HeejunMoon53/MultimodalSensor/Paper/figures/seminar_testplatform.png

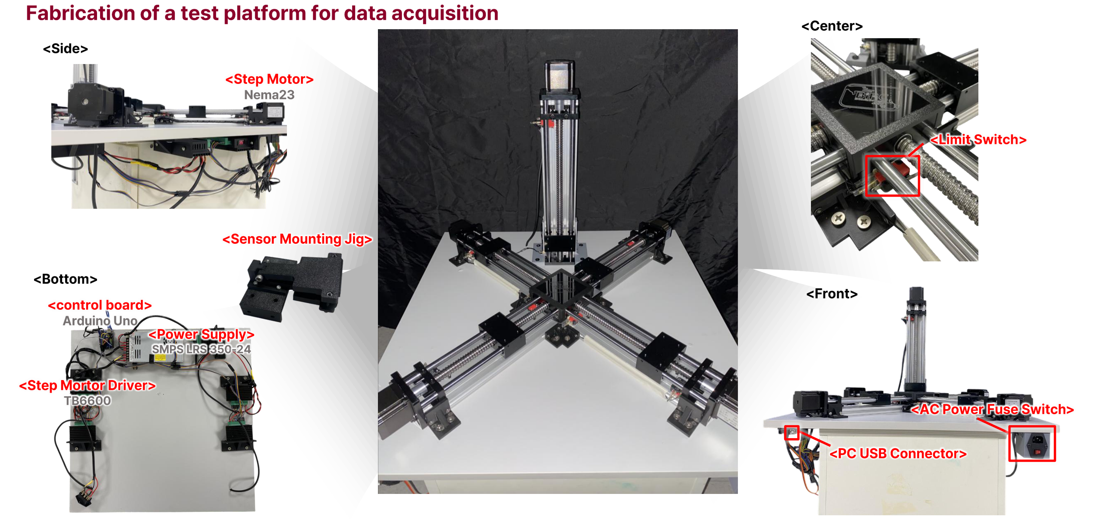
Paper/figures/seminar_testplatform.png
