HeejunMoon53/MultimodalSensor/Paper/figures/seminar_pcb.png

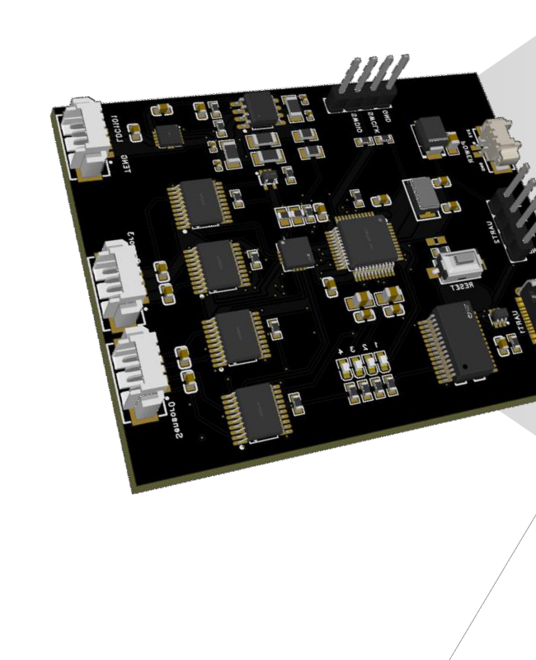
Paper/figures/seminar_pcb.png
