HeejunMoon53/MultimodalSensor/nn_decoupling/data_acquisition/dataset/training_report.html

# Training Report — Linear / Log-d / PINN / E2E

Generated: 2026-05-22 18:41 | Architecture: MLP (128-128-64) | 2-Stage Decoupled + End-to-End

## 종합 요약 (Test set MAE)

1.783 mm

Proximity MAE — Linear

1.751 mm

Proximity MAE — Log-d

1.787 mm

Proximity MAE — PINN

1.790 mm

Proximity MAE — E2E (2in→2out)

0.343 %

Strain MAE — Linear

0.343 %

Strain MAE — Log-d

0.347 %

Strain MAE — PINN

0.334 %

Strain MAE — E2E (2in→2out)

## Part 1 — Linear vs Log-scale d (sklearn MLP)

Linear: Stage 2 타겟 = d_act_mm. StandardScaler 정규화.

Log-d: Stage 2 타겟 = log1p(d_act_mm). 추론 시 expm1() 역변환. L-d 결합이 물리적으로 1/d^k 형태이므로 log 공간에서 더 선형에 가깝고, 가까운 거리(0-10mm)에 더 높은 표현력을 부여.

## 1-1. 구조 비교

항목 | Linear | Log-d
Stage 2 타겟 | d_act_mm | log1p(d_act_mm)
역변환 | inverse_transform | inverse_transform + expm1
Stage 1 | 동일 (dR -> eps)
Stage 1 iters | 85 | 85
Stage 2 iters | 151 | 101

## 1-2. Loss Curves

loss_lg

## 1-3. 성능 비교

빨간 = log-d가 더 나쁨 / 초록 = 더 좋음. 괄호 = linear 대비 차이.

### Test set

지표 | linear | log-d (차이) | 우세
Strain MAE [%] | 0.3435 | 0.3435 (0.0000) | -
Strain RMSE [%] | 0.4319 | 0.4319 (0.0000) | -
Strain R2 | 0.9974 | 0.9974 (0.0000) | -
Proximity MAE [mm] | 1.7830 | 1.7511 (-0.0319) | log-d
Proximity RMSE [mm] | 2.7715 | 2.7824 (+0.0109) | linear
Proximity R2 | 0.9298 | 0.9292 (-0.0006) | linear
Proximity MaxErr [mm] | 13.4586 | 13.8294 (+0.3708) | linear

### Val set

지표 | linear | log-d (차이) | 우세
Strain MAE [%] | 0.3363 | 0.3363 (0.0000) | -
Strain RMSE [%] | 0.4230 | 0.4230 (0.0000) | -
Strain R2 | 0.9976 | 0.9976 (0.0000) | -
Proximity MAE [mm] | 1.7800 | 1.7618 (-0.0182) | log-d
Proximity RMSE [mm] | 2.7770 | 2.8043 (+0.0273) | linear
Proximity R2 | 0.9297 | 0.9284 (-0.0014) | linear
Proximity MaxErr [mm] | 19.5442 | 20.3745 (+0.8302) | linear

### Train set

지표 | linear | log-d (차이) | 우세
Strain MAE [%] | 0.3373 | 0.3373 (0.0000) | -
Strain RMSE [%] | 0.4253 | 0.4253 (0.0000) | -
Strain R2 | 0.9976 | 0.9976 (0.0000) | -
Proximity MAE [mm] | 1.7805 | 1.7601 (-0.0205) | log-d
Proximity RMSE [mm] | 2.7975 | 2.8219 (+0.0244) | linear
Proximity R2 | 0.9287 | 0.9275 (-0.0013) | linear
Proximity MaxErr [mm] | 21.6852 | 21.6616 (-0.0236) | log-d

## 1-4. Proximity Pred vs True

pred_d_lg

## 1-5. 거리 구간별 MAE 비교

6mm 간격 bin 기준. 먼 거리(24-36mm)에서 log-d 효과 확인.

bar_lg

## 1-6. Proximity Residuals

점 색상 = 실제 거리. 먼 거리(빨간 점)의 잔차 패턴 비교.

resid_lg

## 1-7. eps x d 공간 MAE 히트맵

같은 행은 동일 컬러 스케일.

heatmap_lg

## Part 2 — MLP vs PINN (Physics-Informed)

MLP (Linear, Baseline): sklearn MLPRegressor. Data loss(MSE)만으로 학습.

PINN: NumPy + Adam 직접 구현. Data loss + Physics loss 동시 최적화.
Loss = MSE_data + 0.1 * MSE_physics

## 2-1. 물리 제약 (Physics Constraints)

Stage | 물리 모델 | 역할
Stage 1 dR → eps | dR = α₁⋅eps + α₂⋅eps² | 예측된 eps가 저항 변화 물리 모델과 일치하도록 강제
Stage 2 (dL, eps_hat) → d | dL = β₁⋅eps + β₂⋅exp(-k⋅d) | 예측된 d가 인덕턴스-근접도 물리 모델과 일치하도록 강제 (지수 감쇠: gradient bounded, 수치적으로 안정)

## 2-2. 물리 모델 피팅 결과

α₁ (R linear)

0.5676

α₂ (R quadratic)

0.002113

R model R²

0.9974

β₁ (L-eps)

0.6504

β₂ (L-d amplitude)

-27.2386

k (decay rate)

0.2287 mm⁻¹

L model R²

0.9930

PINN lambda

0.1

Stage 1/2 iters (PINN)

138 / 244

phys_fit

## 2-3. Loss Curves

loss_mp

## 2-4. 성능 비교

빨간 = PINN이 더 나쁨 / 초록 = PINN이 더 좋음. 괄호 = MLP 대비 차이.

### Test set

지표 | MLP | PINN (차이) | 우세
Strain MAE [%] | 0.3435 | 0.3470 (+0.0036) | MLP
Strain RMSE [%] | 0.4319 | 0.4341 (+0.0022) | MLP
Strain R2 | 0.9974 | 0.9974 (-0.0000) | -
Proximity MAE [mm] | 1.7830 | 1.7865 (+0.0035) | MLP
Proximity RMSE [mm] | 2.7715 | 2.7662 (-0.0054) | PINN
Proximity R2 | 0.9298 | 0.9301 (+0.0003) | PINN
Proximity MaxErr [mm] | 13.4586 | 14.0361 (+0.5775) | MLP

### Val set

지표 | MLP | PINN (차이) | 우세
Strain MAE [%] | 0.3363 | 0.3406 (+0.0043) | MLP
Strain RMSE [%] | 0.4230 | 0.4262 (+0.0033) | MLP
Strain R2 | 0.9976 | 0.9976 (-0.0000) | -
Proximity MAE [mm] | 1.7800 | 1.7819 (+0.0019) | MLP
Proximity RMSE [mm] | 2.7770 | 2.7670 (-0.0099) | PINN
Proximity R2 | 0.9297 | 0.9302 (+0.0005) | PINN
Proximity MaxErr [mm] | 19.5442 | 19.8687 (+0.3244) | MLP

### Train set

지표 | MLP | PINN (차이) | 우세
Strain MAE [%] | 0.3373 | 0.3406 (+0.0033) | MLP
Strain RMSE [%] | 0.4253 | 0.4274 (+0.0021) | MLP
Strain R2 | 0.9976 | 0.9975 (-0.0000) | -
Proximity MAE [mm] | 1.7805 | 1.7802 (-0.0003) | PINN
Proximity RMSE [mm] | 2.7975 | 2.7867 (-0.0107) | PINN
Proximity R2 | 0.9287 | 0.9293 (+0.0005) | PINN
Proximity MaxErr [mm] | 21.6852 | 21.7007 (+0.0155) | MLP

## 2-5. Pred vs True

pred_mp

## 2-6. 거리 구간별 MAE 비교

6mm bin 기준. 먼 거리(24-36mm)에서 PINN 물리 제약 효과 확인.

bar_mp

## 2-7. Proximity Residuals

resid_mp

## 2-8. eps x d 공간 MAE 히트맵

같은 행은 동일 컬러 스케일. 물리 제약이 어느 구간에서 효과적인지 확인.

heatmap_mp

## Part 3 — 2-Stage MLP vs End-to-End (2in→2out, Stage1 only)

2-Stage MLP (Baseline): Stage1: dR→eps (1in→1out), Stage2: (dL, eps_hat)→d (2in→1out).
물리적 인과관계(dR은 eps에만 지배적)를 반영한 직렬 디커플링 구조.

End-to-End (2in→2out): 단일 MLP로 (dL, dR) → (eps, d) 동시 예측.
Stage2 없이 Stage1만으로 두 출력 동시 학습. 구조 단순, 물리 계층 없음.

## 3-1. 구조 비교

항목 | 2-Stage MLP | End-to-End (2in→2out)
입력 | Stage1: [dR] / Stage2: [dL, eps_hat] | [dL, dR]
출력 | Stage1: eps / Stage2: d (순차) | (eps, d) 동시 출력
모델 수 | 2개 (직렬) | 1개
물리 계층 | 있음 (dR→eps 우선) | 없음 (end-to-end)
학습 iters | 85 / 151 | 73

## 3-2. 성능 비교

빨간 = E2E가 더 나쁨 / 초록 = E2E가 더 좋음. 괄호 = 2-Stage 대비 차이.

### Test set

지표 | 2-Stage | E2E (차이) | 우세
Strain MAE [%] | 0.3435 | 0.3340 (-0.0095) | E2E
Strain RMSE [%] | 0.4319 | 0.4240 (-0.0079) | E2E
Strain R2 | 0.9974 | 0.9975 (+0.0001) | -
Proximity MAE [mm] | 1.7830 | 1.7900 (+0.0070) | 2-Stage
Proximity RMSE [mm] | 2.7715 | 2.7938 (+0.0222) | 2-Stage
Proximity R2 | 0.9298 | 0.9287 (-0.0011) | 2-Stage
Proximity MaxErr [mm] | 13.4586 | 13.6385 (+0.1799) | 2-Stage

### Val set

지표 | 2-Stage | E2E (차이) | 우세
Strain MAE [%] | 0.3363 | 0.3261 (-0.0102) | E2E
Strain RMSE [%] | 0.4230 | 0.4137 (-0.0093) | E2E
Strain R2 | 0.9976 | 0.9977 (+0.0001) | E2E
Proximity MAE [mm] | 1.7800 | 1.7794 (-0.0006) | E2E
Proximity RMSE [mm] | 2.7770 | 2.7856 (+0.0086) | 2-Stage
Proximity R2 | 0.9297 | 0.9293 (-0.0004) | 2-Stage
Proximity MaxErr [mm] | 19.5442 | 19.0618 (-0.4824) | E2E

### Train set

지표 | 2-Stage | E2E (차이) | 우세
Strain MAE [%] | 0.3373 | 0.3253 (-0.0120) | E2E
Strain RMSE [%] | 0.4253 | 0.4144 (-0.0109) | E2E
Strain R2 | 0.9976 | 0.9977 (+0.0001) | E2E
Proximity MAE [mm] | 1.7805 | 1.7847 (+0.0041) | 2-Stage
Proximity RMSE [mm] | 2.7975 | 2.8127 (+0.0153) | 2-Stage
Proximity R2 | 0.9287 | 0.9279 (-0.0008) | 2-Stage
Proximity MaxErr [mm] | 21.6852 | 21.7474 (+0.0622) | 2-Stage

## 3-3. Pred vs True

pred_e2e

## 3-4. 거리 구간별 MAE

6mm bin 기준. 디커플링 구조 유무에 따른 근접도 구간별 오차 차이 확인.

bar_e2e

## 3-5. eps × d 공간 MAE 히트맵

같은 행은 동일 컬러 스케일. 2-Stage와 E2E의 오차 분포 패턴 비교.

heatmap_e2e
