HeejunMoon53/MultimodalSensor/Paper/26.09.18_세미나_아웃라인.pdf

HeeJun Moon

# Embedded AI-Driven Single-Electrode Soft Multimodal Sensor for Proprioception, Tactile, and Proximity Sensing

구조

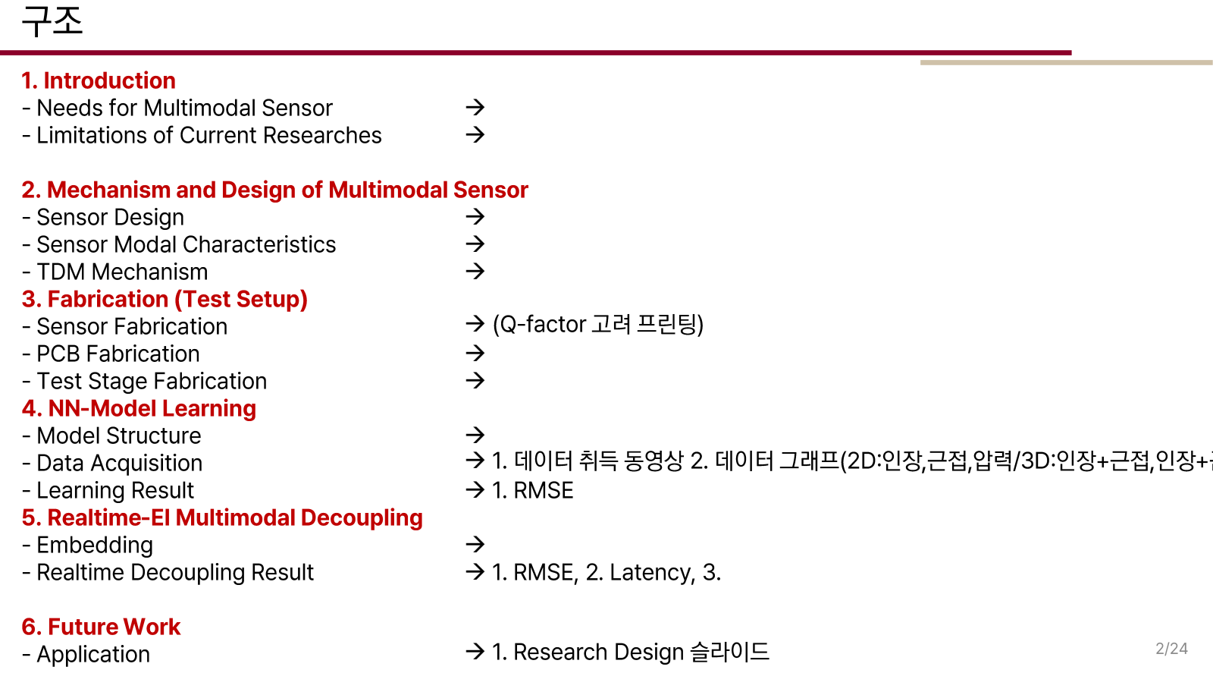
[picture p15: page 2]

2/24

1. Introduction
-Needs for Multimodal Sensor
-Limitations of Current Researches
2. Mechanism and Design of Multimodal Sensor -Sensor Design
-Sensor Modal Characteristics
-TDM Mechanism
3. Fabrication (Test Setup) -Sensor Fabrication
-PCB Fabrication
-Test Stage Fabrication
4. NN-Model Learning
-Model Structure
-Data Acquisition
-Learning Result
5. Realtime-EI Multimodal Decoupling -Embedding
-Realtime Decoupling Result
6. Future Work
-Application

→
→

→
→
→

→ (Q-factor 고려프린팅)

→
→

→
→ 1. 데이터취득동영상2. 데이터그래프(2D:인장,근접,압력/3D:인장+근접,인장+근접+압력) → 1. RMSE

→
→ 1. RMSE, 2. Latency, 3.

→ 1. Research Design 슬라이드

구조

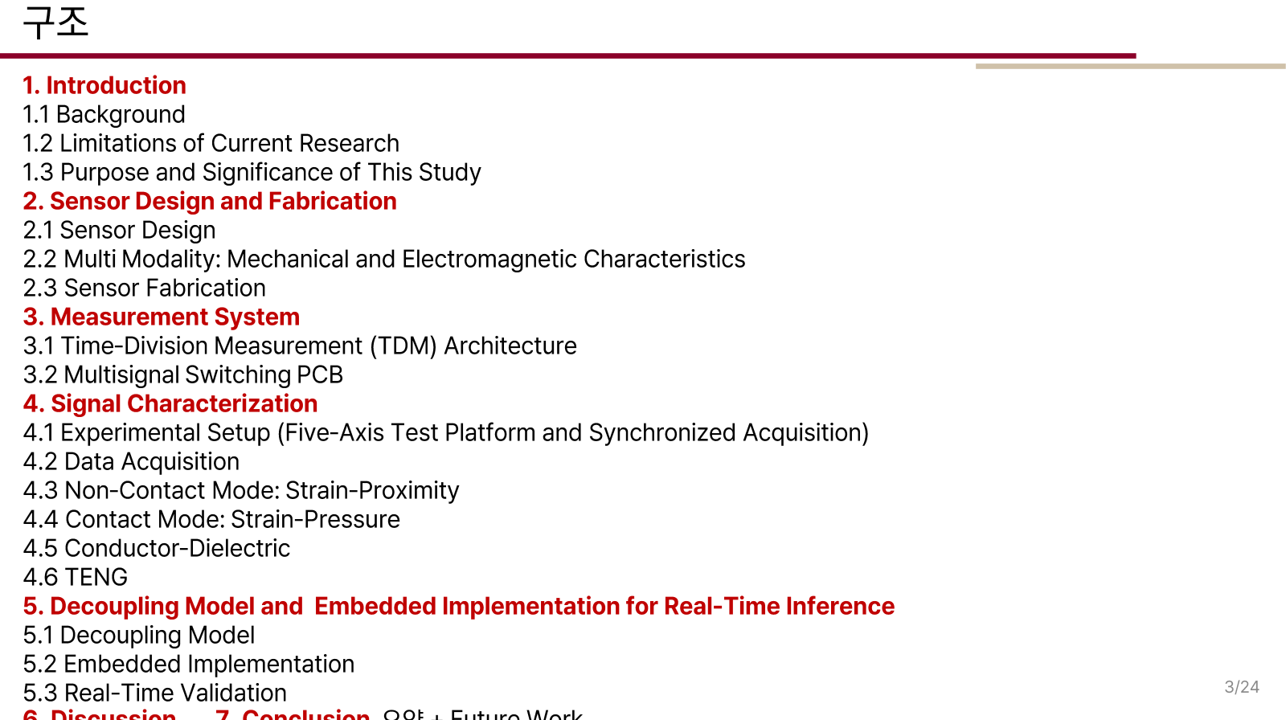
[picture p16: page 3]

3/24

1. Introduction
1.1 Background
1.2 Limitations of Current Research
1.3 Purpose and Significance of This Study
2. Sensor Design and Fabrication
2.1 Sensor Design
2.2 Multi Modality: Mechanical and Electromagnetic Characteristics 2.3 Sensor Fabrication
3. Measurement System
3.1 Time-Division Measurement (TDM) Architecture
3.2 MultisignalSwitching PCB
4. Signal Characterization
4.1Experimental Setup (Five-Axis Test Platform and Synchronized Acquisition) 4.2 Data Acquisition
4.3 Non-Contact Mode: Strain-Proximity
4.4 Contact Mode: Strain-Pressure
4.5 Conductor-Dielectric
4.6 TENG
5. Decoupling Model and Embedded Implementation for Real-Time Inference 5.1 Decoupling Model
5.2 Embedded Implementation
5.3 Real-Time Validation
6. Discussion 7. Conclusion 요약+ Future Work

## I. Introduction

1.1 Background

HMI, Soft Robot

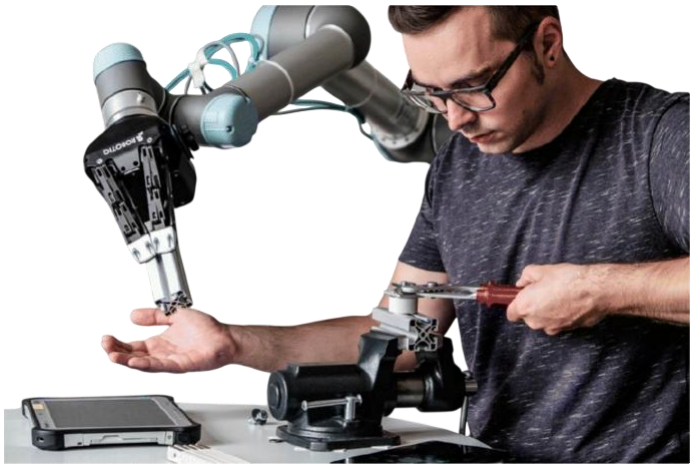
[picture p17: figure]

## I. Introduction

1.1 Background

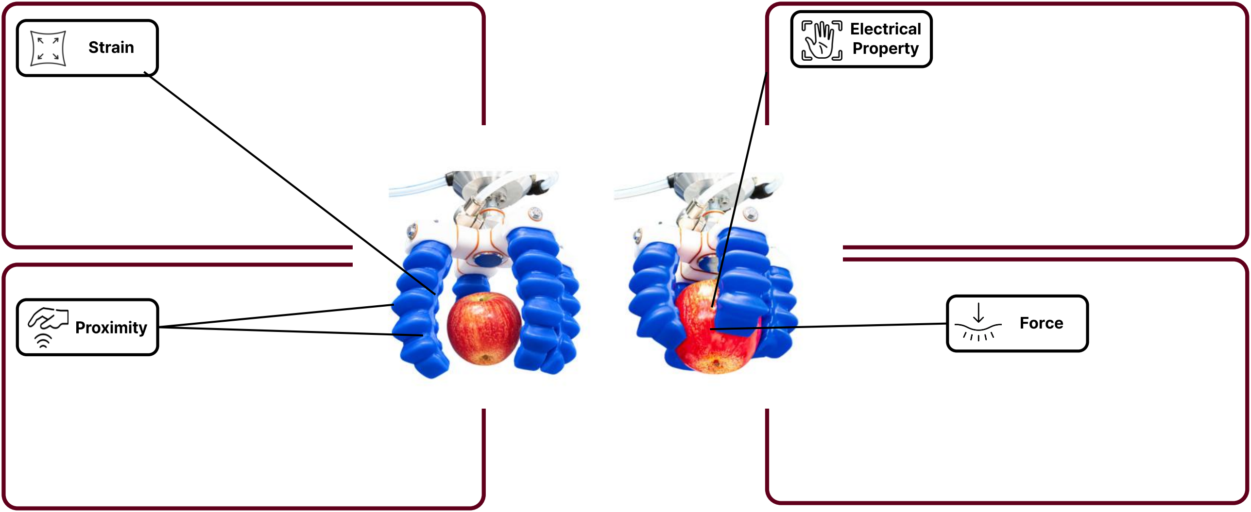
[picture p18: figure]
Proximity; Strain; Electrical Property; Force

## I. Introduction

[5] "Multimodal sensors with decoupled sensing mechanisms." Advanced Science 9.26(2022)

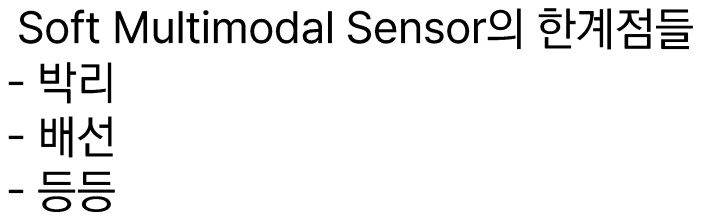
[picture p19: figure]
Soft Multimodal Sensor의한계점들 -박리 -배선 -등등

## I. Introduction

[5] "Multimodal sensors with decoupled sensing mechanisms." Advanced Science 9.26 (2022)

## I. Introduction

1.3This Work

Frame Work Onboard TDM
+ EI

## I. Introduction

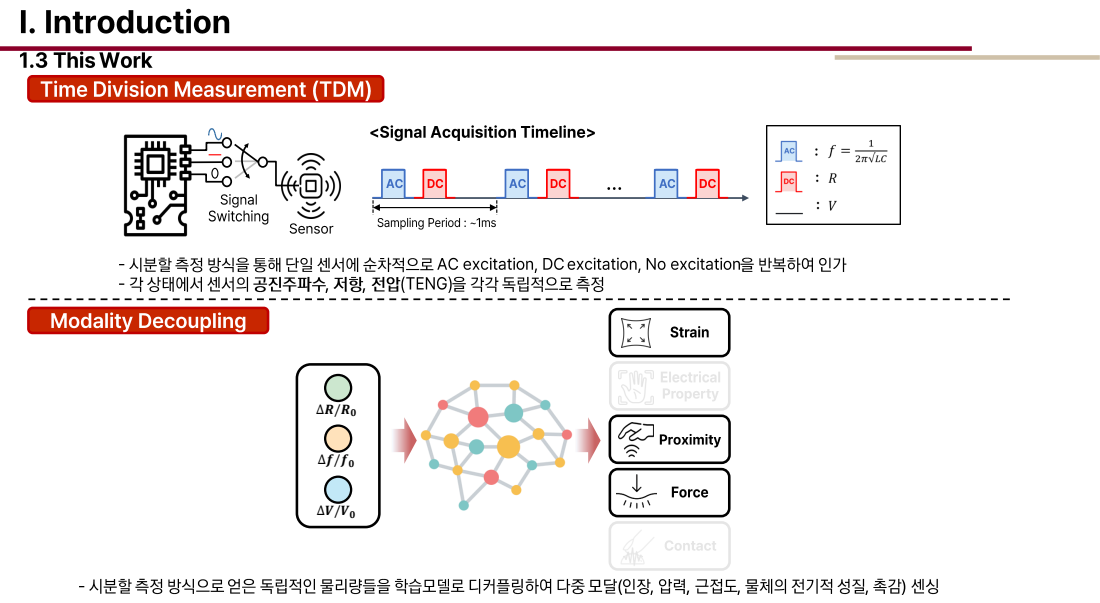
[picture p20: page 10]
Sampling Period : ~1ms; Sensor; Signal Switching; Modality Decoupling; Proximity; Strain; Electrical Property; Contact; Force

1.3 This Work
Time Division Measurement (TDM)

<Signal Acquisition Timeline>

-시분할측정방식을통해단일센서에순차적으로AC excitation, DCexcitation, No excitation을반복하여인가
-각상태에서센서의공진주파수, 저항, 전압(TENG)을각각독립적으로측정

-시분할측정방식으로얻은독립적인물리량들을학습모델로디커플링하여다중모달(인장, 압력, 근접도, 물체의전기적성질, 촉감) 센싱

## I. Introduction

1.3 This Work

Chapter2

Chapter3

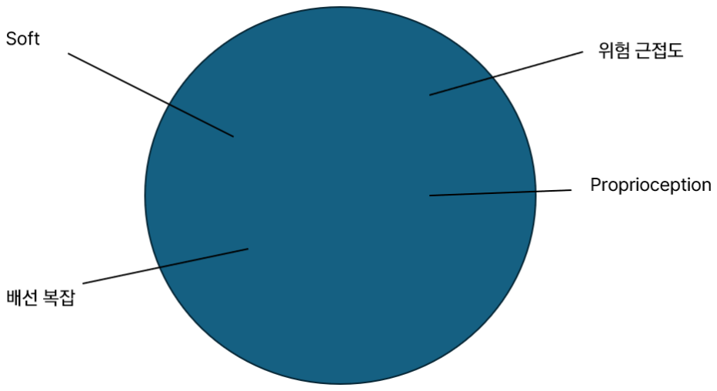
[picture p21: figure]

Chapter2

Chapter2

Chapter2

Chapter3

어떻게극복하는지?

2.1 Sensor Design

Flexible

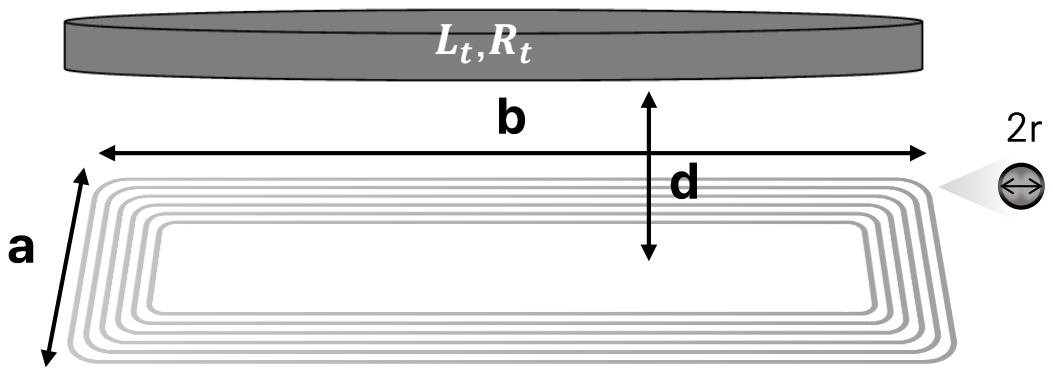
[picture p22: figure]
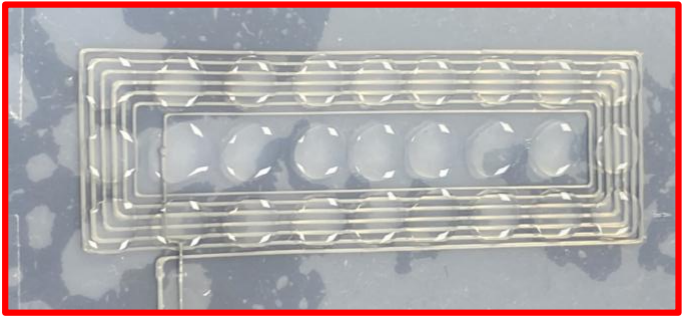
[picture p23: figure]

Stretchable

돌기구조효과 언급

ΔR/R0

100%

20N

F | F 210 N

ΔR/R0

100%

2.2 Mechanical and Electromagnetic Characteristics

2.2 Mechanical and Electromagnetic Characteristics

## II. Sensor Design and Fabrication

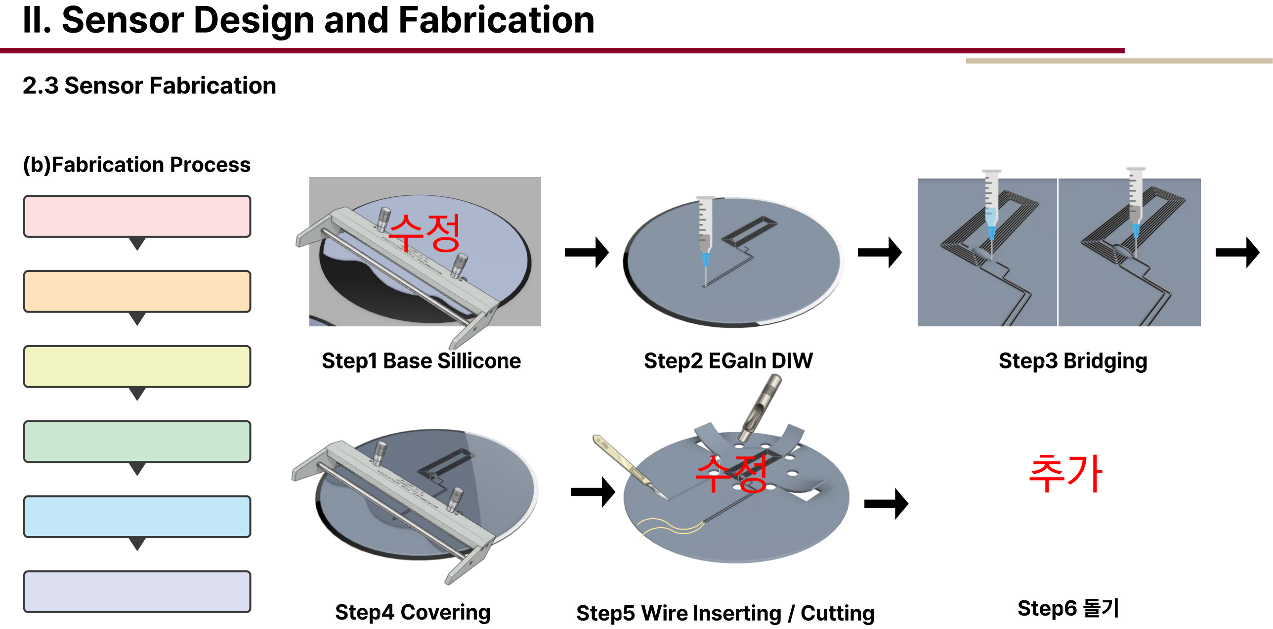
[picture p24: page 16]

2.3 Sensor Fabrication

Step2 EGaIn DIW | Step3 Bridging

Step4 Covering

Step1 Base Sillicone

Step5 Wire Inserting / Cutting | Step6 돌기
수정 | 추가

수정

(b)Fabrication Process

## III. Measurement System

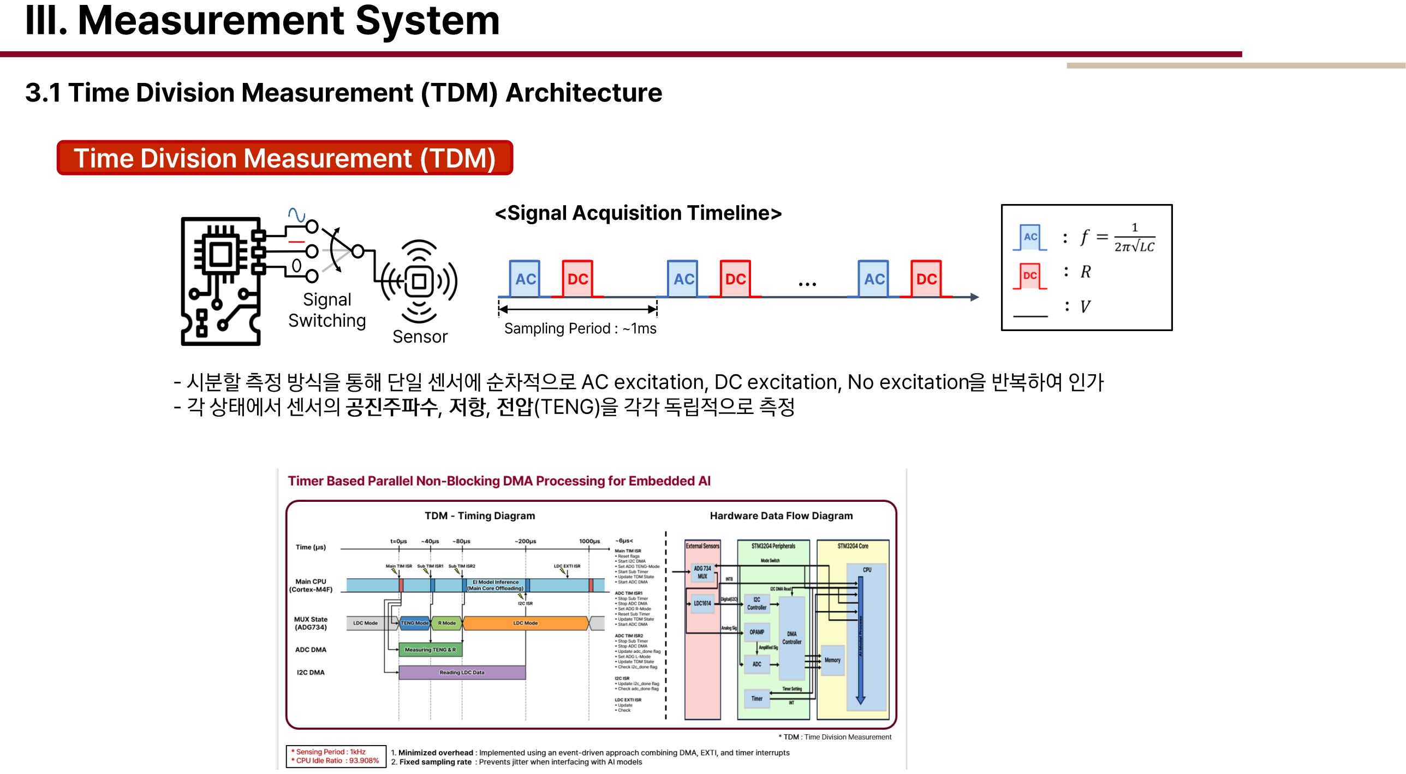
[picture p25: page 18]

3.1 Time Division Measurement (TDM) Architecture

AC DC

Sampling Period : ~1ms

AC | DC | …

Time Division Measurement (TDM)

Sensor

Signal
Switching

<Signal Acquisition Timeline>

AC DC

-시분할측정방식을통해단일센서에순차적으로AC excitation, DCexcitation, No excitation을반복하여인가 -각상태에서센서의공진주파수, 저항, 전압(TENG)을각각독립적으로측정

## III. Measurement System

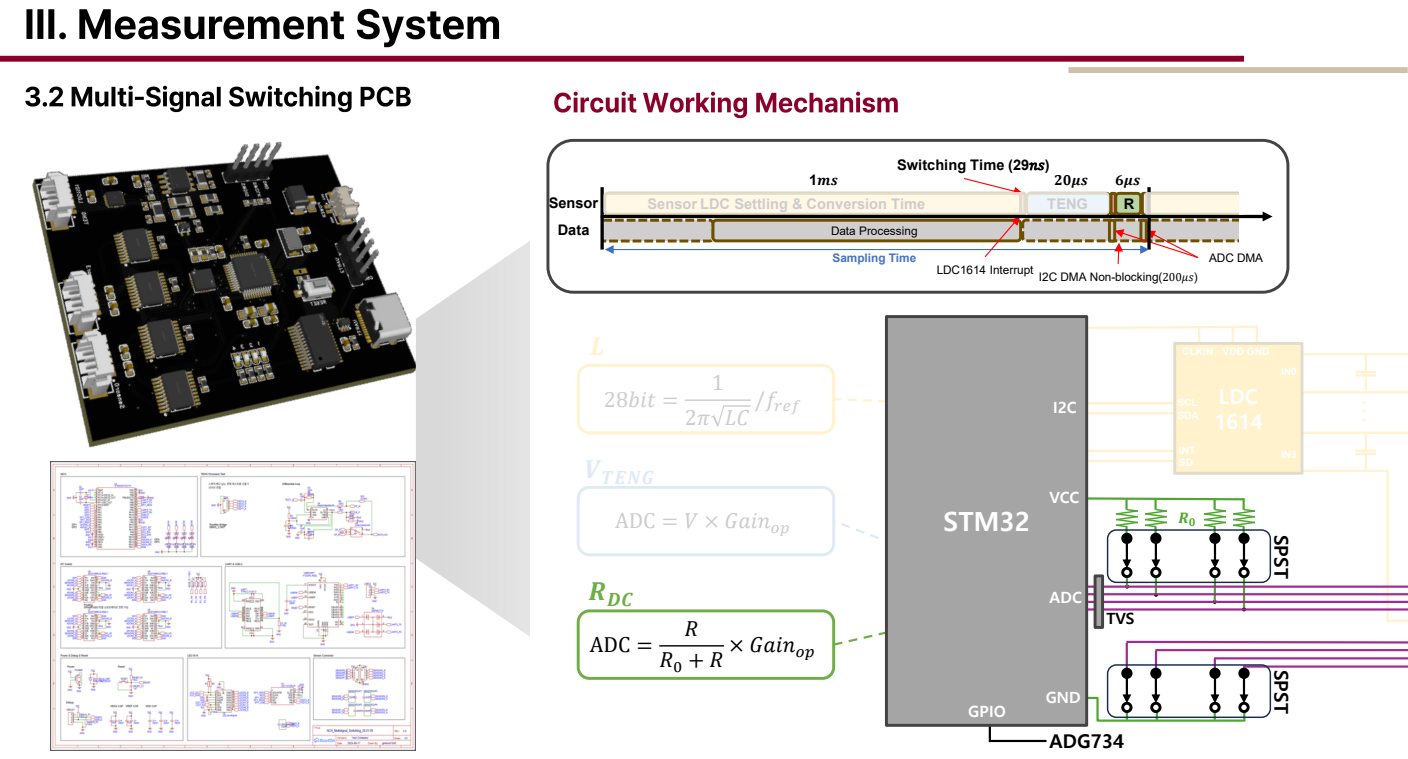
[picture p26: page 19]
RDC; ADC =; × Gainop; VTENG; ADC = V × Gainop; TVS; 28bit =; /fref; LDC; SCL SDA; INT SD; SPST; STM32; ADC; VCC; GND; GPIO; ADG734; LDC1614 Interrupt; ADC DMA; LDC Settling & Conversion Time; TENG; Switching Time (29ns); Data Processing; Sampling Time; Sensor; Data; INT SD VTENG

3.2 Multi -Signal Switching PCB

Circuit Working Mechanism

I2C DMA Non-blocking(200μs)

CLKIN VDD GND

## IV. Signal Characterization

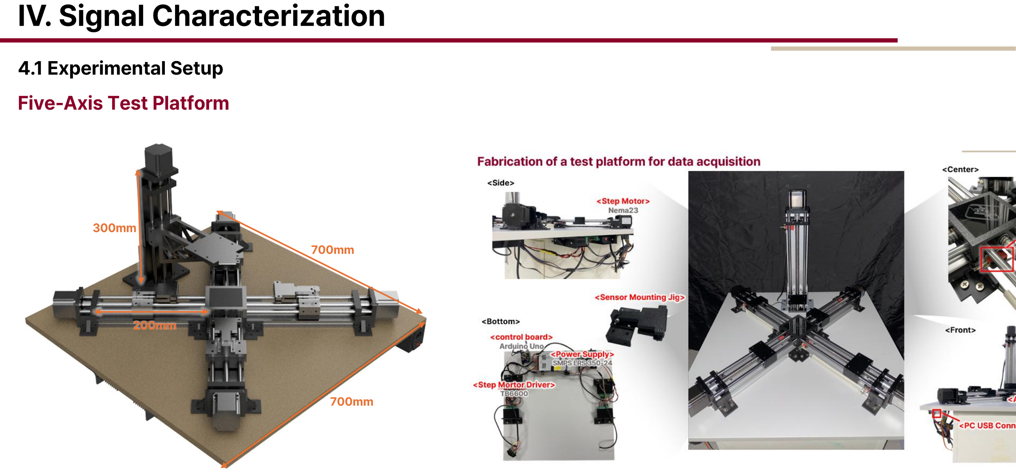
[picture p27: page 21]

4.1Experimental Setup

Five-Axis Test Platform

700mm

700mm

200mm

300mm

## IV. Signal Characterization

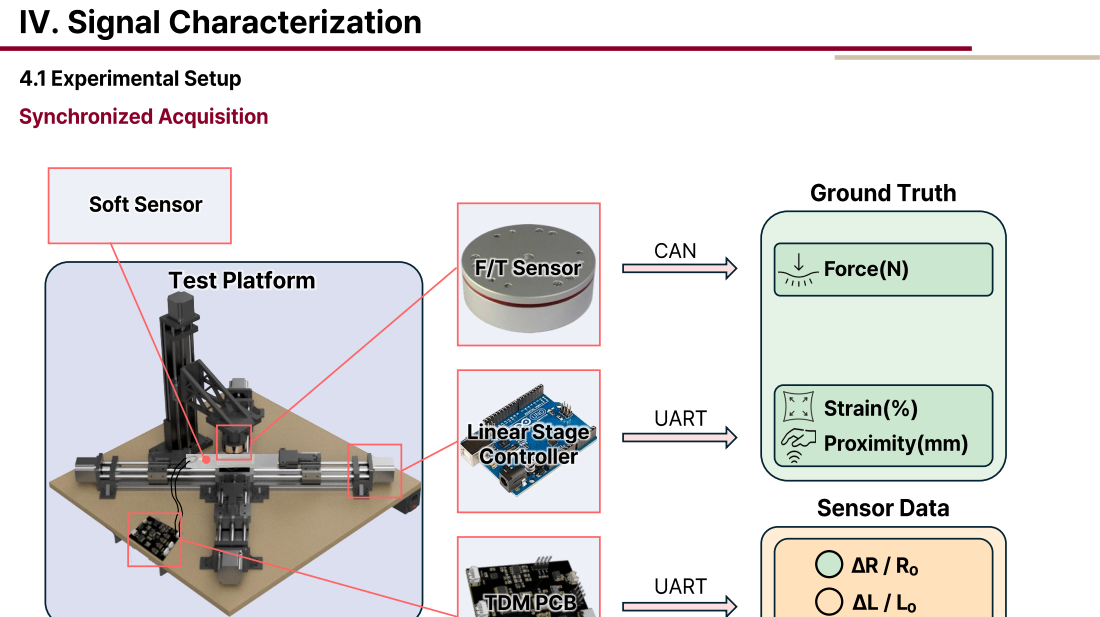
[picture p28: page 22]
4.1Experimental Setup; Synchronized Acquisition; Ground Truth; Sensor Data; TDM PCB; UART; Strain(%); Proximity(mm); Soft Sensor; Test Platform; Linear Stage Controller; F/T Sensor; CAN; Force(N)

## IV. Signal Characterization

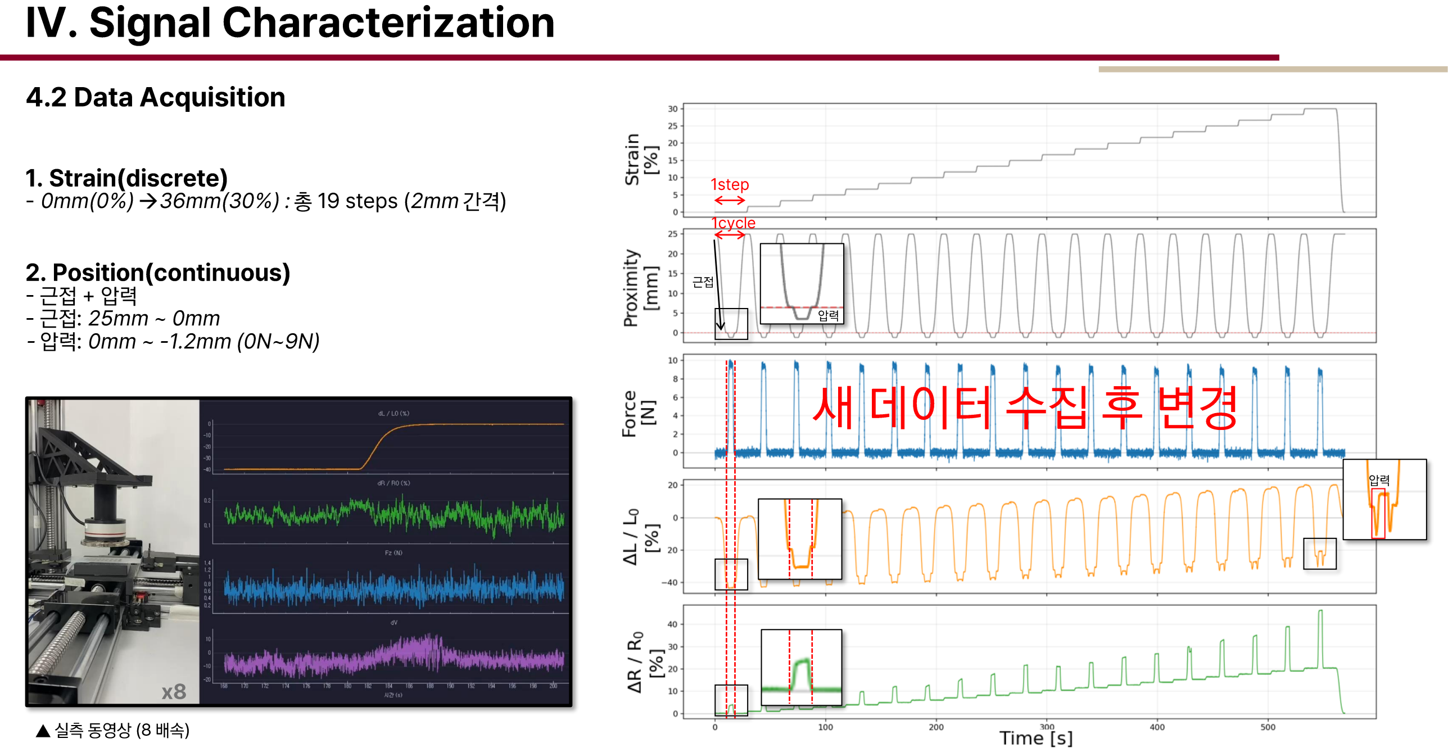
[picture p29: page 23]

4.2 Data Acquisition

1step

1cycle

근접

압력

압력

▲ 실측동영상(8 배속)

x8

1. Strain(discrete)
-0mm(0%) →36mm(30%) : 총19 steps (2mm 간격)
2. Position(continuous)
-근접+ 압력
-근접: 25mm ~ 0mm
-압력: 0mm ~ -1.2mm (0N~9N)

# 새데이터수집후변경

## IV. Signal Characterization

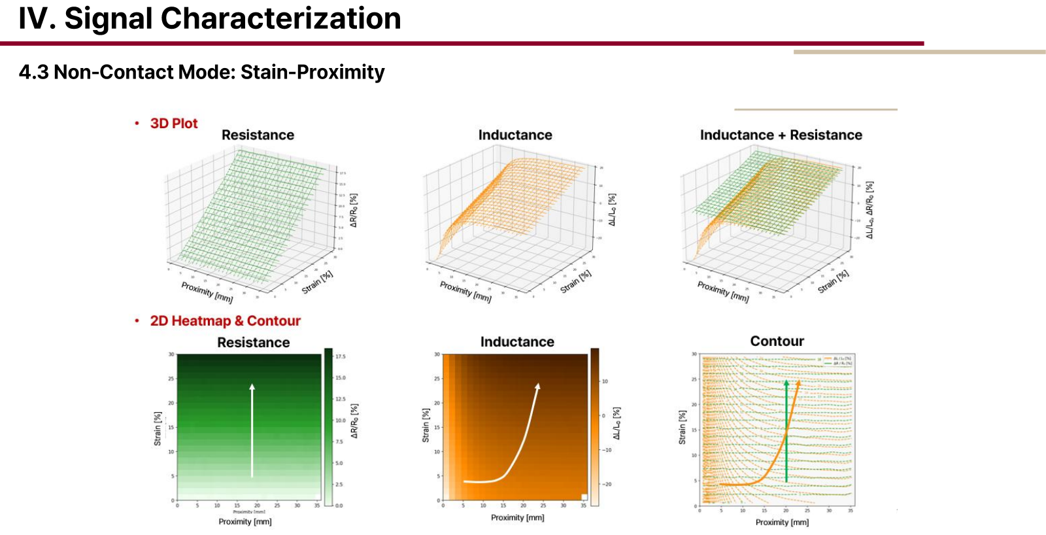
[picture p30: page 24]

4.3 Non-Contact Mode: Stain-Proximity

## IV. Signal Characterization

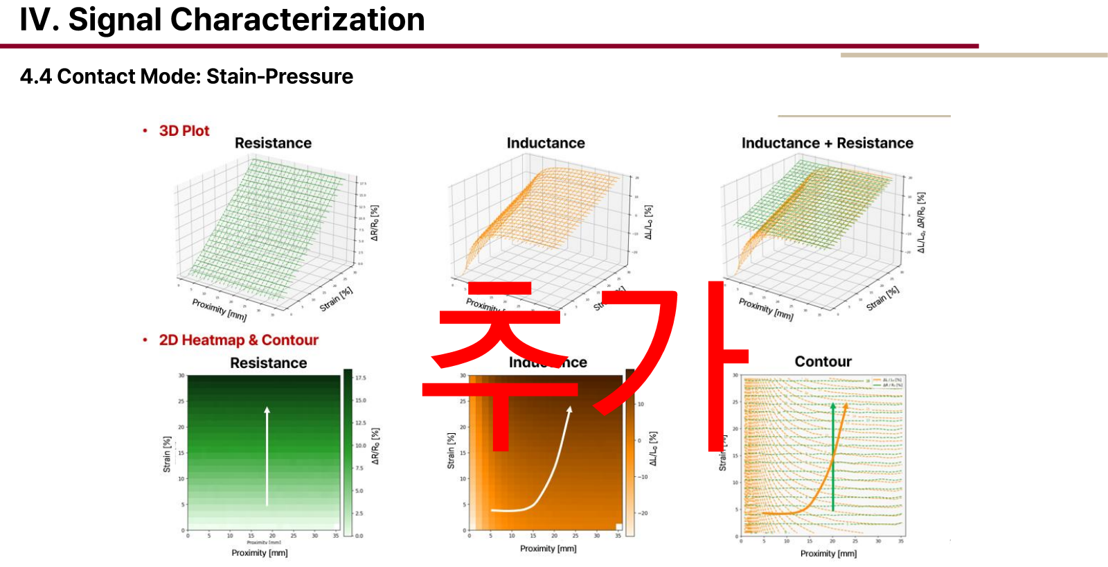
[picture p31: page 25]

4.4 Contact Mode: Stain-Pressure
추가

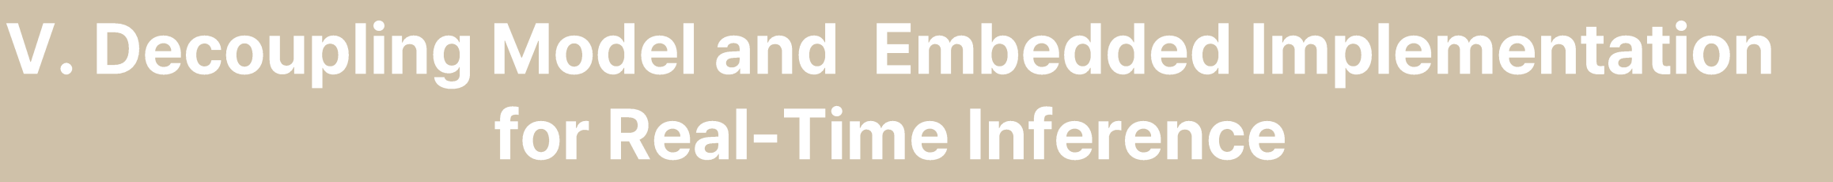
[picture p32: figure]
for Real-Time Inference

# V. Decoupling Model and Embedded Implementation

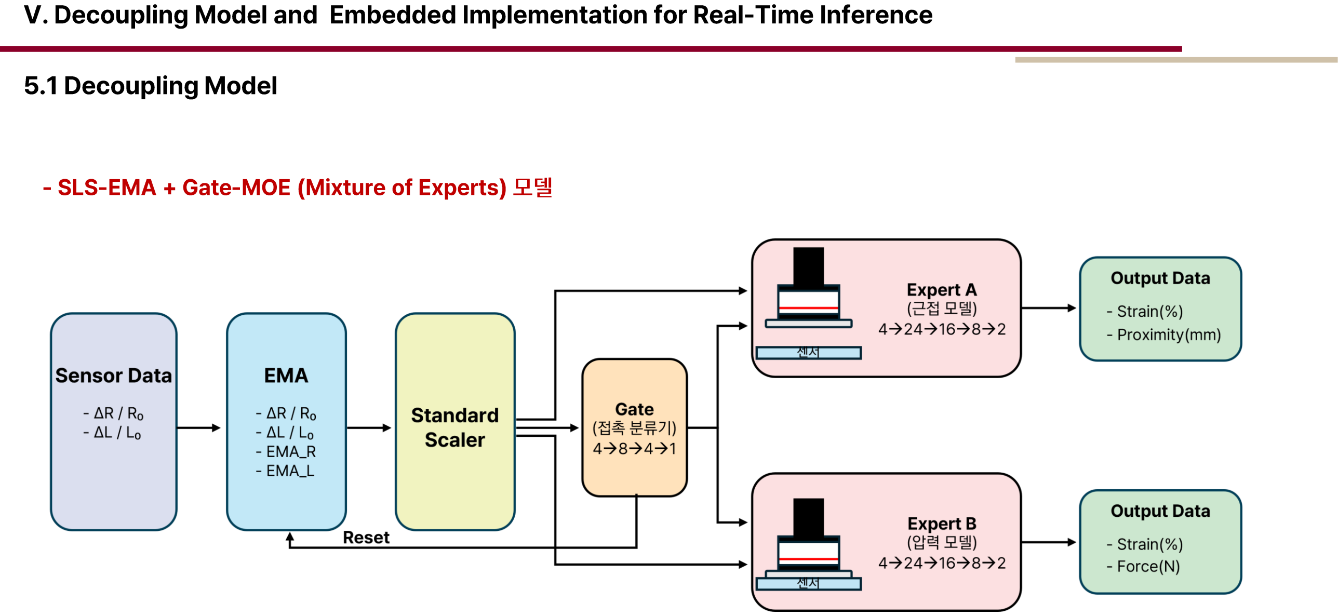
[picture p33: page 27]

V. Decoupling Model and Embedded Implementation for Real-Time Inference

5.1Decoupling Model

-SLS-EMA + Gate-MOE (Mixture of Experts) 모델

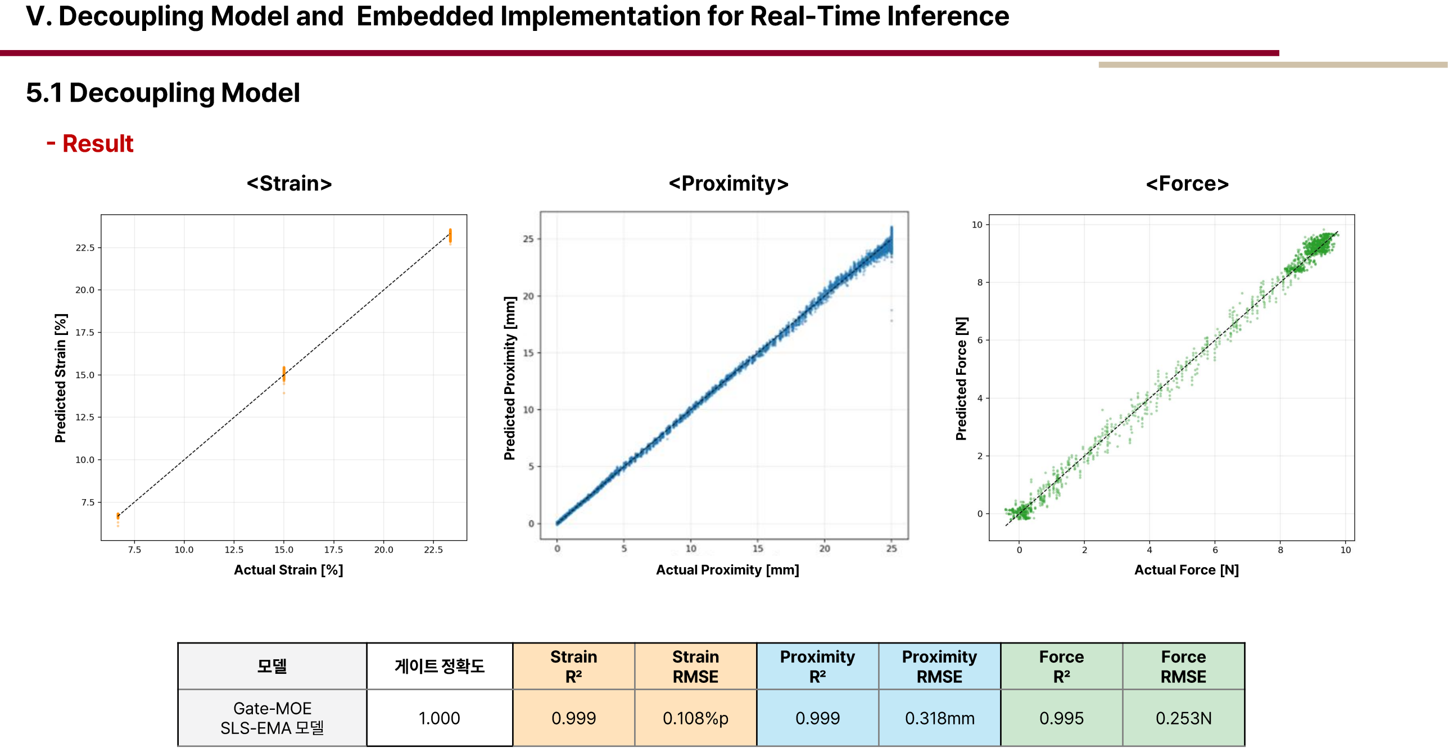
[picture p34: page 28]

V. Decoupling Model and Embedded Implementation for Real-Time Inference

5.1Decoupling Model

<Strain> | <Proximity> | <Force>

Actual Strain [%]

Predicted Strain [%]

Actual Proximity [mm]

Predicted Proximity [mm]

Actual Force [N]

Predicted Force [N]

모델 | 게이트 정확도 | Strain R | Strain RMSE | Proximity R | Proximity RMSE | Force R | Force RMSE
Gate-MOE SLS-EMA 모델 | 1.000 | 0.999 | 0.108%p | 0.999 | 0.318mm | 0.995 | 0.253N

-Result

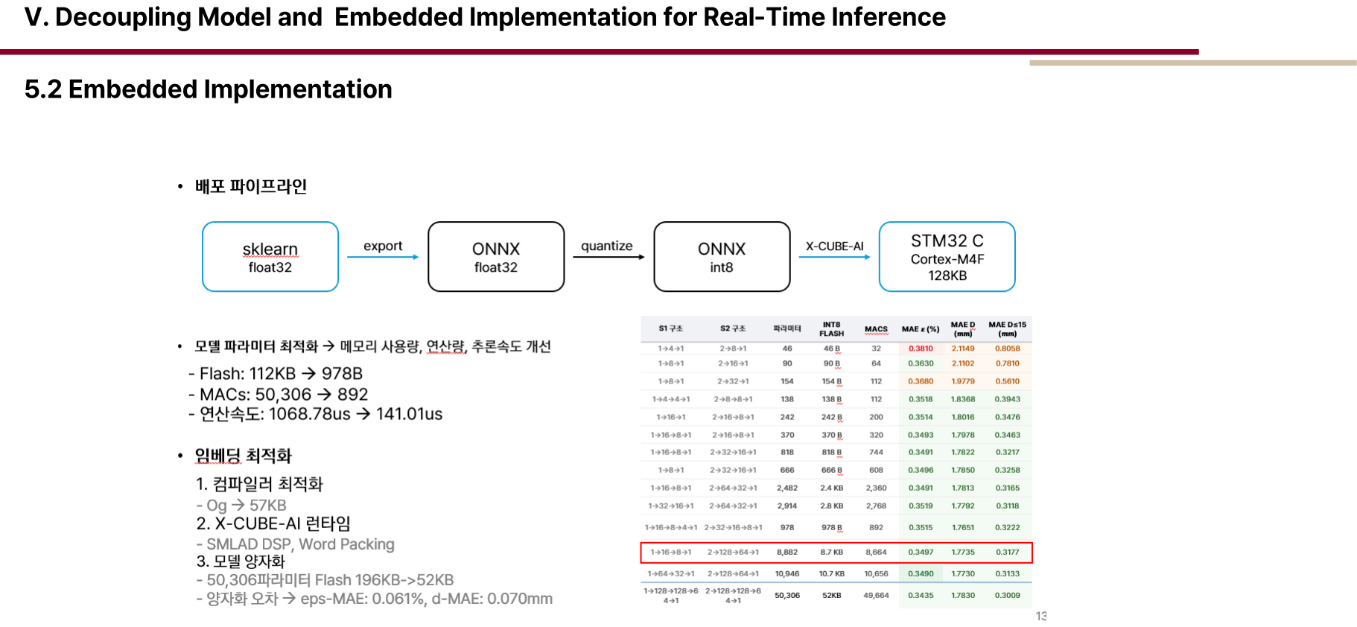
[picture p35: page 29]

V. Decoupling Model and Embedded Implementation for Real-Time Inference

5.2 Embedded Implementation

V. Decoupling Model and Embedded Implementation for Real-Time Inference

5.2 Embedded Implementation

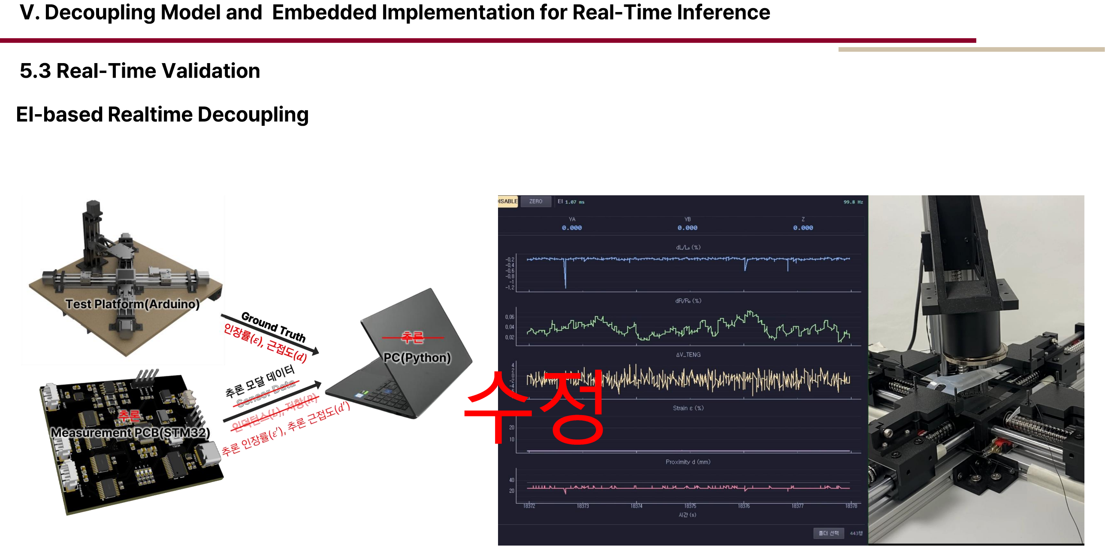
[picture p36: page 31]

V. Decoupling Model and Embedded Implementation for Real-Time Inference

5.3 Real-Time Validation

EI-based Realtime Decoupling

수정

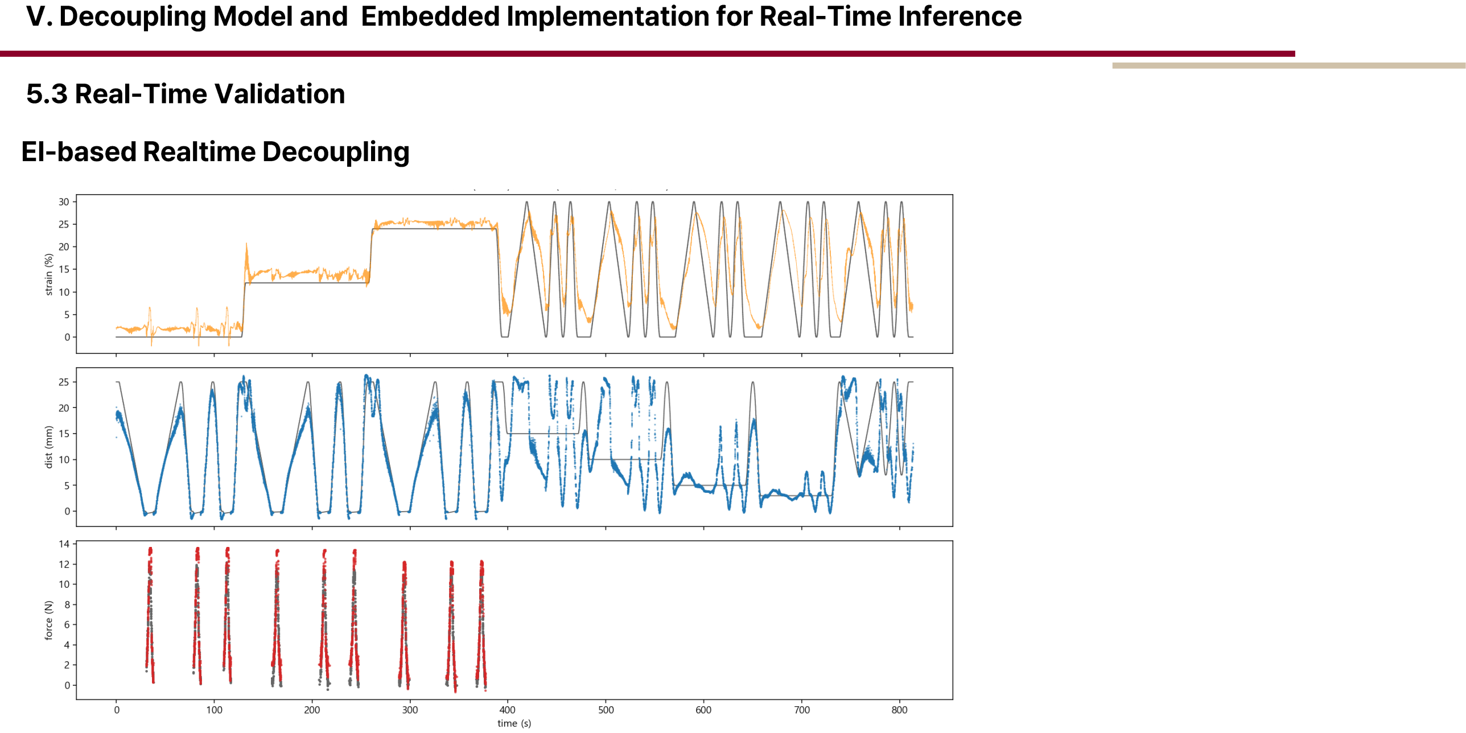
[picture p37: page 32]

V. Decoupling Model and Embedded Implementation for Real-Time Inference

5.3 Real-Time Validation

EI-based Realtime Decoupling

## VI. Conclusion

6.1Summary

## VI. Conclusion

6.2 Future Work

HeeJun Moon
