HeejunMoon53/MultimodalSensor/Paper/26.03.27_세미나_문희준.pdf

## HeeJun Moon

# Embedded AI-Driven Soft Multimodal Single-Electrode Sensor for Proximity, Tactile, and 2D-Strain Sensing

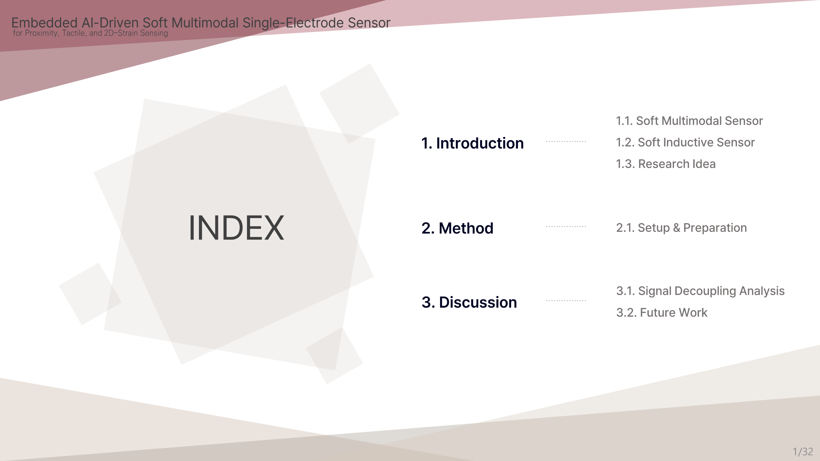
[picture p38: figure]
1. Introduction; 1.1. Soft Multimodal Sensor; 1.2. Soft Inductive Sensor; 1.3. Research Idea; INDEX; 2. Method; 2.1. Setup & Preparation; 3. Discussion; 3.1. Signal Decoupling Analysis; 3.2. Future Work

## Embedded AI-Driven Soft Multimodal Single-Electrode Sensor

for Proximity, Tactile, and 2D-Strain Sensing

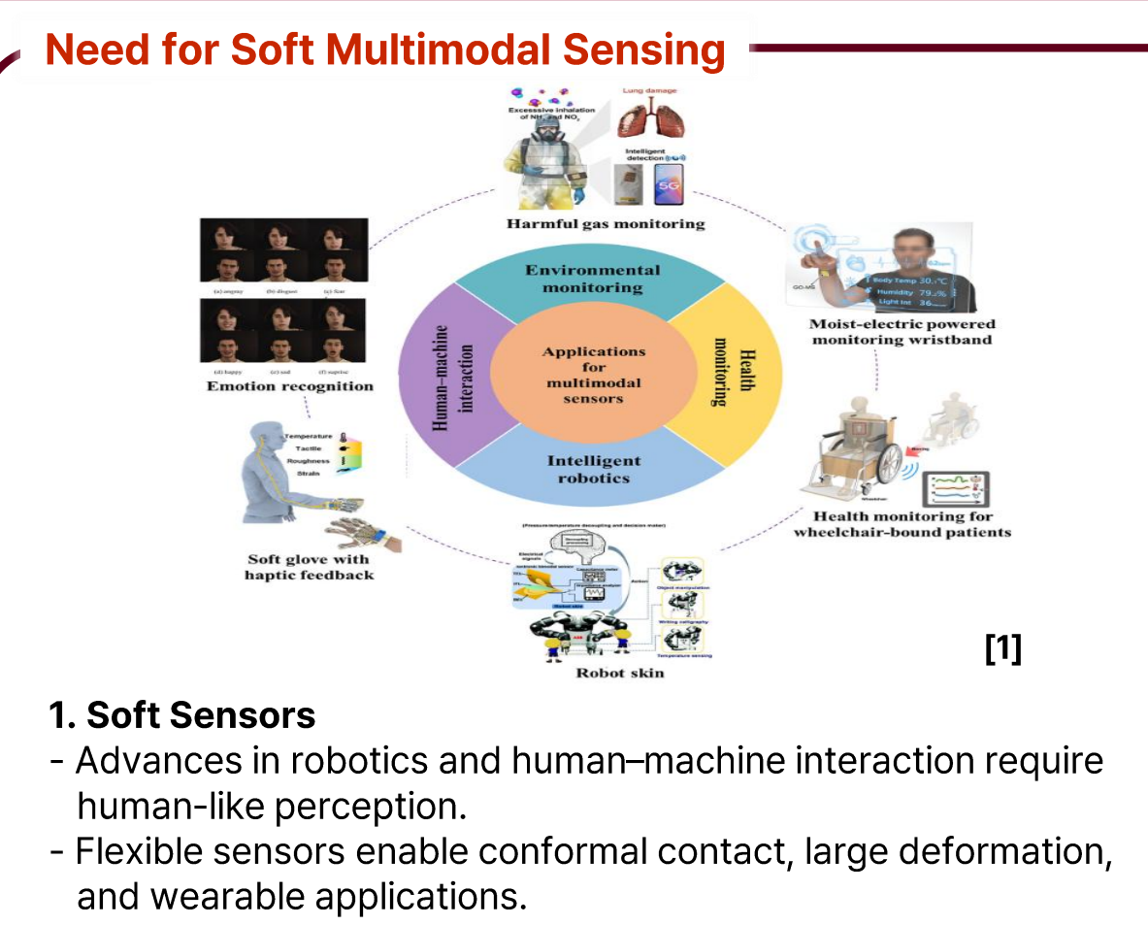
[picture p39: figure]
Need for Soft Multimodal Sensing; 1. Soft Sensors; human-like perception.; and wearable applications.
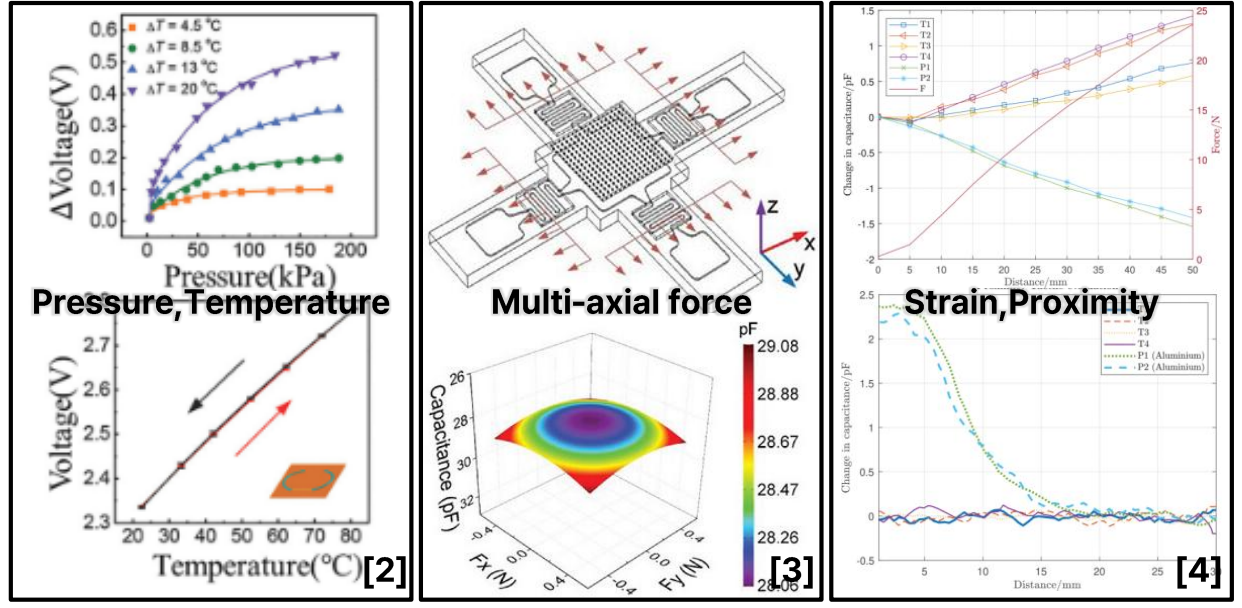
[picture p40: figure]
Pressure,Temperature; Multi -axial force; Strain,Proximity

-Advances in robotics and human–machine interaction require

-Flexible sensors enable conformal contact, large deformation,

-Unimodal sensors detect only one physical parameter, limiting

-Real interactions involve multiple stimuli simultaneously.

[1] "Recent Progress on Flexible Multimodal Sensors: Decoupling Strategies, Fabrication and Applications." Advanced Material s (2026)
[2] "Electronic Skin with Multifunction Sensors Based on Thermosensation." Advanced Materials (2017)
[3] "Highly sensitive linear triaxial force sensor based on multimodal sensing for 3D pose reconstruction." Small Methods (20 25)
[4] "Highly stretchable additively manufactured capacitive proximity and tactile sensors for soft robotic systems." IEEE Tran sactions on Instrumentation and Measurement (2023)

## Fundamental Challenge

## Signal Coupling

Different physical stimuli generate overlapping electrical responses.

[2] Pressure vs. Temperature → Resistance drift
[3] Multi-axis forces → Overlapping signal components
[4] Strain vs. Proximity → Capacitance change

## Fundamental Challenge

## Signal Coupling

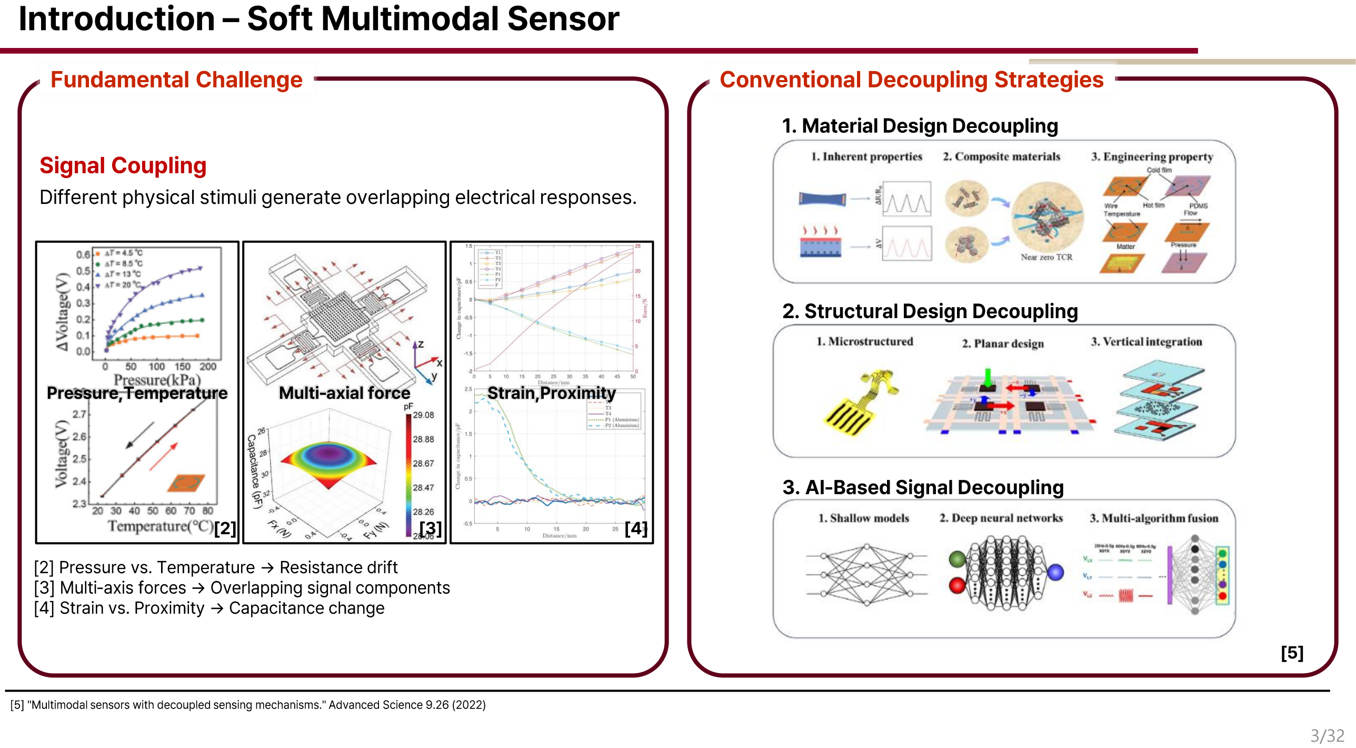
[picture p41: page 4]

Different physical stimuli generate overlapping electrical responses.

Pressure,Temperature

[2]

Multi -axial force

[3]

Strain,Proximity

[4]

[2] Pressure vs. Temperature → Resistance drift
[3] Multi-axis forces → Overlapping signal components
[4] Strain vs. Proximity → Capacitance change
[5] "Multimodal sensors with decoupled sensing mechanisms." Advanced Science 9.26 (2022)

# Introduction – Soft Multimodal Sensor

1. Material Design Decoupling
2. Structural Design Decoupling
3. AI-Based Signal Decoupling

[5]

## Conventional Decoupling Strategies

# Introduction – Soft Multimodal Sensor

## Limitations

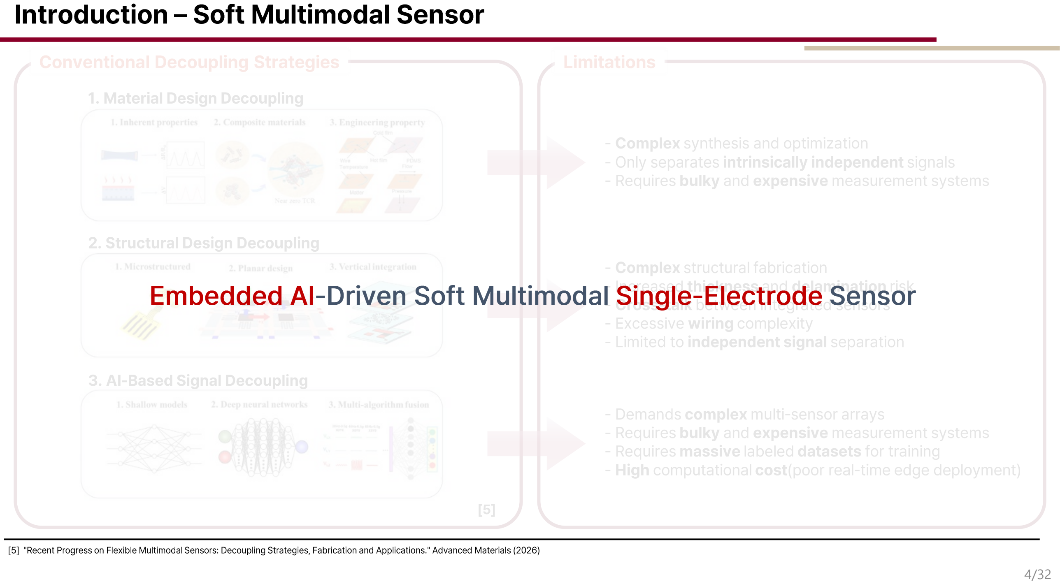
[picture p42: page 5]

1. Material Design Decoupling
2. Structural Design Decoupling
3. AI-Based Signal Decoupling

[5]

[5] "Recent Progress on Flexible Multimodal Sensors: Decoupling Strategies, Fabrication and Applications." Advanced Materials (20 26)

-Complex synthesis and optimization
-Only separates intrinsically independent signals -Requires bulky and expensive measurement systems

-Complex structural fabrication -Increased thickness and delamination risk -Cross-talk between integrated sensors -Excessive wiring complexity
-Limited to independent signal separation

-Demands complex multi-sensor arrays
-Requires bulky and expensive measurement systems -Requires massive labeled datasets for training
-High computational cost(poor real-time edge deployment)

## Conventional Decoupling Strategies

# Embedded AI-Driven Soft Multimodal Single-Electrode Sensor

# Introduction – Soft Inductive Sensor

## Electromagnetic Characteristics

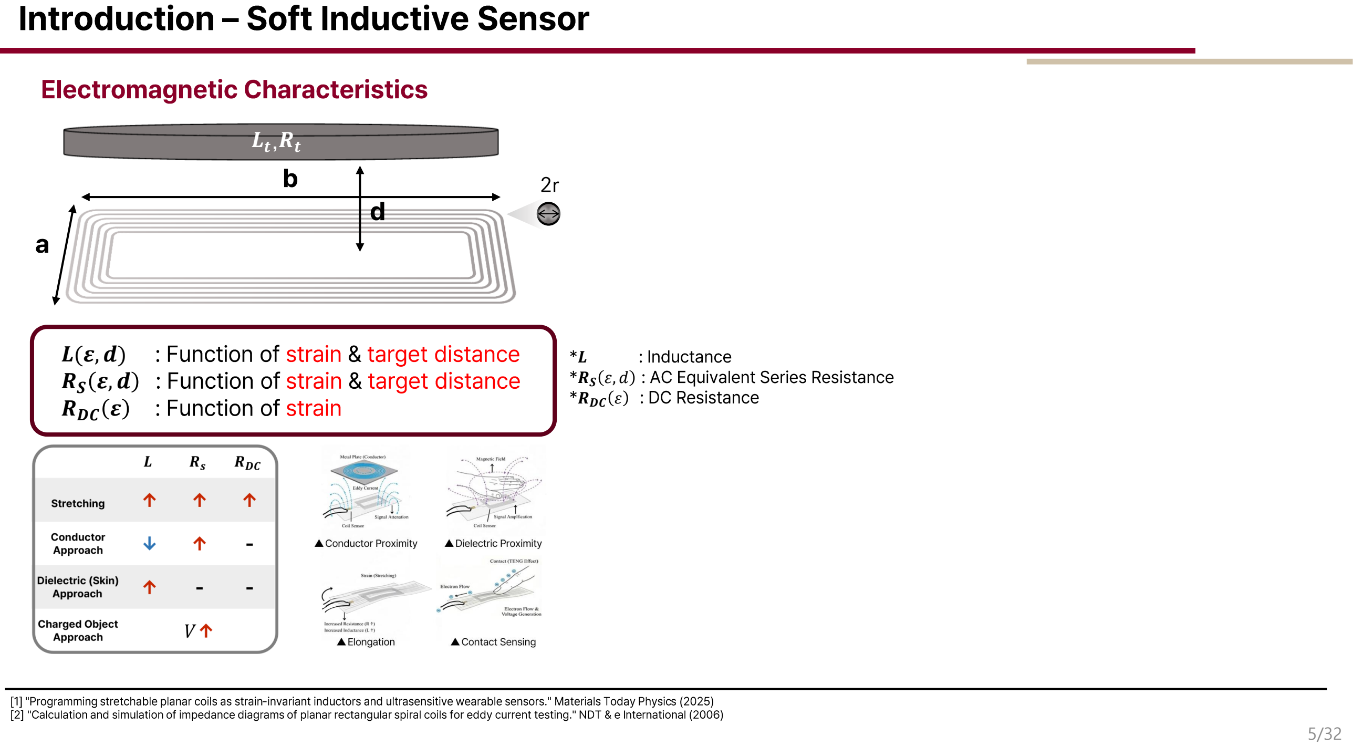
[picture p43: page 6]

[1]"Programming stretchable planar coils as strain-variant inductors and ultrasensitive wearable sensors." Materials Today Physic s (2025)
[2] "Calculation and simulation of impedance diagrams of planar rectangular spiral coils for eddy current testing." NDT & e I nternational (2006)

*Lself ε : Self Inductance
* t, A, r : Aspect Ratio(b/a), Coil Area(a*b), Liquid Metal Channel Radius *M ε, d : Mutual Inductance
*RDC ε : DC Resistance
*RS ε, d : AC Equivalent Series Resistance
*Lt

,Rt

: Target Inductance, Target Resistance

## -RDC(ε) = RDC,0 ∗ 1 + ε

2

## -Rs(ε, d) = RDC ε +

ωM(ε,d)

2

Rt

2+ ωLt

2 Rt

## -L(ε, d) = Lself(ε) −

ωM(ε,d)

2

Rt

2+ ωLt
2

Lt

-Lself ε = N

2

μ0 A ε

π

൤
1

t ε

ln

2 A ε

r ε t ε

+ t ε ln

2 A ε ∗t ε

r ε

+ 2 t ε +

1

t ε

−

1

t ε

sinh⁻¹

1

t ε

− t ε sinh | ቃ
−1

1

t ε

− t ε sinh⁻¹
t ε −

7

4

1

t ε

+ t ε
A ε = A0 1 + ε

0.5
,t ε = t0 1 + ε

1.5
, r ε = r0 1 + ε

−0.5

b | 2r

a

d

Lt

,Rt

*L | : Inductance
*RS ε, d : AC Equivalent Series Resistance *RDC ε : DC Resistance

## L(ε, d) : Function of strain & target distance RS ε, d : Function of strain & target distance RDC ε : Function of strain

## Electromagnetic Characteristics

Lt

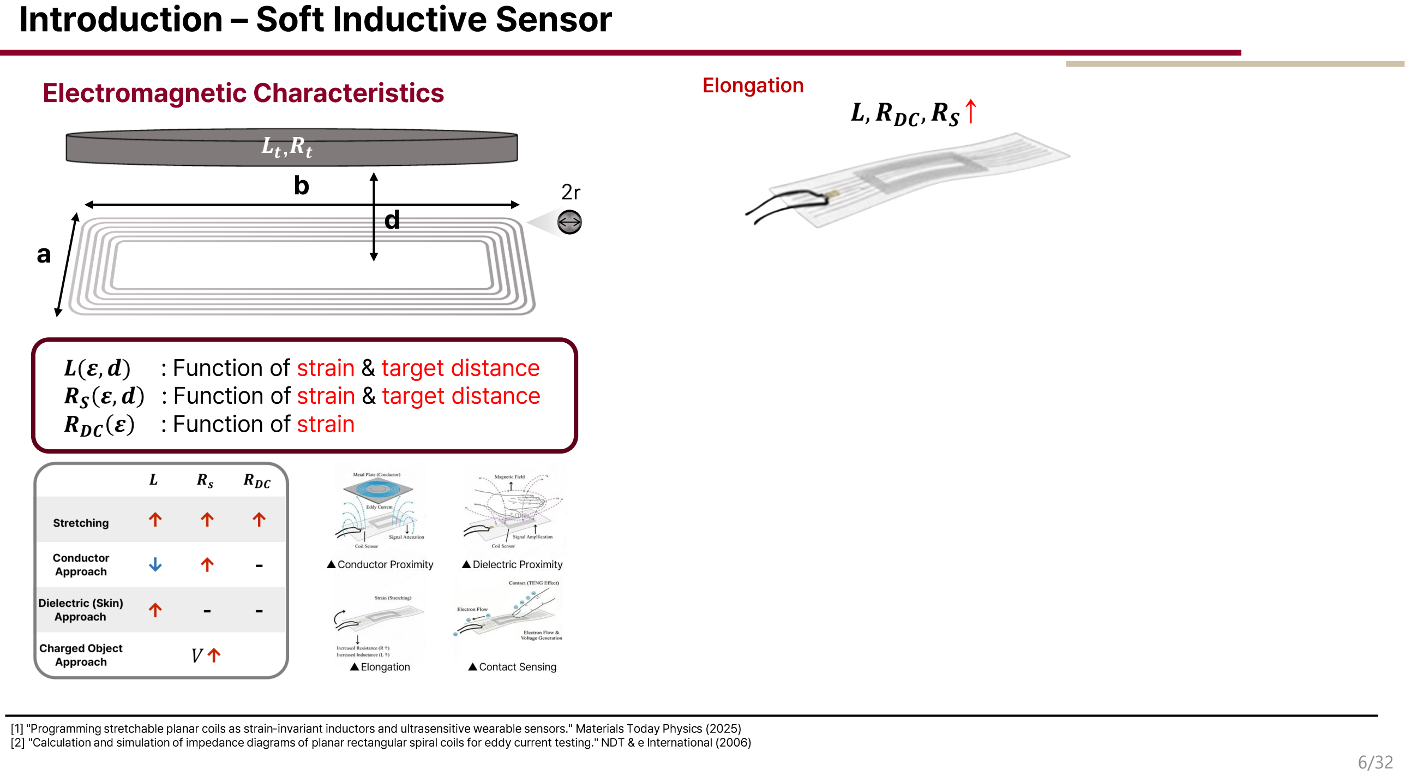
[picture p44: page 7]

b | 2r

a

d

,Rt

# Introduction – Soft Inductive Sensor

## L,RDC,RS↑

Elongation

[1]"Programming stretchable planar coils as strain-variant inductors and ultrasensitive wearable sensors." Materials Today Physic s (2025)
[2] "Calculation and simulation of impedance diagrams of planar rectangular spiral coils for eddy current testing." NDT & e I nternational (2006)

## L(ε, d) : Function of strain & target distance RS ε, d : Function of strain & target distance RDC ε : Function of strain

## Electromagnetic Characteristics

Lt

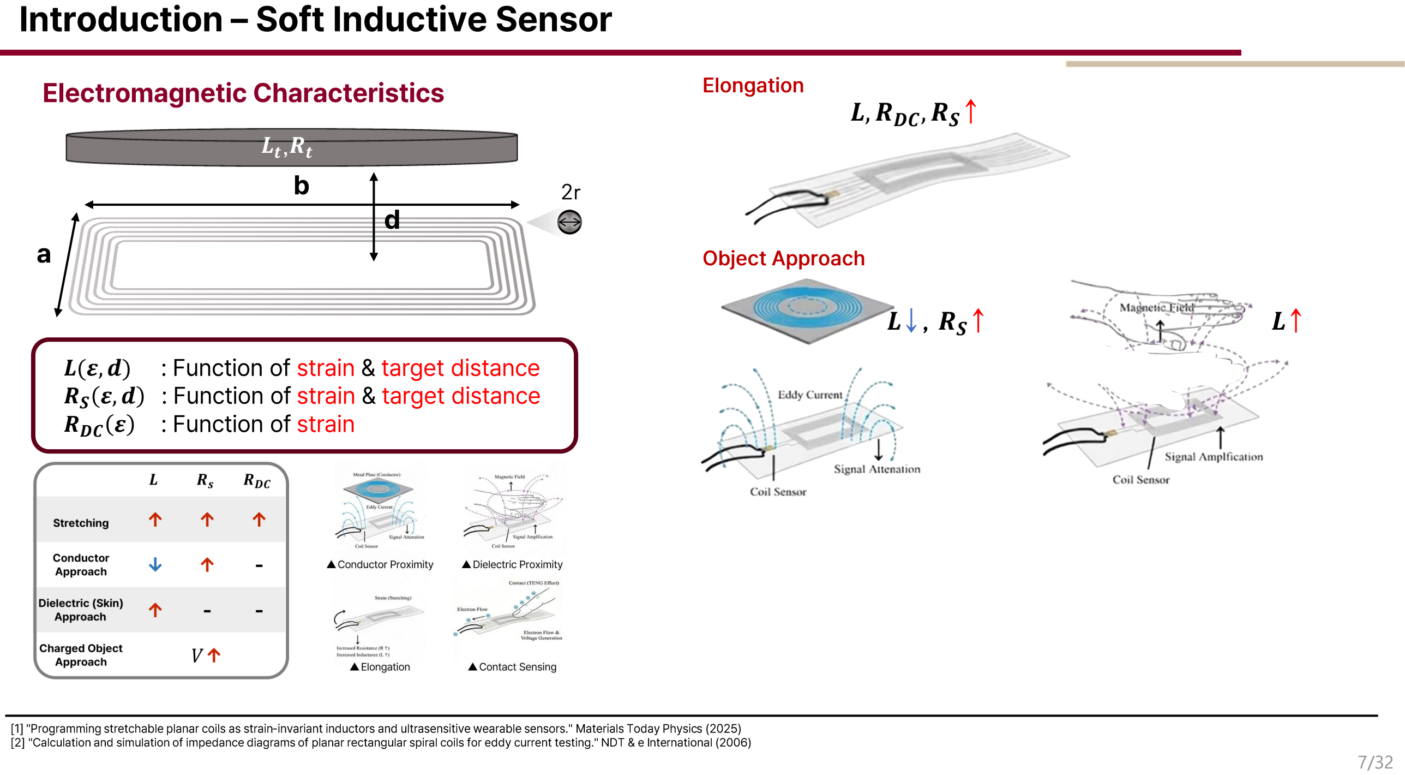
[picture p45: page 8]

＋＋
＋＋
b | 2r

a

d

,Rt

# Introduction – Soft Inductive Sensor

[1]"Programming stretchable planar coils as strain-variant inductors and ultrasensitive wearable sensors." Materials Today Physic s (2025)
[2] "Calculation and simulation of impedance diagrams of planar rectangular spiral coils for eddy current testing." NDT & e I nternational (2006)

Object Approach

## L,RDC,RS↑

Elongation

L↓, RS↑ | L↑
L(ε, d) | : Function of strain & target distance

## RS ε, d : Function of strain & target distance RDC ε : Function of strain

## Electromagnetic Characteristics

Lt

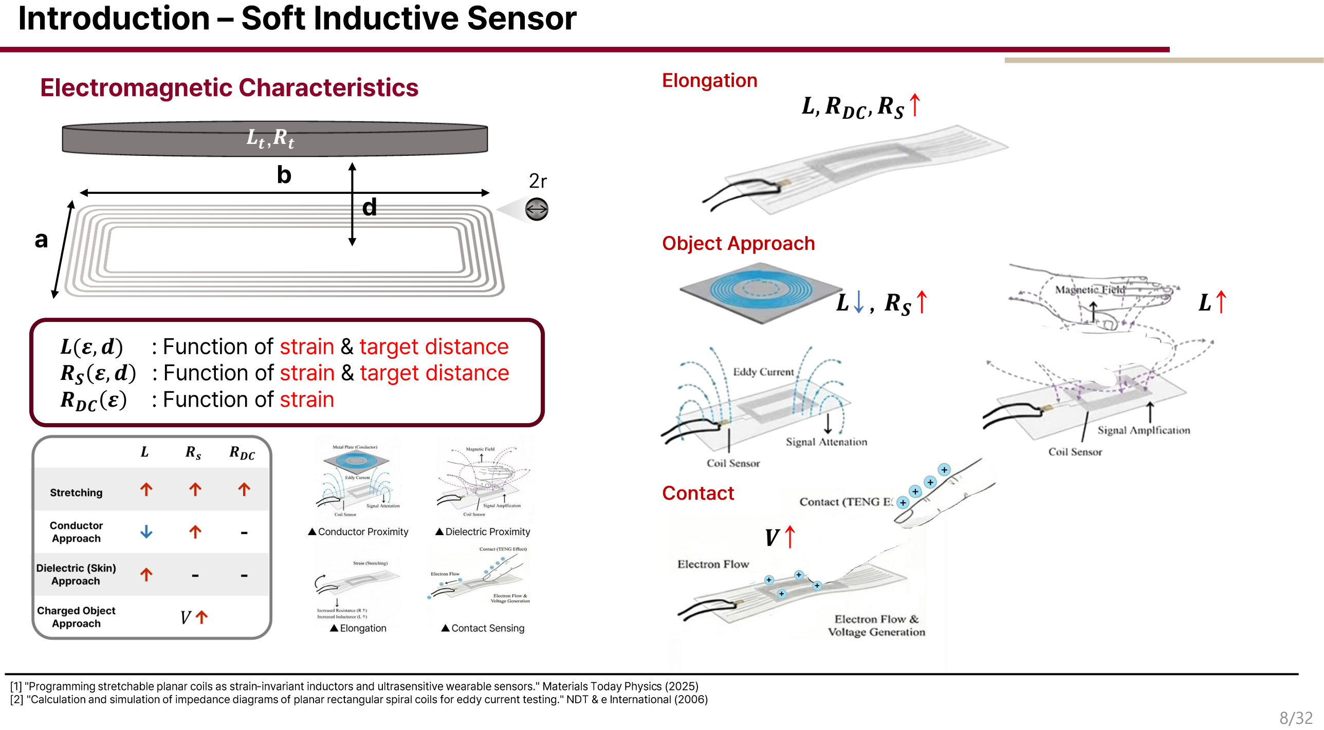
[picture p46: page 9]

b | 2r

a

d

,Rt

# Introduction – Soft Inductive Sensor

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

Object Approach

## L,RDC,RS↑

Elongation

L↑

Contact

＋
＋
＋

＋

## L↓, RS↑

V↑

＋
＋
＋
＋

## L(ε, d) : Function of strain & target distance RS ε, d : Function of strain & target distance RDC ε : Function of strain

# Introduction – Soft Inductive Sensor

## Electromagnetic Characteristics

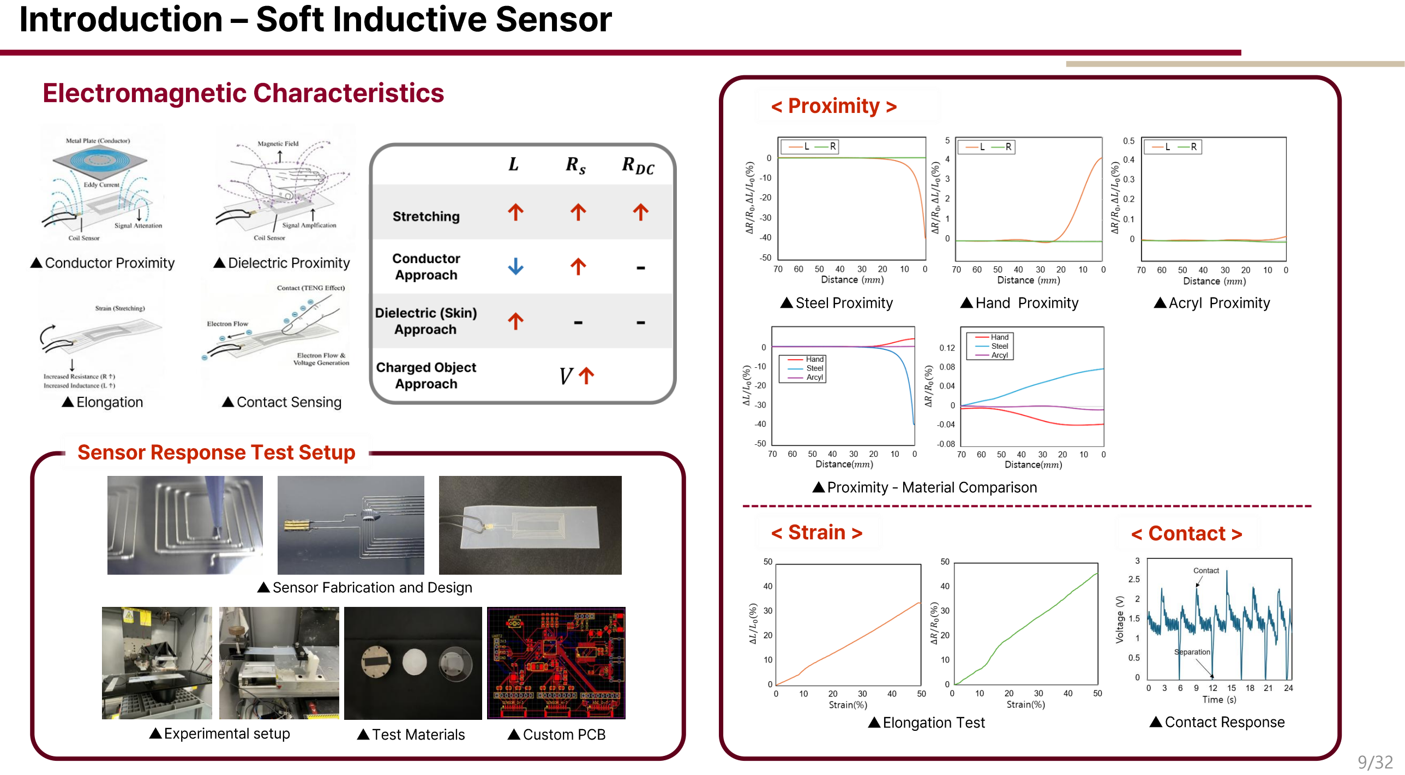
[picture p47: page 10]

▲ Experimental setup | ▲ Test Materials | ▲ Custom PCB

▲ Proximity -Material Comparison

▲ Steel Proximity | ▲ Hand Proximity | ▲ Acryl Proximity
▲ Elongation Test | ▲ Contact Response

▲ Sensor Fabrication and Design

Sensor Response Test Setup

< Proximity >

< Strain > | < Contact >

[1]"Ultra-high resolution, multi-scenario, super-elastic inductive strain sensors based on liquid metal for the wireless monitoring of human movement." Materials Advances (2024)
[2] "Robust and high-performance soft inductive tactile sensors based on the Eddy -current effect." Sensors and Actuators A: Phys ical (2018)
[3] "A planar coil -based inductive bend sensor for soft robotic applications." IEEE Sensors Journal (2024)
[4] "A triboelectric-inductive hybrid tactile sensor for highly accurate object recognition." Nano Energy (2022)
[5] "Multi-functional safety sensor coupling capacitive and inductive measurement for physical human –robot interaction." Sensorsand Actuators A: Physical (2023)
[6] "A soft inductive bimodal sensor for proprioception and tactile sensing of soft machines." Soft Robotics (2024)
[7] "Fingertip‐inspired spatially anisotropic inductive liquid metal sensors with ultra‐wide range, high linearity and except | ional stability." Advanced Materials (2025)

Hybrid

[4] Object Recognition (Inductance + TENG)
[5] Proximity (Inductance + Capacitance)
[2] Tactile
[3] Bending
[1] Strain

Multimodal

[7] 2-Axis Force (Inductance + Resistance)
[6] Bending + Force (Low + High frequency Inductance)

## Previous Researches

Unimodal

## Measure only one modality

## -Measures max two modalities using

restricted L/R combinations.

## -Requires bulky LCR meters, preventing

independent embedded implementation.

# Introduction – Research Idea

## Multiple Parameters Acquisition & Modalities Decoupling

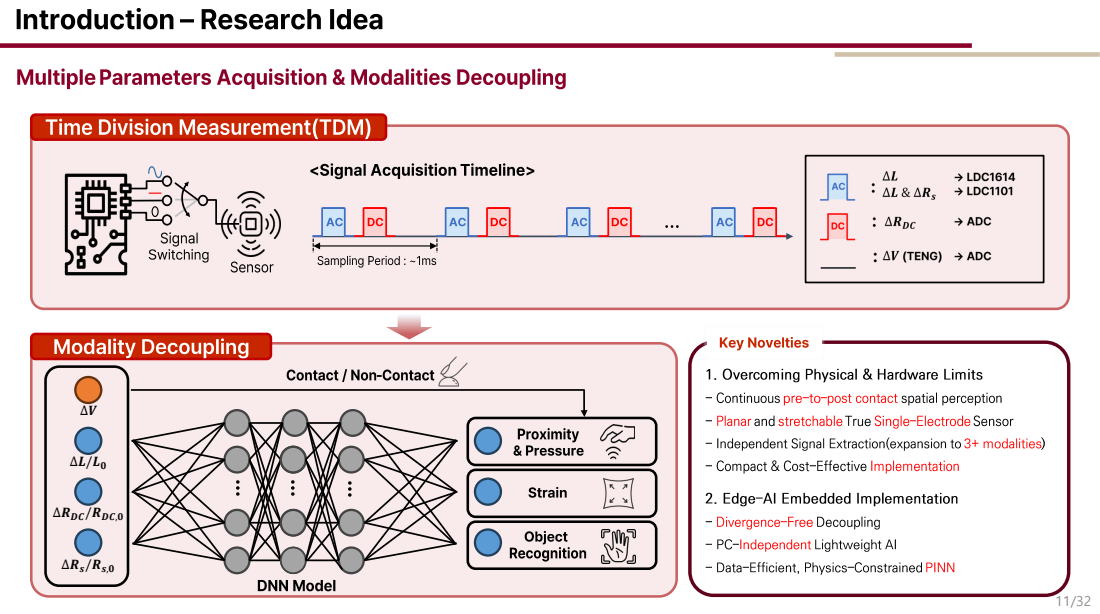
[picture p48: page 12]
Sampling Period : ~1ms; Modality Decoupling; Sensor; Signal Switching; Key Novelties; Proximity & Pressure; Strain; Object Recognition; ∆RDC/RDC,0; DNN Model

Time Division Measurement(TDM)

<Signal Acquisition Timeline>

Contact / Non-Contact

1. Overcoming Physical & Hardware Limits

- Continuous pre-to-post contact spatial perception
- Planarand stretchableTrue Single-ElectrodeSensor
- Independent Signal Extraction(expansion to 3+ modalities)
- Compact & Cost-Effective Implementation

2. Edge-AI Embedded Implementation

- Divergence-Free Decoupling
- PC-IndependentLightweight AI
- Data-Efficient, Physics-Constrained PINN

# Method

## Research Design

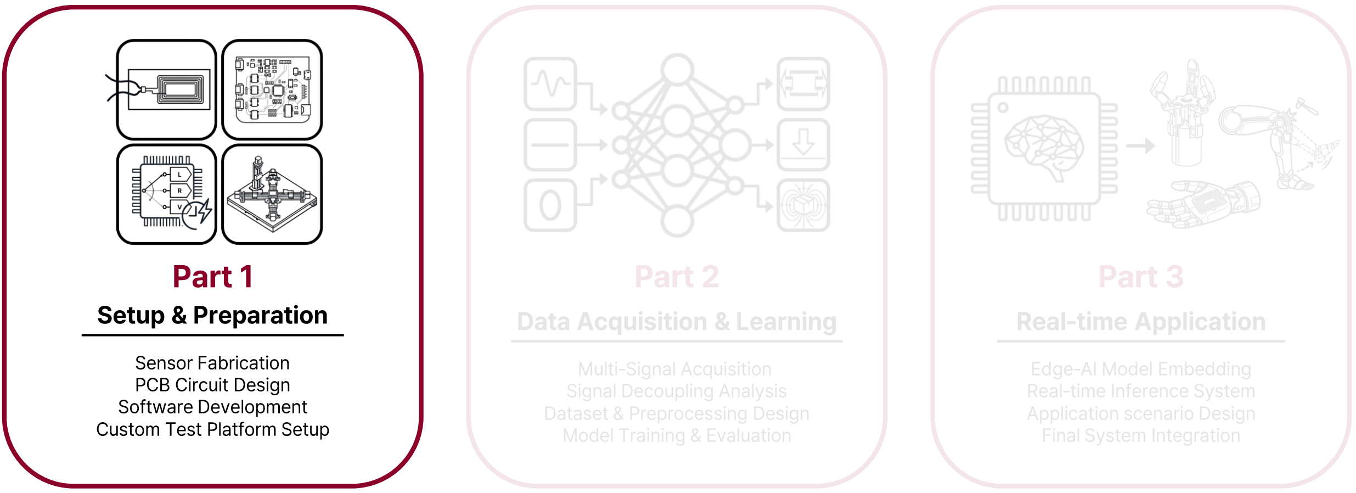
[picture p49: figure]
Part 1; Setup & Preparation; Part 2; Data Acquisition & Learning; Part 3; Real-time Application; Sensor Fabrication PCB Circuit Design Software Development Custom Test Platform Setup; Multi-Signal Acquisition Signal Decoupling Analysis Dataset & Preprocessing Design Model Training & Evaluation; Edge-AI Model Embedding Real-time Inference System Application scenario Design; Final System Integration

# Sensor Fabrication

## Sensor Fabrication Process

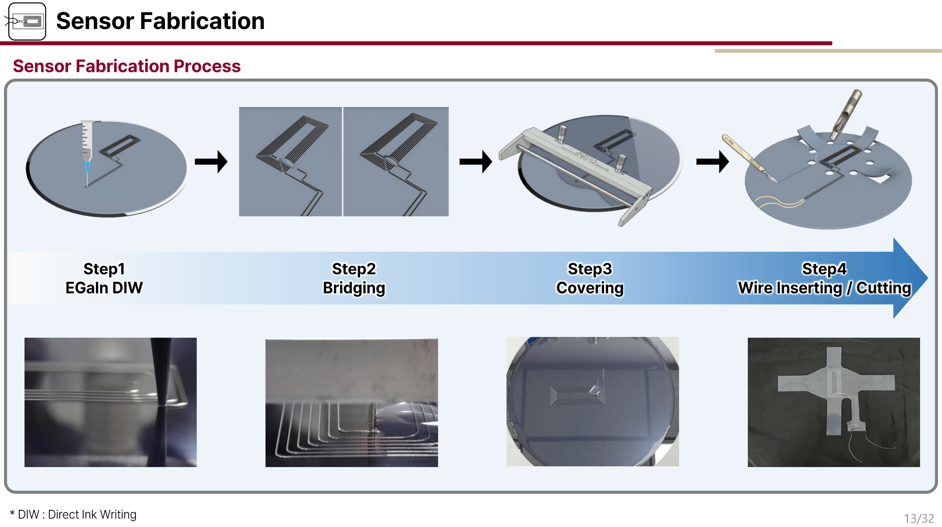
[picture p50: page 14]

## Step1 EGaIn DIW

## Step2 Bridging

* DIW : Direct Ink Writing

## Step3 Covering

## Step4 Wire Inserting / Cutting

# Method

## Research Design

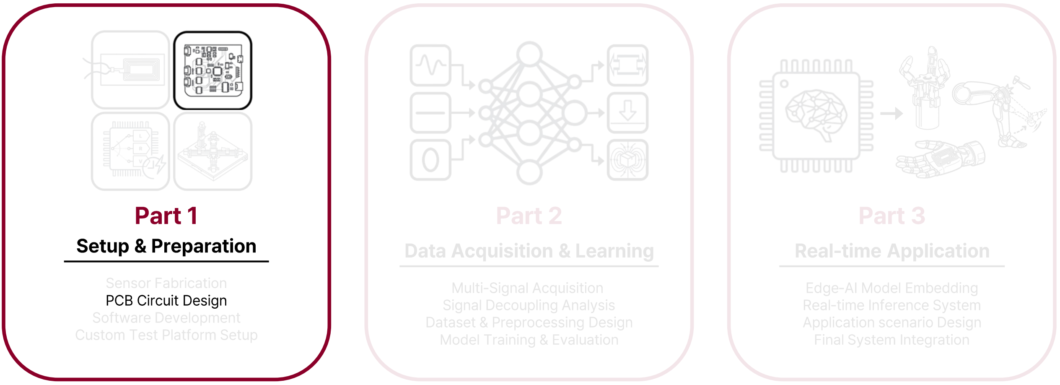
[picture p51: figure]
Part 1; Setup & Preparation; Part 2; Data Acquisition & Learning; Part 3; Real-time Application; Sensor Fabrication PCB Circuit Design Software Development Custom Test Platform Setup; Multi-Signal Acquisition Signal Decoupling Analysis Dataset & Preprocessing Design Model Training & Evaluation; Edge-AI Model Embedding Real-time Inference System Application scenario Design Final System Integration

# PCB Circuit Design

## 4Channel TDM Circuit

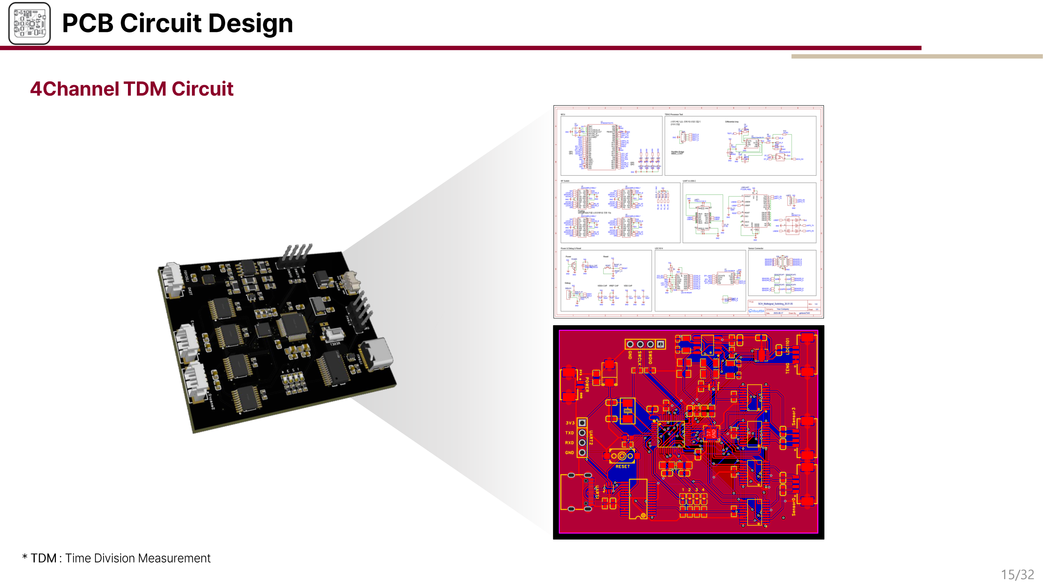
[picture p52: page 16]

PCB Circuit Design

* TDM : Time Division Measurement

# PCB Circuit Design

x4

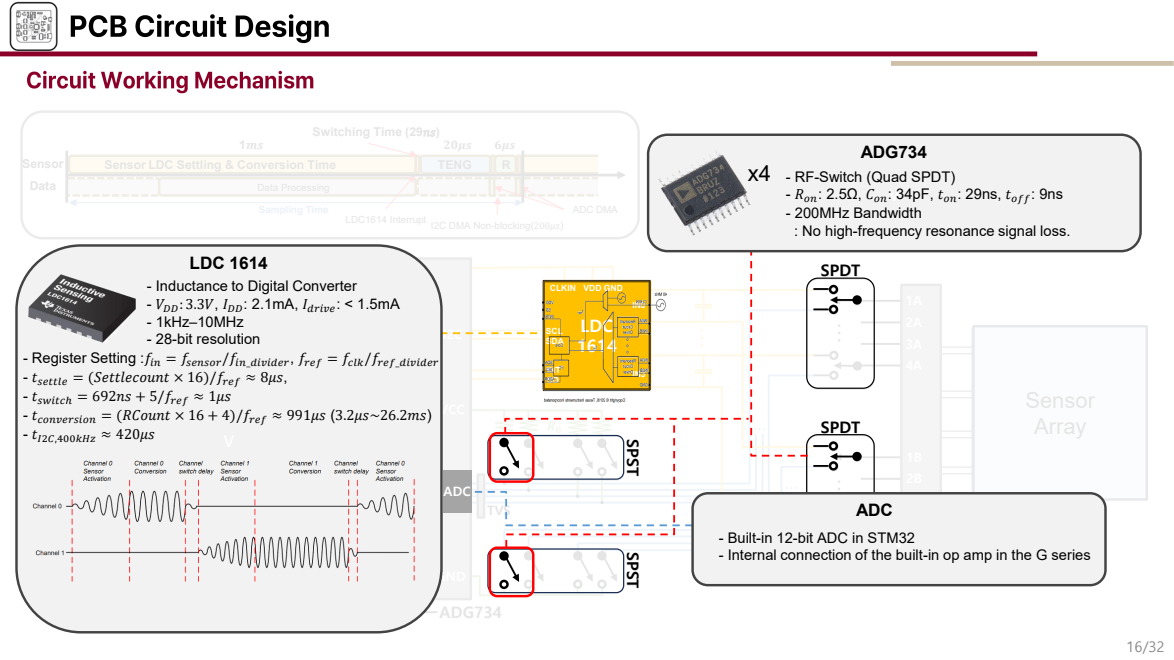
[picture p53: page 17]
RDC; ADC =; × Gainop; ADC = V × Gainop; TVS; 28bit =; /fref; LDC; SCL SDA; INT SD; Sensor Array; SPST; SPDT; STM32; ADC; VCC; GND; GPIO; ADG734; LDC1614 Interrupt; ADC DMA; LDC Settling & Conversion Time; TENG; Switching Time (29ns); Data Processing; Sampling Time; Sensor; Data; LDC 1614; SPST SPST

Circuit Working Mechanism

- RF-Switch (Quad SPDT)
- Ron: 2.5Ω, Con: 34pF, ton: 29ns, toff: 9ns
- 200MHz Bandwidth
: No high-frequency resonance signal loss.

I2C DMA Non-blocking(200μs)

- Inductance to Digital Converter
- VDD: 3.3V, IDD: 2.1mA, Idrive: < 1.5mA
- 1kHz–10MHz
- 28-bit resolution

CLKIN VDD GND

- Register Setting :fin = fsensor/fin_divider, fref = fclk/fref_divider
- tsettle = (Settlecount × 16)/fref ≈ 8μs,
VTENG
- tswitcℎ = 692ns + 5/fref ≈ 1μs
- tconversion = (RCount × 16 + 4)/fref ≈ 991μs (3.2μs~26.2ms)
- tI2C,400kHz ≈ 420μs

- Built-in 12-bit ADC in STM32
- Internal connection of the built-in op amp in the G series

# PCB Circuit Design

## Circuit Working Mechanism

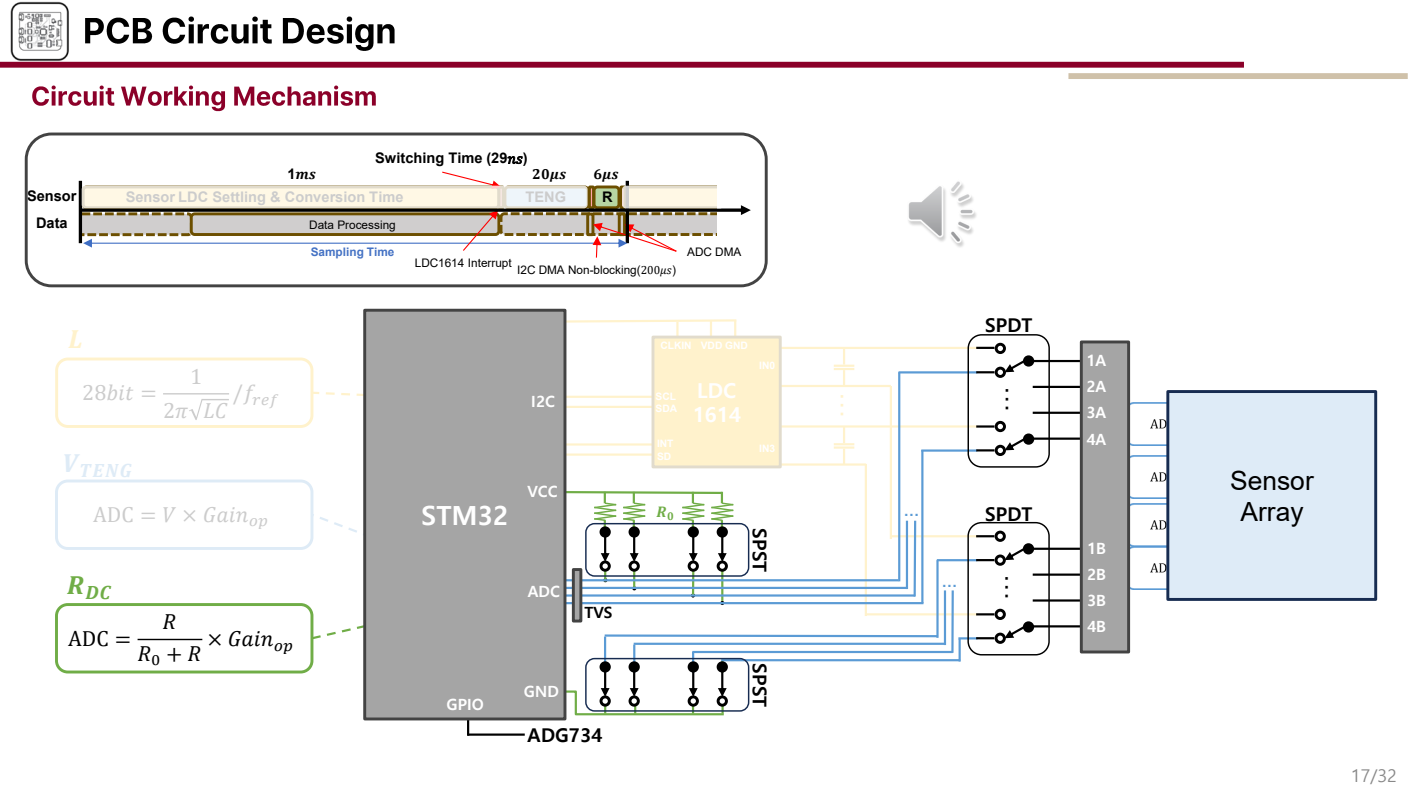
[picture p54: page 18]
RDC; ADC; × Gainop; VTENG; TVS; 28bit; fref; LDC; SCL SDA; INT SD; Sensor Array; SPST; SPDT …; STM32; VCC; GND; GPIO; ADG734; I2C DMA Non; -blocking(200; LDC1614 Interrupt; ADC DMA; LDC Settling & Conversion Time; TENG; Switching Time (29; Data Processing; Sampling Time; Sensor; Data

CLKIN VDD GND

# Method

## Research Design

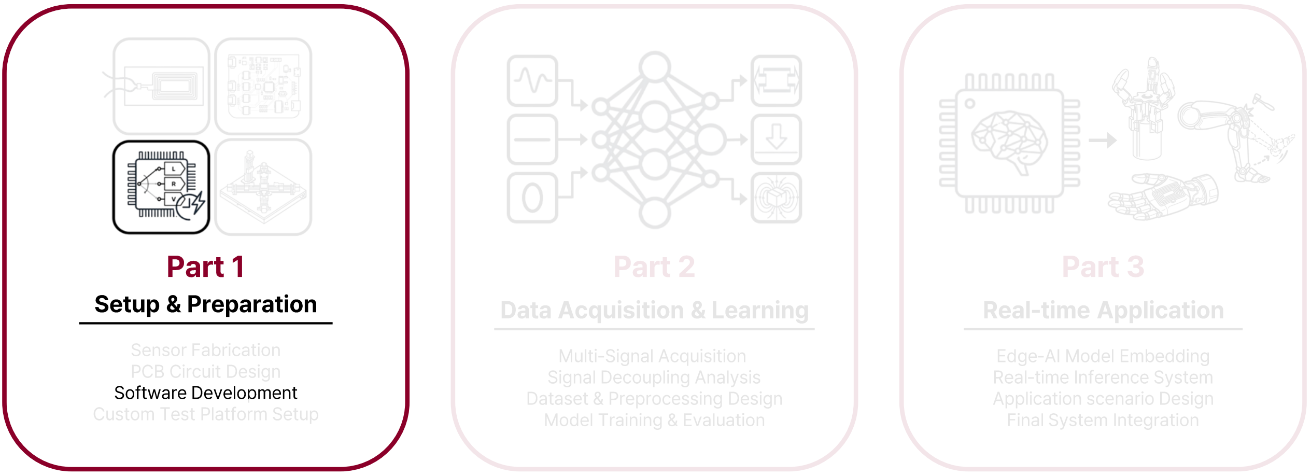
[picture p55: figure]
Part 1; Setup & Preparation; Part 2; Data Acquisition & Learning; Part 3; Real-time Application; Sensor Fabrication PCB Circuit Design Software Development Custom Test Platform Setup; Multi-Signal Acquisition Signal Decoupling Analysis Dataset & Preprocessing Design Model Training & Evaluation; Edge-AI Model Embedding Real-time Inference System Application scenario Design Final System Integration

# Software Development

## Timer Based Parallel Non-Blocking DMA Processing for Embedded AI

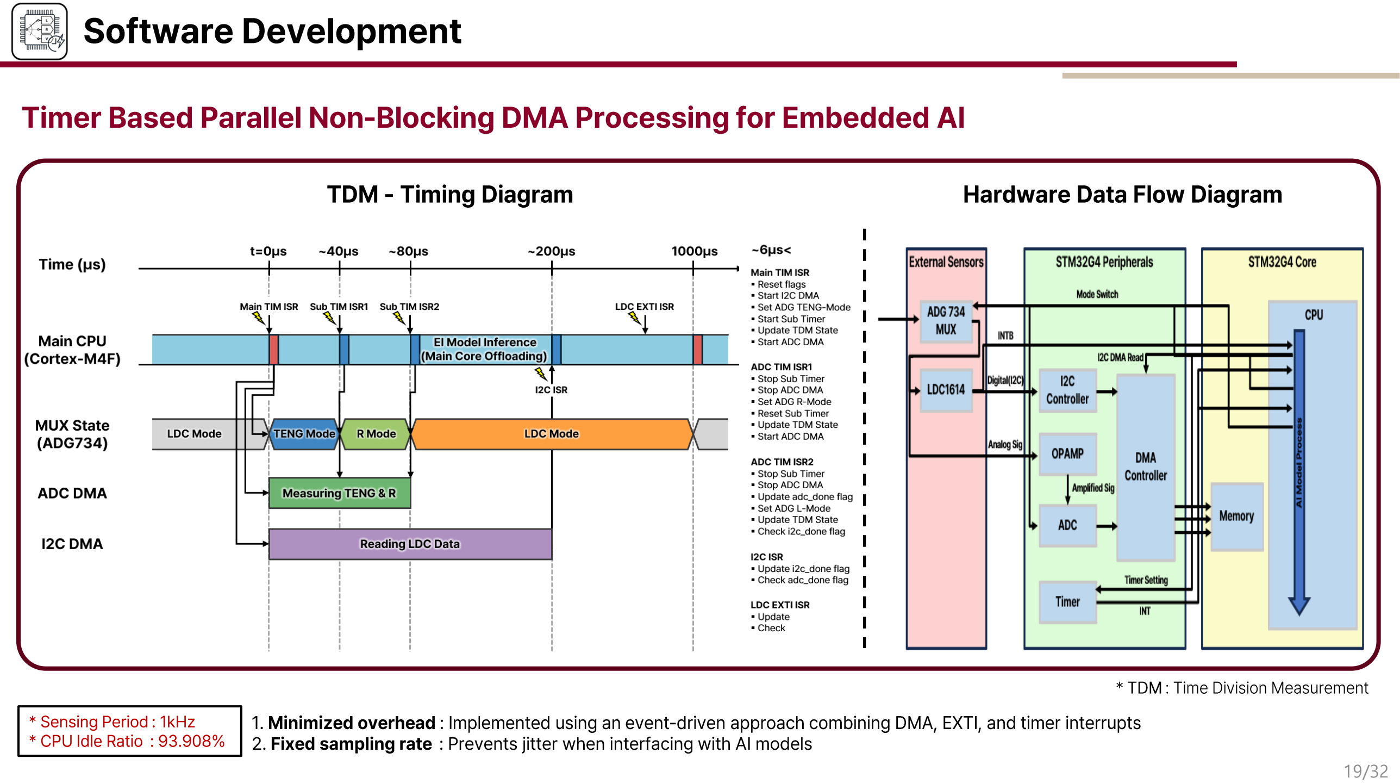
[picture p56: page 20]

* TDM : Time Division Measurement

* Sensing Period: 1kHz
* CPU Idle Ratio : 93.908%
1. Minimized overhead : Implemented using an event-driven approach combining DMA, EXTI, and timer interrupts
2. Fixed sampling rate : Prevents jitter when interfacing with AI models
TDM -Timing Diagram | Hardware Data Flow Diagram

# Software Development

## < Strain >

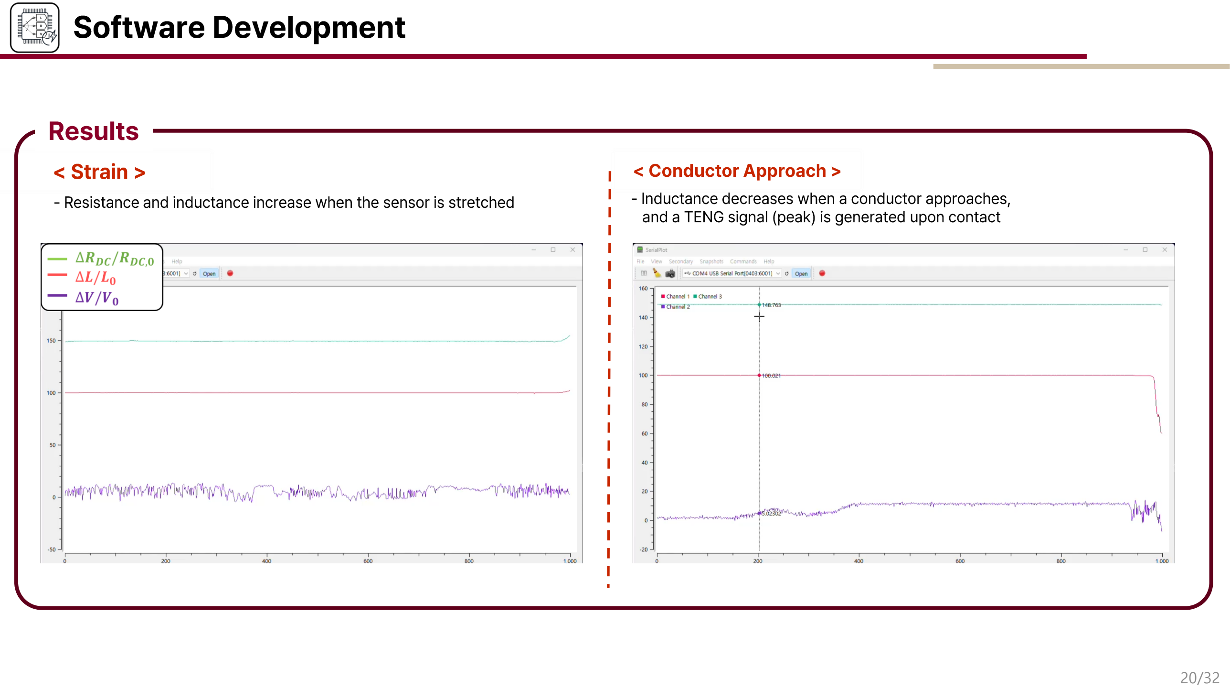
[picture p57: page 21]

-Resistance and inductance increase when the sensor is stretched

< Conductor Approach >

-Inductance decreases when a conductor approaches, and a TENG signal (peak) is generated upon contact

## Results

# Method

## Research Design

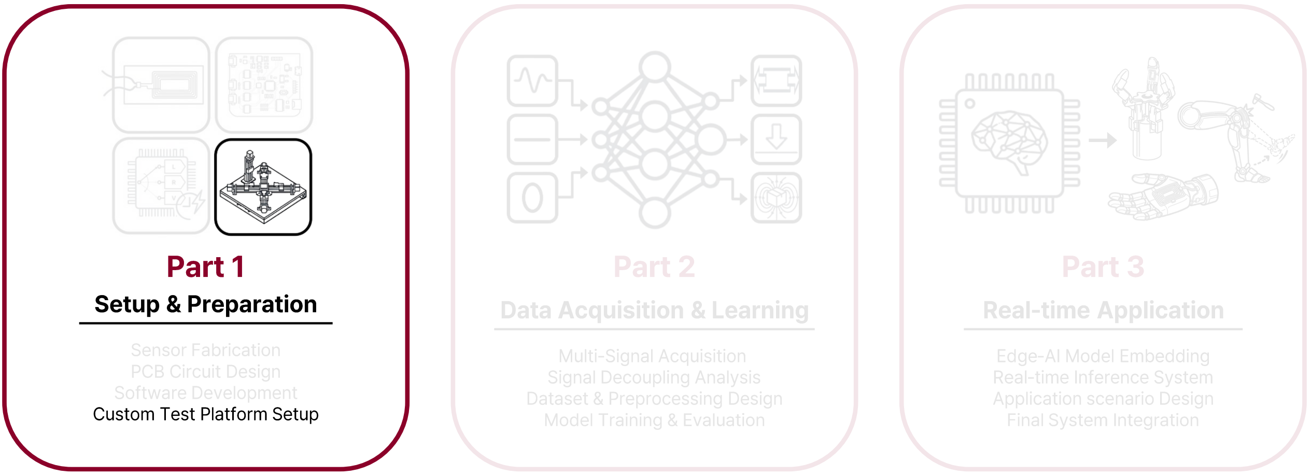
[picture p58: figure]
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

# Custom Test Platform Setup

## Fabrication of a test platform for data acquisition

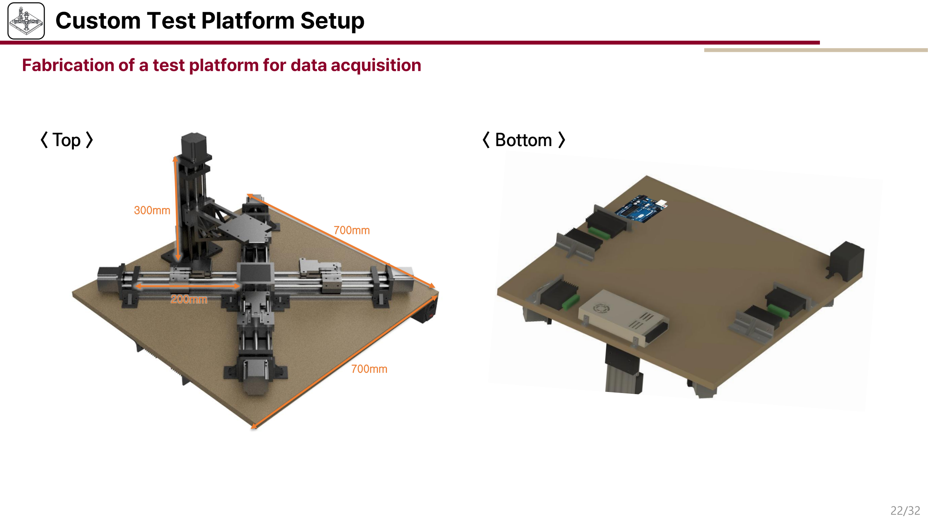
[picture p59: page 23]

700mm

700mm

200mm

300mm

< Top > | < Bottom >

# Custom Test Platform Setup

## Fabrication of a test platform for data acquisition

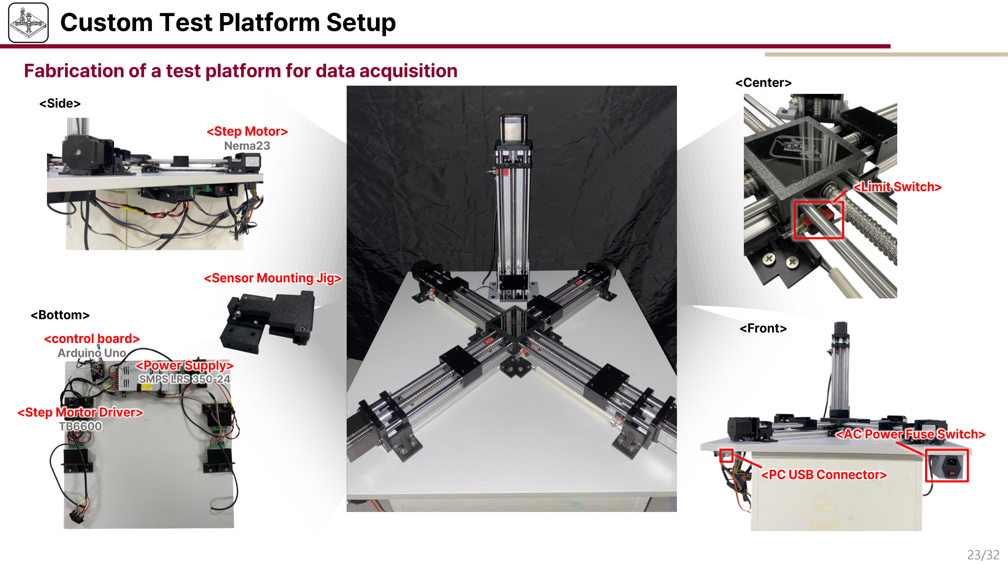
[picture p60: page 24]

<Front>

<Center>
<Side>

<Bottom>

<AC Power Fuse Switch>

<PC USB Connector>

<Limit Switch >

<Step Mortor Driver>
TB6600

<Power Supply >
SMPS LRS 350-24

<Step Motor>
Nema23

<Sensor Mounting Jig >

<control board>
Arduino Uno

# Custom Test Platform Setup

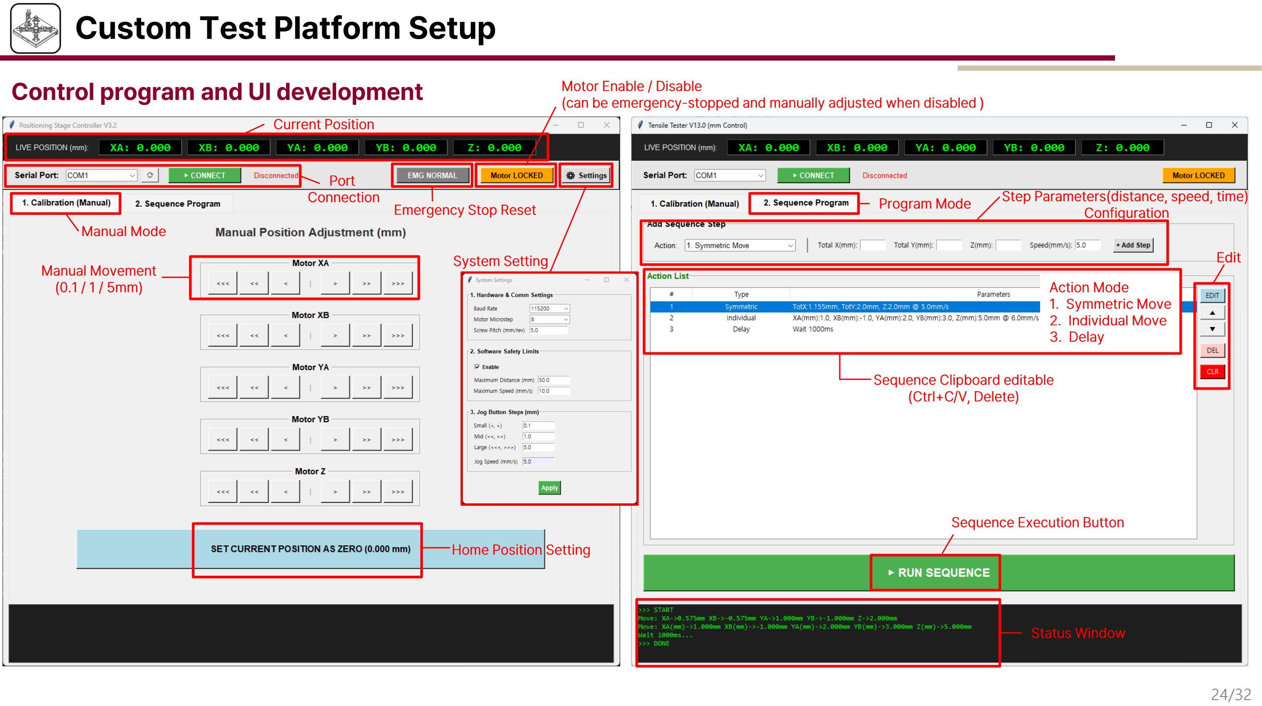
[picture p61: page 25]

Port
Connection

Current Position

Manual Mode

Manual Movement
(0.1 / 1 / 5mm)

Home Position Setting

Program Mode | Step Parameters(distance, speed, time) Configuration
| Edit
| Action Mode
1. Symmetric Move
2. Individual Move
3. Delay

Status Window

Sequence Execution Button

Motor Enable / Disable Control program and UI development | (can be emergency-stopped and manually adjusted when disabled )

Emergency Stop Reset

Sequence Clipboard editable (Ctrl+C/V, Delete)

System Setting

# Discussion

## Research Design

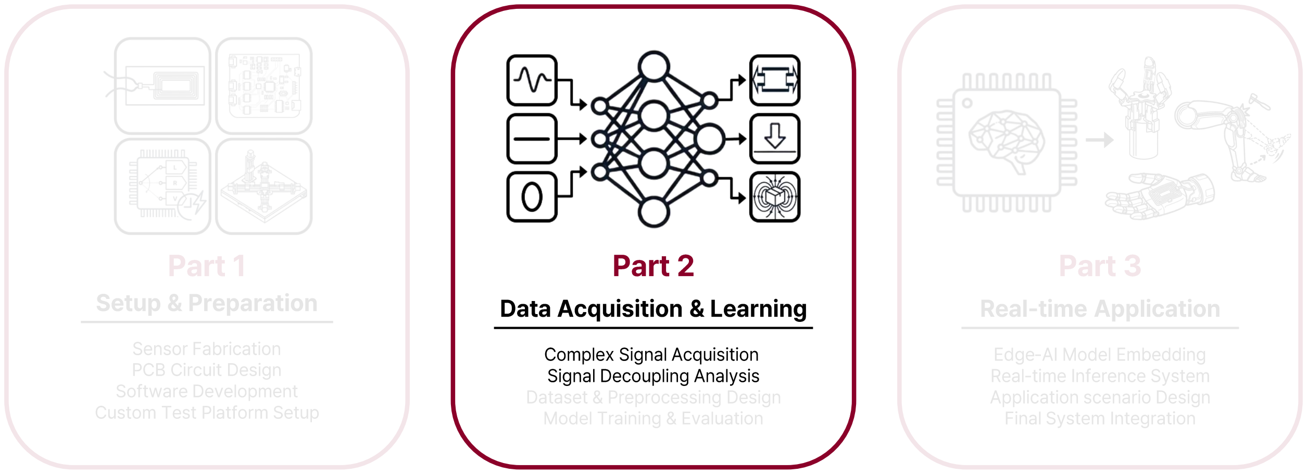
[picture p62: figure]
Part 1; Setup & Preparation; Part 2; Data Acquisition & Learning; Part 3; Real-time Application; Sensor Fabrication PCB Circuit Design Software Development Custom Test Platform Setup; Complex Signal Acquisition Signal Decoupling Analysis Dataset & Preprocessing Design Model Training & Evaluation; Edge-AI Model Embedding Real-time Inference System Application scenario Design Final System Integration

# Complex Signal Acquisition

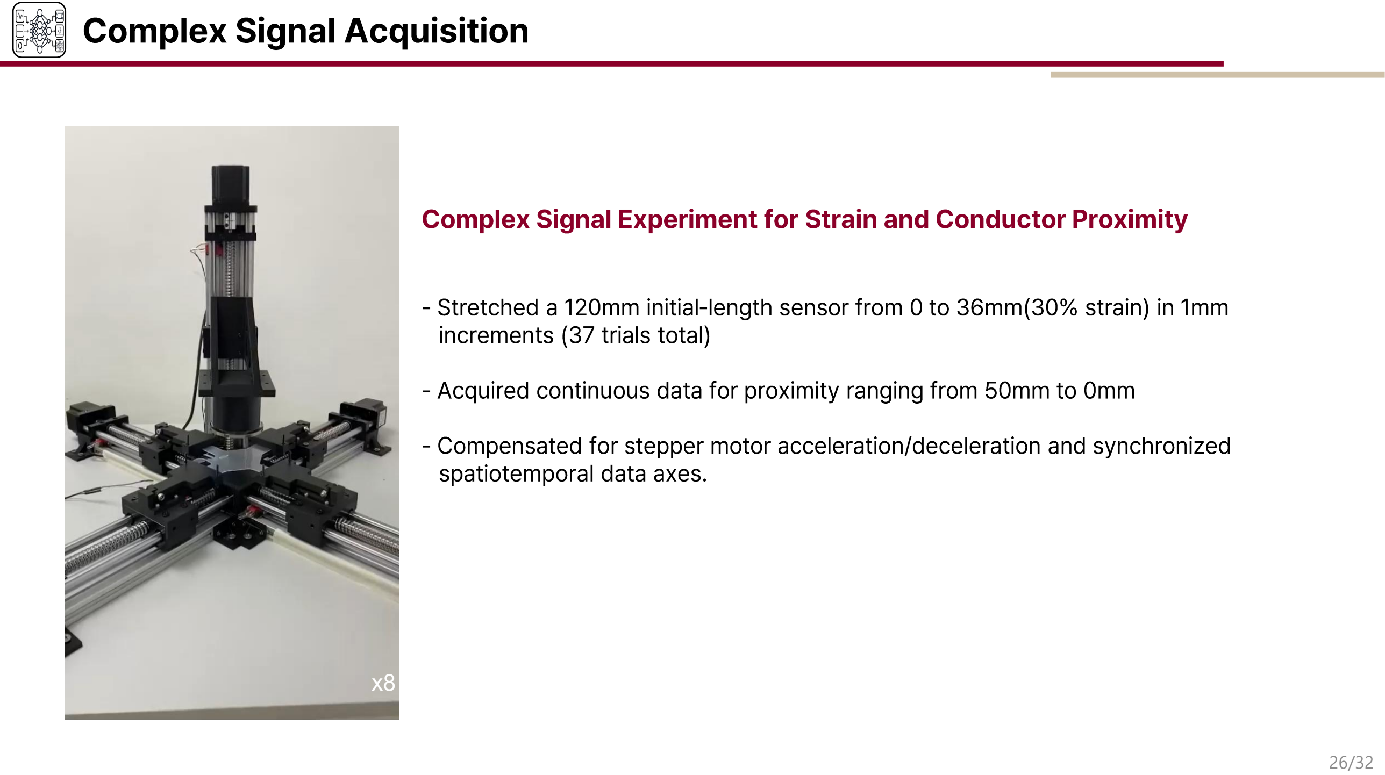
[picture p63: page 27]

## -Stretched a 120mm initial-length sensor from 0 to 36mm(30% strain) in 1mm increments (37 trials total)

## -Acquired continuous data for proximity ranging from 50mm to 0mm

## -Compensated for stepper motor acceleration/deceleration and synchronized

spatiotemporal data axes.

x8

## Complex Signal Experiment for Strain and Conductor Proximity

## Sensor Response under Complex(Strain/Proximity) Stimuli -3D Plot

## -Resistance: Dominantly governed by tensile strain

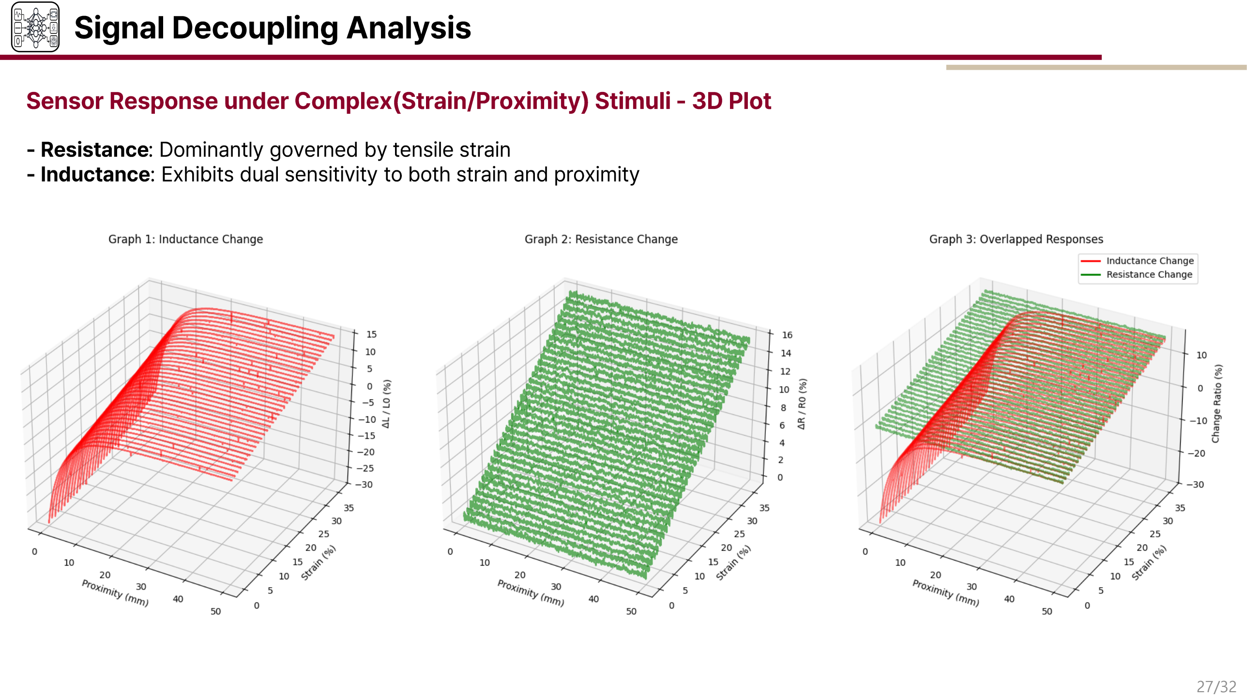
[picture p64: page 28]

## -Inductance: Exhibits dual sensitivity to both strain and proximity

# Signal Decoupling Analysis

## Sensor Response under Complex(Strain/Proximity) Stimuli – 2D Heatmap & Contour

# Signal Decoupling Analysis

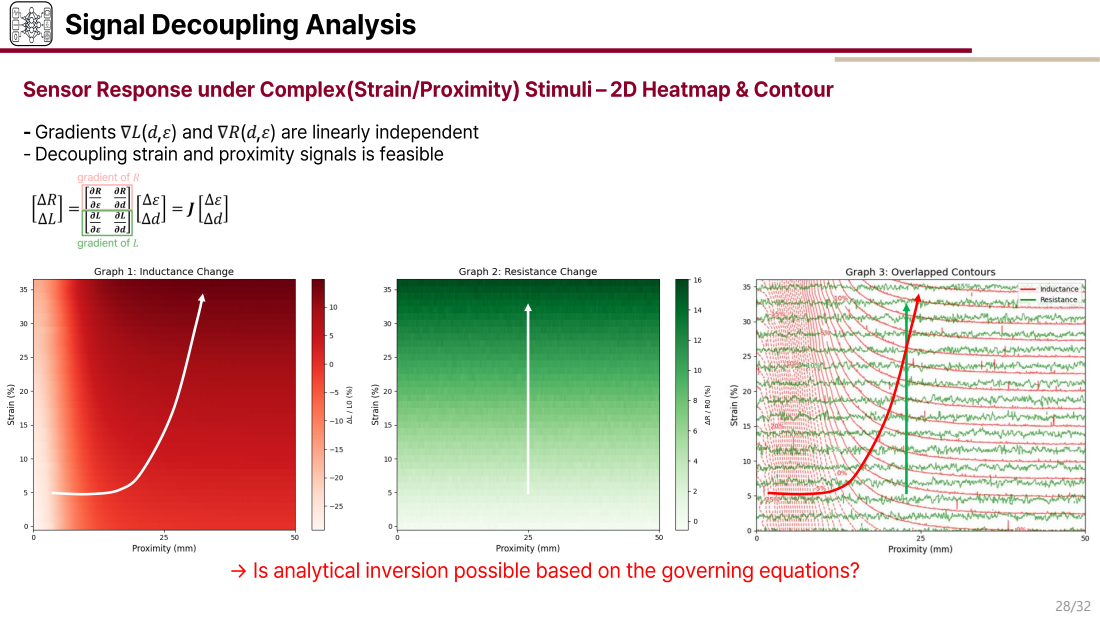
[picture p65: page 29]

-Gradients ∇L(d,ε) and ∇R(d,ε) are linearly independent
-Decoupling strain and proximity signals is feasible

→ Is analytical inversion possible based on the governing equations?

## Sensor Response under Complex(Strain/Proximity) Stimuli – Mathematical Model

# Signal Decoupling Analysis

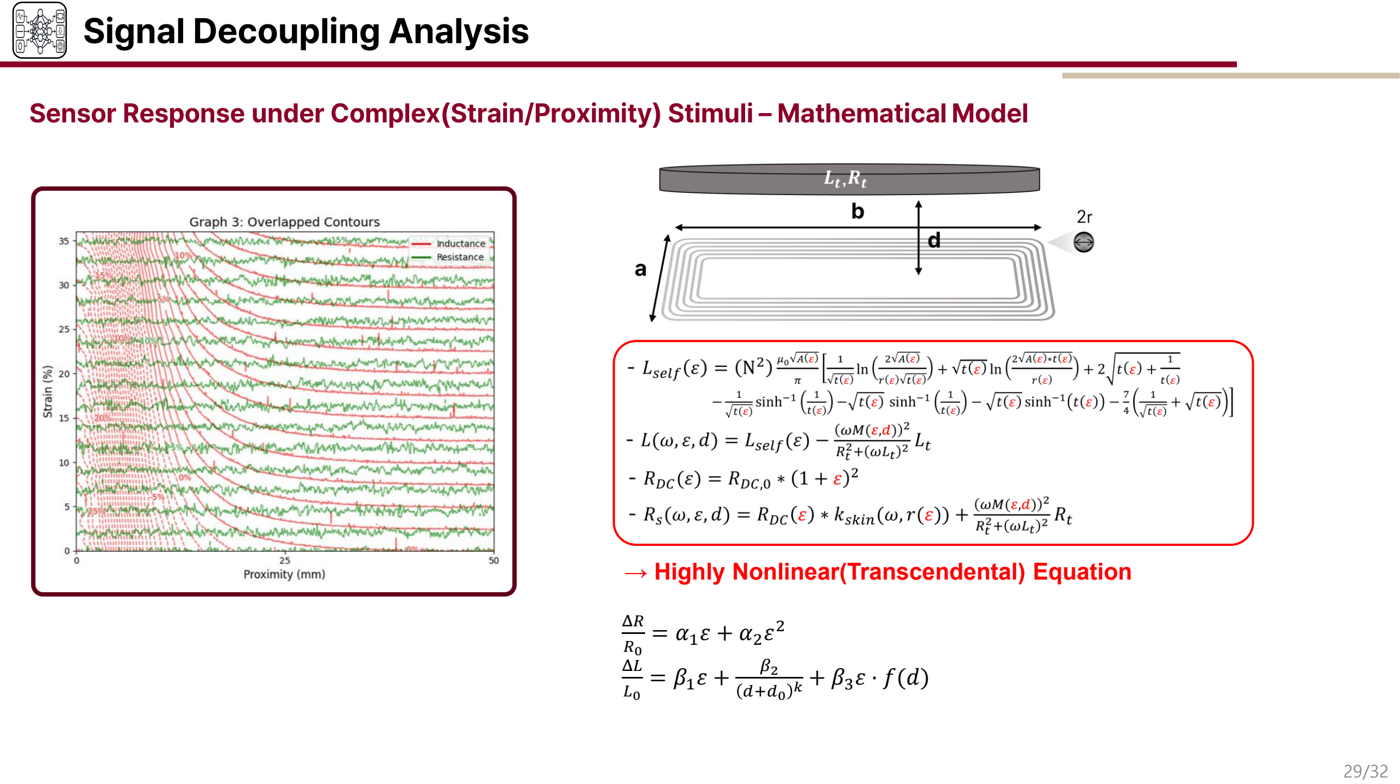
[picture p66: page 30]

ΔR
R0

## = α1ε + α2ε

2

ΔL
L0

= β1ε +

β2
d+d0

## k + β3ε ⋅ f(d)

### → Highly Nonlinear(Transcendental) Equation

## Formulation of Linear Interpolation

# Signal Decoupling Analysis

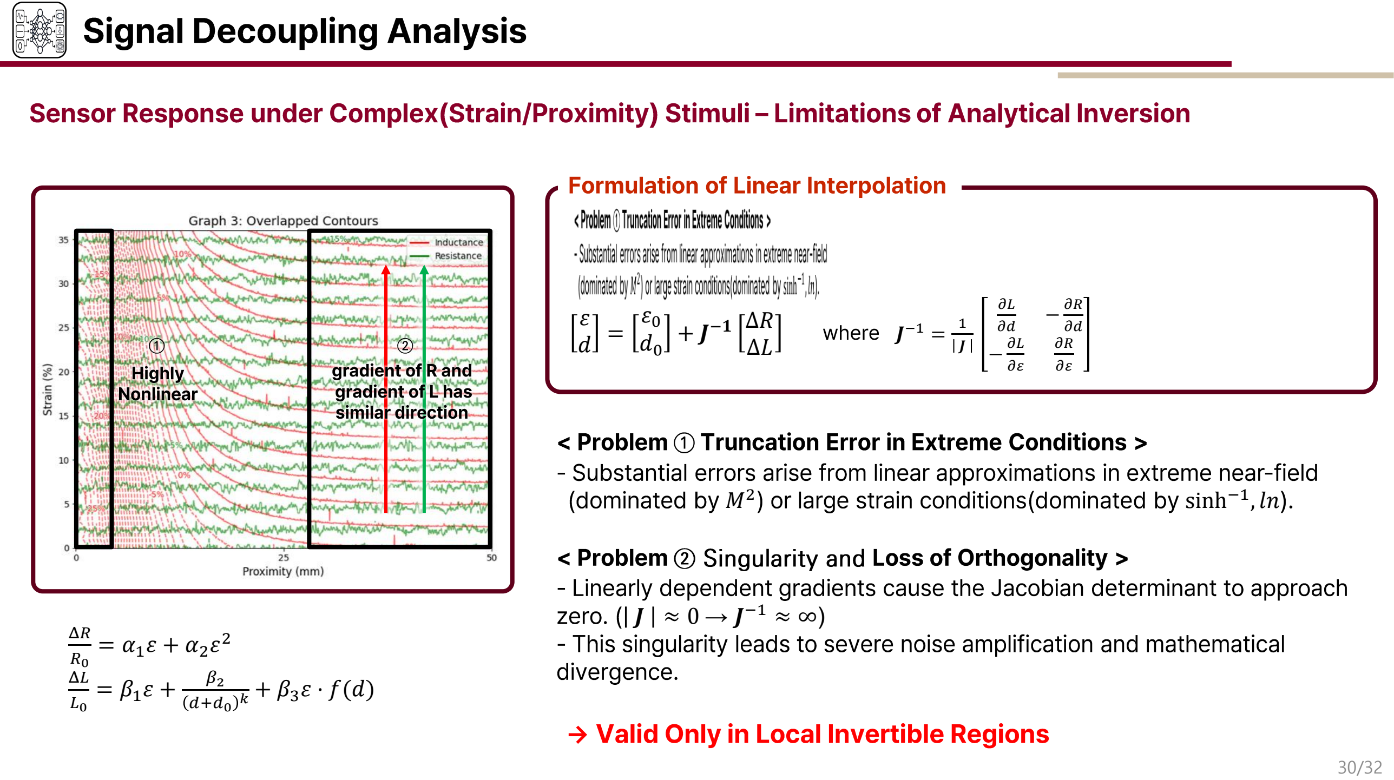
[picture p67: page 31]

## < Problem ② Singularity and Loss of Orthogonality > -Linearly dependent gradients cause the Jacobian determinant to approach zero. ( J ≈ 0 → J

−1 ≈ ∞)

## -This singularity leads to severe noise amplification and mathematical

divergence.

ε
d

=

ε0
d0

+ J

−1 ∆R
∆L

where J

−1 =

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
## < Problem ① Truncation Error in Extreme Conditions > -Substantial errors arise from linear approximations in extreme near -field (dominated by M²

## ) or large strain conditions(dominated by sinh⁻¹

, ln).

① | ②
Highly Nonlinear | gradient of R and gradient of L has similar direction

## → Valid Only in Local Invertible Regions

ΔR
R0

## = α1ε + α2ε

2

ΔL
L0

= β1ε +

β2
d+d0

## k + β3ε ⋅ f(d)

Sensor Response under Complex(Strain/Proximity) Stimuli – Limitations of Analytical Inversion

## Analytical Models

Sensor Response under Complex(Strain/Proximity) Stimuli – Necessity of Deep Neural Network (DNN)

1. Mathematical Breakdown
-Jacobian singularities cause mathematical divergence and noise amplification
2. Severe Truncation Errors
-Fail in highly nonlinear regions
1. Divergence-Free Inference
-Pure forward-pass operations completely eliminate singularity risks
2. Global Nonlinear Mapping
-Universally approximates complex surfaces without piecewise errors
3. Zero Overhead & O(1) Latency
-Replaces heavy equations with lightweight MAC operations, guaranteeing microsecond latency on MCU
1. Physics-Guided Regularization
Embeds governing equations to constrain the weight space, strictly preventing non -physical predictions.
2. Robustness against OOD & Noise
Follows physical manifolds instead of wild extrapolation, perfectly preventing overfitting in unseen (Out -of-Distribution) regions.
3. Data Efficiency & Rapid Calibration
Maximizes generalization with a minimal dataset and dramatically reduces individual sensor calibration costs

## Deep Learning Model

## Physics Informed Neural Network(PINN) Model

LossTotal = LossData + λ ⋅ LossPhysics , LossPhysics =

1
N

## σ( ∆R − Rtheory(εො)

2

## + ∆L − Ltheory(εො, dመ)

2
)
3. Heavy Computational Overhead
-Iterative solvers and inverse matrix calculations severely overload the MCU's limited computing power and memory

# Discussion -Future Work

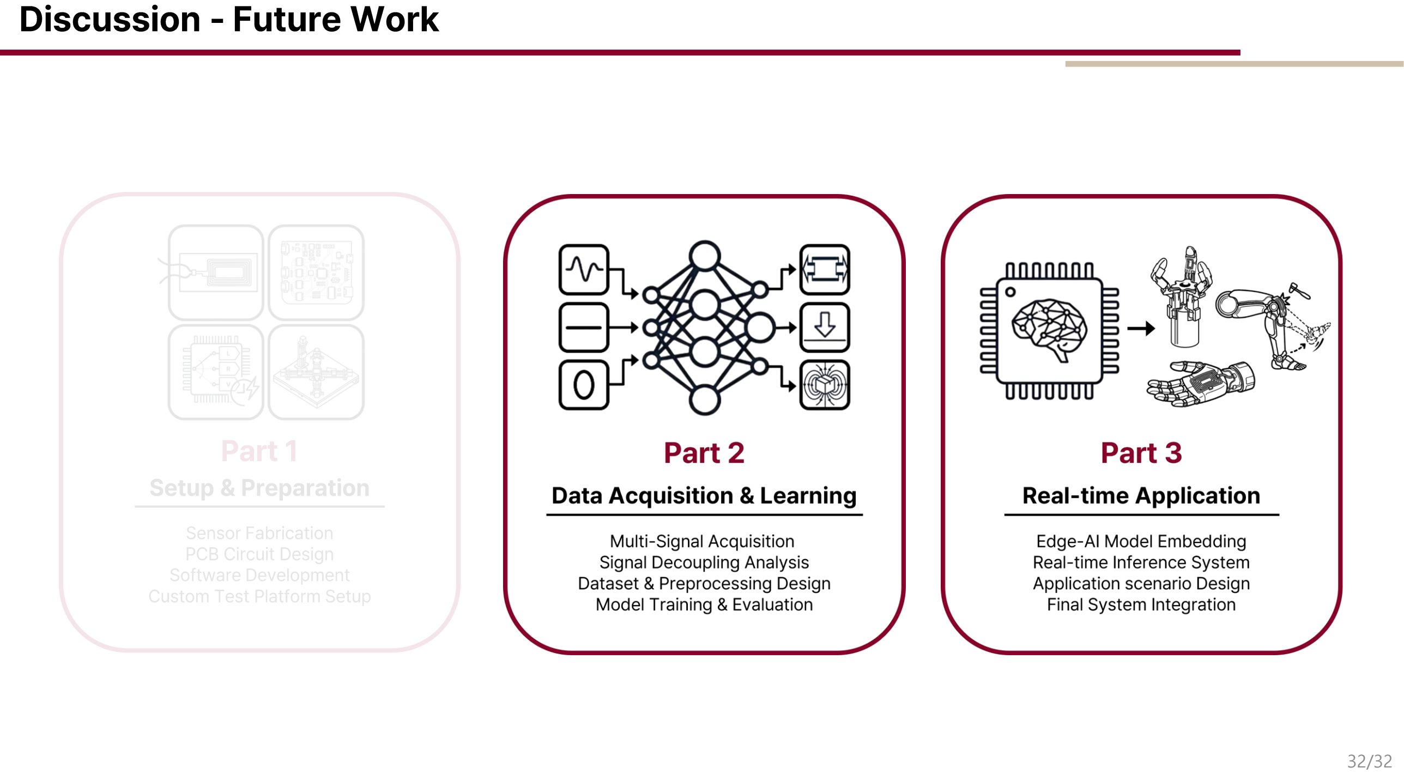
[picture p68: page 33]

## Part 1

## Setup & Preparation

Sensor Fabrication
PCB Circuit Design
Software Development
Custom Test Platform Setup

33

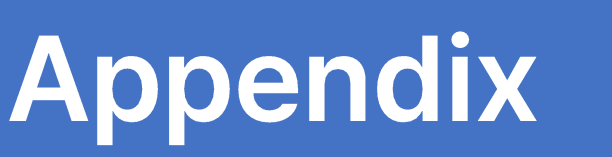
[picture p69: figure]
Appendix
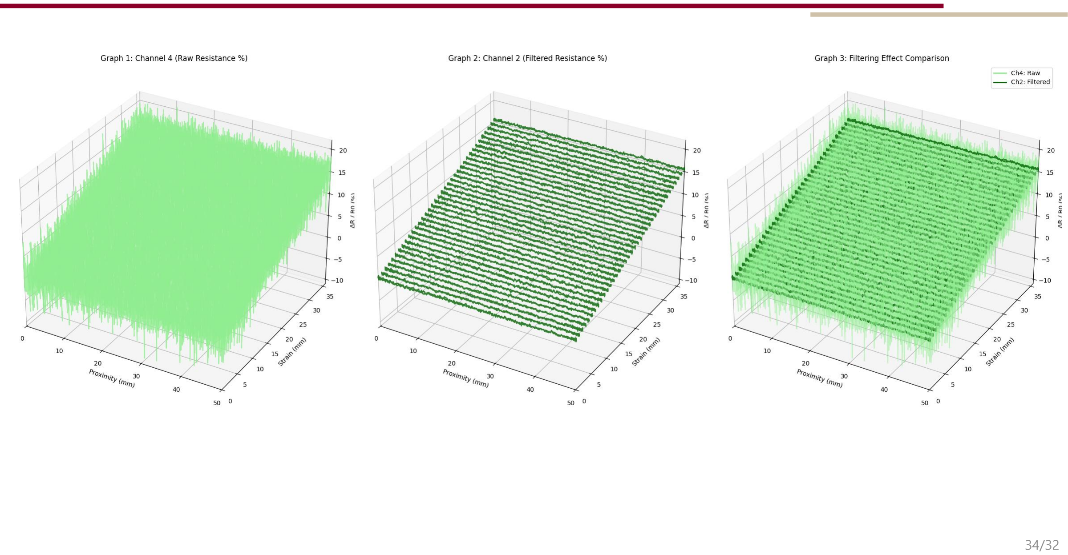
[picture p70: page 35]

# Software Development

## What is DMA(Direct Memory Access)?

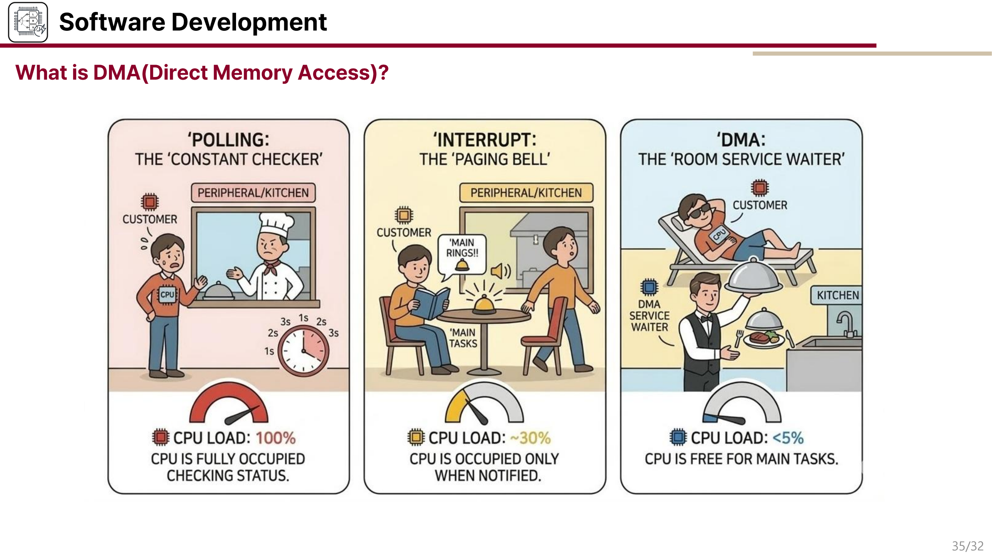
[picture p71: page 36]

## 중심점 이동

← CNC → | ← CNC →

## 인장 시

# Custom Test Platform Setup

## 테스트 장비 제작 이유 2. 2D-Strain Sensing in Rectangular Spiral Coil

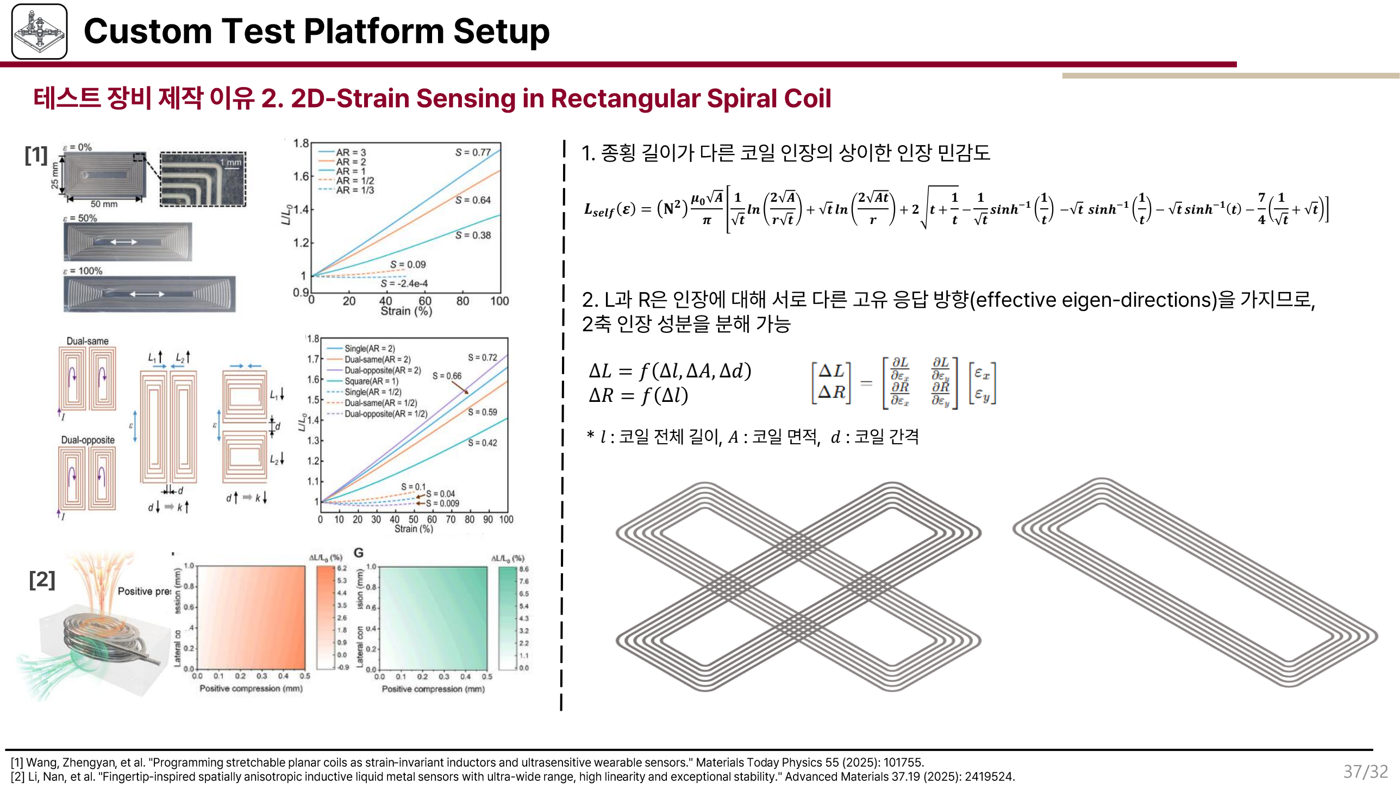
[picture p72: page 38]

[1]Wang, Zhengyan, et al. "Programming stretchable planar coils as strain -invariant inductors and ultrasensitive wearable sensors." Materials Tod ay Physics 55 (2025): 101755.
[2] Li, Nan, et al. "Fingertip‐inspired spatially anisotropic inductive liquid metal sensors with ultra‐wide range, high line | arity and exceptional stability." Advanced Materials 37.19 (2025): 2419524.

[1]

[2]

1. 종횡길이가다른코일인장의상이한인장민감도
2. L과R은인장에대해서로다른고유응답방향(effective eigen-directions)을가지므로, 2축인장성분을분해가능

∆L = f ∆l, ∆A, ∆d
∆R = f ∆l

* l : 코일전체길이, A : 코일면적, d : 코일간격

Lself ε = N

2

μ0 A
π

቎
1
t

ln

2 A
r t

+ t ln

2 At
r

+ 2 t +

1
t

−

1
t

sinh⁻1

1
t
− t sinh | ൨
−1

1
t

− t sinh⁻1
t −

7
4

1
t

+ t

# Custom Test Platform Setup

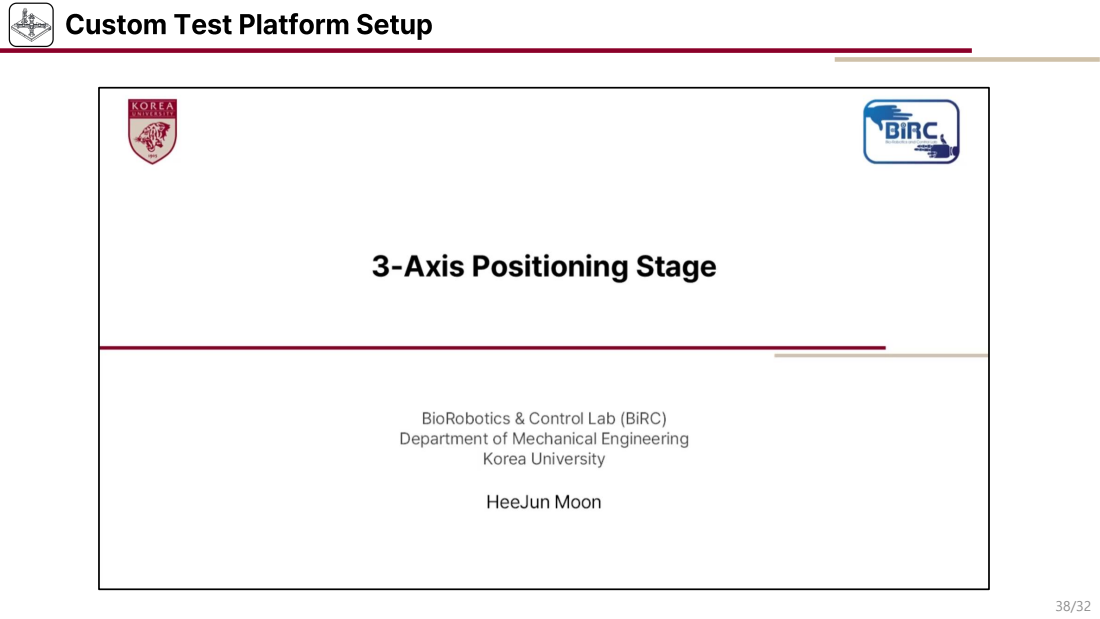
[picture p73: page 39]

## EMI 유입으로인한노이즈현상

# Future Works

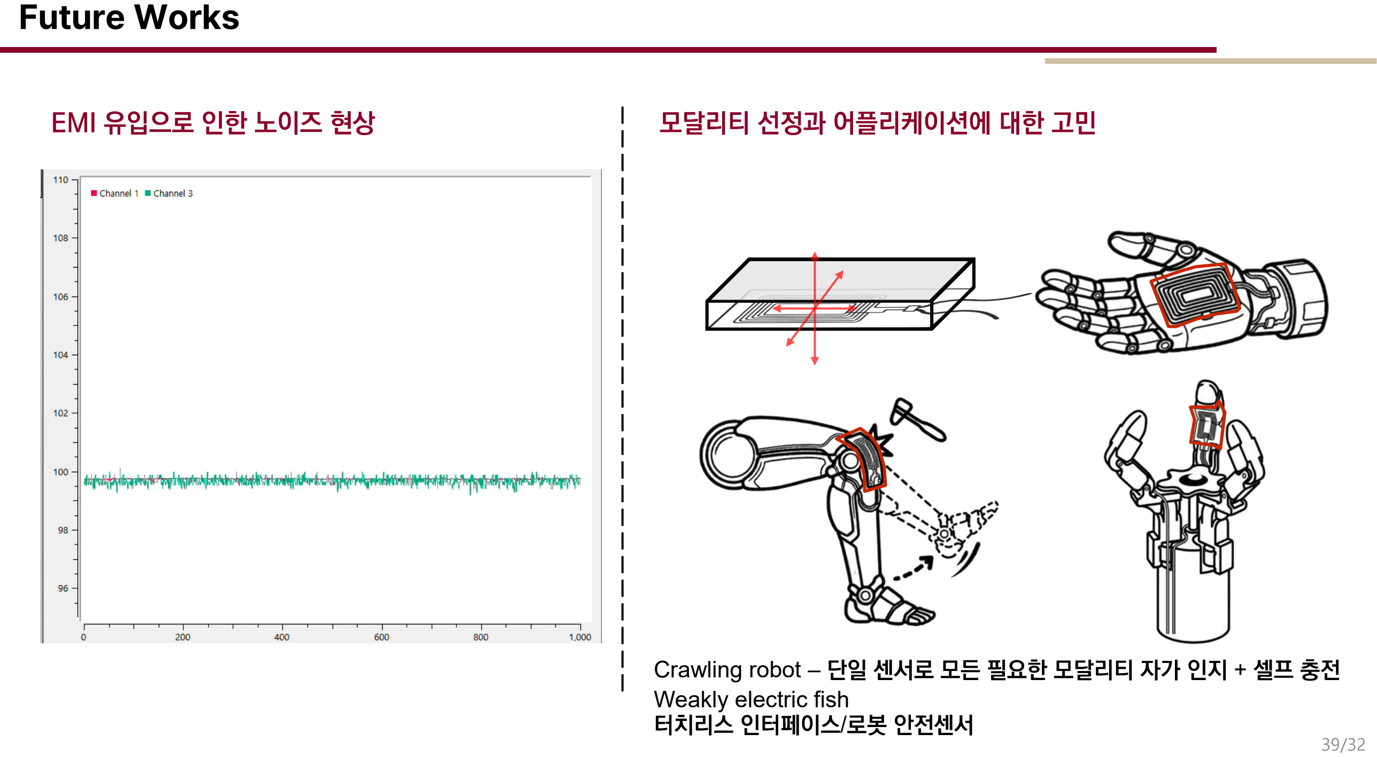
[picture p74: page 40]

## 모달리티선정과어플리케이션에대한고민

## Crawling robot – 단일센서로모든필요한모달리티자가인지+ 셀프충전

### Weakly electric fish

## 터치리스인터페이스/로봇안전센서

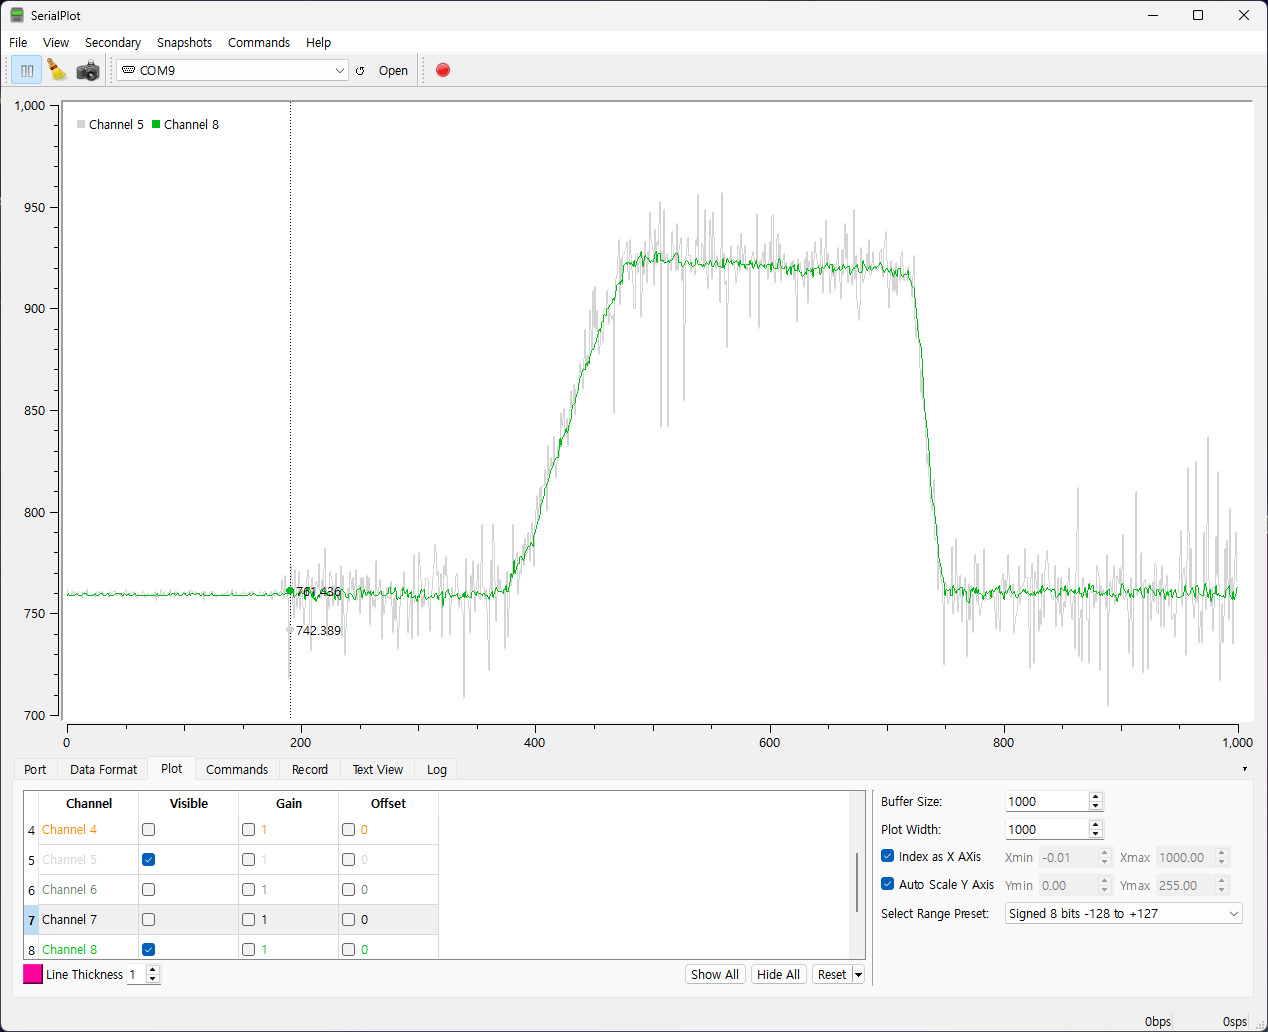
[picture p75: figure]

## PINN(Physics Informed Neurals)

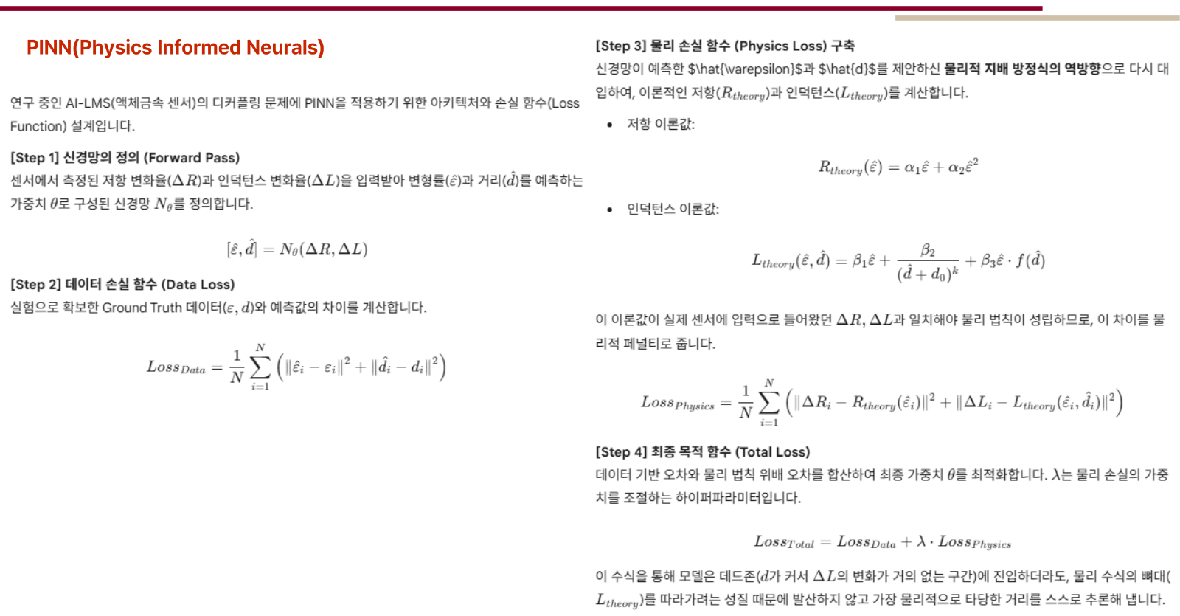
[picture p76: page 42]

41

# 푸바오가 돌아왔다

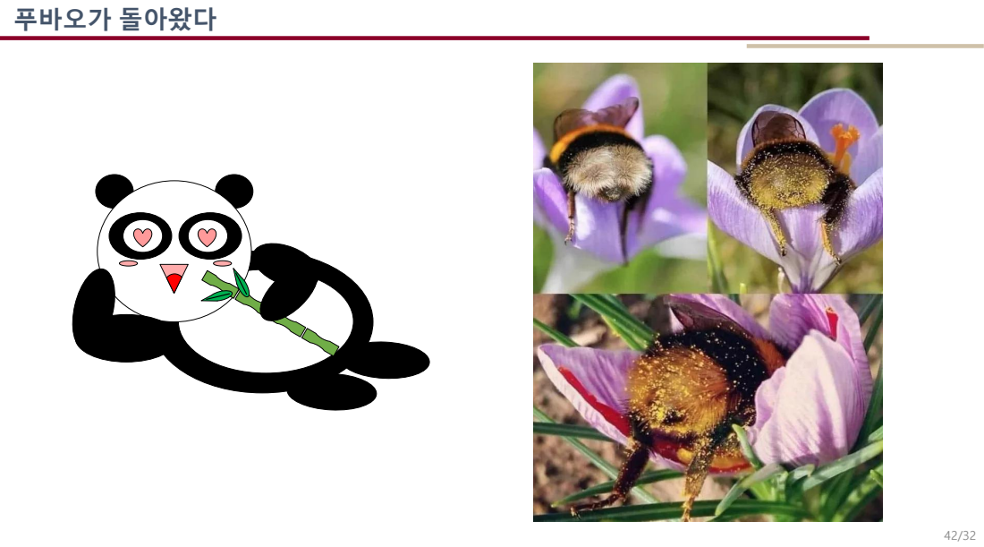
[picture p77: page 43]
