HeejunMoon53/MultimodalSensor/Paper/26.08.20_그룹미팅_문희준.pdf

HeeJun Moon

## 0. 연구 주제

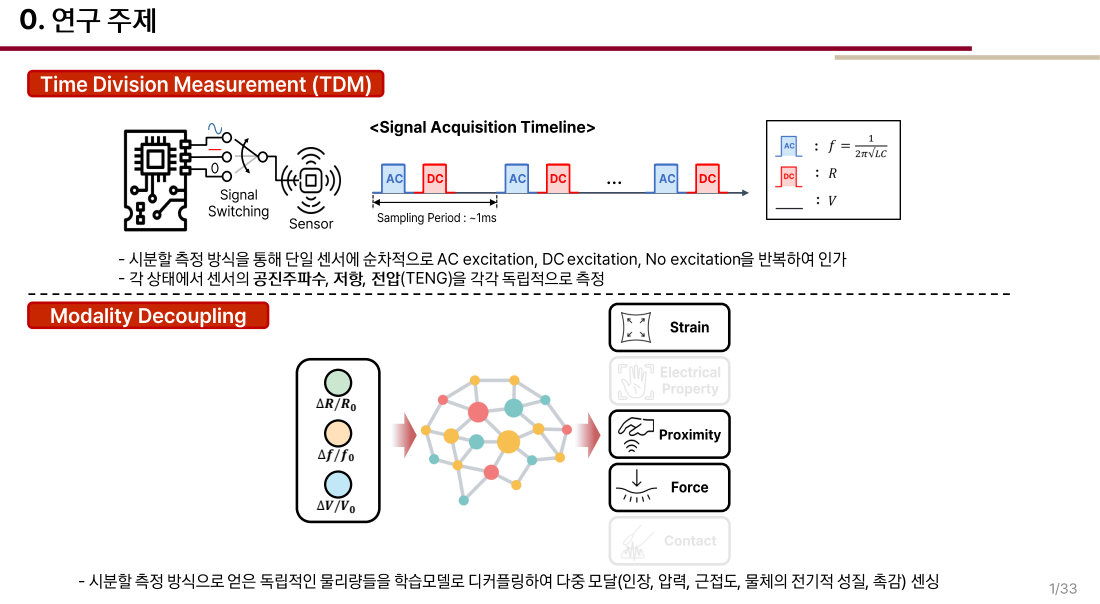
[picture p78: page 2]
Sampling Period : ~1ms; Sensor; Signal Switching; Modality Decoupling; Proximity; Strain; Electrical Property; Contact; Force

Time Division Measurement (TDM)

<Signal Acquisition Timeline>

-시분할측정방식을통해단일센서에순차적으로AC excitation, DCexcitation, No excitation을반복하여인가
-각상태에서센서의공진주파수, 저항, 전압(TENG)을각각독립적으로측정

-시분할측정방식으로얻은독립적인물리량들을학습모델로디커플링하여다중모달(인장, 압력, 근접도, 물체의전기적성질, 촉감) 센싱

## 0. Previous Work

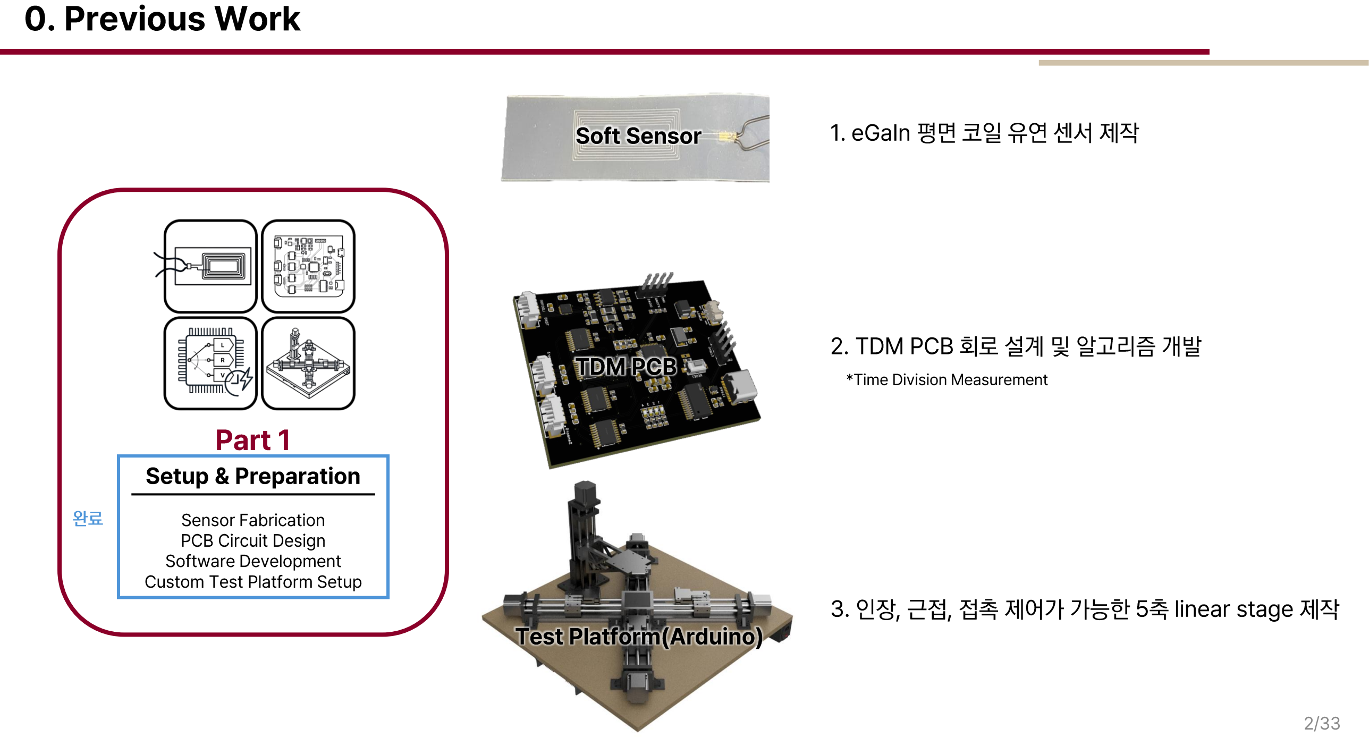
[picture p79: page 3]

Part 1
Setup & Preparation

Part 2

Data Acquisition & Learning

Part 3

Real-time Application

Sensor Fabrication
PCB Circuit Design
Software Development
Custom Test Platform Setup

Multi-Signal Acquisition
Signal Decoupling Analysis Dataset & Preprocessing Design Model Training & Evaluation

Edge-AI Model Embedding
Real-time Inference System Application scenario Design Final System Integration
완료 | 진행중

Test Platform(Arduino)

TDM PCB

Soft Sensor | 1. eGaIn평면코일유연센서제작
2. TDM PCB 회로설계및알고리즘개발
3. 인장, 근접, 접촉제어가가능한5축linear stage 제작

*Time Division Measurement

## 0. 실험 세팅

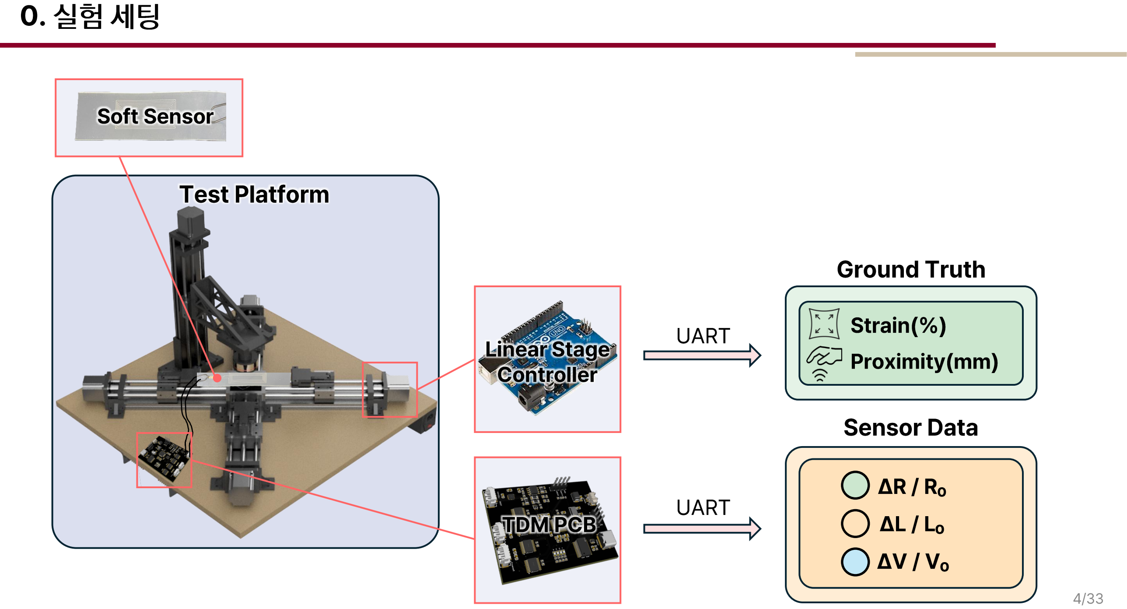
[picture p80: page 5]

Test Platform

TDM PCB

Soft Sensor

Linear Stage
Controller

Sensor Data

UART

UART

Strain(%)
Proximity(mm)

ΔR / R₀

ΔL / L₀

ΔV / V₀

Ground Truth

## 1. 데이터 수집

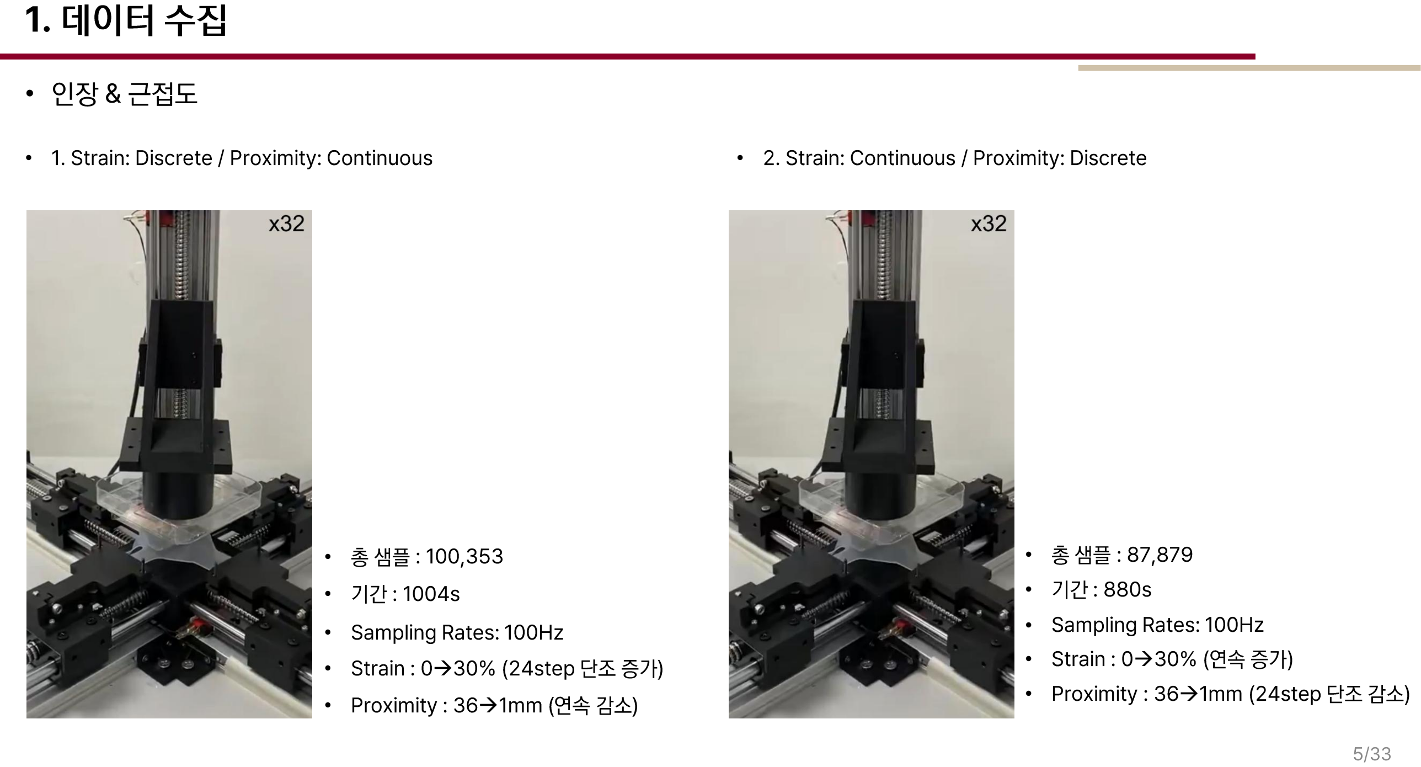
[picture p81: page 6]

- 인장& 근접도
- 1. Strain: Discrete / Proximity: Continuous | • 2. Strain: Continuous / Proximity: Discrete
- 총샘플: 100,353
- 기간: 1004s
- Sampling Rates:100Hz
- Strain : 0→30% (24step 단조증가)
- Proximity : 36→1mm (연속감소)
- 총샘플: 87,879
- 기간: 880s
- Sampling Rates:100Hz
- Strain : 0→30% (연속증가)
- Proximity : 36→1mm (24step단조감소)

## 1. 데이터 수집

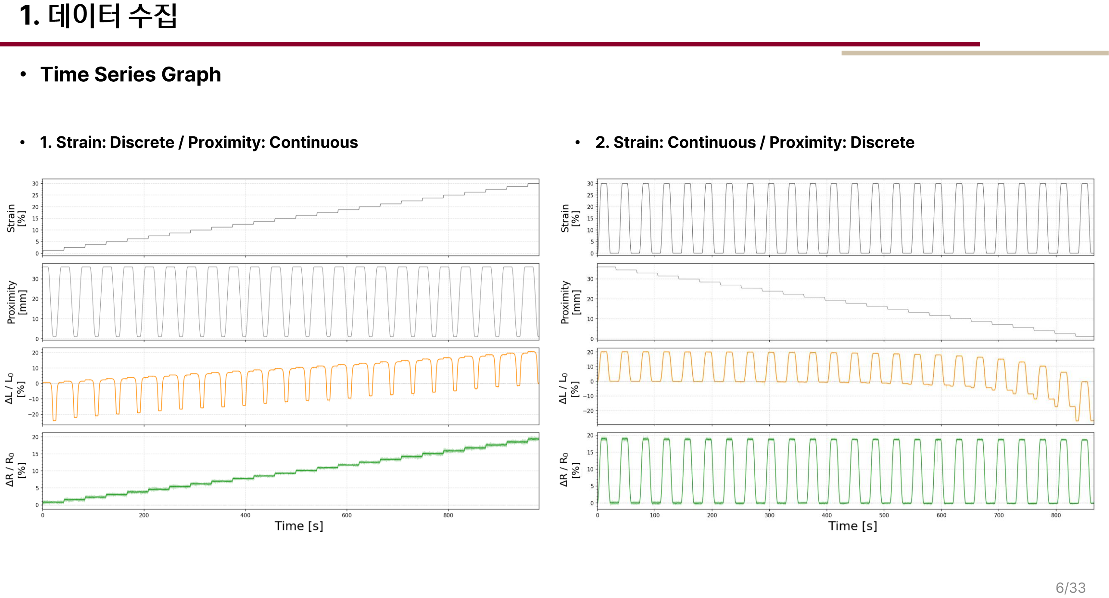
[picture p82: page 7]

- Time Series Graph
- 1. Strain: Discrete / Proximity: Continuous | • 2. Strain: Continuous / Proximity: Discrete

## 1. 데이터 수집

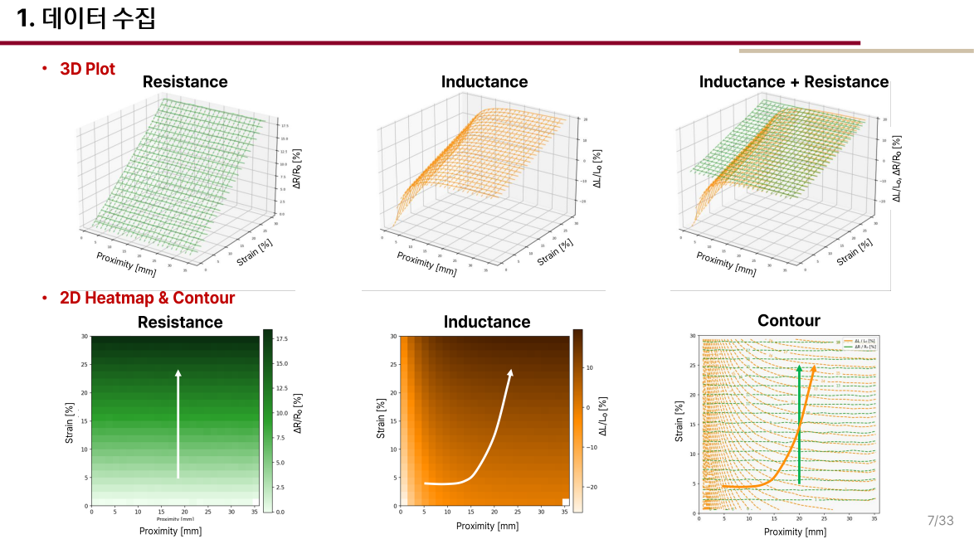
[picture p83: page 8]
Proximity [mm]; Strain [%]; Resistance; Contour; • 2D Heatmap & Contour; • 3D Plot; Inductance; Inductance + Resistance

## 2. 학습 및 검증

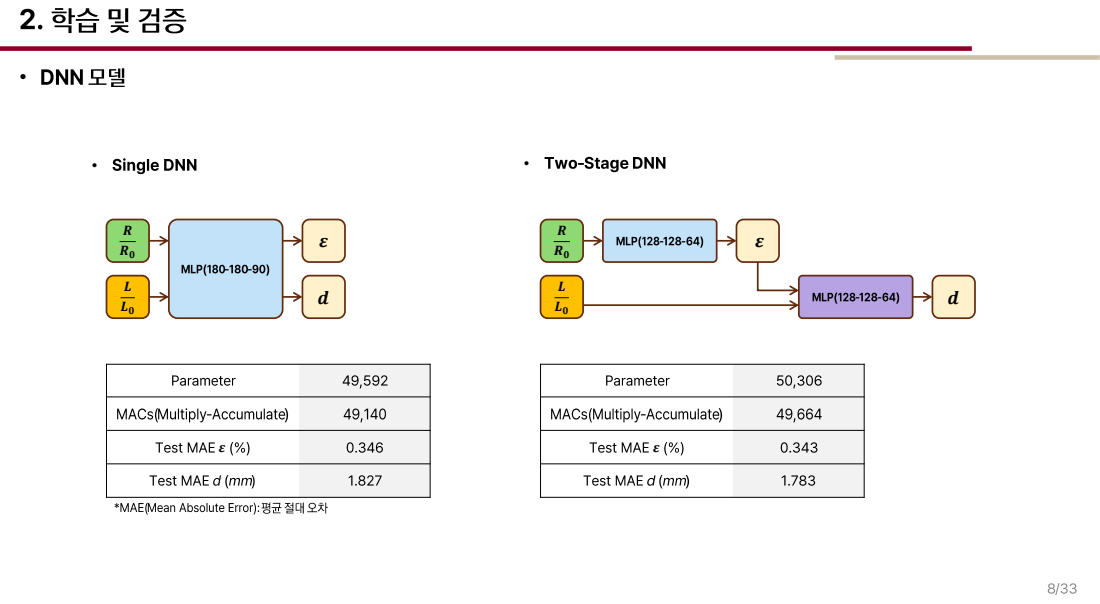
[picture p84: page 9]
• DNN 모델; • Single DNN; • Two-Stage DNN; MLP(180-180-90); MLP(128-128-64); Parameter; MACs(Multiply-Accumulate); Test MAE ε (%); Test MAE d (mm)

*MAE(Mean Absolute Error): 평균절대오차

## 2. 학습 및 검증

- 학습 결과

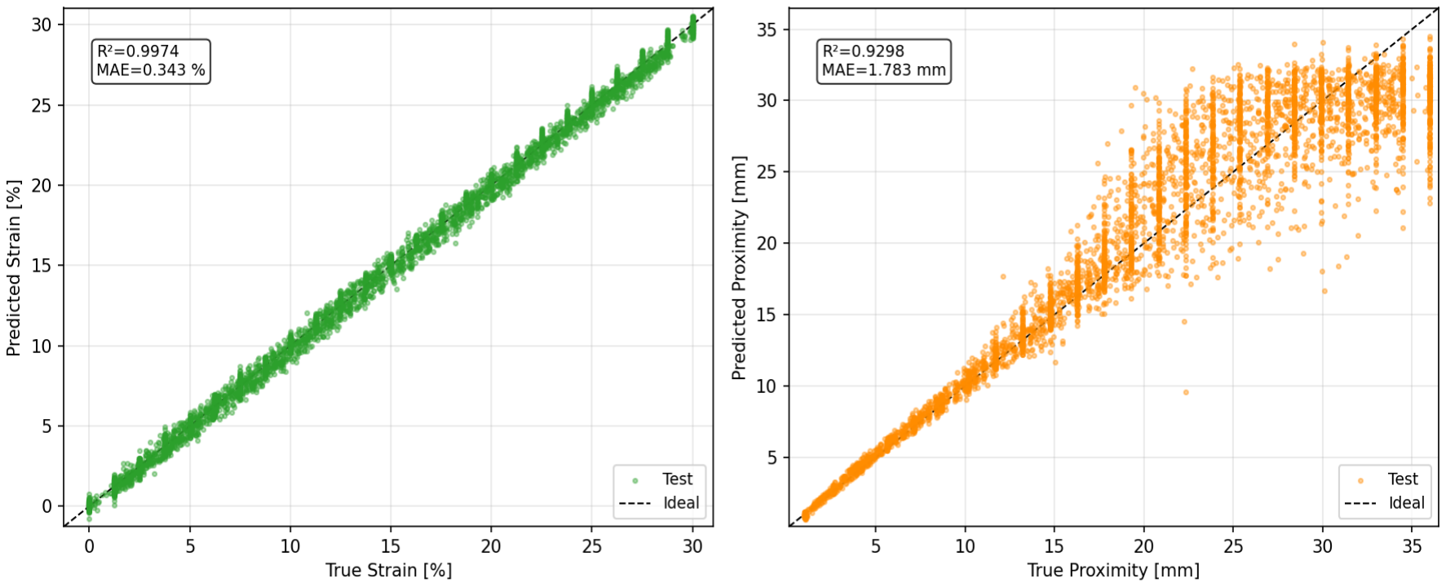
[picture p85: figure]

| Strain | Proximity
MAE | 0.3435% | 1.783mm
RMSE | 0.4319% | 2.772mm

R

2 | 0.9974 | 0.9298

Max
Error | 1.823% | 13.459mm
- 오차율
Strain | Proximity

## 3. 실시간 추론

- PC-based Realtime Decoupling

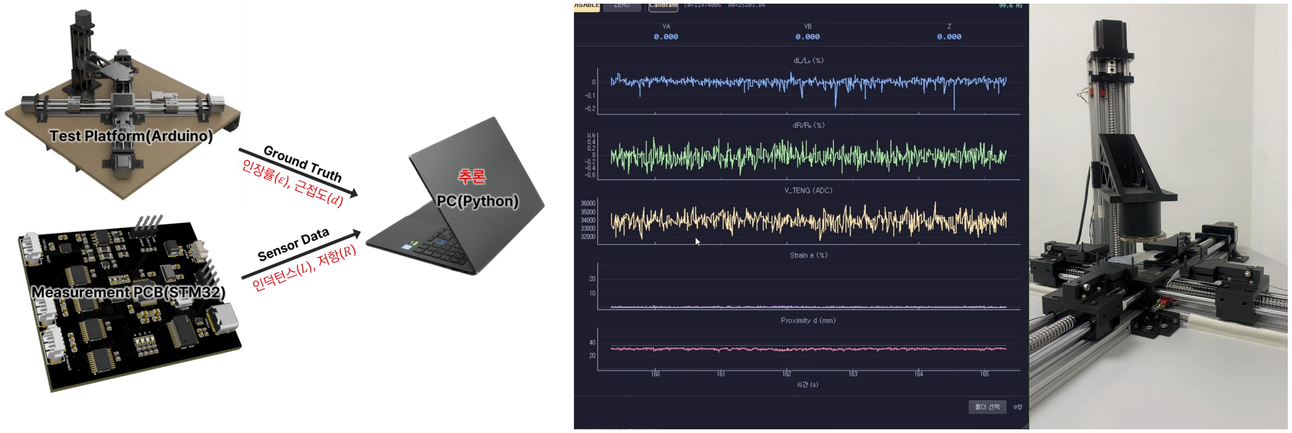
[picture p86: figure]

## 3. 실시간 추론

모달리티 | 구간 | 학습 추론 오차 | PC 실시간 추론 오차
Strain( ε) Proximity( d) | 전체 전체 d ≤ 15mm d ≤ 10mm | 0.3435% 1.783mm | 0.208% 1.438mm 0.145mm 0.096mm
모달리티 | 구간 | 학습 추론 오차 | PC 실시간 추론 오차
Strain( ε) Proximity( d) | 전체 전체 d ≤ 15mm d ≤ 10mm | 0.4319% 2.772mm | 0.272% 2.273mm 0.203mm 0.133mm

MAE

RMSE

## 4. EI Embedding

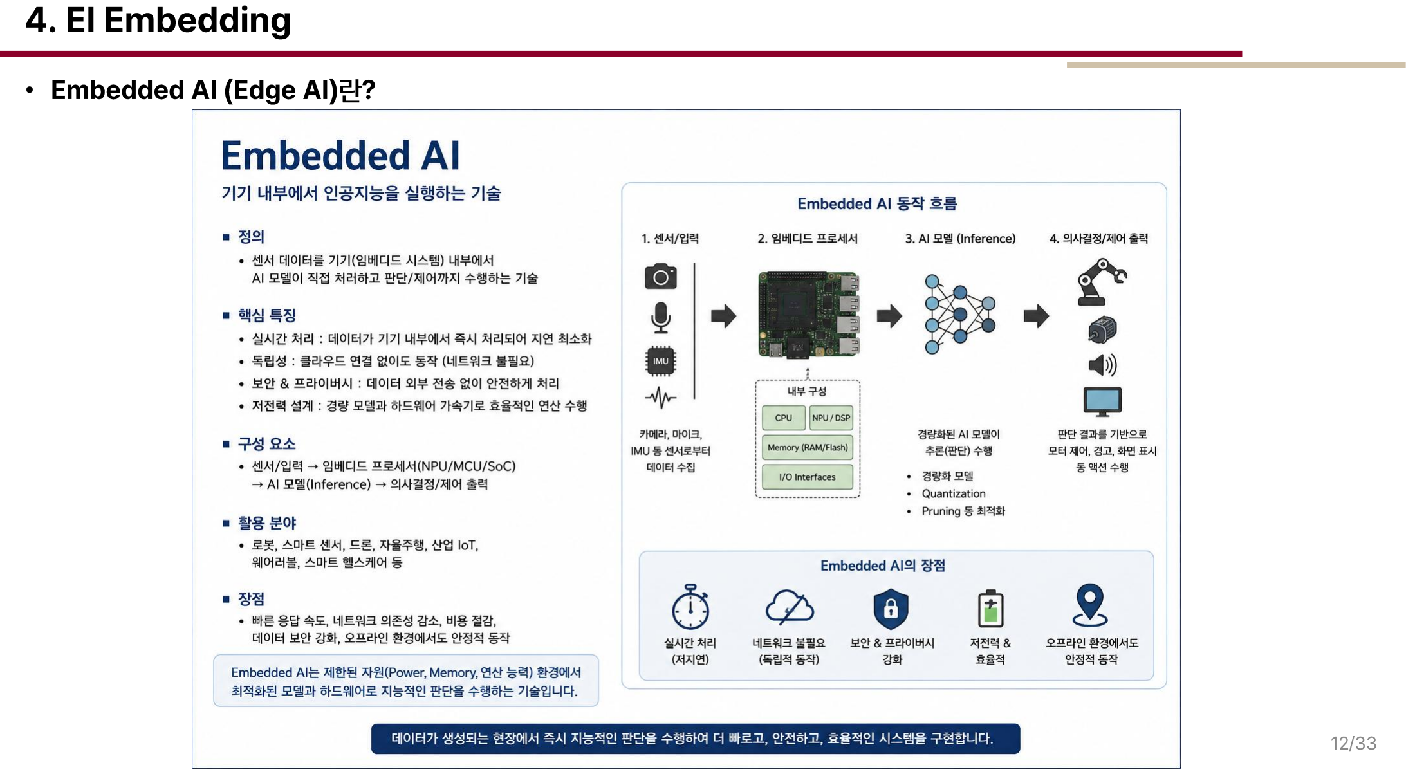
[picture p87: page 13]

- Embedded AI (Edge AI)란?

quantize

## 4. EI Embedding

- 배포 파이프라인

sklearn
float32

ONNX
float32

ONNX
int8

STM32 C
Cortex-M4F
128KB
export | X-CUBE-AI
- 모델 파라미터 최적화→ 메모리사용량, 연산량, 추론속도개선
S1 구조 | S2 구조 | 파라미터 | INT8
| | | FLASH | MACS | MAE ε (%) | MAE D
| | | | | | (mm) | MAE D≤15
| | | | | | | (mm)
1→4→1 | 2→8→1 | 46 | 46 B | 32 | 0.3810 | 2.1149 | 0.8058
1→8→1 | 2→16→1 | 90 | 90 B | 64 | 0.3630 | 2.1102 | 0.7810
1→8→1 | 2→32→1 | 154 | 154 B | 112 | 0.3680 | 1.9779 | 0.5610
1→4→4→1 | 2→8→8→1 | 138 | 138 B | 112 | 0.3518 | 1.8368 | 0.3943
1→16→1 | 2→16→8→1 | 242 | 242 B | 200 | 0.3514 | 1.8016 | 0.3476
1→16→8→1 | 2→16→8→1 | 370 | 370 B | 320 | 0.3493 | 1.7978 | 0.3463
1→16→8→1 | 2→32→16→1 | 818 | 818 B | 744 | 0.3491 | 1.7822 | 0.3217
1→8→1 | 2→32→16→1 | 666 | 666 B | 608 | 0.3496 | 1.7850 | 0.3258
1→16→8→1 | 2→64→32→1 | 2,482 | 2.4 KB | 2,360 | 0.3491 | 1.7813 | 0.3165
1→32→16→1 | 2→64→32→1 | 2,914 | 2.8 KB | 2,768 | 0.3519 | 1.7792 | 0.3118
1→16→8→4→1 2→32→16→8→1 | 978 | 978 B | 892 | 0.3515 | 1.7651 | 0.3222
1→16→8→1 | 2→128→64→1 | 8,882 | 8.7 KB | 8,664 | 0.3497 | 1.7735 | 0.3177
1→64→32→1 | 2→128→64→1 | 10,946 | 10.7 KB | 10,656 | 0.3490 | 1.7730 | 0.3133
1→128→128→6 4→1 | 2→128→128→6
| 4→1 | 50,306 | 52KB | 49,664 | 0.3435 | 1.7830 | 0.3009

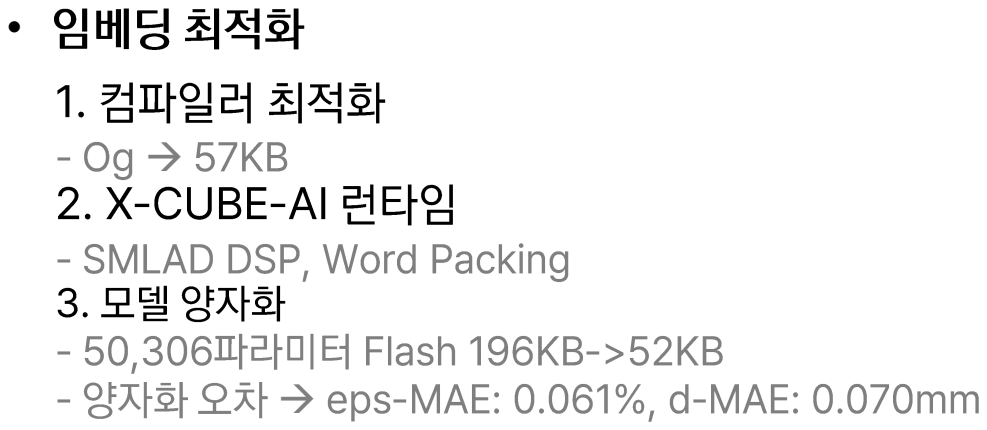
[picture p88: figure]
• 임베딩 최적화; 1. 컴파일러최적화 -Og → 57KB 2. X-CUBE-AI 런타임 -SMLAD DSP, Word Packing 3. 모델양자화 -50,306파라미터Flash 196KB->52KB -양자화오차→ eps-MAE: 0.061%, d-MAE: 0.070mm

## 4. EI Embedding

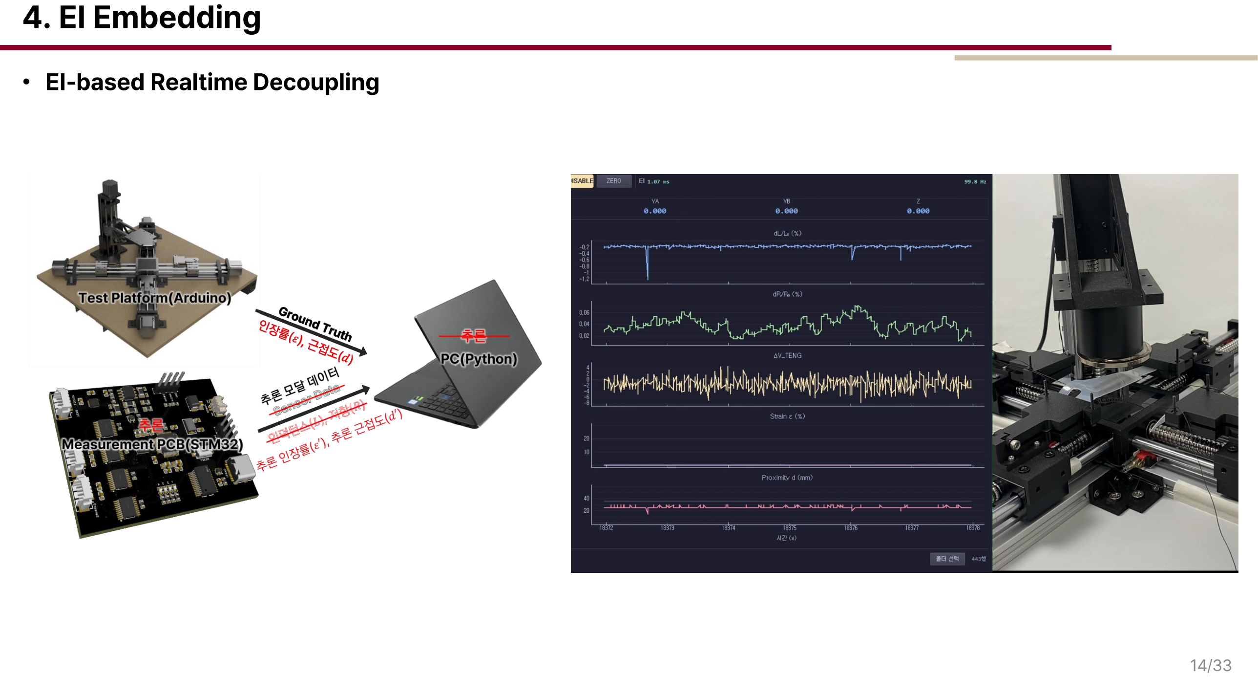
[picture p89: page 15]

- EI-based Realtime Decoupling

## 4. EI Embedding

모달리티 | 구간 | 학습 추론 오차 | PC 실시간 추론 오차 | EI 실시간 추론 오차
Strain( ε) Proximity( d) | 전체 전체 d ≤ 15mm d ≤ 10mm | 0.3435% 1.783mm | 0.208% 1.438mm 0.145mm 0.096mm | 0.422% 2.281mm 0.867mm 0.669mm
모달리티 | 구간 | 학습 추론 오차 | PC 실시간 추론 오차 | EI 실시간 추론 오차
Strain( ε) Proximity( d) | 전체 전체 d ≤ 15mm d ≤ 10mm | 0.4319% 2.772mm | 0.272% 2.273mm 0.203mm 0.133mm | 0.519% 3.971mm 1.040mm 0.724mm

MAE

RMSE

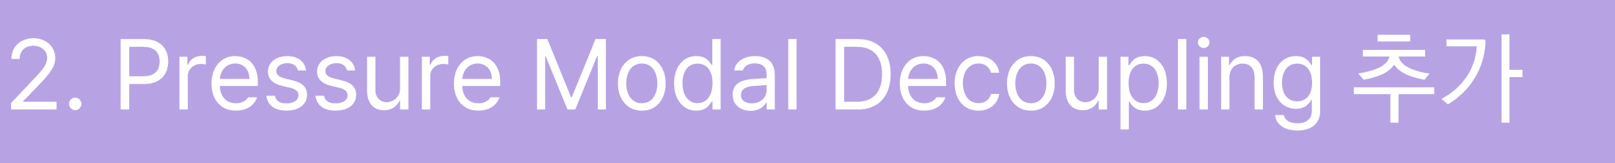
[picture p90: figure]
2. Pressure Modal Decoupling 추가

## 0. 실험 세팅 – F/T 센서 추가

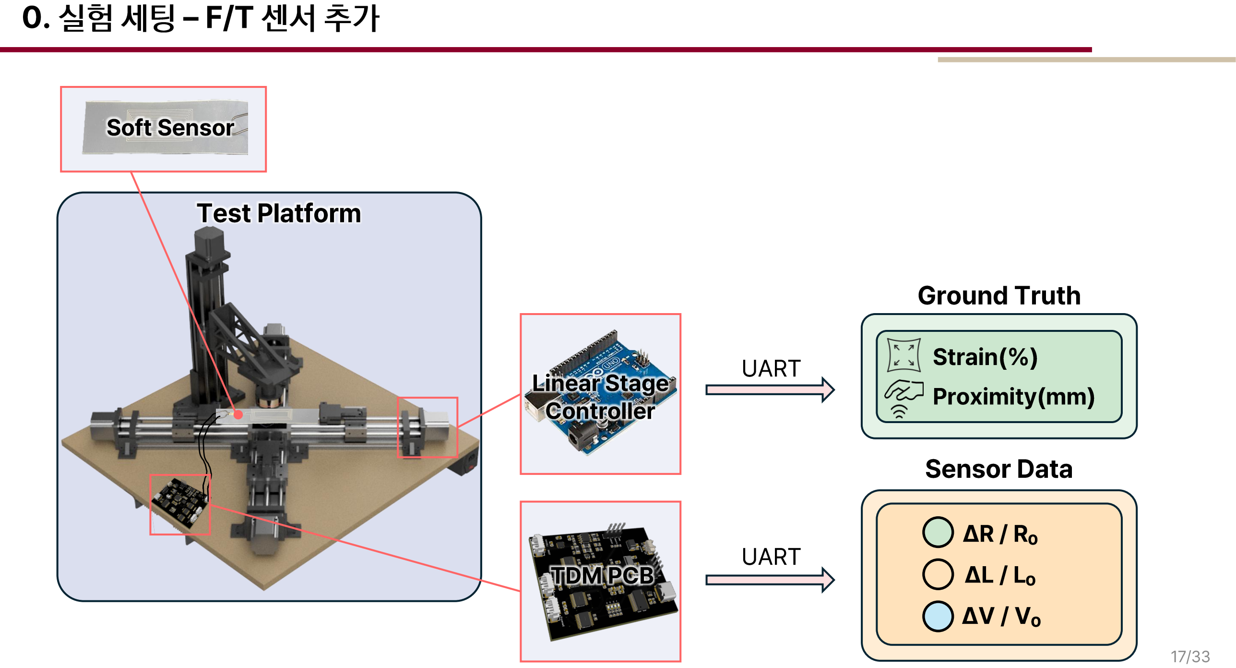
[picture p91: page 18]

Sensor Data

TDM PCB

UART

UART

Strain(%)
Proximity(mm)

ΔR / R₀

ΔL / L₀

ΔV / V₀

Soft Sensor

Test Platform

Linear Stage
Controller

Ground Truth

## 0. 실험 세팅 – F/T 센서 추가

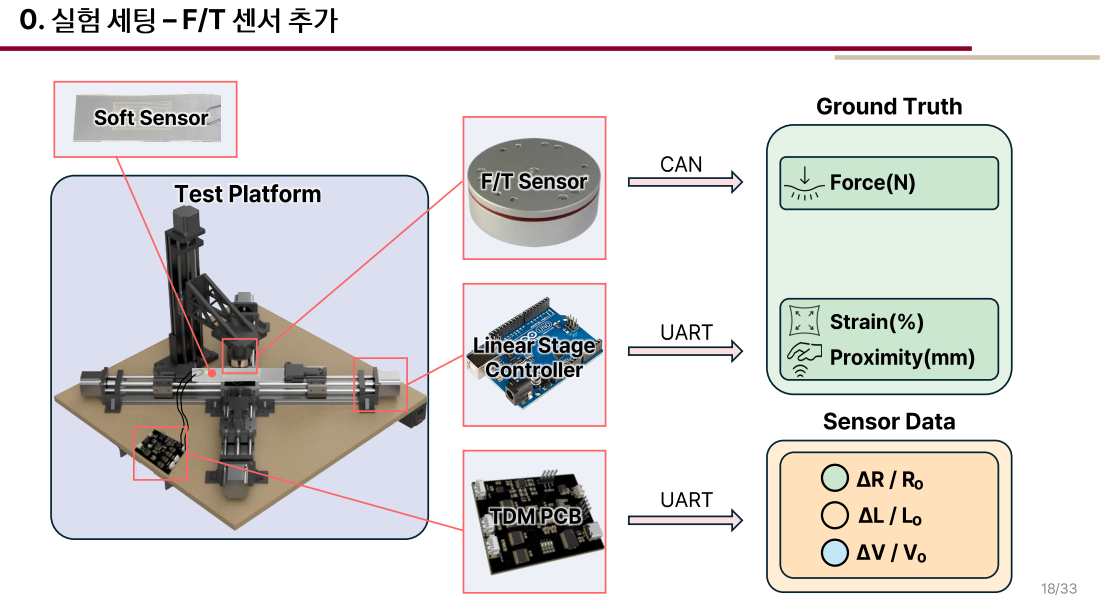
[picture p92: page 19]
Ground Truth; Sensor Data; TDM PCB; UART; Strain(%); Proximity(mm); Soft Sensor; Test Platform; Linear Stage Controller; F/T Sensor; CAN; Force(N)

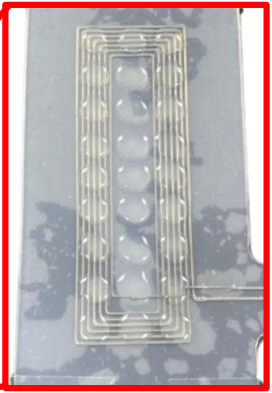
[picture p93: figure]

- 돌기구조 추가

## 0. 센서 구조 변경

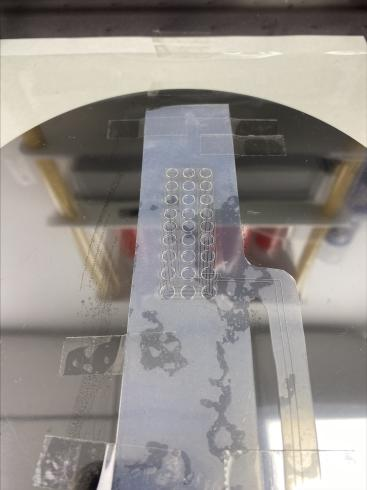
[picture p94: figure]
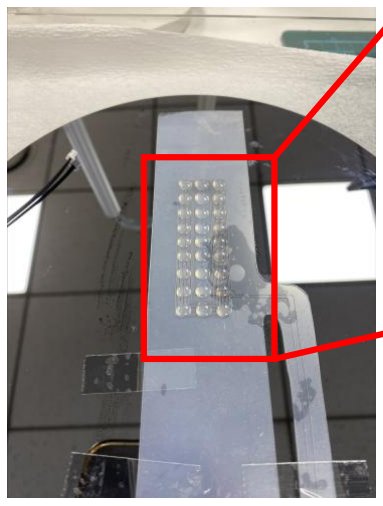
[picture p95: figure]

ΔR/R0

100%

20N

F | F 210 N

ΔR/R0

100%

- 필름마스킹, 어플리케이터를이용하여균일한직경(5mm)및높이(0.5mm)의돌기구조제작

## 1. 데이터셋 취득

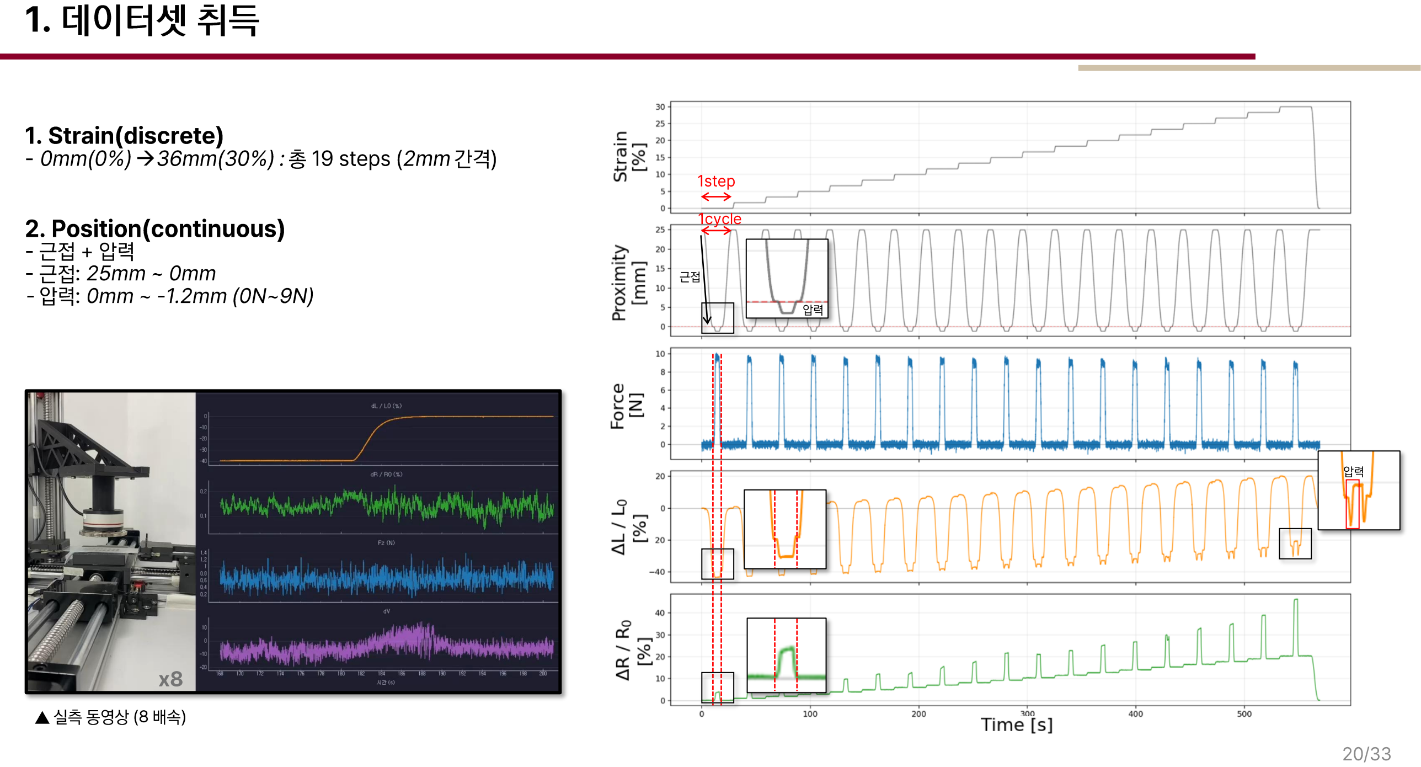
[picture p96: page 21]

1step

1cycle

근접

압력

압력

▲ 실측동영상(8 배속)

x8

1. Strain(discrete)
-0mm(0%) →36mm(30%) : 총19 steps (2mm 간격)
2. Position(continuous)
-근접+ 압력
-근접: 25mm ~ 0mm
-압력: 0mm ~ -1.2mm (0N~9N)

## 1. 데이터셋 취득

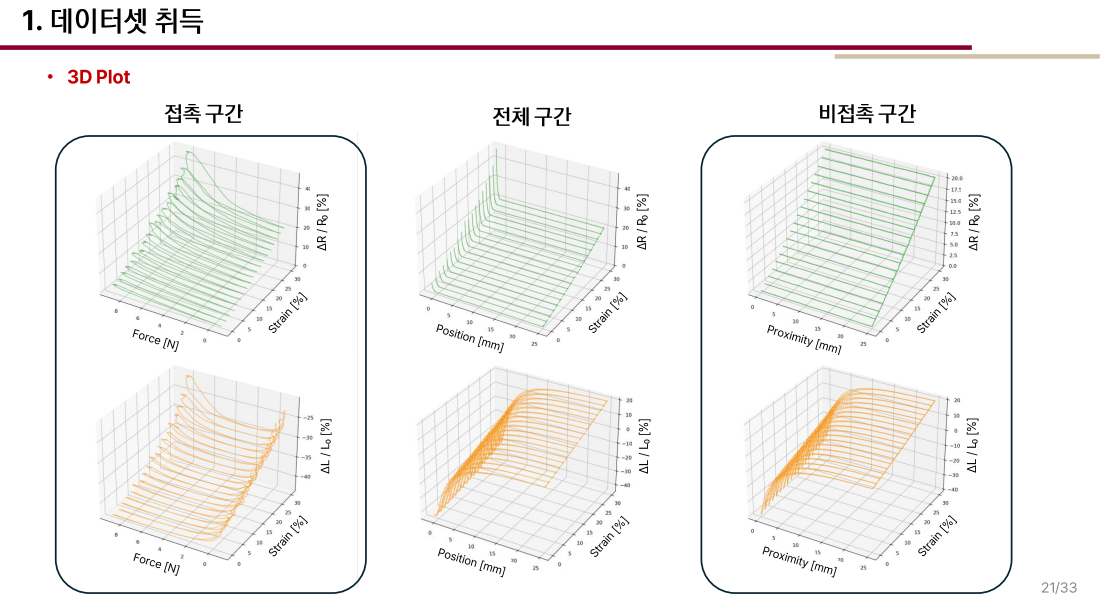
[picture p97: page 22]
비접촉 구간; • 3D Plot

## 1. 데이터셋 취득

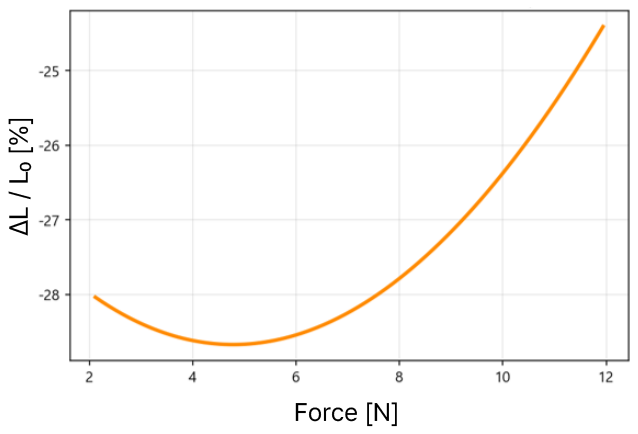
[picture p98: figure]
Force [N]

실제공진주파수: f =

1
2π LC

× 1 −

1
Q²

근사공진주파수: f ≈

1
2π LC

→ 인덕턴스계산: ΔL
L0

=

f0

2
f

2 − 1

-압축시에는Q가작아지면서실제공진주파수감소→ L을 근사 공진주파수로 역산하는 과정에서 L이 증가하는 것처럼 보임

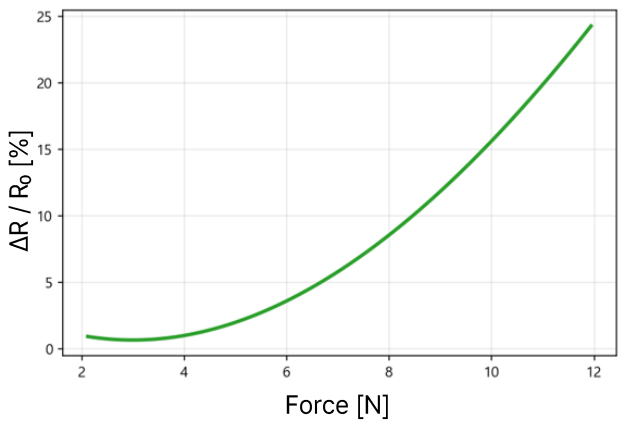
[picture p99: figure]
Force [N]

Q = ω ∗

Maximum Stored Energy
Energy Dissipated per Cycle =

X
Rs

=

ωL
Rs

-센서압축시에, L 감소, RDC, Reddy 증가 → Q-factor 급감

* Quality-factor

- 인덕턴스가 왜 증가하는가?

* 인덕턴스 측정방법

DNN으로디커플링→ Q 역산보정필요X

## 2. 학습 및 검증

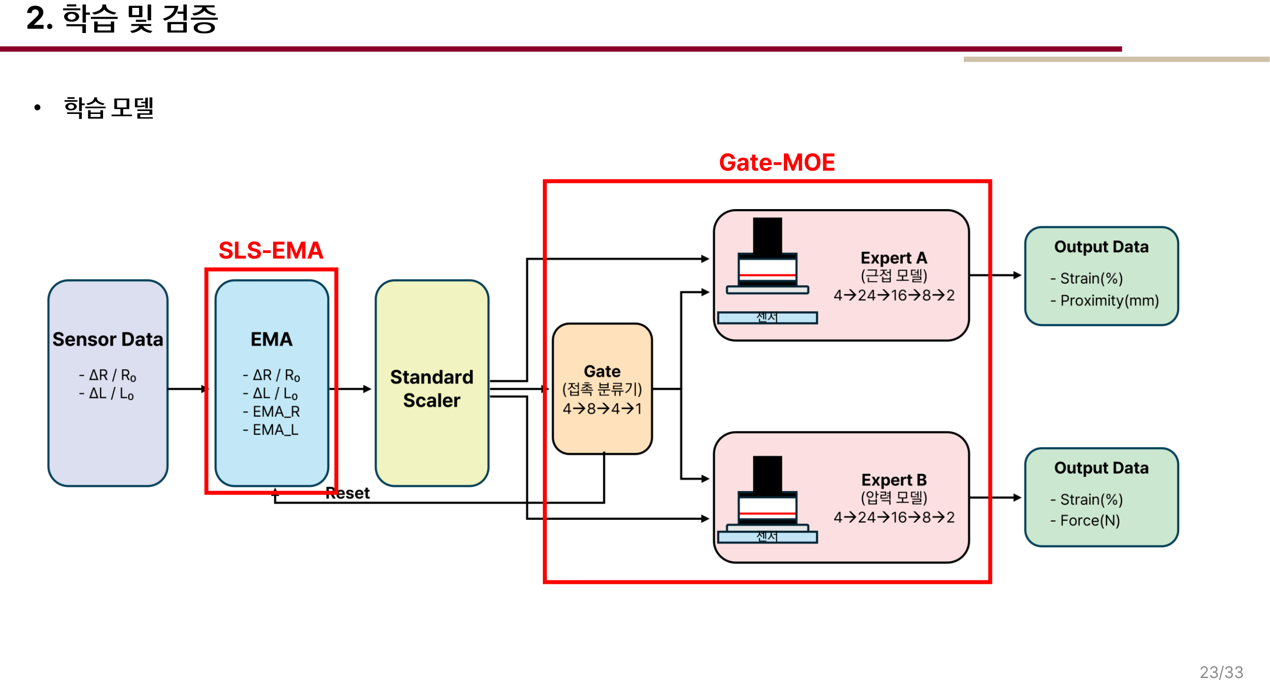
[picture p100: page 24]

- 학습 모델

SLS-EMA

Gate-MOE

## 2. 학습 및 검증

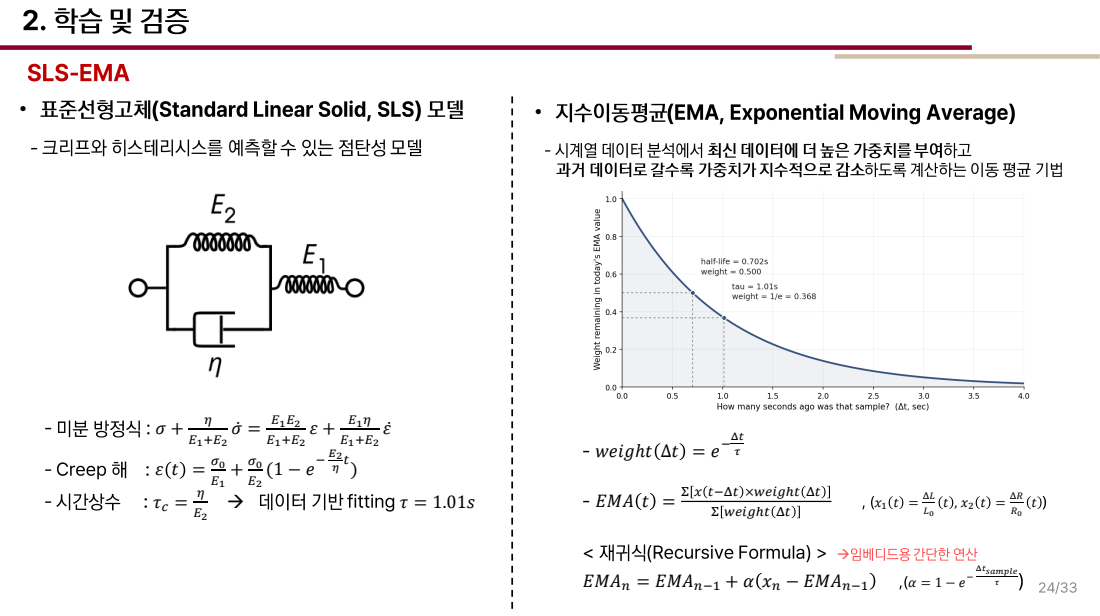
[picture p101: page 25]
-크리프와히스테리시스를예측할수있는점탄성모델; -미분방정식: σ +; -Creep 해 : ε t =; -시간상수 : τc =; → 데이터기반fitting τ = 1.01s; -EMA t =; x t−Δt ×weigℎt Δt; weigℎt Δt; -weigℎt Δt = e; EMAn = EMAn−1 + α xn − EMAn−1; Δtsample

SLS-EMA
• 표준선형고체(Standard Linear Solid, SLS) 모델

• 지수이동평균(EMA, Exponential Moving Average)

-시계열데이터분석에서최신 데이터에 더 높은 가중치를 부여하고
과거 데이터로 갈수록 가중치가 지수적으로 감소하도록계산하는이동평균기법

< 재귀식(RecursiveFormula)> →임베디드용간단한연산

Gate-MOE (Mixture of Experts)

## 2. 학습 및 검증

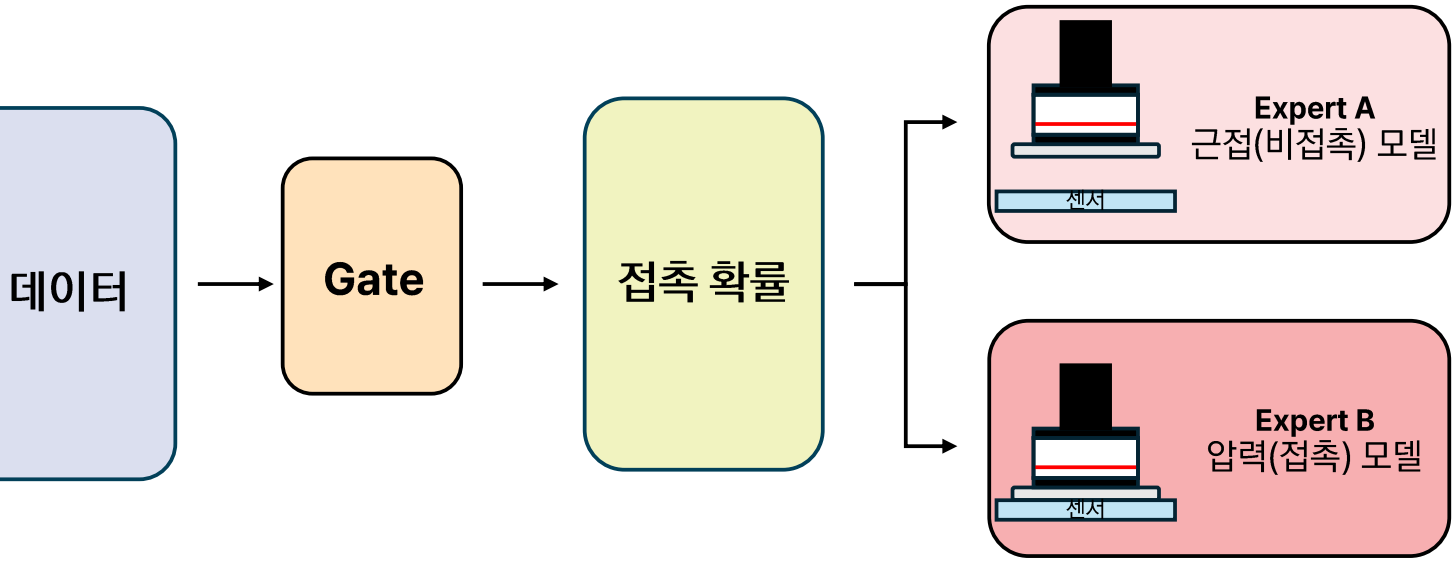
[picture p102: figure]
데이터; Gate; Expert A 근접(비접촉) 모델; Expert B 압력(접촉) 모델
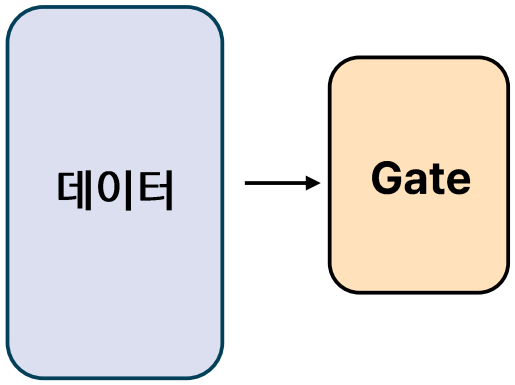
[picture p103: figure]

## 2. 학습 및 검증

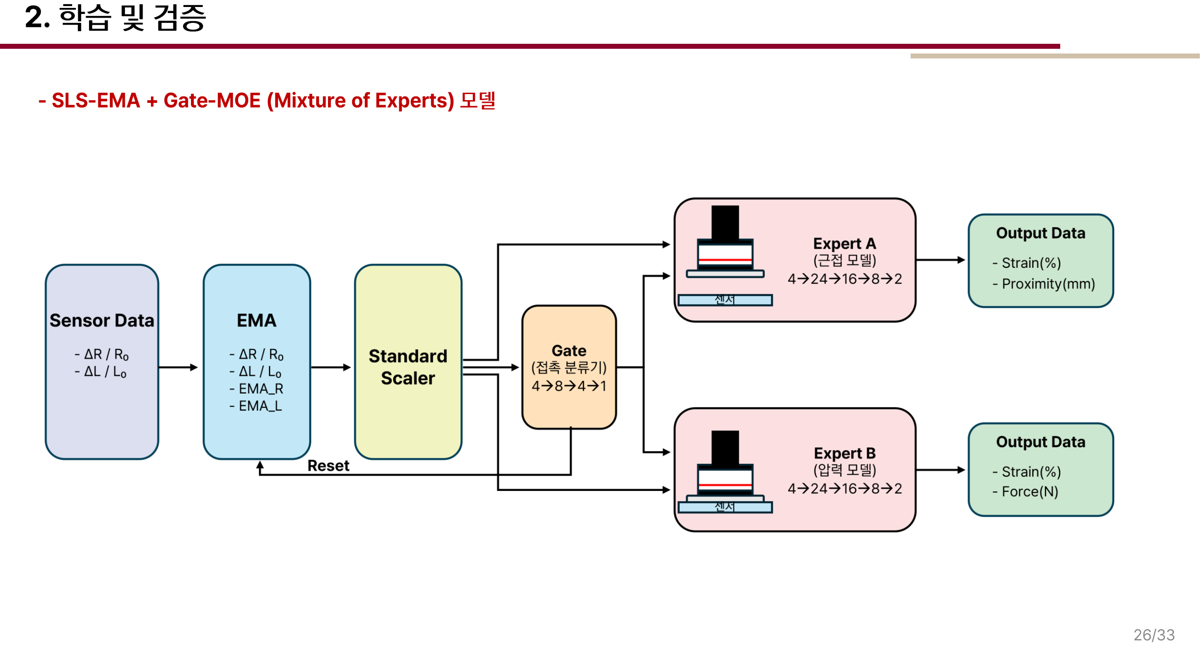
[picture p104: page 27]

-SLS-EMA + Gate-MOE (Mixture of Experts) 모델

## 2. 학습 및 검증

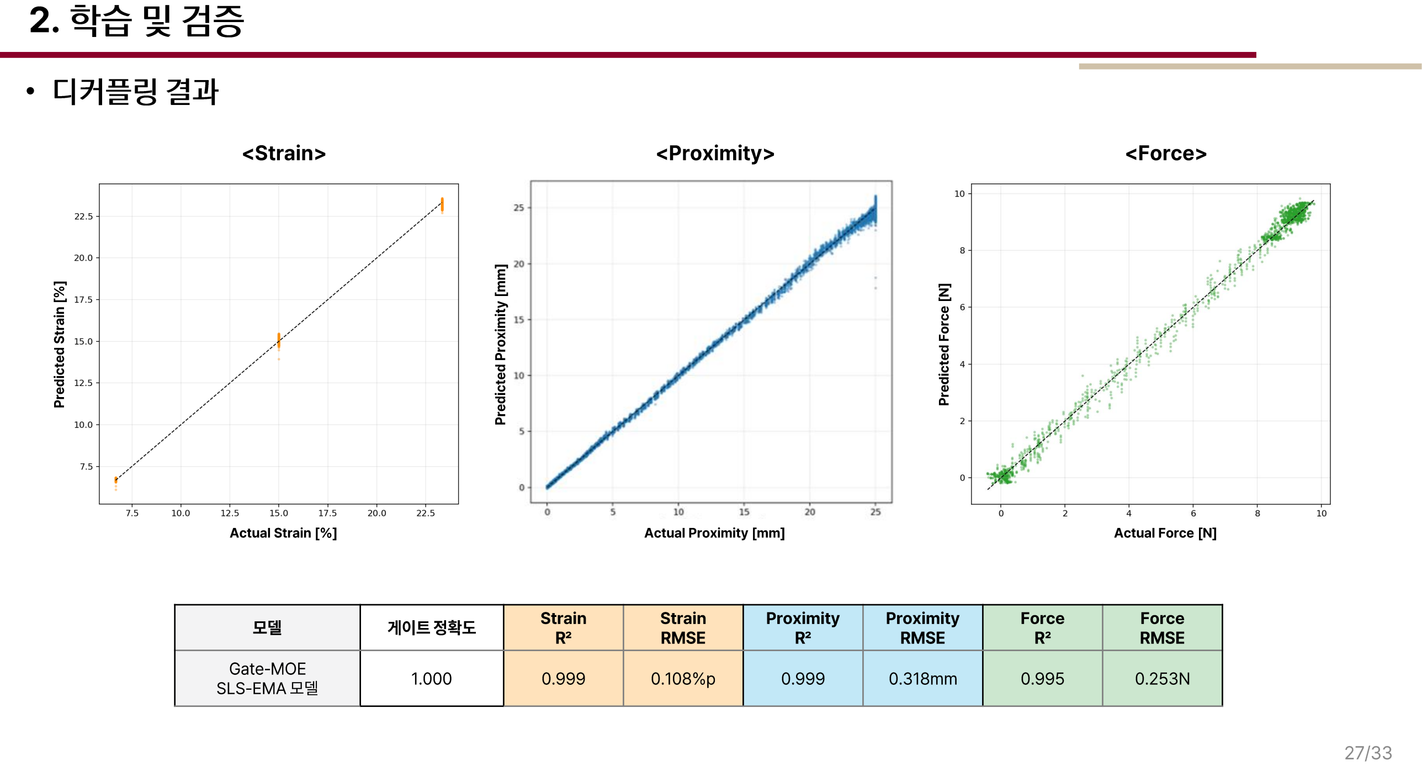
[picture p105: page 28]

- 디커플링 결과
<Strain> | <Proximity> | <Force>

Actual Strain [%]

Predicted Strain [%]

Actual Proximity [mm]

Predicted Proximity [mm]

Actual Force [N]

Predicted Force [N]

모델 | 게이트 정확도 | Strain R | Strain RMSE | Proximity R | Proximity RMSE | Force R | Force RMSE
Gate-MOE SLS-EMA 모델 | 1.000 | 0.999 | 0.108%p | 0.999 | 0.318mm | 0.995 | 0.253N

## 2. 학습 및 검증

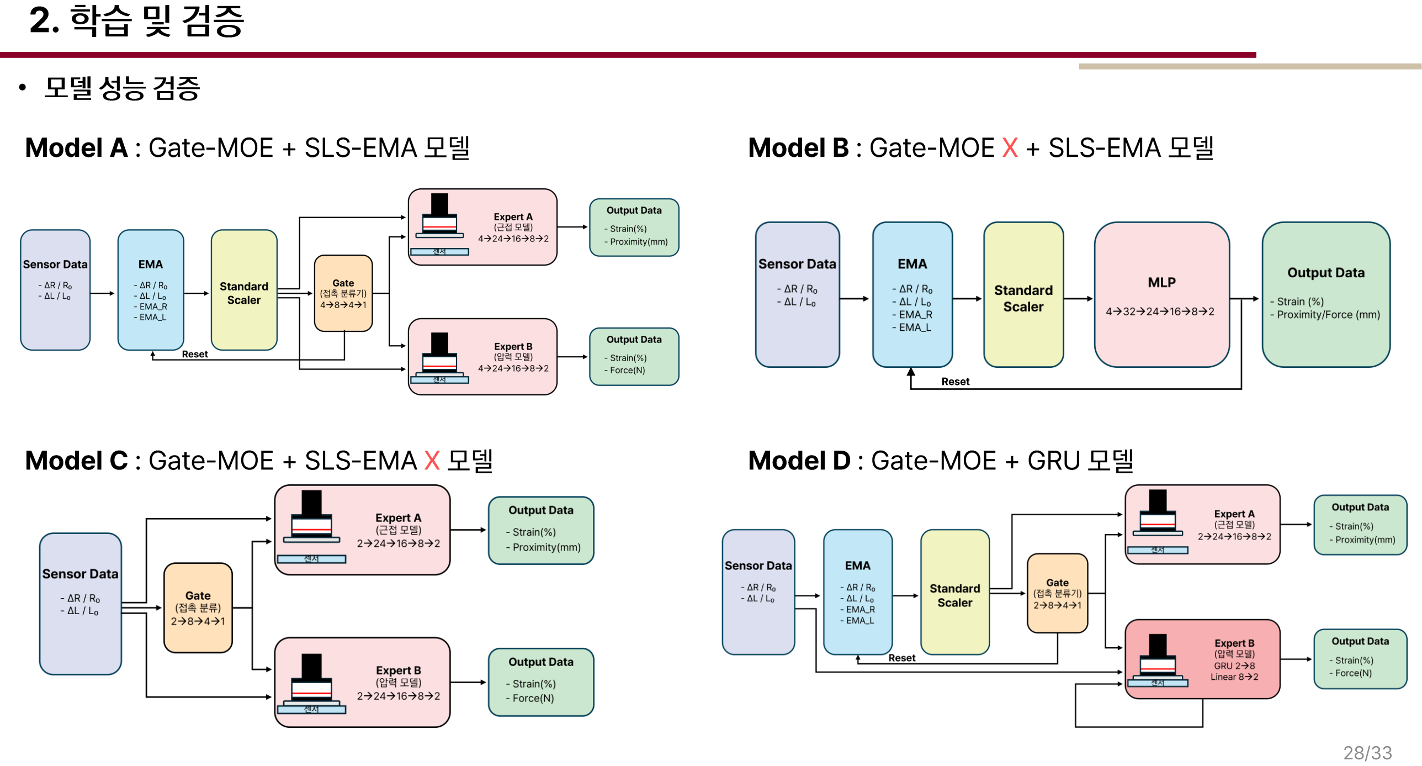
[picture p106: page 29]

Model A : Gate-MOE + SLS-EMA 모델

Model C : Gate-MOE + SLS-EMA X 모델

- 모델성능 검증

Model B : Gate-MOE X + SLS-EMA 모델

Model D : Gate-MOE + GRU 모델

Reset

- 모델성능 검증
모델 | 구조 | 입력 피처 수 | 레이어 구조 | 활성함수 | 출력 | 파라미터 | 총 파라미터
<Model A> Gate-MOE SLS-EMA 모델 | 게이트 | 4 | 4→8→4→1 | tanh, tanh, sigmoid | 접촉확률(0~1) | 81 | 1,429
| 전문가A (근접) | 4 | 4→24→16→8→2 | tanh×3, linear | strain(%), 거리(mm) | 674
| 전문가B(압력) | 4 | 4→24→16→8→2 | tanh×3, linear | strain(%), 힘(N) | 674
<Model B> Gate-MOE X SLS-EMA | 통합모델 | 4 | 4→32→24→16→8→2 | tanh×4, linear | strain(%), 거리/힘(mm) | 1,506 | 1,506
<Model C> Gate-MOE SLS-EMA X | 게이트 | 2 | 2→8→4→1 | tanh, tanh, sigmoid | 접촉확률(0~1) | 65 | 1,317
| 전문가A(근접) | 2 | 2→24→16→8→2 | tanh×3, linear | strain(%), 거리(mm) | 626
| 전문가B(압력) | 2 | 2→24→16→8→2 | tanh×3, linear | strain(%), 힘(N) | 626
<Model D> Gate-MOE GRU 모델 | 게이트 | 4 | 4→8→4→1 | tanh, tanh, sigmoid | 접촉확률(0~1) | 81 | 1,061
| 전문가A(근접) | 4 | 4→24→16→8→2 | tanh×3, linear | strain(%), 거리(mm) | 674
| 전문가B(압력) GRU | 2 | GRU(2→8, 1층) + Linear(8→2) | GRU 내부게이트(σ,tanh), 출력linear | strain(%), 힘(N) | 306

## 2. 학습 및 검증

- 모델성능 검증
모델 | 게이트 정확도 | Strain R | Strain RMSE | Proximity R | Proximity RMSE | Force R | Force RMSE | 총 파라미터
<Model A> Gate-MOE SLS-EMA 모델 | 1.000 | 0.999 | 0.108%p | 0.999 | 0.318mm | 0.995 | 0.253N | 1,429
<Model B> Gate-MOE X SLS-EMA | - | 0.998 | 0.288%p | 0.999 | 0.322mm | 0.963 | 0.079mm | 1,506
<Model C> Gate-MOE SLS-EMA X | 0.982 | 0.999 | 0.194%p | 0.998 | 0.410mm | 0.981 | 0.521N | 1,317
<Model D> Gate-MOE GRU 모델 | 1.000 | 0.999 | 0.123%p | 0.999 | 0.318mm | 0.995 | 0.263N | 1,061

* FT Sensor 노이즈: ±0.19N

## 2. 학습 및 검증

## 3. EI Embedding

- EI-based Realtime Decoupling

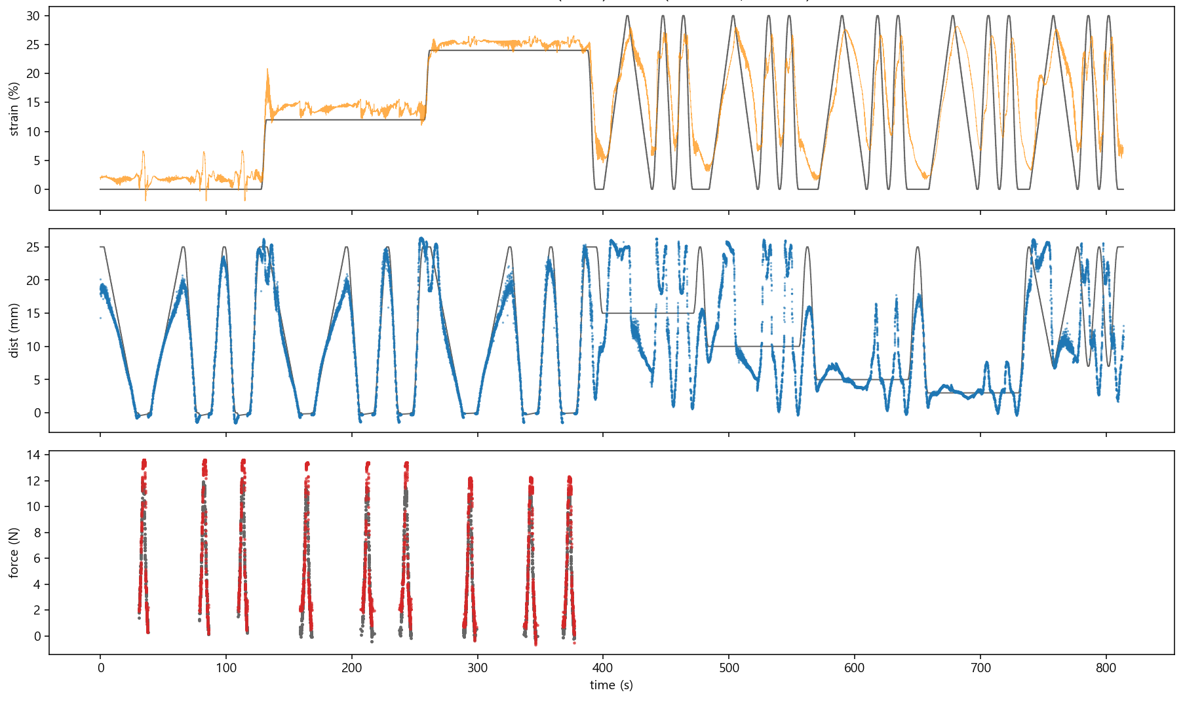
[picture p107: figure]

## 3. EI Embedding

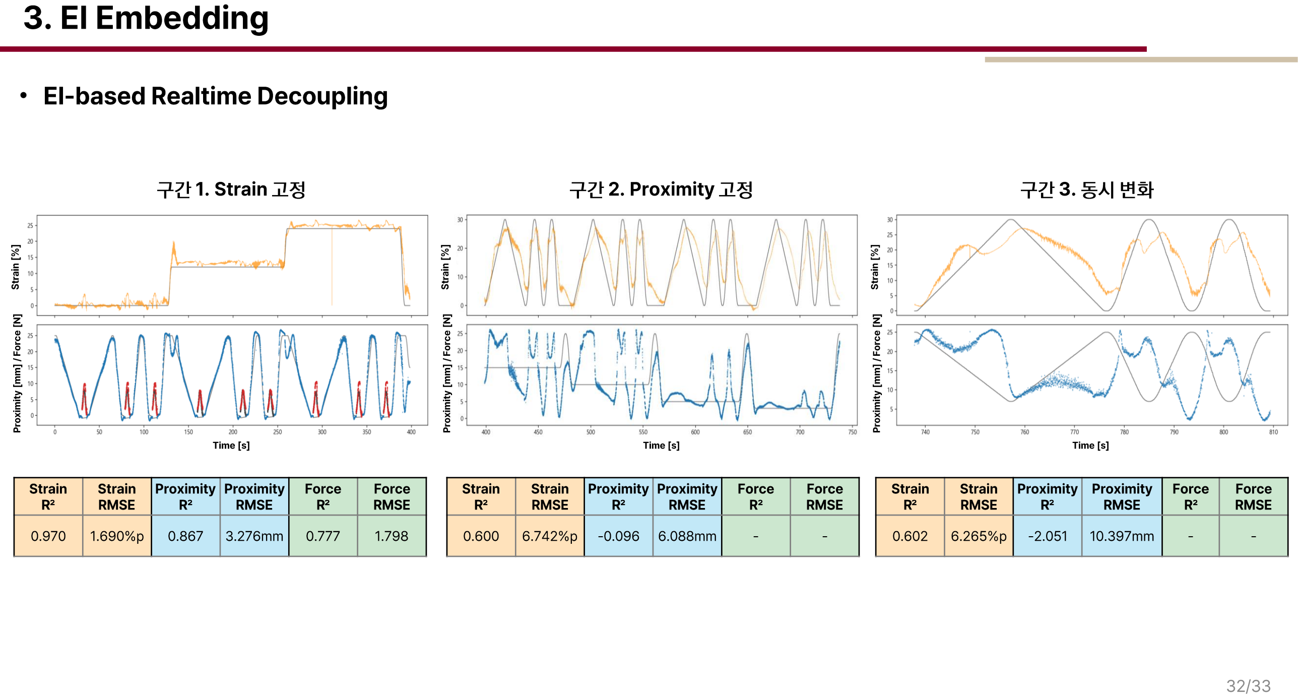
[picture p108: page 33]

Strain
R

Strain
RMSE

Proximity
R

Proximity
RMSE

Force
R

Force
RMSE
0.970 | 1.690%p | 0.867 | 3.276mm | 0.777 | 1.798
- EI-based Realtime Decoupling

구간 1. Strain 고정

Proximity [mm] / Force [N] Strain [%]

Time [s]

Proximity [mm] / Force [N] Strain [%]

Time [s]

Proximity [mm] / Force [N] Strain [%]

Time [s]

Strain
R

Strain
RMSE

Proximity
R

Proximity
RMSE

Force
R

Force
RMSE
0.600 | 6.742%p | -0.096 | 6.088mm | - | -

Strain
R

Strain
RMSE

Proximity
R

Proximity
RMSE

Force
R

Force
RMSE
0.602 | 6.265%p | -2.051 | 10.397mm | - | -
구간 2. Proximity 고정 | 구간 3. 동시 변화

## Future Work

HeeJun Moon
