HeejunMoon53/MultimodalSensor/nn_decoupling/stm32_deploy_md_xcubeai/stage2_generate_report.txt

ST Edge AI Core v2.2.0-20266 2adc00962
Created date          : 2026-06-11 16:43:35
Parameters            : generate --target stm32 --name stage2 --model C:\Users\Korea University\ClaudeProject\MultimodalSensor\nn_decoupling\stm32_deploy_md_xcubeai\stage2_md.onnx --output C:\Users\Korea University\ClaudeProject\MultimodalSensor\nn_decoupling\stm32_deploy_md_xcubeai

Exec/report summary (generate)
---------------------------------------------------------------------------------------------------------------------------------------
model file         :   C:\Users\Korea University\ClaudeProject\MultimodalSensor\nn_decoupling\stm32_deploy_md_xcubeai\stage2_md.onnx   
type               :   onnx                                                                                                            
c_name             :   stage2                                                                                                          
compression        :   lossless                                                                                                        
options            :   allocate-inputs, allocate-outputs                                                                               
optimization       :   balanced                                                                                                        
target/series      :   stm32                                                                                                           
workspace dir      :   C:\Users\Korea University\ClaudeProject\MultimodalSensor\st_ai_ws                                               
output dir         :   C:\Users\Korea University\ClaudeProject\MultimodalSensor\nn_decoupling\stm32_deploy_md_xcubeai                  
model_fmt          :   float                                                                                                           
model_name         :   stage2_md                                                                                                       
model_hash         :   0xf2ee7bf8eb7657ab71bd10538bcb5107                                                                              
params #           :   769 items (3.00 KiB)                                                                                            
---------------------------------------------------------------------------------------------------------------------------------------
input 1/1          :   'dL_eps', f32(1x2), 8 Bytes, activations                                                                        
output 1/1         :   'mul_result3', f32(1x1), 4 Bytes, activations                                                                   
macc               :   825                                                                                                             
weights (ro)       :   3,076 B (3.00 KiB) (1 segment)                                                                                  
activations (rw)   :   192 B (192 B) (1 segment) *                                                                                     
ram (total)        :   192 B (192 B) = 192 + 0 + 0                                                                                     
---------------------------------------------------------------------------------------------------------------------------------------
(*) 'input'/'output' buffers are allocated in the activations buffer

Model name - stage2_md
------ ---------------------------------------- ------------- ------------ ------ ------------------- --- ------------------ --------------- ------------------ 
m_id   layer (type,original)                    oshape        param/size     macc        connected to   | c_size             c_macc          c_type             
------ ---------------------------------------- ------------- ------------ ------ ------------------- --- ------------------ --------------- ------------------ 
1      coefficient (Placeholder, MatMul)        [b:2,c:32]    64/256                                    | -256(-100.0%)                      
------ ---------------------------------------- ------------- ------------ ------ ------------------- --- ------------------ --------------- ------------------ 
2      intercepts (Placeholder, Add)            [b:1,c:32]    32/128                                    | +256(+200.0%)      +96(+100.0%)    Dense_[0]          
------ ---------------------------------------- ------------- ------------ ------ ------------------- --- ------------------ --------------- ------------------ 
4      coefficient1 (Placeholder, MatMul)       [b:32,c:16]   512/2,048                                 | -2,048(-100.0%)                    
------ ---------------------------------------- ------------- ------------ ------ ------------------- --- ------------------ --------------- ------------------ 
5      intercepts1 (Placeholder, Add)           [b:1,c:16]    16/64                                     | +2,048(+3200.0%)   +528(+100.0%)   Dense_[2]          
------ ---------------------------------------- ------------- ------------ ------ ------------------- --- ------------------ --------------- ------------------ 
7      coefficient2 (Placeholder, MatMul)       [b:16,c:8]    128/512                                   | -512(-100.0%)                      
------ ---------------------------------------- ------------- ------------ ------ ------------------- --- ------------------ --------------- ------------------ 
8      intercepts2 (Placeholder, Add)           [b:1,c:8]     8/32                                      | +512(+1600.0%)     +136(+100.0%)   Dense_[4]          
------ ---------------------------------------- ------------- ------------ ------ ------------------- --- ------------------ --------------- ------------------ 
10     coefficient3 (Placeholder, MatMul)       [b:8,c:1]     8/32                                      | -32(-100.0%)                       
------ ---------------------------------------- ------------- ------------ ------ ------------------- --- ------------------ --------------- ------------------ 
11     intercepts3 (Placeholder, Add)           [b:1,c:1]     1/4                                       | +32(+800.0%)       +9(+100.0%)     Dense_[o][6]       
------ ---------------------------------------- ------------- ------------ ------ ------------------- --- ------------------ --------------- ------------------ 
0      dL_eps (Input, )                         [b:1,c:2]                                               |                                    
------ ---------------------------------------- ------------- ------------ ------ ------------------- --- ------------------ --------------- ------------------ 
1      mul_result (Gemm, MatMul)                [b:1,c:32]                     96              dL_eps   |                    -96(-100.0%)    
                                                                                          coefficient   | 
------ ---------------------------------------- ------------- ------------ ------ ------------------- --- ------------------ --------------- ------------------ 
2      add_result (Eltwise, Add)                [b:1,c:32]                     32          mul_result   |                    -32(-100.0%)    
                                                                                           intercepts   | 
------ ---------------------------------------- ------------- ------------ ------ ------------------- --- ------------------ --------------- ------------------ 
3      next_activations (Nonlinearity, Relu)    [b:1,c:32]                     32          add_result   |                                    Nonlinearity_[1]   
------ ---------------------------------------- ------------- ------------ ------ ------------------- --- ------------------ --------------- ------------------ 
4      mul_result1 (Gemm, MatMul)               [b:1,c:16]                    528    next_activations   |                    -528(-100.0%)   
                                                                                         coefficient1   | 
------ ---------------------------------------- ------------- ------------ ------ ------------------- --- ------------------ --------------- ------------------ 
5      add_result1 (Eltwise, Add)               [b:1,c:16]                     16         mul_result1   |                    -16(-100.0%)    
                                                                                          intercepts1   | 
------ ---------------------------------------- ------------- ------------ ------ ------------------- --- ------------------ --------------- ------------------ 
6      next_activations1 (Nonlinearity, Relu)   [b:1,c:16]                     16         add_result1   |                                    Nonlinearity_[3]   
------ ---------------------------------------- ------------- ------------ ------ ------------------- --- ------------------ --------------- ------------------ 
7      mul_result2 (Gemm, MatMul)               [b:1,c:8]                     136   next_activations1   |                    -136(-100.0%)   
                                                                                         coefficient2   | 
------ ---------------------------------------- ------------- ------------ ------ ------------------- --- ------------------ --------------- ------------------ 
8      add_result2 (Eltwise, Add)               [b:1,c:8]                       8         mul_result2   |                    -8(-100.0%)     
                                                                                          intercepts2   | 
------ ---------------------------------------- ------------- ------------ ------ ------------------- --- ------------------ --------------- ------------------ 
9      next_activations2 (Nonlinearity, Relu)   [b:1,c:8]                       8         add_result2   |                                    Nonlinearity_[5]   
------ ---------------------------------------- ------------- ------------ ------ ------------------- --- ------------------ --------------- ------------------ 
10     mul_result3 (Gemm, MatMul)               [b:1,c:1]                       9   next_activations2   |                    -9(-100.0%)     
                                                                                         coefficient3   | 
------ ---------------------------------------- ------------- ------------ ------ ------------------- --- ------------------ --------------- ------------------ 
11     add_result3 (Eltwise, Add)               [b:1,c:1]                       1         mul_result3   |                    -1(-100.0%)     
                                                                                          intercepts3   | 
------ ---------------------------------------- ------------- ------------ ------ ------------------- --- ------------------ --------------- ------------------ 
12     variable (Reshape, Reshape)              [b:1,c:1]                                 add_result3   |                                    
------ ---------------------------------------- ------------- ------------ ------ ------------------- --- ------------------ --------------- ------------------ 
model/c-model: macc=882/825 -57(-6.5%) weights=3,076/3,076  activations=--/192 io=--/0

Generated C-graph summary
------------------------------------------------------------------------------------------------------------------------
model name            : stage2_md
c-name                : stage2
c-node #              : 7
c-array #             : 16
activations size      : 192 (1 segment)
weights size          : 3076 (1 segment)
macc                  : 825
inputs                : ['dL_eps_output']
outputs               : ['mul_result3_output']

C-Arrays (16)
------ -------------------------- ----------- ------------------------- ------------- --------- 
c_id   name (*_array)             item/size   domain/mem-pool           c-type        comment   
------ -------------------------- ----------- ------------------------- ------------- --------- 
0      dL_eps_output              2/8         activations/**default**   float         /input    
1      mul_result1_bias           16/64       weights/weights           const float             
2      mul_result1_output         16/64       activations/**default**   float                   
3      mul_result1_weights        512/2048    weights/weights           const float             
4      mul_result2_bias           8/32        weights/weights           const float             
5      mul_result2_output         8/32        activations/**default**   float                   
6      mul_result2_weights        128/512     weights/weights           const float             
7      mul_result3_bias           1/4         weights/weights           const float             
8      mul_result3_output         1/4         activations/**default**   float         /output   
9      mul_result3_weights        8/32        weights/weights           const float             
10     mul_result_bias            32/128      weights/weights           const float             
11     mul_result_output          32/128      activations/**default**   float                   
12     mul_result_weights         64/256      weights/weights           const float             
13     next_activations1_output   16/64       activations/**default**   float                   
14     next_activations2_output   8/32        activations/**default**   float                   
15     next_activations_output    32/128      activations/**default**   float                   
------ -------------------------- ----------- ------------------------- ------------- --------- 

C-Layers (7)
------ ------------------- ---- --------------- ------ ------ ----------------------------- ------------------ 
c_id   name (*_layer)      id   layer_type      macc   rom    tensors                       shape (array id)   
------ ------------------- ---- --------------- ------ ------ ----------------------------- ------------------ 
0      mul_result          2    Dense           96     384    I: dL_eps_output              f32(1x2) (0)       
                                                              W: mul_result_weights         f32(32x2) (12)     
                                                              W: mul_result_bias            f32(32) (10)       
                                                              O: mul_result_output          f32(1x32) (11)     
------ ------------------- ---- --------------- ------ ------ ----------------------------- ------------------ 
1      next_activations    3    Nonlinearity    32     0      I: mul_result_output          f32(1x32) (11)     
                                                              O: next_activations_output    f32(1x32) (15)     
------ ------------------- ---- --------------- ------ ------ ----------------------------- ------------------ 
2      mul_result1         5    Dense           528    2112   I: next_activations_output    f32(1x32) (15)     
                                                              W: mul_result1_weights        f32(16x32) (3)     
                                                              W: mul_result1_bias           f32(16) (1)        
                                                              O: mul_result1_output         f32(1x16) (2)      
------ ------------------- ---- --------------- ------ ------ ----------------------------- ------------------ 
3      next_activations1   6    Nonlinearity    16     0      I: mul_result1_output         f32(1x16) (2)      
                                                              O: next_activations1_output   f32(1x16) (13)     
------ ------------------- ---- --------------- ------ ------ ----------------------------- ------------------ 
4      mul_result2         8    Dense           136    544    I: next_activations1_output   f32(1x16) (13)     
                                                              W: mul_result2_weights        f32(8x16) (6)      
                                                              W: mul_result2_bias           f32(8) (4)         
                                                              O: mul_result2_output         f32(1x8) (5)       
------ ------------------- ---- --------------- ------ ------ ----------------------------- ------------------ 
5      next_activations2   9    Nonlinearity    8      0      I: mul_result2_output         f32(1x8) (5)       
                                                              O: next_activations2_output   f32(1x8) (14)      
------ ------------------- ---- --------------- ------ ------ ----------------------------- ------------------ 
6      mul_result3         11   Dense           9      36     I: next_activations2_output   f32(1x8) (14)      
                                                              W: mul_result3_weights        f32(1x8) (9)       
                                                              W: mul_result3_bias           f32(1) (7)         
                                                              O: mul_result3_output         f32(1x1) (8)       
------ ------------------- ---- --------------- ------ ------ ----------------------------- ------------------ 

Number of operations per c-layer
------- ------ ---------------------------------- ----- -------------- 
c_id    m_id   name (type)                          #op           type 
------- ------ ---------------------------------- ----- -------------- 
0       2      mul_result (Dense)                    96   smul_f32_f32 
1       3      next_activations (Nonlinearity)       32     op_f32_f32 
2       5      mul_result1 (Dense)                  528   smul_f32_f32 
3       6      next_activations1 (Nonlinearity)      16     op_f32_f32 
4       8      mul_result2 (Dense)                  136   smul_f32_f32 
5       9      next_activations2 (Nonlinearity)       8     op_f32_f32 
6       11     mul_result3 (Dense)                    9   smul_f32_f32 
------- ------ ---------------------------------- ----- -------------- 
total                                               825 

Number of operation types
---------------- ----- ----------- 
operation type       #           % 
---------------- ----- ----------- 
smul_f32_f32       769       93.2% 
op_f32_f32          56        6.8% 

Complexity report (model)
------ ------------------- ------------------------- ------------------------- ------ 
m_id   name                c_macc                    c_rom                     c_id   
------ ------------------- ------------------------- ------------------------- ------ 
2      intercepts          |||               11.6%   |||               12.5%   [0]    
5      intercepts1         ||||||||||||||||  64.0%   ||||||||||||||||  68.7%   [2]    
8      intercepts2         ||||              16.5%   ||||              17.7%   [4]    
11     intercepts3         |                  1.1%   |                  1.2%   [6]    
3      next_activations    |                  3.9%   |                  0.0%   [1]    
6      next_activations1   |                  1.9%   |                  0.0%   [3]    
9      next_activations2   |                  1.0%   |                  0.0%   [5]    
------ ------------------- ------------------------- ------------------------- ------ 
macc=825 weights=3,076 act=192 ram_io=0

Generated files (7)
--------------------------------------------------------------------------------------------------------------------- 
C:\Users\Korea University\ClaudeProject\MultimodalSensor\nn_decoupling\stm32_deploy_md_xcubeai\stage2_data_params.h   
C:\Users\Korea University\ClaudeProject\MultimodalSensor\nn_decoupling\stm32_deploy_md_xcubeai\stage2_data_params.c   
C:\Users\Korea University\ClaudeProject\MultimodalSensor\nn_decoupling\stm32_deploy_md_xcubeai\stage2_data.h          
C:\Users\Korea University\ClaudeProject\MultimodalSensor\nn_decoupling\stm32_deploy_md_xcubeai\stage2_data.c          
C:\Users\Korea University\ClaudeProject\MultimodalSensor\nn_decoupling\stm32_deploy_md_xcubeai\stage2_config.h        
C:\Users\Korea University\ClaudeProject\MultimodalSensor\nn_decoupling\stm32_deploy_md_xcubeai\stage2.h               
C:\Users\Korea University\ClaudeProject\MultimodalSensor\nn_decoupling\stm32_deploy_md_xcubeai\stage2.c
