HeejunMoon53/MultimodalSensor/nn_decoupling/test0816_RealtimeDecoupling/v3_realtime_report.html

# v3 실시간 디커플링 검증 — 파일별/구간별 순수 분석

모델: stm32_deploy_moe_v3 · 그래프 색상: 회색=실제값, 주황=strain 예측, 파랑=proximity 예측, 빨강=pressure 예측 (범례는 그래프 안에 넣지 않음) · Part1/Part2 구간에서 서로의 축이 실제로 움직인 순간(±1초 여유)은 완전히 제외하고 계산함(옆 구간에 병합하지 않음)

## moe_monitor_20260819_151903.csv

34,002행 · 814초 · Gate 정확도 99.0%

구간 순수화를 위해 3,643행(10.7%) 제외 — Part1 구간 중 strain이 실제로 움직인 순간, Part2 구간 중 근접(Z)이 실제로 움직인 순간(±1초 여유 포함)

구간 | Strain | | | Proximity(dist) | | | Pressure(force)
| R² | RMSE(%p) | MAE(%p) | R² | RMSE(mm) | MAE(mm) | R² | RMSE(N) | MAE(N)
전체 구간(참고, 미분리) | 0.729 | 5.317 | 3.983 | 0.395 | 5.928 | 3.921 | 0.777 | 1.798 | 1.204
Part1 — 근접 이동 (strain 변화 순간 제외) t=[0, 399]s, n=15,628 | 0.954 | 2.100 | 1.852 | 0.890 | 2.783 | 1.949 | 0.777 | 1.798 | 1.204
Part2 — strain 이동 (근접 변화 순간 제외) t=[401, 729]s, n=11,610 | 0.455 | 7.193 | 5.924 | -0.701 | 6.057 | 4.194 | — | — | —
Part3 — 동시 이동 t=[739, 814]s, n=3,121 | 0.556 | 6.736 | 5.864 | -2.161 | 10.769 | 8.830 | — | — | —

전체 구간 (Part 구분 없음, 참고용)

151903 overall scatter

151903 overall timeseries

Part1 — 근접 이동 (strain 변화 순간 제외)

151903 A_prox scatter

151903 A_prox timeseries

Part2 — strain 이동 (근접 변화 순간 제외)

151903 B_strain scatter

151903 B_strain timeseries

Part3 — 동시 이동

151903 C_simul scatter

151903 C_simul timeseries

## moe_monitor_20260819_151903.csv — PC 디커플링 (오프라인 재현, float64)

같은 raw dL_pct/dR_pct를 STM32 임베디드 대신 PC(float64 sklearn)에서 그대로 재현 — 게이트/EMA 리셋/라우팅 로직은 moe_inference.c와 동일(자기 게이트로 리셋), 클램프 범위도 moe_params.h와 동일 적용.

34,002행 · Gate 정확도 99.0% (임베디드와 게이트 판단 100% 일치)

구간 | Strain | | | Proximity(dist) | | | Pressure(force)
| R² | RMSE(%p) | MAE(%p) | R² | RMSE(mm) | MAE(mm) | R² | RMSE(N) | MAE(N)
전체 구간(참고, 미분리) | 0.840 | 4.084 | 3.004 | 0.715 | 4.066 | 2.643 | 0.876 | 1.343 | 0.987
Part1 — 근접 이동 (strain 변화 순간 제외) t=[0, 399]s, n=15,628 | 0.965 | 1.836 | 1.746 | 0.879 | 2.918 | 2.120 | 0.876 | 1.343 | 0.987
Part2 — strain 이동 (근접 변화 순간 제외) t=[401, 729]s, n=11,610 | 0.668 | 5.611 | 4.269 | 0.381 | 3.654 | 2.083 | — | — | —
Part3 — 동시 이동 t=[739, 814]s, n=3,121 | 0.716 | 5.387 | 4.242 | -0.346 | 7.027 | 5.488 | — | — | —

Part1 — 근접 이동 (strain 변화 순간 제외) (PC)

151903 A_prox PC scatter

151903 A_prox PC timeseries

Part2 — strain 이동 (근접 변화 순간 제외) (PC)

151903 B_strain PC scatter

151903 B_strain PC timeseries

Part3 — 동시 이동 (PC)

151903 C_simul PC scatter

151903 C_simul PC timeseries

## moe_monitor_20260819_153948.csv

32,546행 · 809초 · Gate 정확도 98.3%

구간 순수화를 위해 3,412행(10.5%) 제외 — Part1 구간 중 strain이 실제로 움직인 순간, Part2 구간 중 근접(Z)이 실제로 움직인 순간(±1초 여유 포함)

구간 | Strain | | | Proximity(dist) | | | Pressure(force)
| R² | RMSE(%p) | MAE(%p) | R² | RMSE(mm) | MAE(mm) | R² | RMSE(N) | MAE(N)
전체 구간(참고, 미분리) | 0.780 | 4.780 | 3.289 | 0.488 | 5.587 | 3.357 | 0.430 | 1.855 | 1.360
Part1 — 근접 이동 (strain 변화 순간 제외) t=[0, 397]s, n=15,781 | 0.981 | 1.370 | 1.052 | 0.940 | 2.106 | 1.182 | 0.430 | 1.855 | 1.360
Part2 — strain 이동 (근접 변화 순간 제외) t=[400, 728]s, n=10,418 | 0.492 | 6.971 | 5.873 | -0.797 | 6.192 | 4.306 | — | — | —
Part3 — 동시 이동 t=[738, 809]s, n=2,935 | 0.602 | 6.265 | 5.426 | -2.051 | 10.397 | 8.263 | — | — | —

전체 구간 (Part 구분 없음, 참고용)

153948 overall scatter

153948 overall timeseries

Part1 — 근접 이동 (strain 변화 순간 제외)

153948 A_prox scatter

153948 A_prox timeseries

Part2 — strain 이동 (근접 변화 순간 제외)

153948 B_strain scatter

153948 B_strain timeseries

Part3 — 동시 이동

153948 C_simul scatter

153948 C_simul timeseries

## moe_monitor_20260819_153948.csv — PC 디커플링 (오프라인 재현, float64)

같은 raw dL_pct/dR_pct를 STM32 임베디드 대신 PC(float64 sklearn)에서 그대로 재현 — 게이트/EMA 리셋/라우팅 로직은 moe_inference.c와 동일(자기 게이트로 리셋), 클램프 범위도 moe_params.h와 동일 적용.

32,546행 · Gate 정확도 98.3% (임베디드와 게이트 판단 100% 일치)

구간 | Strain | | | Proximity(dist) | | | Pressure(force)
| R² | RMSE(%p) | MAE(%p) | R² | RMSE(mm) | MAE(mm) | R² | RMSE(N) | MAE(N)
전체 구간(참고, 미분리) | 0.873 | 3.626 | 2.369 | 0.807 | 3.428 | 1.784 | 0.555 | 1.640 | 1.163
Part1 — 근접 이동 (strain 변화 순간 제외) t=[0, 397]s, n=15,781 | 0.988 | 1.067 | 0.915 | 0.993 | 0.735 | 0.536 | 0.555 | 1.640 | 1.163
Part2 — strain 이동 (근접 변화 순간 제외) t=[400, 728]s, n=10,418 | 0.693 | 5.419 | 4.281 | 0.225 | 4.065 | 2.394 | — | — | —
Part3 — 동시 이동 t=[738, 809]s, n=2,935 | 0.744 | 5.029 | 3.968 | -0.230 | 6.602 | 5.007 | — | — | —

Part1 — 근접 이동 (strain 변화 순간 제외) (PC)

153948 A_prox PC scatter

153948 A_prox PC timeseries

Part2 — strain 이동 (근접 변화 순간 제외) (PC)

153948 B_strain PC scatter

153948 B_strain PC timeseries

Part3 — 동시 이동 (PC)

153948 C_simul PC scatter

153948 C_simul PC timeseries

## 임베디드 vs PC 비교 및 원인 분석

세션 | 구간 | dist R² (임베디드 / PC / 차이) | | | force R² (임베디드 / PC / 차이)
151903 | Part1 | 0.890 | 0.879 | -0.011 | 0.777 | 0.876 | +0.098
151903 | Part2 | -0.701 | 0.381 | +1.082 | — | — | —
151903 | Part3 | -2.161 | -0.346 | +1.815 | — | — | —
153948 | Part1 | 0.940 | 0.993 | +0.053 | 0.430 | 0.555 | +0.125
153948 | Part2 | -0.797 | 0.225 | +1.022 | — | — | —
153948 | Part3 | -2.051 | -0.230 | +1.820 | — | — | —

PC(float64) 재현이 임베디드(float32 MCU)보다 거의 모든 구간에서 더 좋습니다 — 특히 Part2/3(근접이 사실상 고정된, 신호가 노이즈에 가까운 구간)에서 격차가 극단적입니다(예: 153948 Part2 dist R² -0.797→0.225, Part3 -2.051→-0.230). Part1(근접이 실제로 크게 움직여 신호 대 잡음비가 좋은 구간)에서는 격차가 작거나 거의 없습니다(151903 Part1은 오히려 임베디드가 약간 더 나음).

원인 분석. 게이트 판단은 PC와 임베디드가 100% 일치하므로 원인은 게이트가 아니라 전문가(회귀) 단계의 EMA 피처에 있습니다. 학습 시 sklearn↔ONNX 수치 검증 오차는 1e-5~1e-6 수준이라 float32/float64 정밀도 차이만으로는 이 정도 격차(dist 평균 |차이| 2.3~2.4mm, force 0.36~0.46N, 최대는 각각 16mm/5.5N)를 설명할 수 없습니다. 가장 유력한 원인은 EMA를 재구성하는 방식의 차이입니다:

- 실제 보드는 1ms TDM 주기마다(=1kHz) 원본 dL/dR을 그대로 받아 EMA를 갱신합니다 — 그 사이의 모든 노이즈·글리치까지 EMA에 그대로 반영됩니다.
- PC 재현은 모니터링 툴이 다운샘플(500Hz→실효 100Hz)해서 로깅한 값만 갖고 있어서, 로깅 안 된 4/5의 원본 샘플은 아예 못 보고 연속시간 근사식(alpha_eff = 1-exp(-dt/tau))으로 그 사이를 "매끄럽게 건너뛴" 것처럼 계산합니다.
- Part1처럼 실제 신호(진짜 근접 변화)가 노이즈보다 훨씬 크면 두 방식의 차이가 묻히지만, Part2/3처럼 실제 신호가 거의 없고 노이즈만 있는 구간에서는 보드의 EMA가 노이즈를 그대로 반영해 더 요동치는 반면 PC의 EMA는 로깅 간격 사이를 매끈하게 근사해서 인위적으로 더 안정적으로 보입니다 — 결과적으로 (근접도가 거의 고정인) 실제값과 더 가까워 보이는 것뿐, "PC가 물리적으로 더 정확하다"는 뜻은 아닙니다.

이 가설을 직접 확인하려면 STM32 쪽 다운샘플(STM32_KEEP_EVERY_N)을 끄고 원본 500Hz를 그대로 로깅해서 같은 비교를 다시 해봐야 합니다 — 그러면 PC 재현이 실제 보드 EMA와 훨씬 가까워질 것으로 예상됩니다.

## 종합 비교

구간 | Proximity R² (151903 / 153948) | | Proximity RMSE(mm)
Part1 (근접만 순수) | 0.890 | 0.940 | 2.78 | 2.11
Part2 (strain만 순수) | -0.701 | -0.797 | 6.06 | 6.19
Part3 (동시 이동) | -2.161 | -2.051 | 10.77 | 10.40

순수 분리 후 오히려 격차가 더 뚜렷해졌습니다 — Part1은 R²가 더 좋아졌고(0.81→0.89, 0.87→0.94), Part2는 오히려 더 나빠졌습니다(-0.11→-0.70, -0.10→-0.80). 이전(구간 병합) 버전에서는 Part2 안에 섞여있던 소량의 근접-이동 순간(strain 레벨 전환 시 짧은 Z 조정 등)이 지표를 실제보다 낫게 보이게 했던 것으로 보입니다 — "strain만 순수하게 움직이고 근접은 완전히 고정된" 상황에서 근접도 추정은 사실상 완전히 무너진다는 게 더 명확해졌습니다.

## 다음 단계 제안

1. Part2 순수 상황(strain만 변화)을 학습 데이터에 명시적으로 포함 — 지금 v3 학습 데이터는 Part1 스타일(근접 스윕 위주) 비중이 커서, "근접은 고정, strain만 변할 때 dL/dR이 어떻게 보이는지"를 모델이 충분히 학습하지 못했을 가능성이 큼
2. strain 변화가 dL_pct에 주는 영향과 근접 변화가 주는 영향을 분리하는 피처 설계 — 현재 4-input(dL,dR,dL_ema,dR_ema)만으로는 두 원인이 구분 안 되는 것으로 보임
3. 고변형률 인덕턴스 노이즈는 별개 문제로 여전히 남아있음
