HeejunMoon53/MultimodalSensor/nn_decoupling/data_acquisition/dataset/preprocessing_report.html

# Preprocessing Report

Generated: 2026-05-22 13:12 | random_state=42 | 2D-bin sampling: 30/cell | grid=24×24 (eps×d)

188,232

원본 샘플 (합계)

33,450

전처리 후 (합계)

23,415

Train

5,017 / 5,018

Val / Test

## 1. 데이터셋 개요

파일 | 별칭 | eps 프로파일 | d 프로파일 | 원본 샘플 | 전처리 후 | 잔존율
collect_20260519_140039.csv | Ramp | 단조 증가 (0→30%) | 왕복 스윔 (0↔36mm) | 100,353 | 16,590 | 16.5%
collect_20260519_143611.csv | Oscillate | 왕복 진동 (0↔30%) | 단계 하강 (36→0mm) | 87,879 | 16,860 | 19.2%

## 2. 전처리 파이프라인

빨간 수치 = 해당 단계에서 제거된 샘플 수. 백분율은 원본 대비.

단계 | 140039 (Ramp) | | 143611 (Oscillate) | | 설명
| 잔존 | 제거 | 잔존 | 제거
① Load | 100,353 (100.0%) | — | 87,879 (100.0%) | — | 원본 CSV 로드
② Outlier filter | 100,353 (100.0%) | — | 87,879 (100.0%) | — | |dL|<30%, dR∈(-5,30%) 범위 밖 제거
③ 2D-bin sampling | 16,590 (16.5%) | -83,763 | 16,860 (19.2%) | -71,019 | eps×d 24×24 그리드 각 셀당 최대 30개 균등 선택
④ Merge | 33,450개 (140039: 16,590 + 143611: 16,860) | | | | 두 데이터셋 병합

### 2D Bin Sampling 방식

per-visit cap(축별 방문마다 제한)은 중간 구간이 양 끝보다 2배 많아지는 불균형 발생.
→ eps×d 2D 그리드 각 셀에서 직접 최대 30개 균등 선택하는 방식으로 교체.

항목 | 값
eps 그리드 | 0~30%, 24 bins, 1.25%/bin
d 그리드 | 0~36mm, 24 bins, 1.5mm/bin
셀 수 | 24 × 24 = 576
셀당 최대 샘플 | 30개
이론적 최대 | 576 × 30 = 17,280개 (데이터 없는 셀 제외 시 실제 더 적음)

## 3. Train / Val / Test 분할

전체 병합 후 random_state=42로 셔플 → 비율 분할. 소스 레이블 제거 후 저장.

Split | 샘플 수 | 비율 | 파일
Train | 23,415 | 70.0% | train.csv
Validation | 5,017 | 15.0% | val.csv
Test | 5,018 | 15.0% | test.csv
Total | 33,450 | 100% | —

## 4. 기술통계

### Train (23,415개)

통계 | eps_act_pct [%] | d_act_mm [mm] | dL_pct [%] | dR_pct [%]
mean | 15.001 | 18.317 | 6.441 | 9.13
std | 8.602 | 10.478 | 8.003 | 5.469
min | 0.0 | 1.0 | -27.039 | -0.713
25% | 7.5 | 9.0 | 1.627 | 4.393
50% | 15.0 | 18.11 | 6.791 | 9.054
75% | 22.5 | 26.955 | 12.537 | 13.848
max | 30.0 | 36.0 | 20.573 | 19.907

### Validation (5,017개)

통계 | eps_act_pct [%] | d_act_mm [mm] | dL_pct [%] | dR_pct [%]
mean | 15.007 | 18.437 | 6.475 | 9.133
std | 8.657 | 10.478 | 8.17 | 5.502
min | 0.0 | 1.0 | -27.029 | -0.456
25% | 7.5 | 9.55 | 1.834 | 4.343
50% | 15.0 | 18.2 | 6.923 | 8.99
75% | 22.5 | 27.42 | 12.744 | 13.903
max | 30.0 | 36.0 | 20.538 | 19.661

### Test (5,018개)

통계 | eps_act_pct [%] | d_act_mm [mm] | dL_pct [%] | dR_pct [%]
mean | 14.896 | 18.219 | 6.311 | 9.05
std | 8.547 | 10.461 | 7.961 | 5.43
min | 0.0 | 1.0 | -26.972 | -0.74
25% | 7.5 | 8.89 | 1.546 | 4.358
50% | 15.0 | 17.87 | 6.775 | 9.046
75% | 22.182 | 27.035 | 12.236 | 13.531
max | 30.0 | 36.0 | 20.536 | 19.621

## 5. 분포 히스토그램

eps 및 d 축 기준 split별 샘플 분포.

histogram

## 6. eps × d 커버리지 (bin별 샘플 수)

24×24 그리드 기준. 색이 밝을수록 해당 셀 샘플 수 많음.

coverage

## 7. 3D 분산 그래프 (Train / Val / Test)

원(●) = Train, 사각(■) = Val, 삼각(▲) = Test

scatter_3d
