HeejunMoon53/MultimodalSensor/Analysis/fringing_3d_field.png

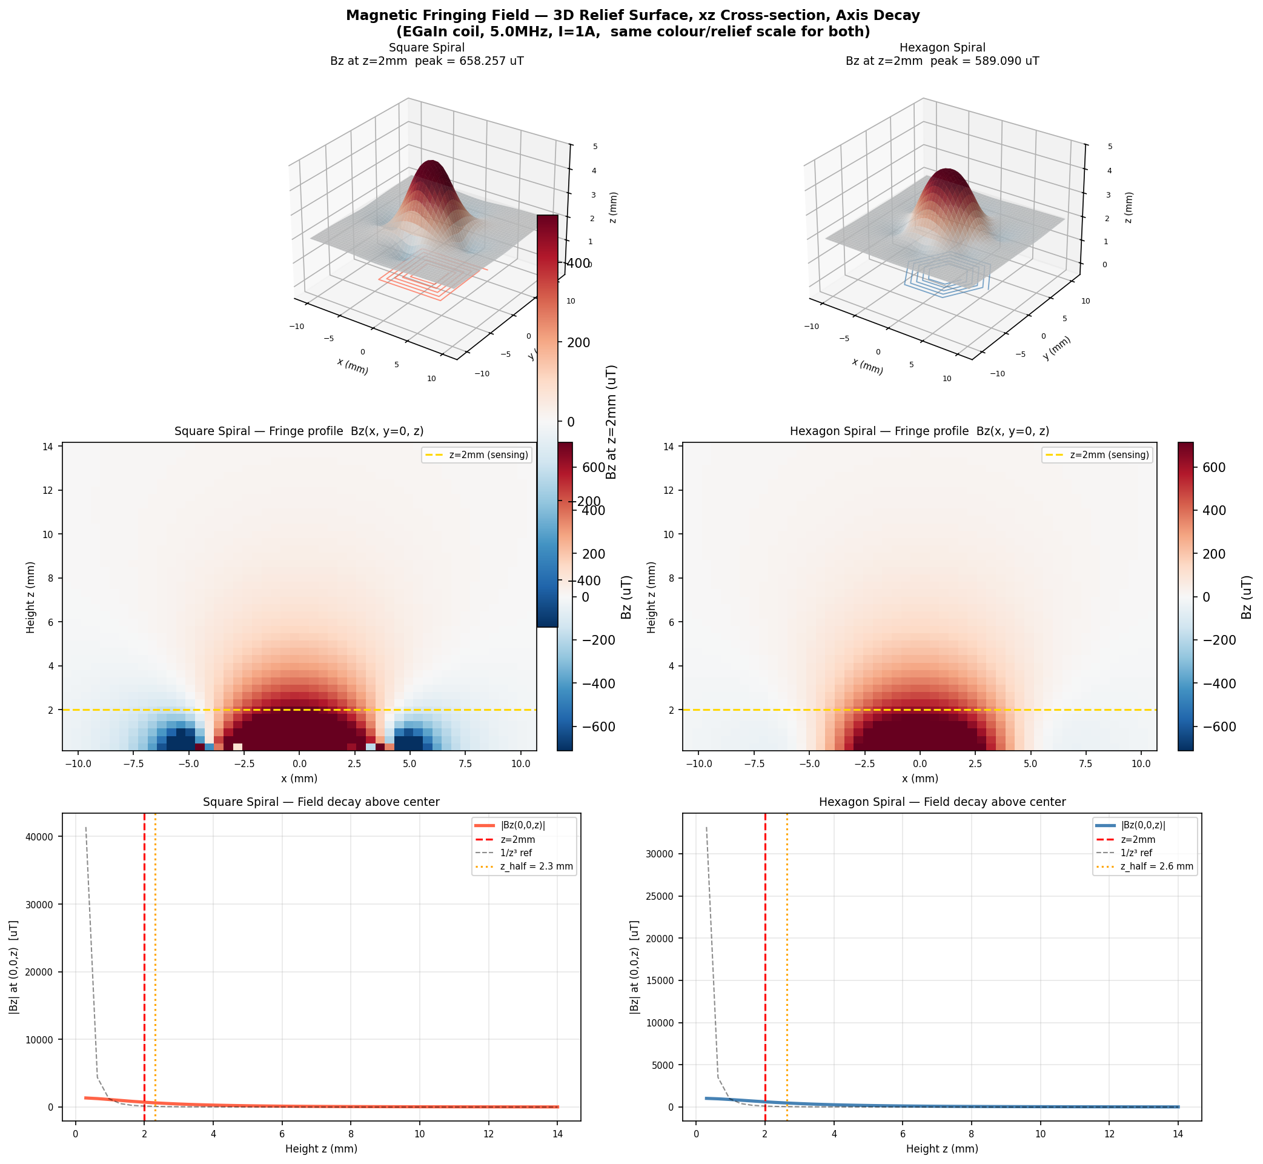
Analysis/fringing_3d_field.png
