HeejunMoon53/MultimodalSensor/Analysis/spiral_LC_compare.png

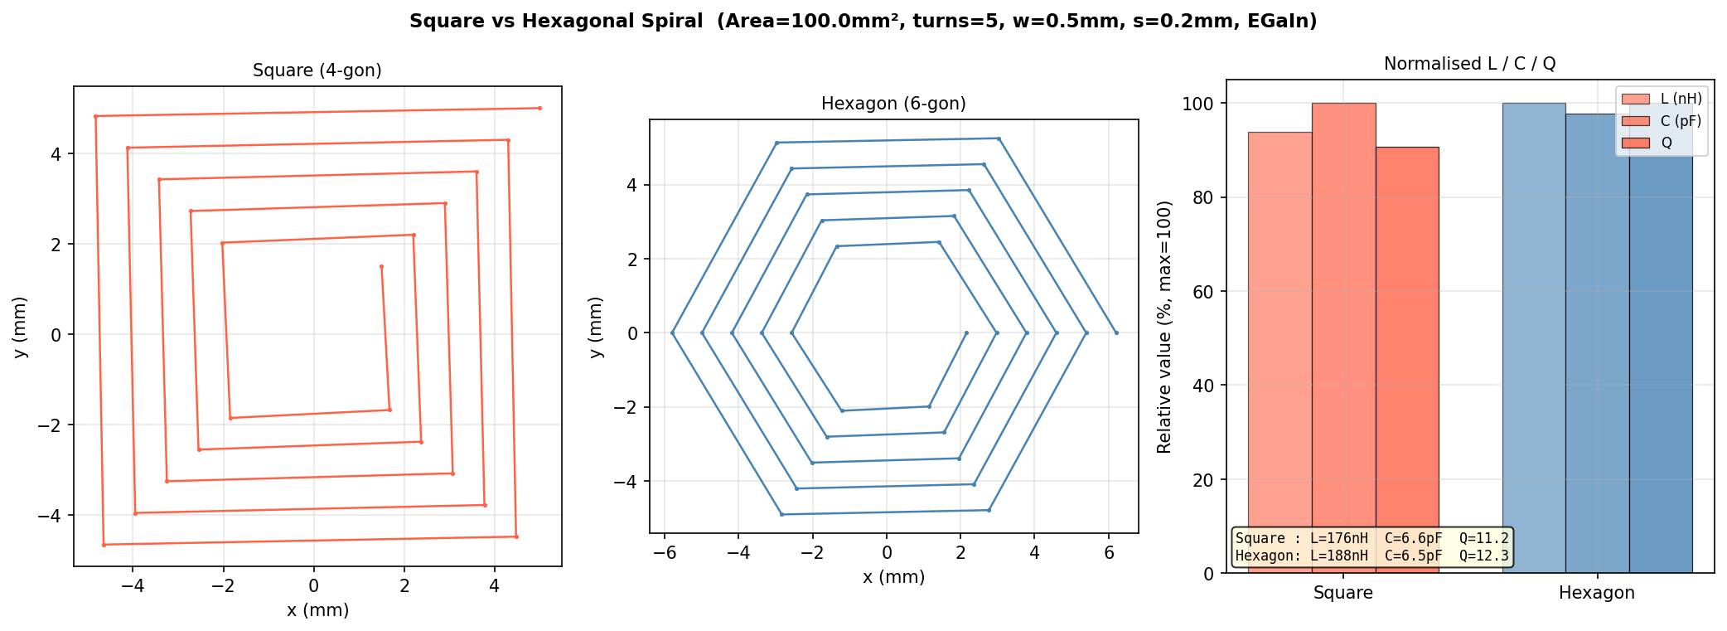
Analysis/spiral_LC_compare.png
