HeejunMoon53/MultimodalSensor/nn_decoupling/data_acquisition/dataset/arch_search_pareto.png

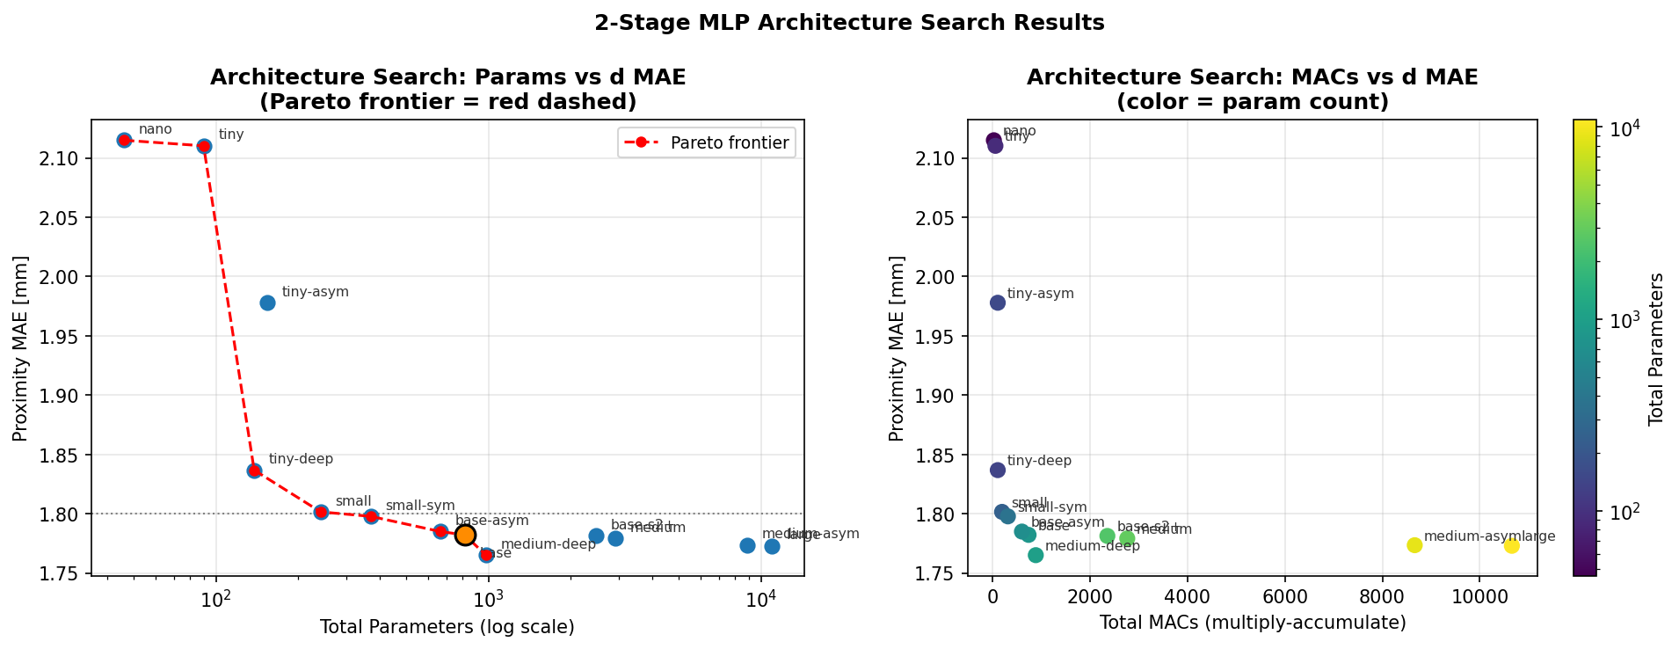
nn_decoupling/data_acquisition/dataset/arch_search_pareto.png
