HeejunMoon53/MultimodalSensor/nn_decoupling/data_acquisition/Figure/collect_20260519_140039.png

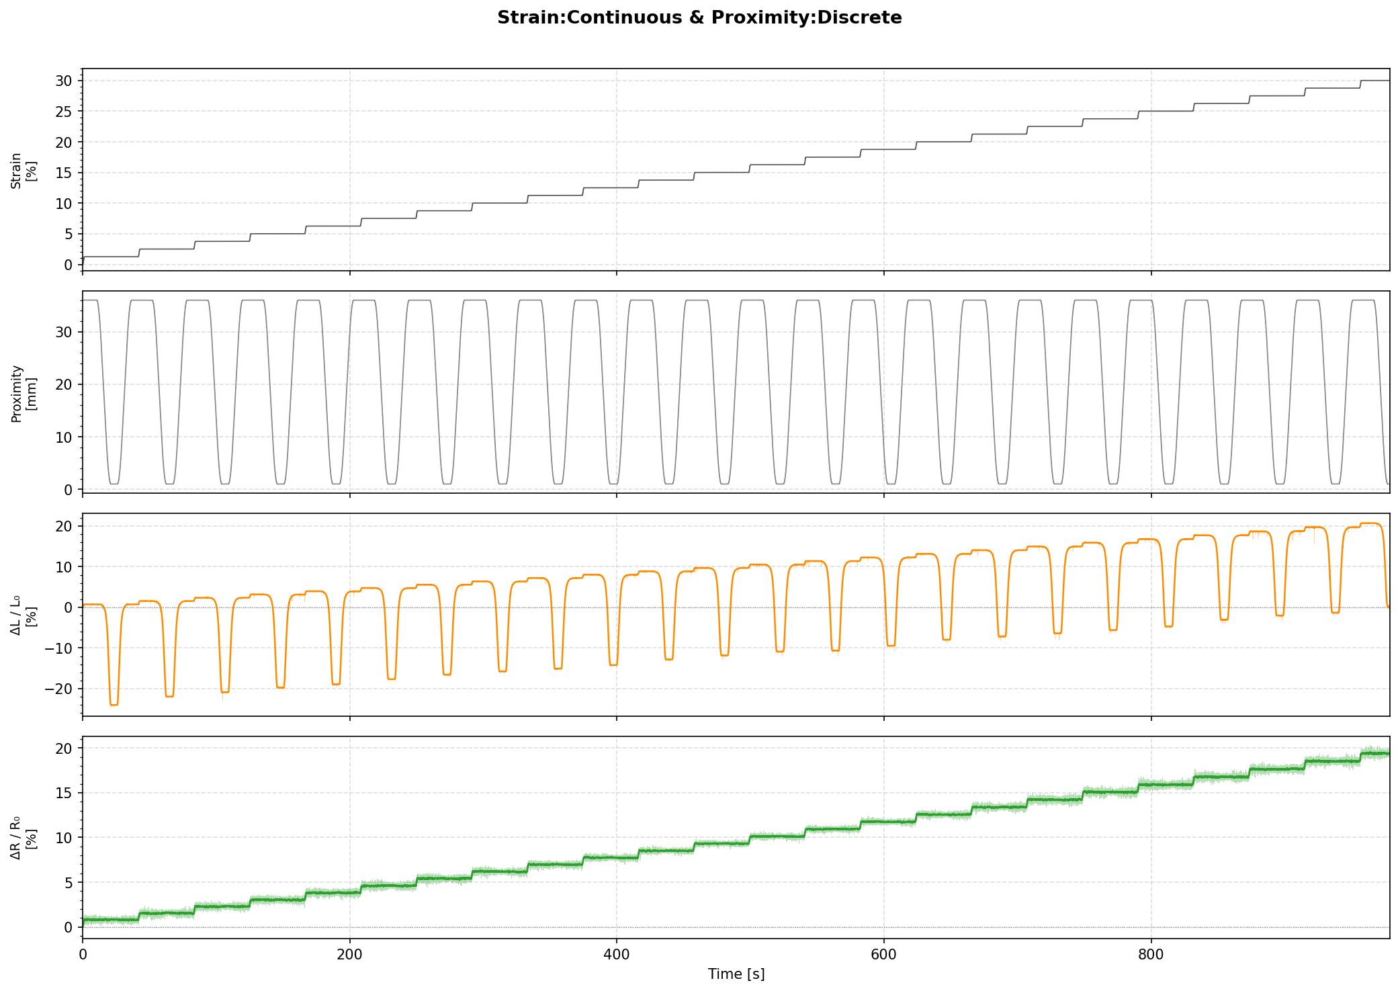
nn_decoupling/data_acquisition/Figure/collect_20260519_140039.png
