HeejunMoon53/MultimodalSensor/nn_decoupling/data_acquisition/Figure/collect_20260519_143611.png

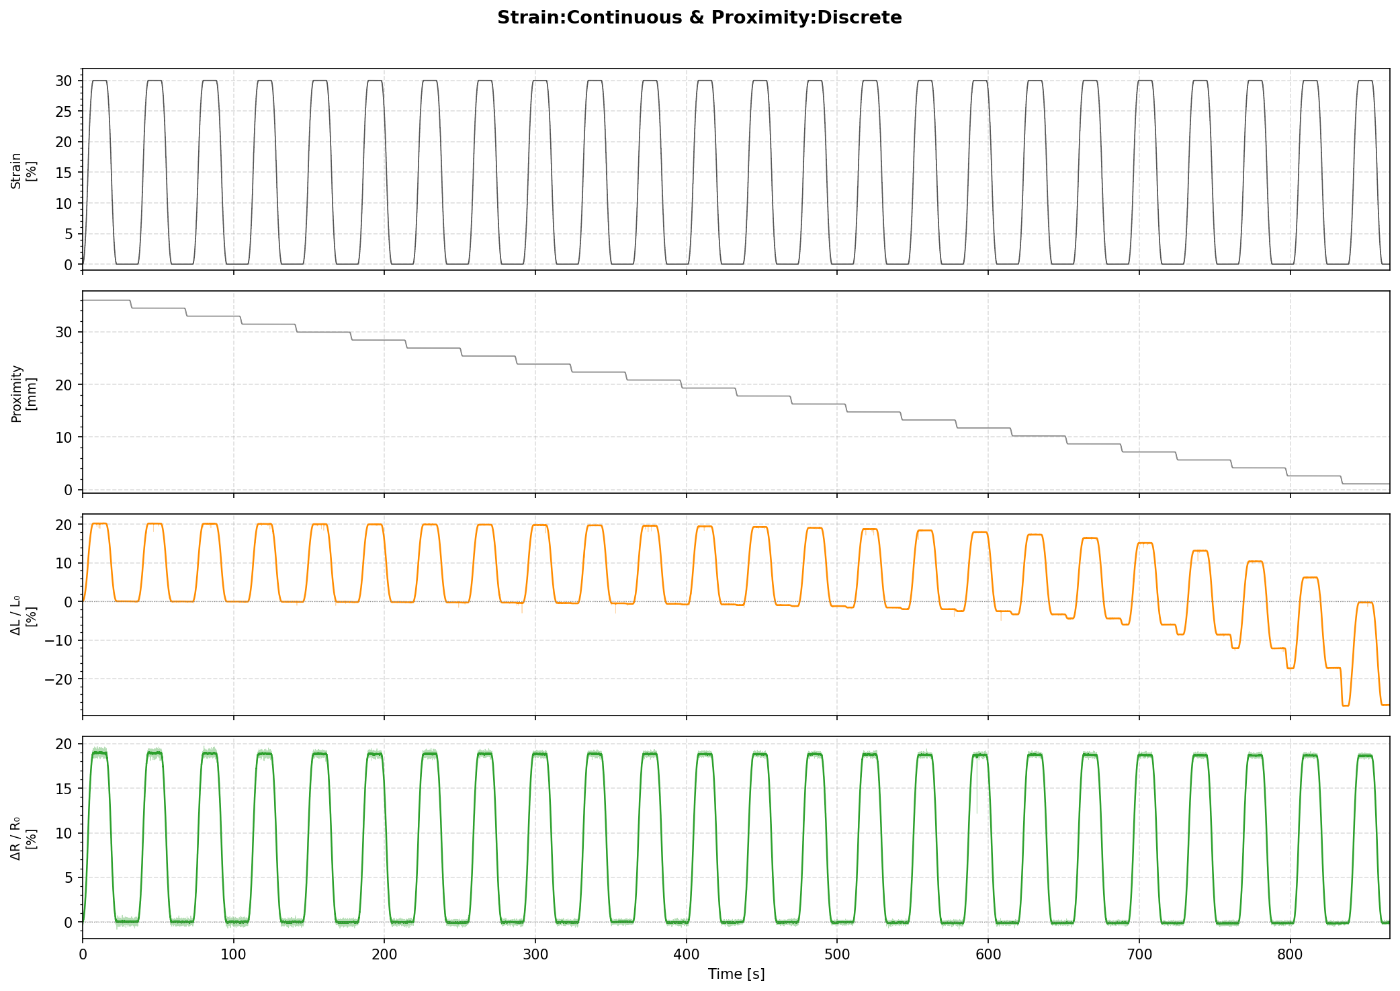
nn_decoupling/data_acquisition/Figure/collect_20260519_143611.png
