HeejunMoon53/MultimodalSensor/nn_decoupling/data_acquisition/Figure/compare_heatmap.png

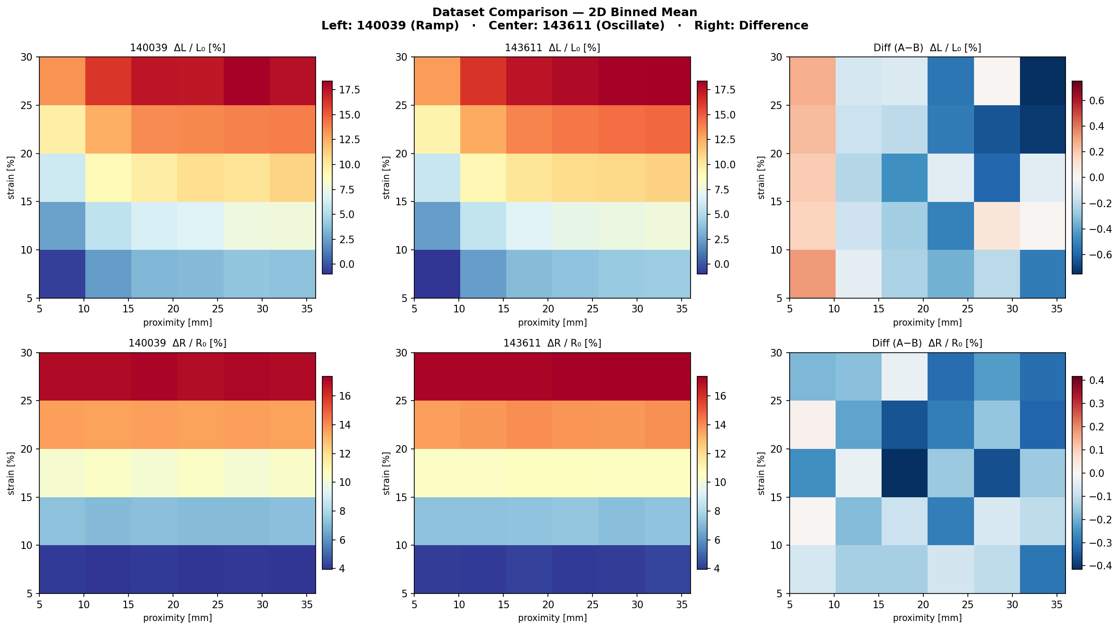
nn_decoupling/data_acquisition/Figure/compare_heatmap.png
