HeejunMoon53/MultimodalSensor/nn_decoupling/data_acquisition/Figure/compare_slices.png

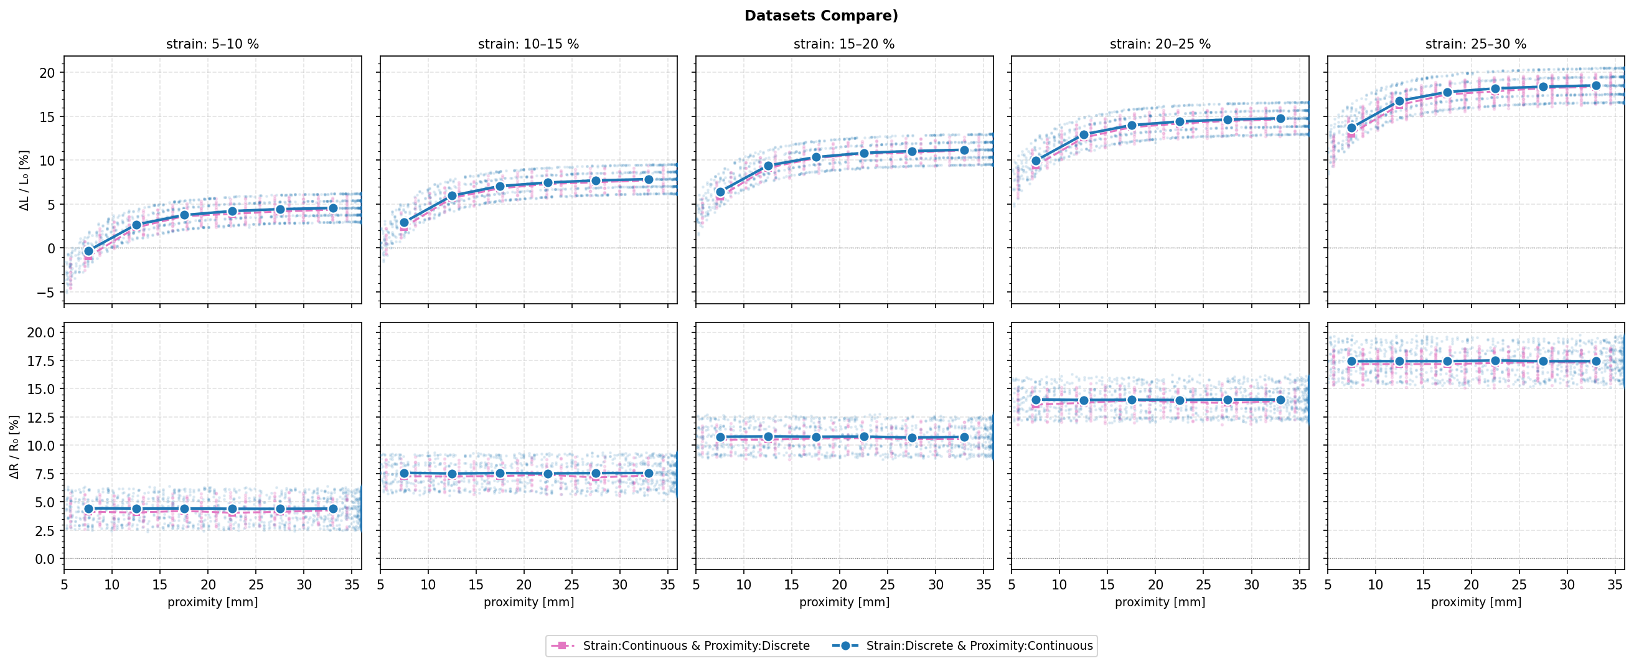
nn_decoupling/data_acquisition/Figure/compare_slices.png
