HeejunMoon53/MultimodalSensor/nn_decoupling/data_acquisition/Figure/heatmap_2d.png

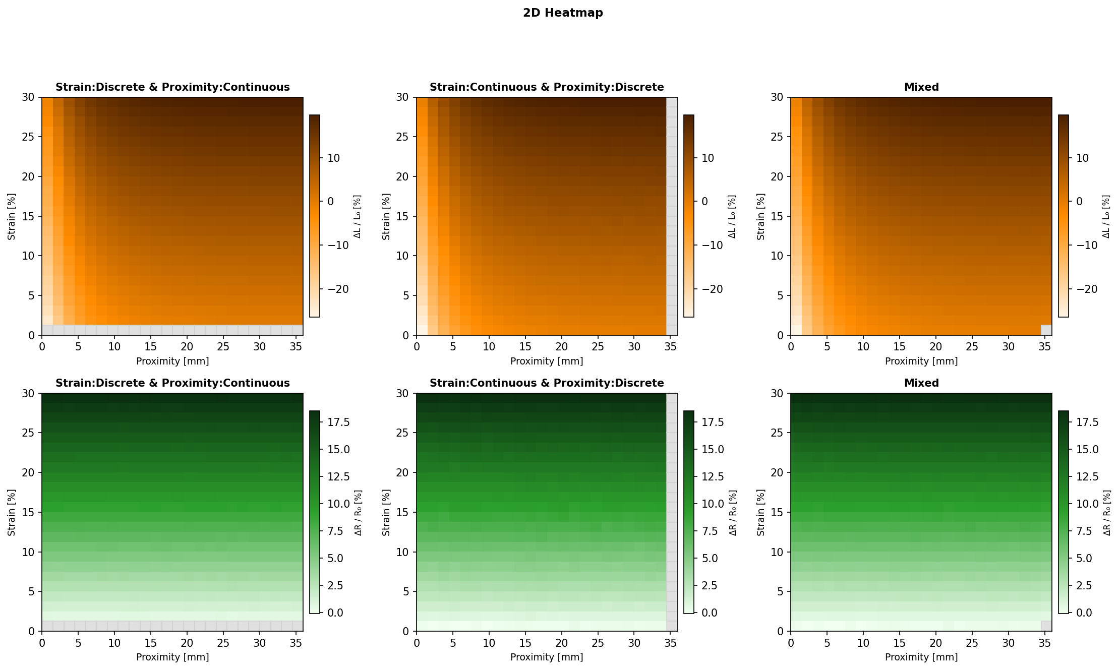
nn_decoupling/data_acquisition/Figure/heatmap_2d.png
