HeejunMoon53/MultimodalSensor/nn_decoupling/data_acquisition/Figure/heatmap_mixed.png

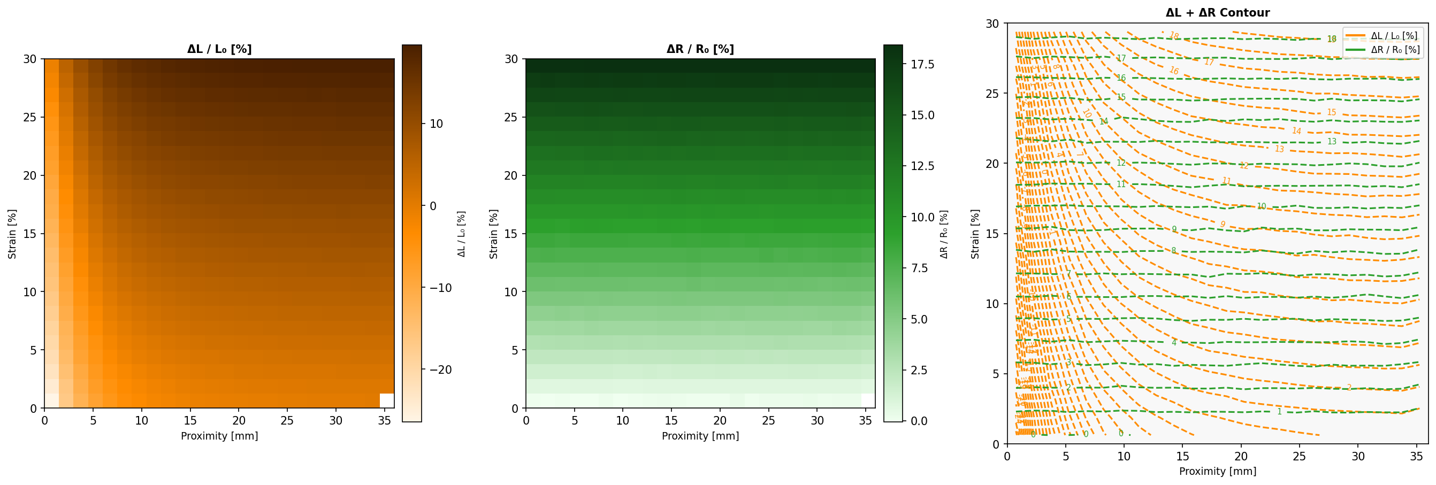
nn_decoupling/data_acquisition/Figure/heatmap_mixed.png
