HeejunMoon53/MultimodalSensor/nn_decoupling/data_acquisition/Figure/raw_clump.png

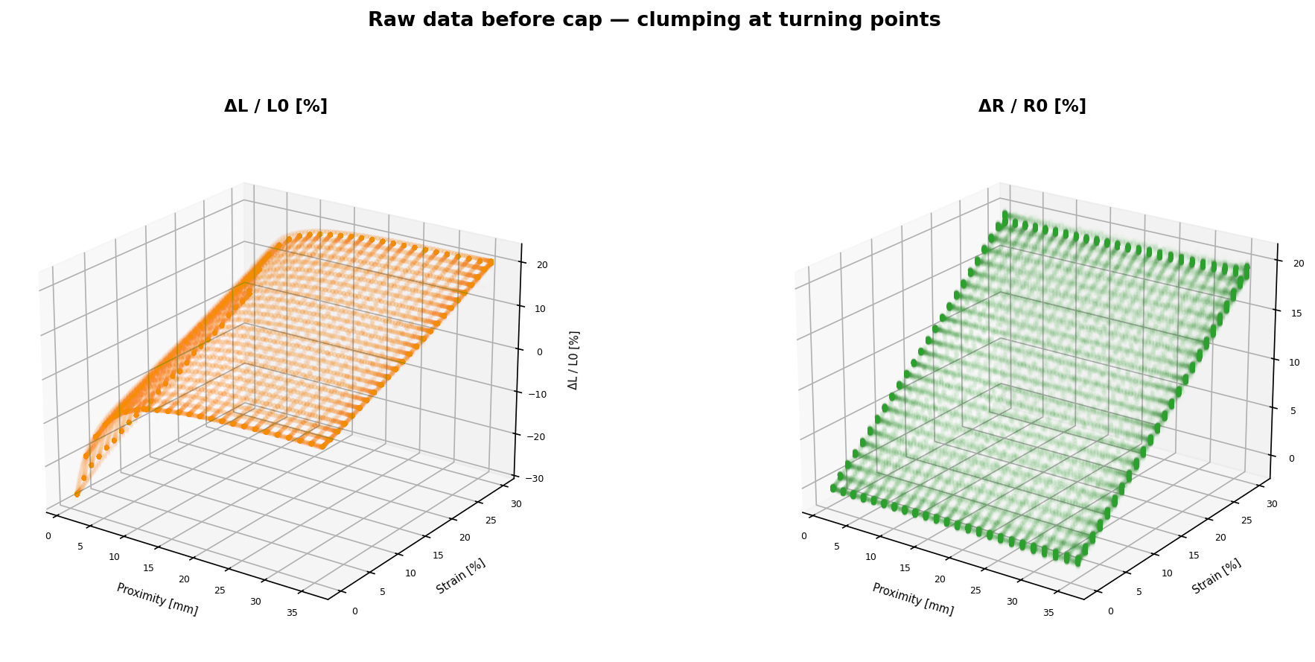
nn_decoupling/data_acquisition/Figure/raw_clump.png
