HeejunMoon53/MultimodalSensor/nn_decoupling/data_acquisition/Figure/scatter_3d.png

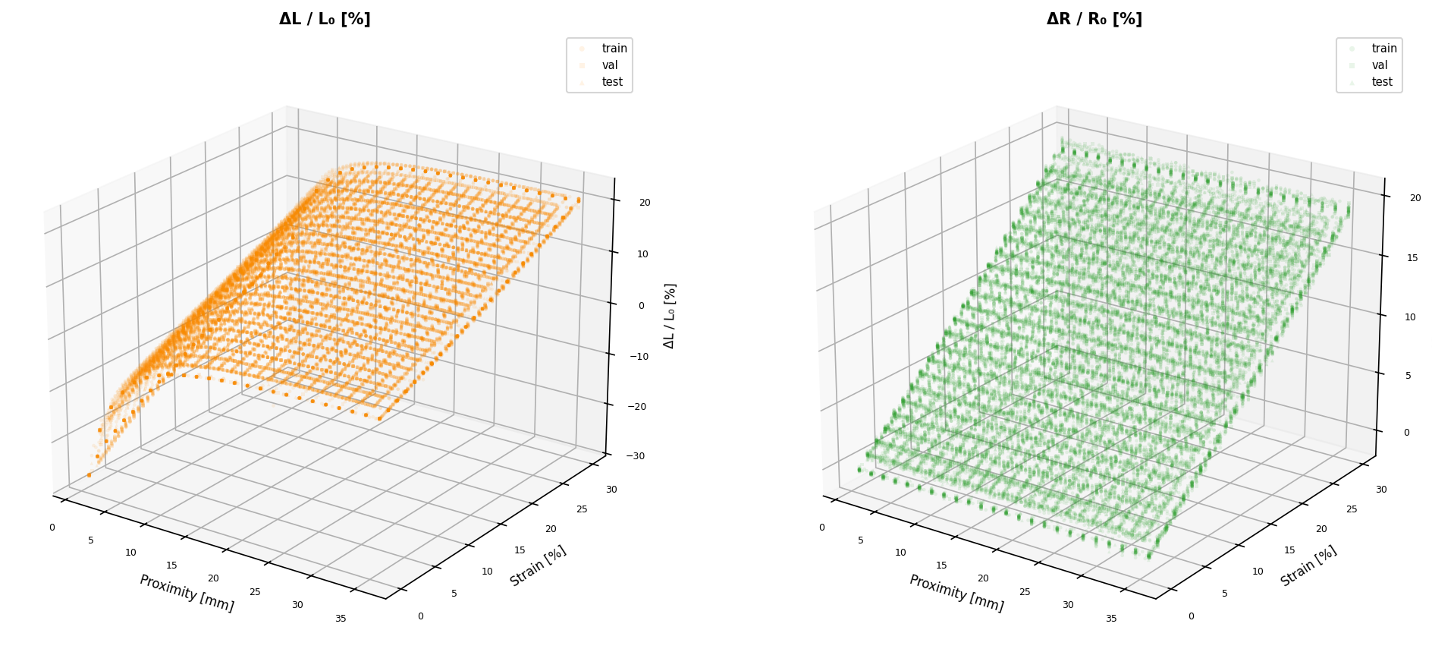
nn_decoupling/data_acquisition/Figure/scatter_3d.png
