HeejunMoon53/MultimodalSensor/nn_decoupling/data_acquisition/Figure/surface_3d.png

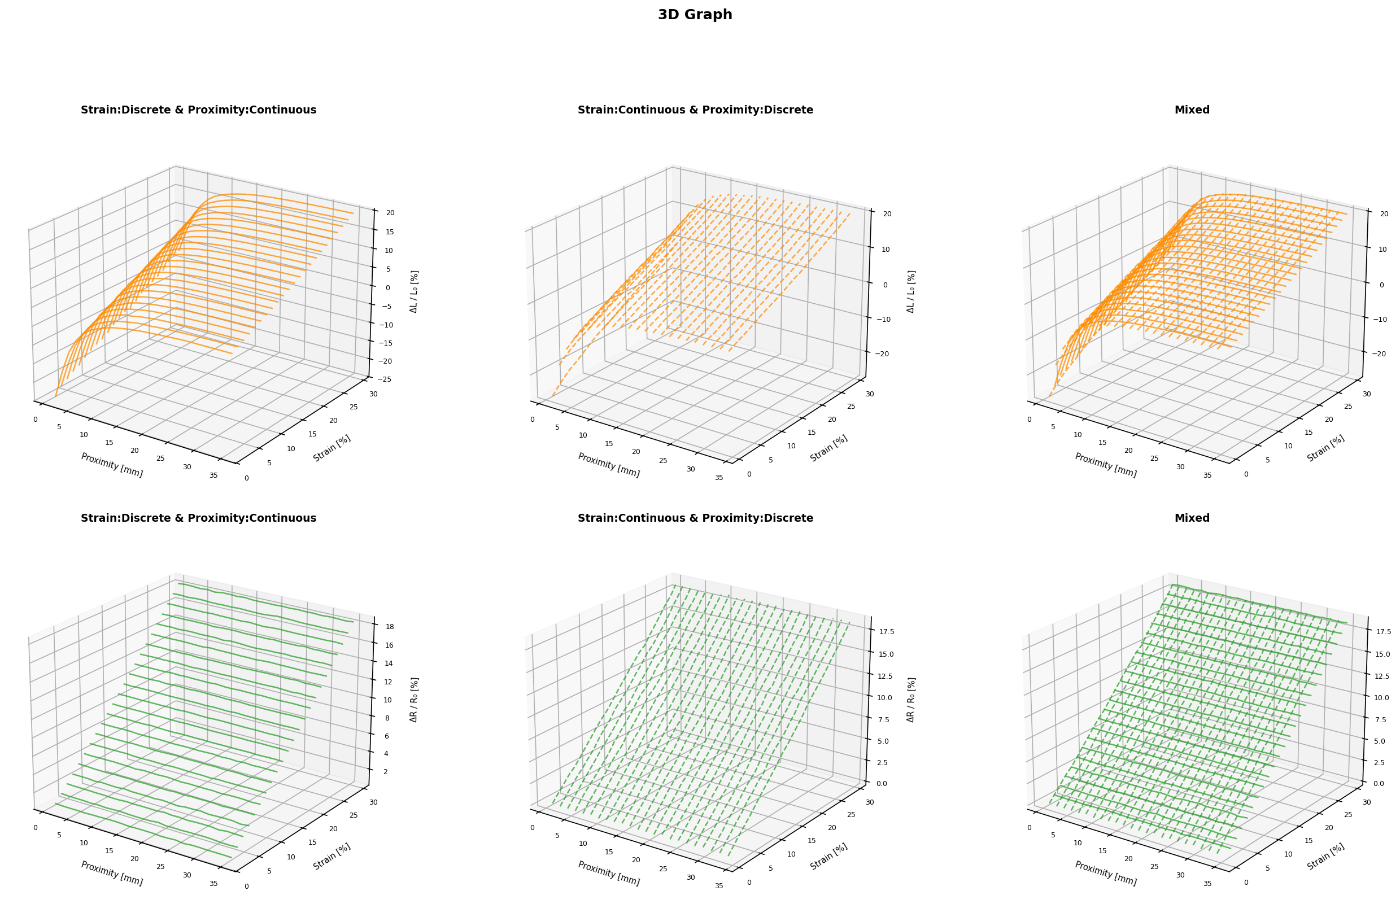
nn_decoupling/data_acquisition/Figure/surface_3d.png
