HeejunMoon53/MultimodalSensor/nn_decoupling/data_acquisition/Figure/surface_mixed.png

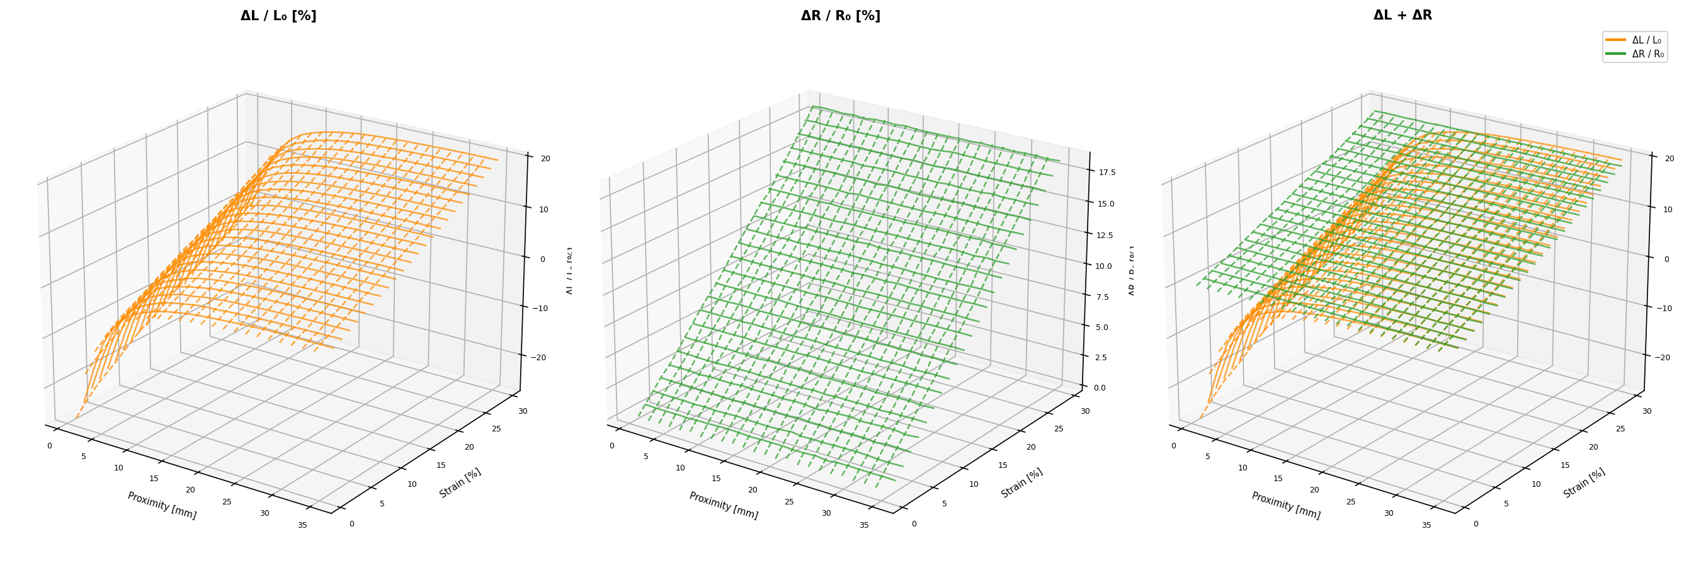
nn_decoupling/data_acquisition/Figure/surface_mixed.png
