HeejunMoon53/MultimodalSensor/nn_decoupling/figures/collect_20260518_173833_plot.png

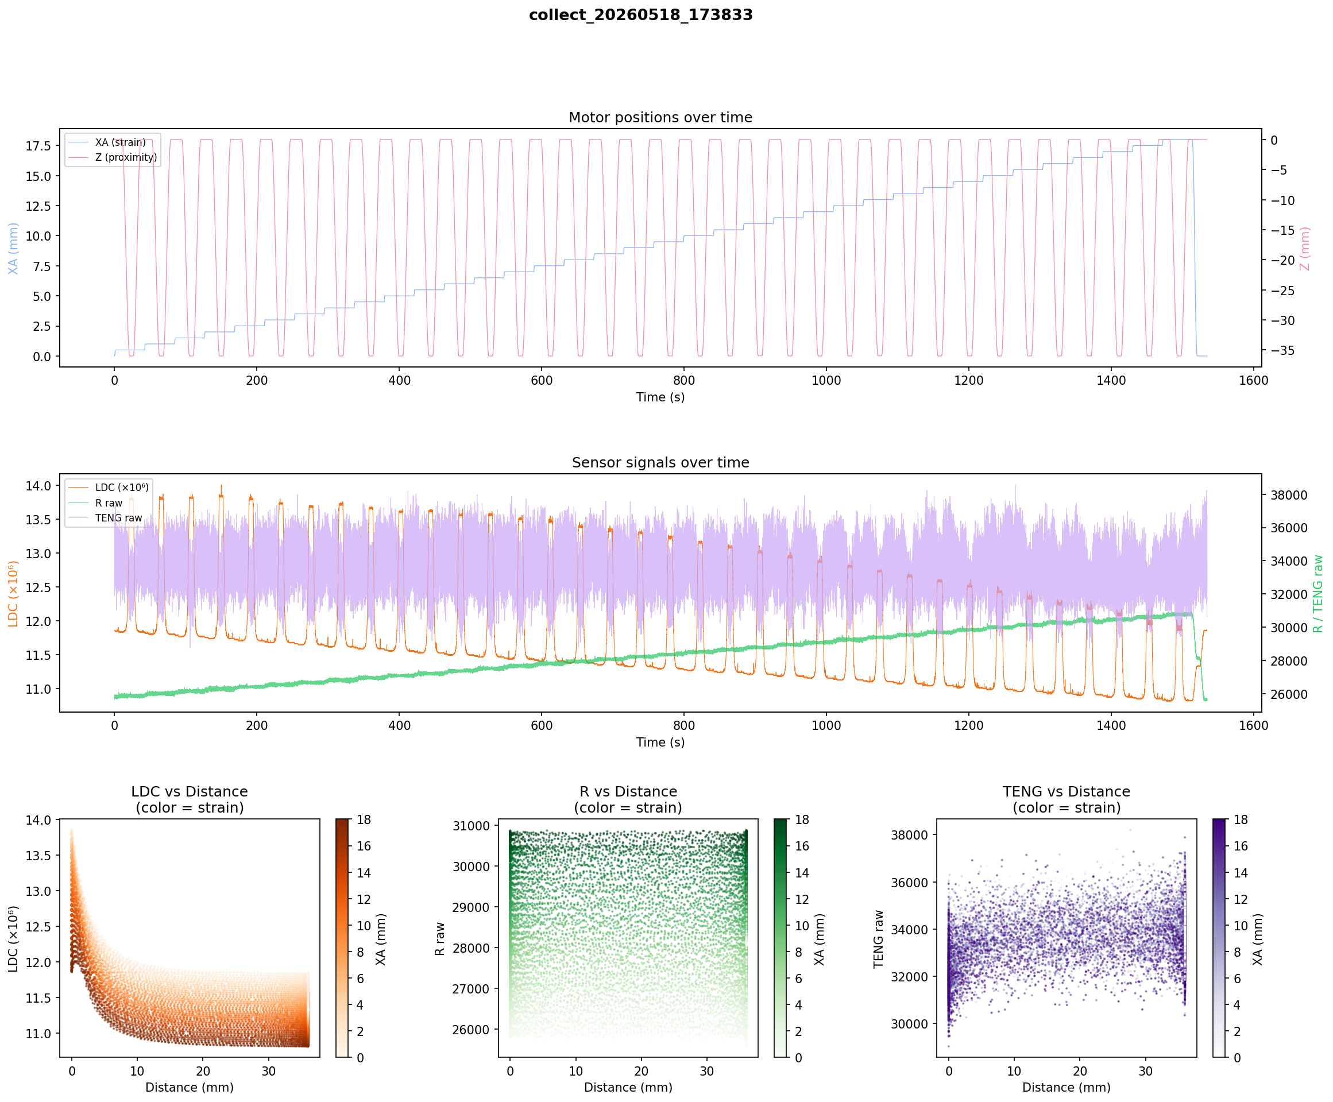
nn_decoupling/figures/collect_20260518_173833_plot.png
