HeejunMoon53/MultimodalSensor/nn_decoupling/figures/hand_3d.png

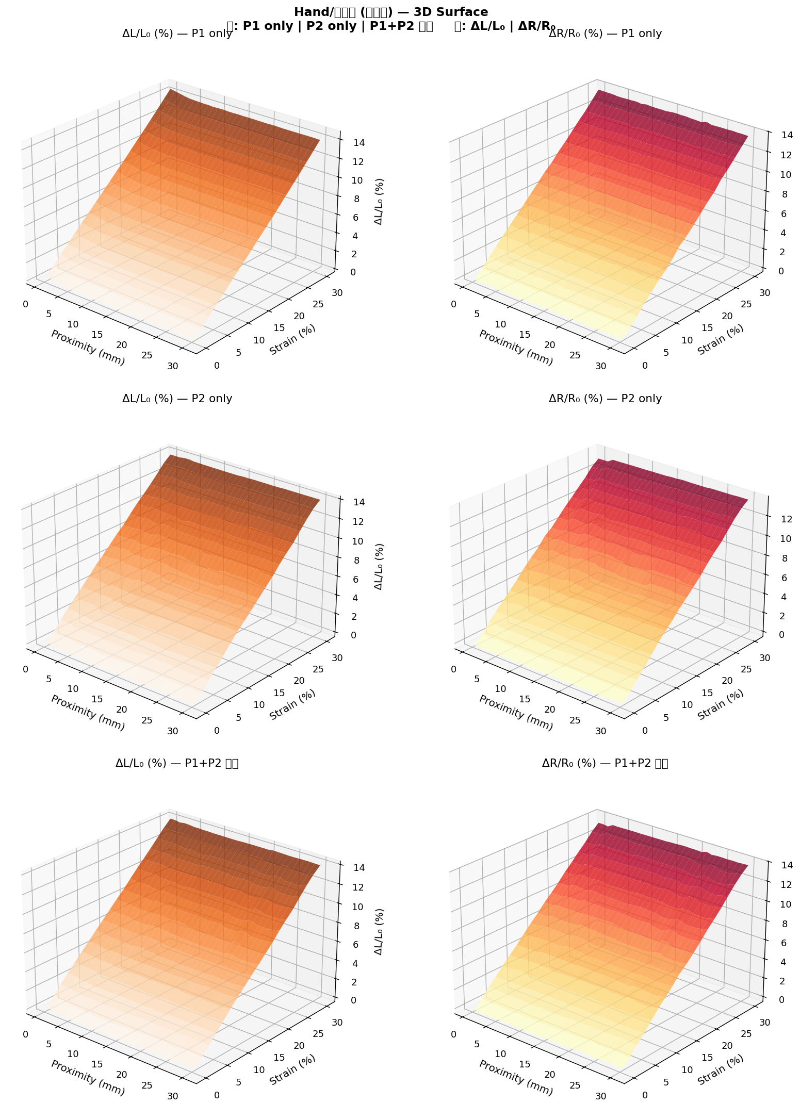
nn_decoupling/figures/hand_3d.png
