HeejunMoon53/MultimodalSensor/nn_decoupling/figures/hand_lines.png

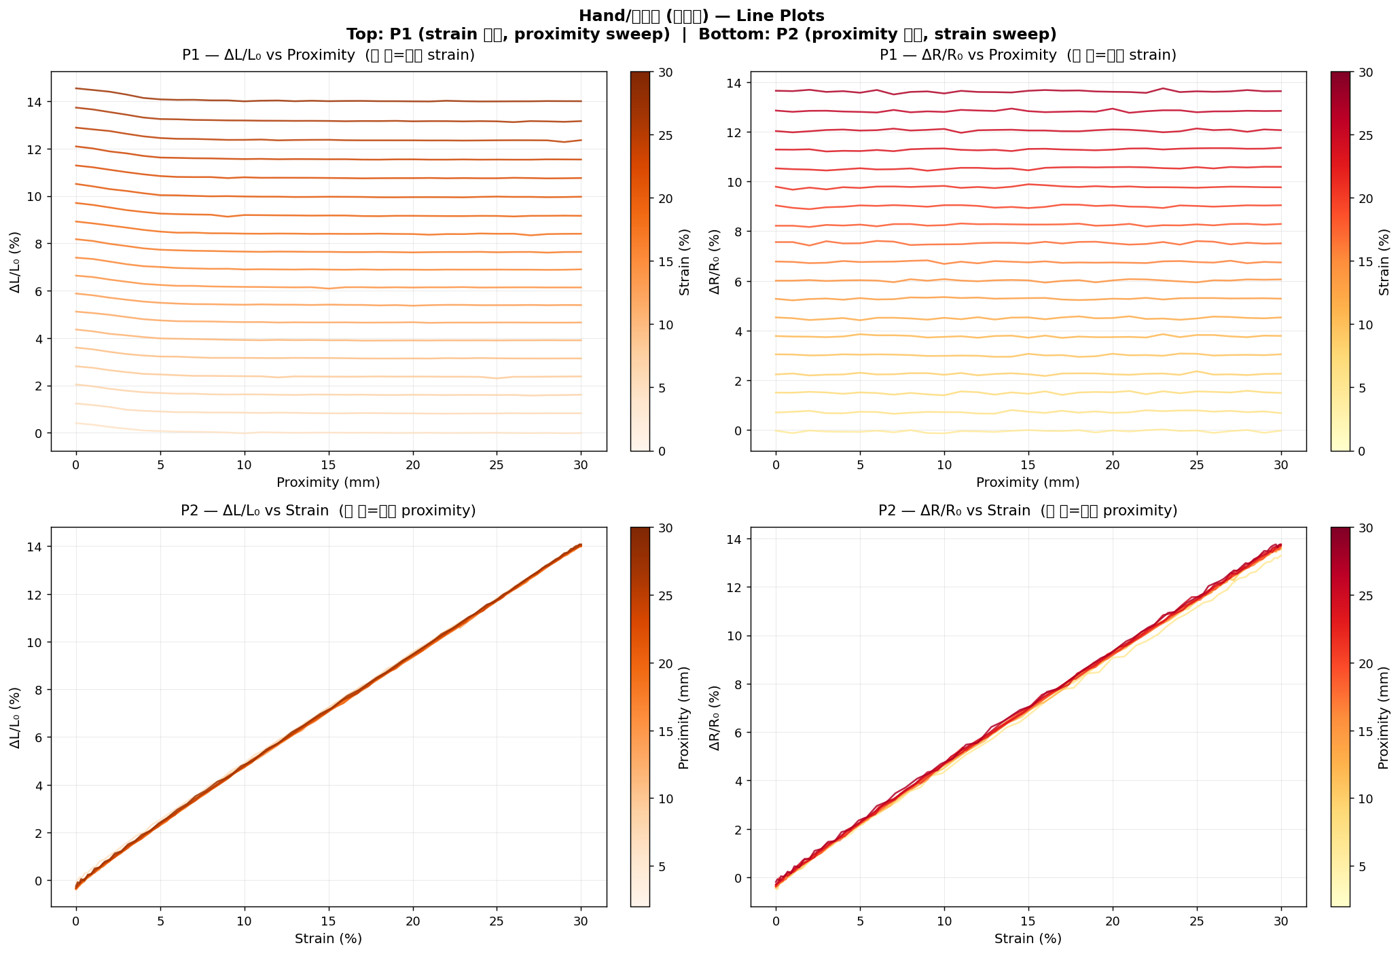
nn_decoupling/figures/hand_lines.png
