HeejunMoon53/MultimodalSensor/nn_decoupling/figures/metal_grid.png

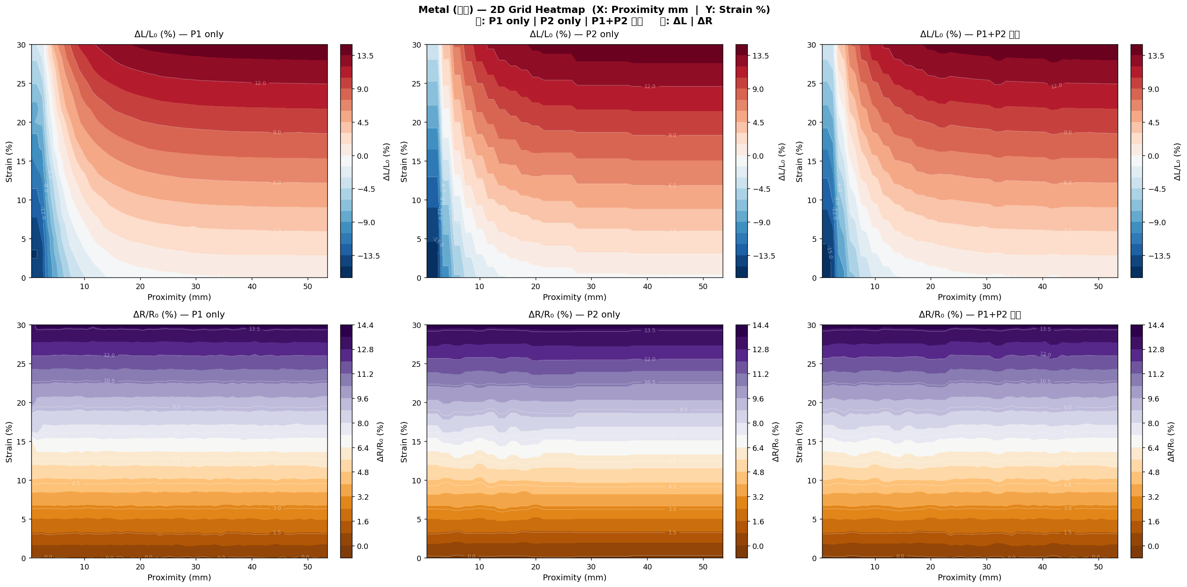
nn_decoupling/figures/metal_grid.png
