HeejunMoon53/MultimodalSensor/nn_decoupling/figures/metal_lines.png

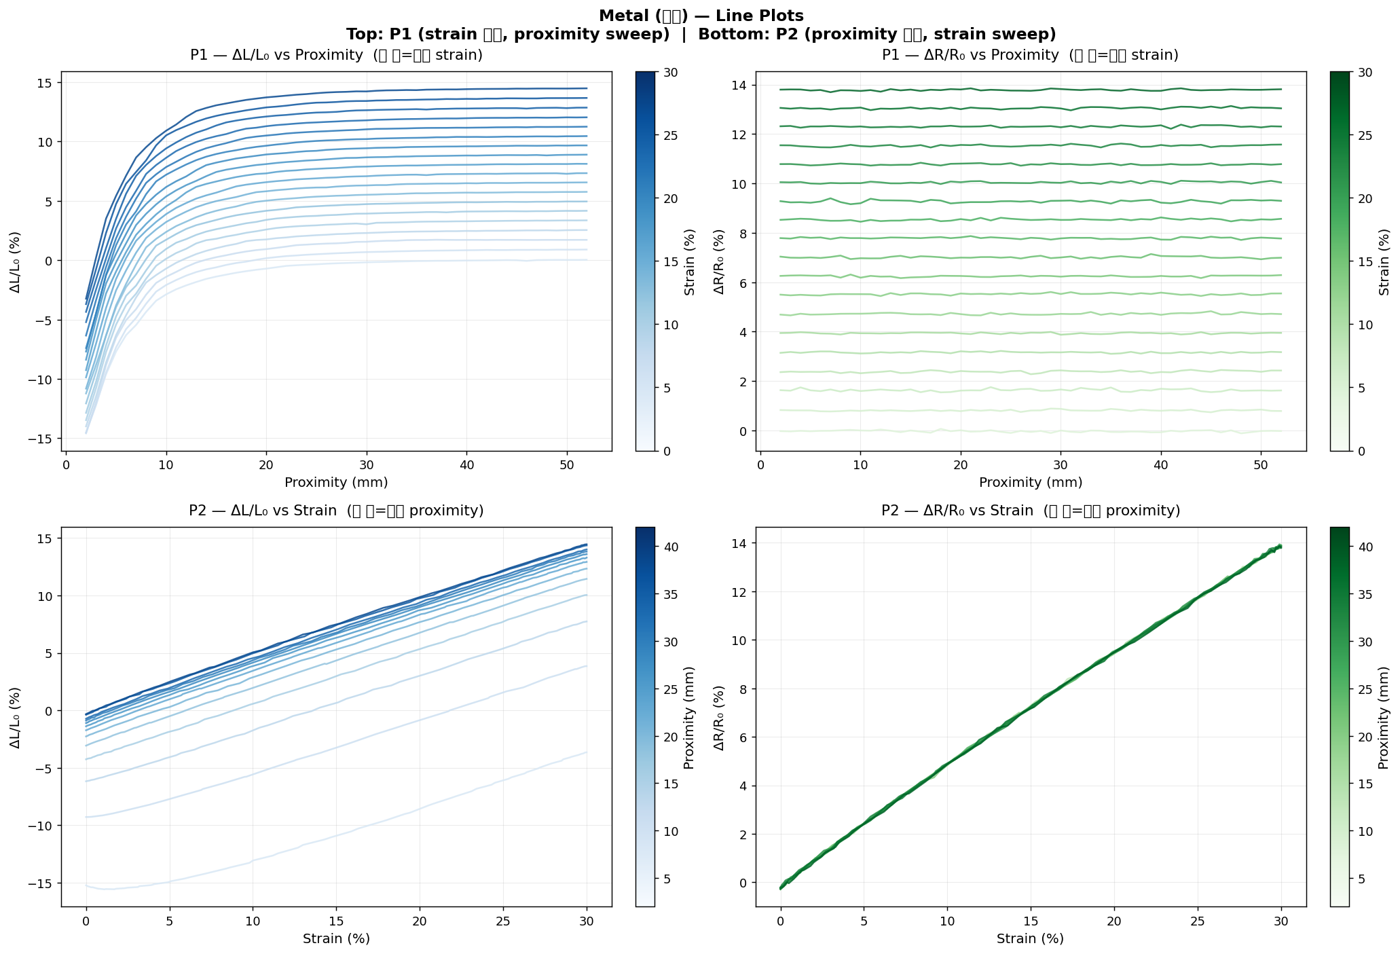
nn_decoupling/figures/metal_lines.png
