HeejunMoon53/MultimodalSensor/nn_decoupling/figures/overlap_contour.png

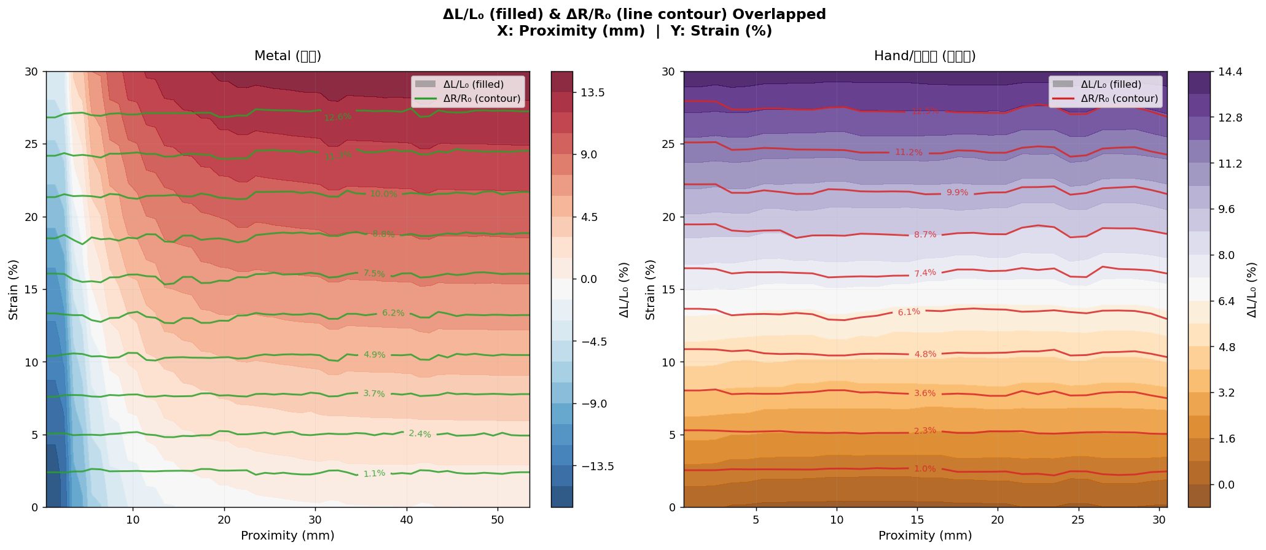
nn_decoupling/figures/overlap_contour.png
