HeejunMoon53/MultimodalSensor/Paper/figures/seminar_futurework.png

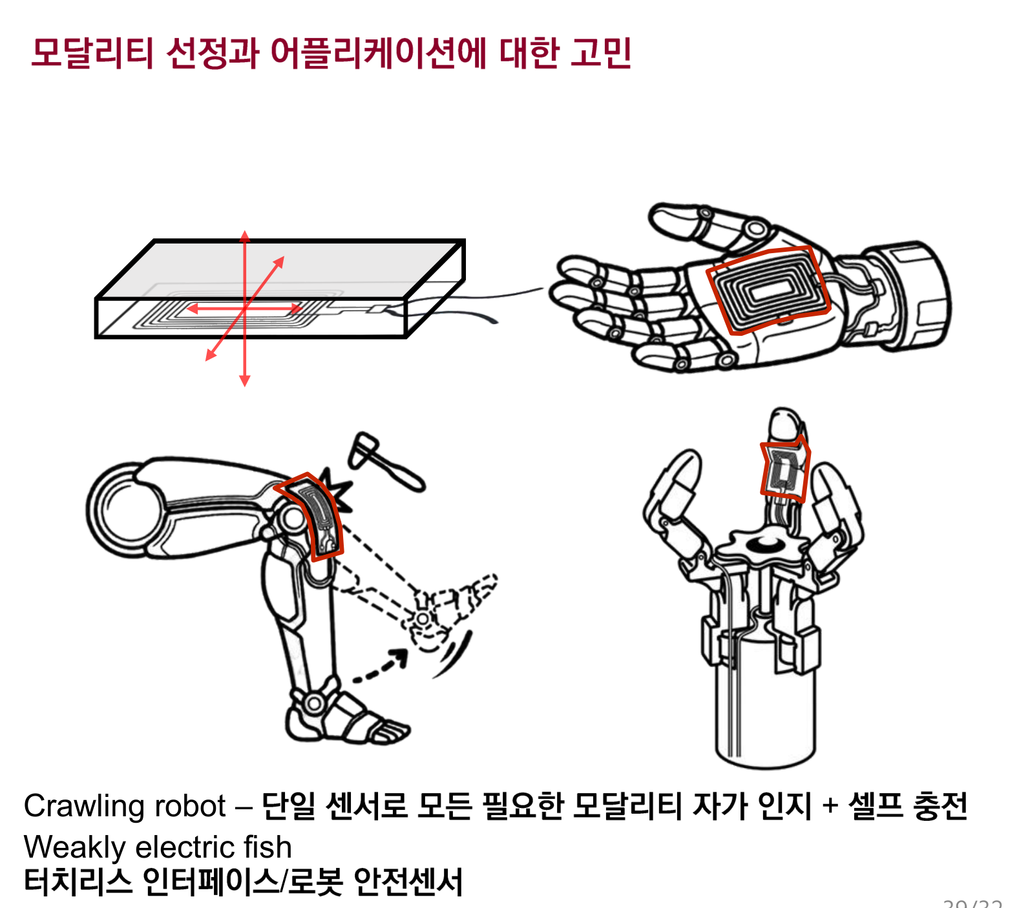
Paper/figures/seminar_futurework.png
