HeejunMoon53/MultimodalSensor/nn_decoupling/test0816_RealtimeDecoupling/moe_test_0816_report.html

Embedded Multimodal Sensor · Live Hardware Validation

# 0816 실시간 MoE 디커플링 테스트 분석

로그 파일 moe_monitor_20260816_183046.csv 구간 t=450.27s → 521.61s (71.3s) 샘플 수 6,518 초기 센서 길이 120mm 초기 Z축 25mm 실제 인가 strain YA/YB 0→18mm (0→30%) — 실측 로깅됨

업데이트 (2026-08-16 18:30 재측정) — YA 기준 strain ground truth 확보

이전 버전(moe_monitor_20260816_165533.csv)은 인장 스트레인의 실제값(Y축 위치)이 로깅되지 않아 strain 정확도를 평가할 수 없었다. 로깅 스크립트를 YA/YB 축 기준으로 strain_act_pct를 계산하도록 고친 뒤 재측정한 이 로그(...183046.csv)는 YA_mm이 0→18mm(YA+YB 합산 시 0→36mm, 즉 0→30% strain)까지 실제로 움직였고 그 값이 정확히 기록됐다. 아래는 이 유효한 데이터로 다시 계산한 결과다 — strain 관련 결론이 이전 버전과 완전히 달라진다.

Gate 정확도 99.2% GOOD 근접↔압력 전이 지연 외 오분류 없음

Strain 예측 R² 0.82 GOOD RMSE 3.56pt · bias +1.71pt

근접거리 예측 R² 0.58 FAIR RMSE 6.2mm · bias −3.1mm

압력(힘) 예측 R² 0.40 FAIR RMSE 2.32N · bias +1.33N

01 — RAW SIGNALS

## 원시 신호 (dL_pct / dR_pct)

테스트 전체 구간의 원시 인덕턴스·저항 변화율. 빨간 음영 = 실제 접촉 구간(Z_mm ≤ 0.05mm). YA/YB 축이 단계적으로 0→6→12→18mm로 움직이면서(그림 6 참고) dR_pct가 그에 맞춰 계단식으로 상승하는 것이 육안으로 보인다 — 저항 채널이 실제 인장 변형을 따라가고 있다는 뜻이다.

raw dL/dR signals over time

그림 1. dL_pct(주황)·dR_pct(초록) 시계열, 빨간 음영은 실제 접촉 구간

YA/YB stage position over time

그림 6. Y축(YA/YB, 인장 스트레인 축) 스테이지 위치 — 0→6→12→18mm 계단식 이동

02 — HEADLINE FINDING

## Strain 채널: dR_pct가 실제 인장 변형을 잘 따라간다 (R²=0.82)

이전 리포트의 미확정 가설이 해소됐다

실제 strain(YA 기준)이 로깅된 이번 데이터로 확인한 결과, 예측 strain_pct는 실제 strain_act_pct와 R²=0.82, 상관계수 0.93으로 강하게 일치한다. 그리고 dR_pct는 예측 strain(상관 0.90)뿐 아니라 실제 strain(상관 0.91)과도 거의 동일하게 강하게 상관돼 있다 — 즉 지난 리포트에서 제기했던 "dR_pct 급등이 압착 오염 신호인지, 실제 strain을 반영한 것인지"라는 질문은 후자로 판명됐다. R_DC는 CLAUDE.md의 이론 모델대로 축방향 인장 변형에 지배적으로 반응하고 있으며, 수직 압착에 의한 별도 오염 항을 물리 모델에 추가할 필요성은 이번 데이터로는 확인되지 않는다.

다만 bias는 +1.7%p(proximity 구간)에서 +2.4%p(pressure 구간)로 모드에 따라 커진다 — 완전히 무관하진 않고, 압착이 걸릴 때 약간의 추가 양의 편향이 낀다. 이건 "물리 모델에 새 항이 필요하다"기보다 "게인/오프셋 미세 보정" 수준의 문제로 보인다.

predicted strain vs actual strain

그림 2. 예측 strain_pct(빨강) vs 실제 strain_act_pct(회색, YA/YB축 실측). 빨간 음영 = 실제 접촉 구간

03 — MODE-WISE VALUE ACCURACY

## 근접거리(Proximity) / 압력(Pressure) 예측 정확도

게이트가 각 모드로 라우팅한 구간에서만, 해당 모드의 정답(Z_mm 또는 Fz_act_N)과 비교했다.

predicted value vs actual, split by mode

그림 3. 상단: 근접 모드 예측 거리 vs 실제 Z_mm · 하단: 압력 모드 예측 힘 vs 실제 Fz_act_N

scatter predicted vs actual

그림 4. 예측-실제 산점도 (점선 = y=x 완전 일치선). 좌: strain, 중: 근접거리, 우: 압력

채널 | n | RMSE | MAE | Bias | R²
Strain (전체) | 6,518 | 3.56 pt | 2.78 pt | +1.71 pt | 0.82
Strain · Proximity 구간 | 5,819 | 3.62 pt | 2.82 pt | +1.62 pt | 0.83
Strain · Pressure 구간 | 699 | 3.05 pt | 2.40 pt | +2.40 pt | 0.62
근접거리 (mm) | 5,819 | 6.23 | 3.89 | −3.08 | 0.58
압력 (N) | 699 | 2.32 | 1.91 | +1.33 | 0.40

04 — GATE BEHAVIOR

## 게이트(접촉 판별) 확인 — EMA 제거 수정이 유지되고 있음

Gate 정확도 99.2%. 남은 오분류도 접촉 경계 전이 구간의 정상적인 지연 패턴이었다(예: Z_mm이 threshold 근방일 때 gate_proba가 0→1로 부드럽게 스윕). 이전 세션에서 고친 "게이트가 접촉 상태에 고착되는" EMA 자기강화 버그의 재발 징후는 없다.

gate probability vs true contact

그림 5. gate_proba(보라)와 실제 접촉 여부(회색 점선)

05 — DIAGNOSIS

## 진단: 전반적으로 오프셋/게인 미세 보정 수준 — 대규모 재학습 불필요

지난 논의에서 두 가설을 구분했다 — (a) 오프셋/캘리브레이션 문제라면 RECAL·평균 기반 영점 보정으로 해결되고, (b) 민감도/게인 문제라면 재학습이 필요하다. YA 기준 실측 strain으로 재평가한 결과, 대부분 채널이 (a)에 가깝다:

- Strain (R²=0.82): 모델이 실제 인장 변형을 잘 잡아낸다. 남은 오차는 +1.7〜2.4%p의 작은 양의 bias — 스케일/구조 문제가 아니라 오프셋 보정으로 개선 여지가 있다. dR_pct가 물리 모델(R_DC(ε) = R_DC,0 × (1 + ε²))대로 strain에 지배적으로 반응한다는 것도 확인됐다 — 압착 오염 항을 추가할 근거는 이번엔 없다.
- Pressure force (R²=0.40, 이전 0.15 대비 개선): 이전 리포트에서 R²=0.15로 "거의 무관"하다고 진단했던 것은, 그 테스트에서 strain이 로깅되지 않은 채로 실제로는 변하고 있었을 가능성이 있어(당시엔 확인 불가) Expert B가 처리 못한 추가 변수였을 수 있다. 이번처럼 strain이 단계적으로 통제된 조건에서는 R²가 크게 개선됐다 — 즉 Expert B의 근본 문제라기보다 두 자극(strain+pressure)이 동시에 걸리는 조건에서의 데이터 부족일 가능성이 더 크다.
- Proximity distance (R²=0.58, bias −3.1mm): 이전 테스트와 거의 동일한 수치 — strain 여부와 무관하게 일관된 편향이다. Expert A의 근접거리 추정 자체에 검토가 필요하다.
- Gate 정확도 99.2%는 두 테스트 모두 안정적 — EMA 제거 수정이 여러 조건에서 견고하게 작동한다.

06 — TRAIN vs LIVE GAP

## 왜 학습 시 R²>0.9인데 실시간에서는 이만큼 떨어지나

학습·held-out 평가에서 R²>0.9였던 것과 실시간 로그의 R²(strain 0.82, proximity 0.58, pressure 0.40)의 격차를 두 가지 독립적인 원인으로 분해했다 — (A) 타이밍/지연과 (B) 입력공간의 특정 구석(strain≈0)에서의 일반화 실패. 시간축 지연 보정(lag cross-correlation)과 strain 구간별 분리 분석으로 각각을 직접 측정했다.

원인 A — Pressure 채널에 ~0.25초의 실질 지연이 있다 (타이밍 문제, 확인됨)

예측 force(value, mode=pressure)를 실제 Fz_act_N에 대해 −1.0초〜+1.0초로 밀어보며 상관계수가 최대가 되는 지점을 찾았다. +0.25초 지연 보정 시 상관계수 0.886→0.980, RMSE 2.29N→1.74N으로 크게 개선된다 — 즉 모델의 힘 출력이 실제 힘보다 약 250ms 늦게 따라간다. 이 지연의 출처는 두 겹이다: (1) Arduino 위치 폴링이 100ms 주기라 ground truth 자체가 평균 130〜180ms 낡아 있고, (2) 그걸 감안해도 남는 나머지는 모델/필터 쪽의 실제 지연 — R_DC IIR 필터(alpha=0.02)와 EMA 피처(시간상수 ~0.7초, moe_inference.h 주석 참조)가 만드는 위상 지연이다. Strain은 lag 보정을 해도 거의 개선되지 않았다(RMSE 3.567→3.527) — strain의 오차는 타이밍이 아니라 실제 오차다. Proximity는 중간 정도(+0.75초에서 소폭 개선, corr 0.824→0.831) — 완만한 Z 스윕이라 지연의 영향이 덜 드러난다.

pressure value vs actual with and without lag correction

그림 7. 압력 사이클 구간에서 예측 force(빨강)와 −0.25초 보정본(파랑 점선)을 실제 Fz(회색)와 비교. 보정 후 피크 타이밍이 훨씬 잘 맞는다.

원인 B — Proximity(근접거리) 추정이 strain≈0%에서만 붕괴한다 (일반화 실패, 확인됨)

근접거리 R²를 strain 구간별로 쪼개보면 완전히 다른 그림이 나온다: strain=0%에서 R²=−3.6(평균값을 찍는 것보다 못한 수준, bias −8.1mm) — 반면 strain≈10%에서 R²=0.90, strain≈20〜30%에서 R²=0.99로 사실상 거의 완벽하다. 이전 리포트의 "R²=0.58, bias −3.1mm"는 이 극단적으로 다른 두 구간이 섞여서 나온 평균일 뿐이었다. strain=0% 구간은 테스트 전체에 걸쳐 여러 번 반복됐고(1481 rows, 시작 시점 한 번이 아님) 매번 같은 방식으로 실패한다 — 즉 EMA 워밍업 같은 일시적 현상이 아니라 "strain=0에 가까운 입력 코너"에서 모델이 구조적으로 약하다는 뜻이다. 흥미롭게도 이 구간의 raw dL_pct/dR_pct도 정확히 0이 아니라 각각 −0.25%/−0.08% 정도의 작은 오프셋을 보인다 — 절대적으로는 작지만, strain=0 근방은 신호의 전체 동적 범위 자체가 좁기 때문에(strain이 커질수록 dL/dR 스윙이 훨씬 커짐) 같은 크기의 오프셋이라도 상대적 영향은 strain=0에서 훨씬 크게 증폭된다. 이건 이 세션 초반에 논의했던 캘리브레이션-오프셋 민감도 가설과 정확히 같은 패턴이다.

proximity accuracy by strain bin, showing collapse at strain=0

그림 8. 근접거리 예측-실제 산점도, strain 구간별 색 구분. 빨강(strain=0%)만 대각선(y=x)에서 크게 벗어난다.

정리. "실시간에서 디커플링이 잘 안 된다"는 인상은 하나의 원인이 아니라 최소 두 가지 서로 다른 문제가 겹친 것이다 — pressure는 타이밍 문제(모델 출력이 실제보다 늦게 따라옴), proximity는 strain=0 근방 입력 코너에서의 일반화 실패(캘리브레이션 오프셋에 대한 민감도). Strain 자체는 두 문제 모두에 크게 해당하지 않고 R²=0.82로 비교적 잘 작동한다 — 남은 오차는 주로 pressure 구간에서의 작은 추가 bias(+2.4%p) 정도다.

07 — EMBEDDED vs PC OFFLINE

## 오차가 raw 신호의 한계인지, 임베디드 파이프라인(EMA·필터) 탓인지

같은 로그의 raw dL_pct/dR_pct 두 값만으로, EMA·시간 이력 없이 그 순간 값만 보고 예측하는 작은 MLP를 PC에서 새로 학습시켜(held-out 평가) 보드의 실시간 출력과 비교했다. 이 실험은 "raw 신호 자체에 정보가 부족한 것인지, 아니면 배포된 임베디드 파이프라인(저항 IIR 필터·EMA·구버전 학습 데이터)이 그 정보를 못 살리고 있는 것인지"를 분리하기 위한 것이다.

R2 comparison bar chart, embedded vs offline

그림 9. 채널별 R² — 임베디드 실시간(빨강) vs PC 오프라인 point-wise 모델(청록). 세 채널 다 PC 쪽이 더 높다.

채널 | 평가 | n | RMSE | Bias | R²
Strain | 임베디드 실시간 | 6,518 | 3.56 pt | +1.71 pt | 0.82
Strain | PC 오프라인(시간순 분할) | 1,956 | 3.20 pt | −1.57 pt | 0.88
Proximity | 임베디드 실시간 | 5,819 | 6.23mm | −3.08mm | 0.58
Proximity | PC 오프라인(시간순 분할) | 1,746 | 0.89mm | +0.02mm | 0.99
Pressure | 임베디드 실시간 | 699 | 2.32N | +1.33N | 0.40
Pressure | PC 오프라인(무작위 분할) | 210 | 1.50N | −0.26N | 0.75

Pressure만 시간순 대신 무작위 분할을 썼다 — 이 로그에는 압력 이벤트가 ~15초짜리 단 1회뿐이라, 시간순으로 자르면 held-out이 그 한 번의 이벤트 뒷부분만 남아 사실상 외삽이 되어버린다(실제로 시간순 분할로는 R²=−5.4까지 나왔다).

offline model scatter plots, 3 channels

그림 10. PC 오프라인 모델의 예측-실제 산점도. Proximity(가운데)가 거의 완벽한 대각선을 그린다.

proximity embedded vs offline vs actual over time

그림 11. Proximity 채널: 실제 Z_mm(회색), 임베디드 실시간 예측(빨강, 항상 표시), PC 오프라인 예측(청록 점, held-out 구간만). 점선 오른쪽이 오프라인 모델의 held-out 구간이다.

결론: raw 신호는 충분하다 — 격차는 대부분 임베디드 파이프라인 쪽

세 채널 모두 PC 오프라인 쪽이 더 정확했다. 특히 Proximity는 0.58 → 0.99로 격차가 압도적이다 — raw dL_pct/dR_pct만으로 거의 완벽하게 거리를 맞힐 수 있다는 뜻이므로, 실시간에서 안 맞는 건 신호 부족이 아니라 배포된 모델 자체(학습 데이터 불일치, strain=0 코너에서의 캘리브레이션 민감도 — 섹션 02 참고) 문제일 가능성이 크다. Pressure도 0.40 → 0.75로 뚜렷한 격차가 있다. Strain은 0.82 → 0.88로 격차가 작아, 이 채널은 이미 raw 신호가 허용하는 수준에 가깝게 동작하고 있다.

단, 이 비교만으로 "EMA가 범인이다"까지는 확정할 수 없다. PC 오프라인 모델은 이번 0816 세션과 같은 데이터로 학습·평가됐지만, 보드에 실제로 올라간 모델은 더 이전의 다른 세션 데이터로 학습된 것이다 — 그래서 지금 격차에는 (a) EMA·저항 필터가 만드는 실제 지연, (b) 학습 데이터와 이번 배포 세션의 캘리브레이션/조건 불일치, 이 두 가지가 섞여 있다. 이미 준비된 realtime_train_seq.txt(저항 IIR 제거된 새 펌웨어로 수집)로 재학습 후 다시 실시간 테스트했을 때 R²가 이 PC 오프라인 수치에 가깝게 올라오면 (b)가 주원인이었다는 뜻이고, 그래도 격차가 남으면 그때 EMA 자체를 의심하면 된다. → 섹션 08에서 실제로 해봤다.

08 — V2 재학습 모델 실시간 검증

## 재학습 후 실제로 돌려본 결과 — Gate·Strain은 개선, Pressure는 오히려 후퇴

섹션 07에서 남겨둔 질문에 대한 답이다. moe_monitor_20260817_002534.csv(저항 IIR 제거·500Hz 펌웨어로 수집, 접촉 판정 기준을 Z_mm≤-24.5로 정정)로 재학습한 v2 모델을 TDMFirmware/X-CUBE-AI/App/에 실제로 얹은 뒤, moe_monitor_20260817_011424.csv(정리 후 92,265행, 461초)로 다시 실시간 테스트했다.

채널 | 구모델 · 실시간(0816) | v2 · 오프라인 held-out | v2 · 실시간(0817)
Gate 정확도 | 98.6~99.2% | 94.0% | 99.2%
Strain R² | 0.82 | 0.99 | 0.86
Proximity R² | 0.58 | 0.92 | 0.67
Pressure R² | 0.40 | 0.85 | 0.31

v2 realtime predicted vs actual scatter, 3 channels

그림 12. v2 실시간 예측-실제 산점도 (strain / proximity / pressure, force는 "양수=누르는 방향" 규약으로 표시)

v2 realtime full-session time series

그림 13. v2 실시간 전체 구간(461초) 시계열 — 실제값(회색) vs 예측(색)

Gate·Strain은 구모델을 넘어섰다, Pressure는 지연이 그대로 남아있다

Gate(99.2%)와 Strain(R²=0.86)은 이제 구모델의 실시간 성능을 넘어섰고 오프라인 수치에도 상당히 가까워졌다. Proximity(R²=0.67)도 구모델(0.58)보다 나아졌지만 오프라인(0.92)과는 여전히 격차가 있다.

반면 Pressure는 R²=0.31로 구모델(0.40)보다 오히려 낮다. 지연(lag) 스캔을 다시 돌려보니 — 저항 IIR 필터를 이미 뺐고 이번엔 학습 데이터도 같은 세션 것인데도 — 예측이 실제보다 여전히 약 0.35초 늦게 따라온다(0-lag 상관 0.62 → 최적 lag 상관 0.74, RMSE 4.26N→3.49N). 오히려 이전(0816, 약 0.25초)보다 늘었다. 필터를 뺐는데도 지연이 안 사라졌다는 것은, 남은 지연의 주범이 EMA 시간상수(τ≈1초, halflife≈0.7초)라는 뜻에 가깝다 — 섹션 07에서 미확정으로 남겨뒀던 (a)/(b) 중 (a)가 상당 부분을 차지한다는 증거다.

데이터 정리 관련 (업데이트). 이번 로그는 UART 손상 행이 mode 필드뿐 아니라 gate_proba·dL_pct·dR_pct·dV_pct·strain_pct·value 필드 전반에 흩어져 있었다(예: strain_pct=72 같은 튐값). gate_proba가 확률이라 [0,1] 범위를 벗어나면 무조건 손상이라는 점에 착안해, 이를 포함한 6개 컬럼 전체에 범위 검사를 거는 필터로 정리를 강화했다(총 92,300 → 92,267행, 33행 제거). 그런데도 pressure 산점도에 실제 힘 범위(≈-14~14N)를 벗어난 +21N급 튐이 2건 남아있었다(그중 하나는 mode=press인데 gate_proba=0.000으로 자기모순 — 명백한 UART 손상) — value 범위 검사를 press/prox 모드별로 분리해 press는 상한을 30→20으로 좁혀 마저 제거했다(최종 92,265행, 35행 제거). 학습 스크립트(retrain_moe_v2.py)에도 동일한 필터를 반영해 재학습·재배포했다.

Force 부호 규약 변경. 이번 세션의 RFT 원시값(Fz_act_N)은 누를수록 음수로 나와(이전 세션과 반대), 학습·배포 양쪽 모두 "누르면 힘이 양수로 커진다"는 기존 규약으로 통일해 부호를 반전시켰다(오프셋 보정 포함). 단, 이 그래프의 로그(...011424.csv)는 부호 반전 이전에 배포됐던 v2 모델로 캡처된 것이라, 표시를 위해 예측값(value)의 부호만 사후 보정해서 실측(Force_N, 새 규약)과 비교했다 — R²/RMSE/상관계수는 부호에 대해 대칭이라 이 보정이 지표 자체를 바꾸지는 않는다. 지금 보드에는 부호가 이미 반영된 새 v2 펌웨어가 올라가 있으므로, 다음 실시간 캡처부터는 value 컬럼이 바로 "양수=누르는 방향"으로 나온다 — 위 표의 새 오프라인 Pressure R²(0.85)도 이 개정판 학습 결과다.

09 — RECOMMENDATIONS

## 모델 개선 제안

1. HIGH Pressure 채널의 EMA 시간상수 축소 또는 제거 확인됨
  섹션 08에서 실제로 확인됐다 — 저항 IIR 필터를 빼고 학습 데이터도 같은 세션 것으로 맞췄는데도 지연이 오히려 늘었다(~0.35초). 평가 측 staleness(Arduino 폴링 100ms)로는 이 정도 지연을 설명 못 하므로, 남은 원인은 EMA 시간상수(τ≈1초)가 사실상 확정적이다. halflife를 0.7초에서 0.2〜0.3초로 줄이거나, pressure expert만 EMA 없이(gate처럼 2-input) 재학습해서 비교해볼 것을 권장.
2. HIGH strain≈0% 코너를 위한 캘리브레이션 민감도 완화
  이 구간의 실패가 "학습 부족"이 아니라 "작은 오프셋의 상대적 증폭"이라면, 데이터를 더 모으는 것보다 (1) 배포 시 캘리브레이션 기준점이 학습 데이터 수집 시점의 기준점과 최대한 일치하는지 확인하고, (2) 학습 시 dL0/dR0 기준점에 인위적으로 작은 jitter를 섞어(data augmentation) 모델이 이 코너에서 오프셋에 더 강건해지도록 만드는 것이 근본적인 해결책에 가깝다.
3. MED 데이터 수집→학습→임베딩→실시간 테스트를 한 세션 안에서 즉시 수행 시도함
  0817 세션에서 실제로 해봤다 — Gate(99.2%)·Strain(R²=0.86)은 이 방식으로 구모델의 실시간 성능을 넘어섰지만, Pressure(R²=0.31)는 오히려 후퇴했다. 즉 이 방법은 calibration/학습데이터 불일치 문제에는 효과가 있지만, EMA 지연 문제는 별도로 해결해야 한다는 것이 이번에 갈린 결론이다.
4. MED Strain·Pressure 동시 인가 조건에서 추가 데이터 수집
  strain이 단계적으로 고정된 이번 조건에서는 압력 R²가 0.15→0.40으로 크게 올랐다 — strain과 pressure가 동시에 연속적으로 변하는 조건이 학습 데이터에 부족했을 가능성이 있다. "strain 스윕 + pressure 스윕"을 동시에 하는 시험 추가를 검토.
5. MED UART 출력 컬럼(strain_pct/value)에도 손상 대비 검증 추가
  0817 실시간 로그에서 mode뿐 아니라 strain_pct/value에도 손상된 값(72 같은 튐)이 섞여 있었다 — 지금은 사후 분석에서 range 필터로 거르고 있지만, 모니터링 툴 자체에 출력 range 체크를 넣거나 baud/print rate를 한 번 더 점검해볼 것.
6. LOW 현재 진행 중인 캘리브레이션 평균화 수정은 유지
  두 테스트 모두 dR_pct가 시작/끝에서 거의 0으로 돌아와 베이스라인 캘리브레이션 자체는 안정적임이 확인됐다. 리셋 직후 단일 샘플 캘리브레이션의 노이즈 취약성은 여전히 유효한 개선이므로 최근 반영한 settle+average 방식은 그대로 유지.

분석 근거: nn_decoupling/test0816_RealtimeDecoupling/moe_monitor_20260816_183046.csv (6,518 rows, 71.3s, YA/YB strain ground truth 포함). 그래프 색상은 CLAUDE.md 컨벤션(L=주황 #FF8C00, R=초록 #2CA02C, TENG=파랑 #1F77B4)을 따름. 이전 버전(...165533.csv 기반)은 strain ground truth 누락으로 대체됨.
