HeejunMoon53/MultimodalSensor/nn_decoupling/test0807_MoEDecoupling/tau_fit_result.txt

tau_L=1.3287
tau_R=0.5942
tau_overall=1.0125
