HeejunMoon53/MultimodalSensor/nn_decoupling/test0807_MoEDecoupling/근접압력_통합센서_디커플링_실험보고서.html

BiRC · Embedded Multimodal Sensor — 실험 분석 기록

# 근접·압력 동시측정 단일전극 센서 신호 디커플링 실험 보고서

인덕턴스(L)·저항(R) 두 채널만으로 인장·근접·압력 세 가지 자극을 분리하는
임베디드 모델을 설계하기까지의 전 과정 기록

대상 실험 test0805 / test0806 압력-근접 스윕, test0807 MoE 모델링

기간 2026-08-05 ~ 2026-08-07

데이터 mms_20260806_200653.csv (51,858행) — 모든 학습에 사용. mms_20260805는 3.2/3.4절에서 확인된 품질 문제로 학습에서 제외, 시계열 시각화(그림 2)에만 참고로 남김

## 0개요

이 센서는 EGaIn(액체금속) 스파이럴 코일 하나로 L 인덕턴스와 R 저항 두 신호를 동시에 측정해서, 물체가 얼마나 가까운지(근접), 센서가 얼마나 늘어났는지(인장), 그리고 얼마나 세게 눌렸는지(압력)를 한꺼번에 알아내려는 프로젝트입니다. 문제는 전극이 하나뿐이라 이 세 가지 물리량이 전부 같은 두 숫자(L, R)에 뒤섞여 들어온다는 점입니다 — 이 뒤섞인 신호를 다시 풀어내는 것을 디커플링(decoupling)이라 부릅니다.

이번 실험 사이클에서는 기존의 "근접+인장" 2가지 조합에 "압력(힘)" 모달리티를 새로 추가했습니다. 압력을 추가하자마자 이전에 없던 문제들 — 신호가 지저분해지는 현상, 누르는 방향과 떼는 방향의 반응이 달라지는 현상(히스테리시스), 시간이 지나며 값이 계속 변하는 현상(크립) — 이 나타났고, 이 보고서는 그 원인을 하나씩 진단하고, 마지막으로 임베디드 보드(STM32)에 올릴 수 있는 작고 가벼운 모델 구조 5가지(+검증용으로 추가 구현한 진짜 순환신경망 1개)를 직접 만들어 비교한 전체 과정을 정리합니다.

이 보고서는 누구를 위한 것인가. 머신러닝을 잘 모르는 분도 따라올 수 있도록, R², RMSE, MLP, 게이트/전문가 구조 같은 용어가 처음 나올 때마다 짧게 풀어 설명합니다. 더 자세한 정의는 9. 용어집에 모아뒀습니다.

## 1읽기 전 배경지식

### 1.1 L·R 신호는 어떻게 측정되나

센서 보드(STM32G473 기반)는 1ms마다 한 번씩, 코일 하나를 세 가지 방식으로 번갈아 가며 읽습니다. 이렇게 짧은 시간을 쪼개서 여러 신호를 순서대로 측정하는 방식을 TDM(Time Division Measurement, 시분할측정)이라 부릅니다. 아날로그 스위치(MUX)가 코일의 연결 상태를 바꿔가며 공진 주파수(→ 인덕턴스 L), 전압분배 회로(→ 저항 R), 그리고 자체 발전 전압(TENG, 이번 실험에서는 사용하지 않음)을 각각 읽습니다.

그림 1. 1ms TDM 측정 사이클 개요. 같은 코일 하나를 아날로그 스위치로 세 가지 모드에 순차 연결해서 L·R·(TENG) 세 신호를 번갈아 읽는다. 이번 실험에서 실제로 쓰인 입력은 L, R 두 채널뿐이다.

L (인덕턴스)은 코일의 공진 주파수로부터 계산됩니다 — 물체가 가까워지거나 코일 자체가 눌려서 모양이 바뀌면 주파수가 달라집니다. R (DC 저항)은 코일을 이루는 액체금속 도선의 저항값으로, 도선이 늘어나거나 눌려서 단면적이 바뀌면 저항이 바뀝니다. 데이터에 나오는 dL_pct, dR_pct는 각각 "기준값(L₀, R₀) 대비 몇 % 변했는가"를 나타낸 값입니다.

### 1.2 학습·평가 용어 빠르게 훑기

아래 개념들은 이후 섹션 전체에서 계속 등장합니다. 처음 보는 용어면 여기서 한 번 짚고 넘어가는 걸 추천합니다.

모델(MLP)

입력 숫자 몇 개를 받아서 출력 숫자 몇 개를 내놓는 함수를, 데이터를 보고 자동으로 만들어내는 방법 중 하나. 이 프로젝트가 쓰는 MLP(다층 퍼셉트론)는 입력→은닉층 몇 개→출력으로 이어지는 가장 기본적인 형태의 신경망이다.

학습(training)

정답을 알고 있는 데이터(dL, dR → 실제 strain, force 등)를 모델에 반복해서 보여주면서, 모델이 정답을 잘 맞히도록 내부 숫자(파라미터)를 조금씩 조정하는 과정.

held-out 테스트

모델을 평가할 때, 학습에 전혀 쓰지 않은 데이터로 시험 보는 것. 이 보고서에서는 압력 사이클 19개 중 일부를 통째로 빼놓고, 그걸로만 성능을 측정했다.

R² (결정계수)

예측이 정답을 얼마나 잘 설명하는지 나타내는 0~1 사이 점수. 1이면 완벽히 일치, 0이면 그냥 평균값을 찍는 것과 다를 바 없다는 뜻. 이 보고서에서는 대부분 0.95 이상을 "잘 맞는다"의 기준으로 본다.

RMSE / MAE

예측값과 실제값의 오차 크기를 원래 단위(%, N, mm)로 나타낸 값. 작을수록 좋다. RMSE는 큰 오차에 더 민감하고, MAE는 오차의 평균적인 크기를 그대로 보여준다.

과적합(overfitting)

모델이 학습 데이터는 완벽히 외우다시피 하지만, 처음 보는 데이터에는 오히려 못 맞히는 상태. held-out 테스트로 이걸 감시한다.

임베디드 / INT8 양자화

이 모델이 최종적으로 올라갈 곳은 PC가 아니라 STM32 마이크로컨트롤러다. 모델을 최대한 작게(적은 파라미터, 정수 연산)로 만들어야 올라가는데, 이 변환 과정을 양자화라 부른다.

## 2실험 데이터

### 2.1 실험 프로토콜

센서 한쪽 끝을 5축 포지셔닝 스테이지에 고정하고, 두 가지 축을 동시에 움직입니다.

1. 인장(strain) — 이산(discrete) 축. Y모터로 센서를 0mm→36mm까지 총 19단계(2mm 간격)로 늘립니다. 초기 길이 120mm 기준 변형률 0→30%. 한 단계에서 다음 단계로 넘어가기 전까지 strain은 고정.
2. 근접+압력(position) — 연속(continuous) 축. Z축이 25mm(멀리) → 0mm(접촉) → −1.2mm(최대 압축) → 0mm → 25mm로 한 번의 매끄러운 왕복 스윕을 합니다. 0mm를 기준으로 z ≥ 0이면 비접촉 근접 구간, z < 0이면 센서가 실제로 눌리는 접촉/압력 구간입니다.
3. 이 스윕 하나가 1 사이클이며, 사이클이 끝나면 strain을 다음 단계로 올리고 같은 스윕을 반복 — 총 19 사이클로 strain 0~30% 전체를 훑습니다.
4. 6축 F/T(Force/Torque) 센서로 실제 접촉힘(N)을 동시에 기록해서, 나중에 모델이 맞혀야 할 "정답"으로 사용합니다.

즉 한 파일 안에 이산적인 19단계 인장과 연속적인 근접→압력 왕복이 동시에 들어있는 2차원 격자 형태의 데이터가 만들어집니다. 아래 그림은 이 프로토콜이 실제로 어떻게 기록됐는지 보여줍니다.

test0805 시계열: strain 계단, position 왕복, force, dL, dR 5개 패널

그림 2. test0805 데이터셋 시계열 (전체 457초, 19 사이클). 위에서부터 Strain(계단형 증가), Position(25↔−1.2mm 왕복), Force, ΔL/L₀, ΔR/R₀. 압력 구간마다 Force가 뾰족하게 솟을 때 ΔL은 급격히 오목하게 꺾이고 ΔR은 뾰족하게 튀는 것이 보인다.

### 2.2 데이터셋 2종

파일 | 행 수 | 시간 | Force 범위 | 비고
mms_20260805_172956.csv | 41,653 | 457s | 0 ~ 4N | 1차 압력 프로토콜 검증 — 학습에서는 제외(아래 참고)
mms_20260806_200653.csv | 51,858 | 569s | 0 ~ 10.1N | 더 강한 압력까지 확장, strain별 민감도 변화 관측 — 모든 학습에 사용

두 번째 데이터셋에서는 strain이 커질수록 같은 힘에도 R이 훨씬 크게 반응하는 현상이 뚜렷하게 나타났는데, 이 발견이 이후 모델 설계(4장)에서 R에 인장×압력 교차항을 추가하게 된 직접적 계기가 됩니다 (자세한 내용은 3.4절 참고).

mms_20260805는 왜 학습에서 뺐는가. 3.2절에서 이 파일의 힘 범위(0~4N)가 로드셀 잡음(±0.19N) 대비 너무 좁아 SNR이 나쁘다는 것을, 3.4절에서는 이 파일의 짧은 dwell(0.7~3.3초)이 점탄성 완화가 채 끝나기 전에 잘려서 held-out 예측 오차를 키운다는 것을 각각 확인했습니다. 두 문제 모두 센서 자체가 아니라 이 파일의 측정 프로토콜 한계였으므로, 이 데이터를 섞어 학습하면 "디커플링이 어렵다"는 착시가 생깁니다. 그래서 이 보고서의 모든 모델 학습(그림 4, 6, 4.3절 후보 1~5b)은 mms_20260806 한 파일만 사용합니다 — mms_20260805는 그림 2의 시계열 시각화와, 그 자체로 문제를 보여주는 3.2절 SNR 논의에만 남겨뒀습니다.

test0806 시계열: 더 강한 힘(최대 10.1N)까지 압축한 두 번째 데이터셋

그림 2b. test0806 데이터셋 시계열 (569초, 19 사이클, 최대 압축힘 10.1N). ΔR(맨 아래)의 피크가 사이클이 진행될수록(=strain이 커질수록) 눈에 띄게 높아지는 것이 보인다 — 3.4절에서 다룰 인장×압력 교차 민감도의 첫 단서다.

실전에서 쓸 수 있는 입력이 무엇인지가 중요합니다. 실제 배포된 센서는 z_mm(위치)이나 Force_N(힘) 같은 "정답"을 알 방법이 없습니다. 이 보고서에서 모델이 실제로 받을 수 있는 입력은 오직 dL_pct, dR_pct 두 값과, 그로부터 계산 가능한 값(예: 최근 몇 초간의 평균)뿐입니다. z_mm, Force_N, strain_pct는 전부 "정답(label)"으로만 쓰고, 입력으로는 절대 쓰지 않았습니다.

F/T 센서 영점(taring) 보정. 원본 Fz_N은 세션마다(파일마다) 살짝 다른 상수만큼 치우쳐 있었습니다 — 아무것도 안 닿은 비접촉 구간(z_mm≥0)의 평균이 0이 아니라 파일별로 각각 −0.22N, −0.67N이었습니다(측정 전 F/T 센서를 영점 조정하지 않아 생긴 오프셋으로 보입니다). 이 보고서의 모든 Force_N 값·그래프는 파일별로 이 오프셋을 뺀 보정값 기준입니다 — 즉 Force_N = −Fz_N − (비접촉 구간 평균). 절대 오프셋만 바뀌는 보정이라 R²·RMSE 같은 지표는 이전 버전과 큰 차이가 없지만, 비접촉 구간에서 힘이 음수로 나오던 부분은 전부 0 근처로 고쳐졌습니다.

## 3분석 과정 — 무엇이 문제였나

압력 모달리티를 추가하고 나서 그래프를 그려보니 근접 전용이었던 이전 실험과 달리 신호가 눈에 띄게 지저분해 보였습니다. "지저분하다"는 인상 하나를 네 가지 서로 다른 원인으로 쪼개서 하나씩 검증한 과정을 정리합니다.

### 3.1 압력구간 노이즈 · Q-factor 가설

센서에 돌기 구조를 추가해 압력 민감도를 올렸는데, 이 돌기가 눌리면서 코일(액체금속 도선)의 국소 단면적이 줄어들고 저항이 급격히 늘어날 수 있습니다. 코일의 Q-factor(공진의 날카로움을 나타내는 지표. 낮을수록 공진이 뭉개져서 주파수를 정확히 읽기 어려워짐)가 이 때문에 떨어지면, L 측정치만 유독 노이즈가 커질 것이라는 가설을 세우고 검증했습니다.

확인된 것

같은 깊이·같은 사이클에서 표준편차를 비교한 결과, 압축이 깊어질수록 L의 샘플 간 흔들림이 0.09%p → 0.52%p까지 커졌습니다(약 5배). R도 흔들리지만 상대적으로는 훨씬 안정적이었습니다. L에서만 나타나는 이 비대칭성은, R 측정(단순 전압분배)이 Q-factor와 무관한 반면 L 측정(공진 주파수 기반)만 Q-factor에 의존한다는 사실과 정확히 맞아떨어져 Q-factor 저하 가설을 뒷받침합니다.

다만 L이 압축이 깊어질수록 부호까지 반전되는 현상(근접 초반엔 더 음의 방향으로 가다가, 어느 깊이를 넘으면 갑자기 양의 방향으로 튀어 오름)은 순수 노이즈가 아니라 "물체 근접에 의한 결합 감소"와 "돌기가 코일 자체를 누르는 국소 변형" 두 물리 효과가 부호가 반대인 채로 경쟁하다가, 깊이가 깊어지면 후자가 이기는 실제 물리 현상으로 판단했습니다.

압력 사이클 하나만 떼어 ΔL/L0, ΔR/R0을 힘(Fz) 축에 대해 산점도로 그려보면 이 반전이 눈으로 바로 보입니다. strain 0%(왼쪽)에서는 반전 폭이 작아 거의 평평하게 바닥을 찍는 정도지만, strain 30%(오른쪽)에서는 ΔL이 −30%까지 떨어졌다가 최대힘 근처에서 −21%까지 뚜렷하게 반등합니다 — 3.4절 "인장이 클수록 압력 민감도가 커진다"는 발견과 정확히 같은 방향입니다. ΔR은 두 경우 모두 반전 없이 단조 증가만 하는 것도 다시 확인됩니다.

strain 0%, 한 사이클의 ΔL,ΔR vs Fz 산점도

그림 3a. strain 0% 사이클(최대 10.1N) — ΔL 반전이 약하게만 보인다.

strain 30%, 한 사이클의 ΔL,ΔR vs Fz 산점도

그림 3b. strain 30% 사이클(최대 9.2N) — ΔL이 뚜렷하게 반전(−30%→−21%)한다. 위아래 두 갈래로 갈라진 모양이 로딩/언로딩 히스테리시스(3.3절).

### 3.2 Force 축 SNR — "가짜로 지저분해 보이는" 부분

압력 그래프가 지저분해 보이는 또 다른 이유는 센서 자체가 아니라 정답값(F/T 힘 센서)의 측정 범위가 좁아서였습니다. 이 실험에서 실제로 쓴 힘 범위는 0~4N인데, 로드셀 자체의 잡음이 같은 깊이에서도 약 ±0.19N씩 흔들렸습니다 — 전체 범위의 4.7%에 해당하는 크기로, 이는 L(1.0%)이나 R(1.8%)의 상대 잡음보다 오히려 큽니다.

확인된 것

3D 그래프의 X축(Force)에 41샘플(~450ms) 이동평균을 적용해서 힘 측정치 자체의 잡음만 줄였더니, 루프 모양이 훨씬 깔끔해졌습니다. 즉 "지저분해 보임"의 상당 부분은 힘 센서(x축)의 좁은 동적범위에서 오는 문제였지, 우리 L/R 센서(y축)의 문제가 아니었습니다.

Force-Strain-L 3D 그래프, 오버샘플링 적용

그림 3c. Force(오버샘플링)-Strain-ΔL. 힘 측정치 노이즈를 줄이자 사이클마다 로딩/언로딩 경로가 뚜렷이 구분된다.

Force-Strain-R 3D 그래프, 오버샘플링 적용

그림 3d. Force(오버샘플링)-Strain-ΔR. strain이 커질수록 같은 힘 범위(0~10N)에서 반응 폭 자체가 커지는 것이 보인다.

### 3.3 히스테리시스 · 크립 — 진짜 원인은 "누르고 있는 동안 계속 변한다"

압력 그래프에서 누르는 방향(loading)과 떼는 방향(release) 경로가 서로 어긋나 폐곡선처럼 보이는 현상, 그리고 강하게 누를수록 이 폐곡선이 훨씬 커지는 현상을 조사했습니다. "깊이가 고정된 채 시간이 지나면서 값이 계속 변하는 성분"과 "떼고 나서 원래 값으로 돌아오지 않는 성분"을 나눠서 측정했습니다.

| 누르고 있는 동안(깊이 고정) 변화 | 뗀 후 원위치 대비 잔차
ΔL | 2.33 %p | 0.57 %p
ΔR | 5.73 %p | 0.08 %p (거의 0)

확인된 것

깊이를 고정해도 값이 계속 변하는(=시간에 의존하는) 성분이 압도적으로 크고, 힘을 떼면 그 변화가 거의 완전히 원위치로 돌아옵니다. 이건 영구 손상이 누적되는 게 아니라, 순수 시간 지연(가역적 점탄성 완화)이라는 뜻입니다 — 즉 "시간이 얼마나 지났는지" 정보만 모델에 알려주면 상당 부분 예측 가능하다는 의미입니다. dwell(누르고 있는) 구간에 지수함수를 피팅해서 이 지연의 시간상수 τ ≈ 1.01초를 직접 구했습니다(mms_20260806 단일 데이터셋 기준 — dwell이 짧은 mms_20260805를 섞으면 곡선이 잘려서 τ가 0.5초로 과소추정됐습니다).

#### 이론적 배경 — 왜 하필 지수함수(exp) 완화 방정식인가

"누르면 시간이 지나며 값이 계속 변하다가, 떼면 거의 다 되돌아온다"는 이 거동은 재료역학에서 점탄성(viscoelasticity)이라 부르는, 고분자(폴리머) 재료에서 아주 흔하고 잘 알려진 현상입니다. 새로 발명한 모델이 아니라 교과서에 있는 표준 모델을 그대로 가져다 쓴 것이라, 왜 이 형태의 식이 나오는지 근본부터 살펴볼 가치가 있습니다.

점탄성 재료의 반응은 흔히 두 가지 이상적인 부품의 조합으로 모델링합니다.

- 스프링(탄성) — 힘을 가하면 즉시 변형되고, 힘을 빼면 즉시 원래대로. 변형량이 가한 힘에 비례(σ = E·ε)하고 시간과는 무관합니다. 순간탄성 성분을 나타냅니다.
- 댐퍼/dashpot(점성) — 자동차 쇼바(shock absorber)처럼, 변형"속도"에 저항합니다 (σ = η·dε/dt). 빨리 누르면 세게 저항하고, 천천히 누르면 거의 저항이 없습니다. 시간 지연이 여기서 나옵니다.

이 둘을 어떻게 배치하느냐에 따라 재료 거동을 설명하는 표준 모델이 몇 가지로 나뉩니다.

모델 | 배치 | 일정한 힘을 계속 가하면(creep) | 힘을 떼면
Maxwell | 스프링+댐퍼 직렬 | 끝없이 계속 늘어남 (액체처럼 흐름) | 원위치로 안 돌아옴
Kelvin–Voigt | 스프링+댐퍼 병렬 | 어떤 값으로 서서히 수렴 (포화) | 천천히 원위치로 돌아옴
표준선형고체(SLS) | 스프링 + (스프링+댐퍼 병렬) | 즉시 반응 + 서서히 수렴 | 즉시 대부분 + 서서히 완전 회복

3.3절에서 실측한 패턴 — ① 접촉 순간 바로 반응하고, ② 누르고 있는 동안 서서히 더 변하고, ③ 떼면 결국 거의 완전히 되돌아온다 — 은 이 셋 중 표준선형고체(Standard Linear Solid, SLS) 모델과 정확히 일치합니다. Maxwell은 ③이 안 맞고(원위치로 안 돌아옴), Kelvin-Voigt는 ①이 안 맞습니다(즉시 반응하는 성분이 없음). 그래서 SLS 모델을 채택했습니다.

그림 3e. 표준선형고체(SLS) 모델의 블록도. 같은 압축 변형이 동시에 두 경로로 들어가서, 즉시 반응하는 탄성 성분(위)과 시간이 걸려 완화되는 점탄성 성분(아래, 파란색)이 더해진 것이 실제 측정값이다. dwell 중 드리프트의 정체는 바로 이 파란 경로다.

SLS 모델을 수식으로 풀면(뉴턴의 운동법칙과 동일한 방식으로 힘의 균형을 세운 미분방정식), 위쪽 경로는 시간에 무관한 대수식(σ₁=E∞·ε)이고, 아래쪽 경로는 정확히 4.1절에서 본 그 1차 미분방정식이 나옵니다.

τ · dσ₂/dt + σ₂ = E₁ · ε(t) τ = η/E₁ (댐퍼 점성계수 ÷ 스프링 강성) — 재료 고유의 시간상수

깊이 ε(t)가 어느 순간 갑자기 고정되면(=우리 실험의 dwell 구간), 이 방정식의 해가 바로 σ₂(t) = σ₂,∞ + (σ₂,0 − σ₂,∞)·exp(−t/τ) — 3.3절에서 실측 데이터에 피팅했던, 그리고 4.1절 EMA의 기반이 된 바로 그 지수함수입니다. 즉 "지수함수를 쓰기로 결정한" 게 아니라, 점탄성 재료의 힘의 균형 방정식을 그대로 풀면 저절로 지수함수가 나온다는 뜻입니다.

τ가 물리적으로 무엇을 뜻하는지도 분명합니다 — τ = η/E₁, 즉 재료가 얼마나 끈적한지(η, 점성)를 얼마나 뻣뻣한지(E₁, 강성)로 나눈 값입니다. 미시적으로는 압력을 받은 고분자 사슬들이 서로 얽힌 상태에서 새로운 배열로 미끄러져 재배치되는 데 걸리는 시간이라고 이해할 수 있습니다 — 이게 느릴수록(사슬이 잘 안 미끄러질수록) τ가 커집니다.

이 모델의 한계도 정직하게 밝혀둡니다. SLS는 시간상수가 하나뿐인 가장 단순한 점탄성 모델입니다. 실제 고분자는 사슬 길이·얽힘 정도가 제각각이라 완화 시간상수가 하나가 아니라 여러 개가 섞인 스펙트럼(공학적으로는 Prony series라 부름)에 가깝습니다 — 후보 5에서 τ=0.1/0.3/1.0/3.0초 네 개를 동시에 쓴 것이 바로 이 "스펙트럼"을 근사하려는 시도였습니다. 또한 3.4절에서 본 것처럼 strain이 커질수록 L의 상대적 히스테리시스가 더 나빠지는 경향은, 변형이 커지면 SLS가 가정하는 "선형" 점탄성(τ가 변형 크기와 무관)을 벗어나는 비선형 영역에 들어섰을 가능성을 시사합니다 — 즉 아주 정밀하게 가려면 τ 자체가 strain의 함수일 수 있다는 뜻입니다.

이 발견이 4장에서 "이력(history) 피처"를 모델에 추가하는 근거가 됩니다. 실제로 이 시간상수 기반 피처 하나를 추가하자 힘 예측 오차가 절반 이하로 줄었습니다 (아래 그림, mms_20260806 단일 데이터셋 — 최대 10N까지 압축한, 품질이 검증된 세션만 사용한 기준).

시간상수 피처 유무에 따른 힘 예측 비교, 최대 10N까지

그림 4. 왼쪽: 시간(0~6.5초) 동안의 실제 힘(검정, 최대 약 10N) vs 기본 모델(파랑 점선, 위상 지연 발생) vs 시간상수 피처를 더한 모델(빨강, RMSE 0.51N→0.24N, 54% 개선). 오른쪽: 깊이-힘 히스테리시스 루프 — 실제(검정)는 로딩·언로딩 경로가 뚜렷이 벌어진다. 기본 모델(파랑)도 루프를 어느 정도 재현하는데, 이는 입력으로 쓰는 원본 dL·dR 자체가 이미 로딩/언로딩에 따라 조금씩 다른 값을 갖기 때문이다 — 즉 이력 피처 없이도 "그 순간 값에 우연히 남아있는 힌트"만으로 일부는 재현된다. 다만 그 힌트만으로는 다 못 풀리는 애매함이 남아 있고(이게 그림 왼쪽의 RMSE 차이 0.28N의 정체), 시간상수 모델(빨강)이 그 나머지를 마저 풀어서 루프 모양을 10N 근처 강한 압축에서도 훨씬 정확하게 재현한다.

### 3.4 인장×압력 교차 민감도 — "얼마나 세게 당겨져 있느냐"가 압력 반응 자체를 바꾼다

strain이 커질수록 같은 힘에 대한 R의 반응 폭이 극적으로 커지는 걸 확인했습니다 — strain 0%에서는 9~10N을 눌러도 R이 4%밖에 안 움직이는데, strain 30%에서는 같은 힘으로 46%나 움직입니다(약 11배). 이건 단순 잡음이 아니라 재현성 있는 실제 신호(R²=0.905)였습니다.

strain에 따른 압력 반응폭과 히스테리시스 루프 면적 성장

그림 5. strain이 커질수록 압력에 대한 반응 폭(왼쪽)과 실측 히스테리시스 루프 면적(오른쪽)이 모두 커진다 — R(초록)이 L(주황)보다 훨씬 급격하게 커진다. R의 경우 면적/반응폭 비율은 strain과 거의 무관하게 일정했지만(=신호가 커진 만큼 루프도 비례해서 커진 것뿐), L은 상대적으로도 나빠지는 추세가 있었다.

기존 물리모델(R_theory(ε) = α₁ε + α₂ε²)은 R이 오직 인장에만 반응한다고 가정하는데, 이 실험으로 그 가정이 압력이 섞이는 상황에서는 깨진다는 것을 확인했습니다. R에도 L처럼 ε×F(인장×힘) 교차항이 필요하다는 뜻입니다. 이 교차항이 있는지 없는지가 "L, R만으로 인장과 압력을 분리하는 게 애초에 가능한가"라는 질문과 직결되므로, 정량적으로 확인했습니다.

| 인장 1%p당 (dL, dR) | 힘 1N당 (dL, dR)
민감도 | (+0.635, +0.664) | (+2.070, +11.575)

두 방향벡터 사이 각도는 33.6˚, 조건수(condition number, 역산이 노이즈에 얼마나 민감한지 나타내는 지표. 1에 가까울수록 좋음)는 약 23으로, "완전히 겹치진 않지만 상당히 애매하게 분리되는" 수준이었습니다. 이 선형 근사만 보면 "어렵지만 불가능하진 않다" 정도의 결론이었는데, 실제 비선형 MLP로 직접 학습시켜보니(4장) mms_20260806 단일 데이터셋(최대 10N) held-out 테스트에서 strain R²=0.999, force R²=0.995까지 나와서, 선형 근사가 예상한 것보다 훨씬 잘 분리된다는 걸 확인했습니다. 같은 방식(동일 4-input 피처, 동일 MLP 구조)을 근접(proximity) 모드에도 그대로 적용해서 (strain, 근접거리) 동시 디커플링도 같이 검증했습니다.

(dL,dR,이력)에서 근접모드는 strain·거리, 압력모드는 strain·force를 동시에 복원한 결과 산점도

그림 6. (dL, dR, 이력 피처) → (strain, force/거리) 동시 회귀, 둘 다 held-out 사이클 3개(strain 6.7%/15.0%/23.3%, 4.3절 후보들과 동일한 cycle_id 분할) 기준. 위 두 칸: 근접모드 — strain R²=0.9999(MAE 0.06%p), 거리 R²=0.9989(MAE 0.20mm). 아래 두 칸: 압력모드 — strain R²=0.999(MAE 0.13%p), force R²=0.995(MAE 0.20N). 두 모드 모두 대각선을 빈틈없이 따라가는데, 압력모드 쪽이 그래도 오차가 조금 더 큰 건 4.1절 EMA 이력 피처의 효과가 애초에 히스테리시스가 있는 압력모드에 더 집중돼 있기 때문입니다.

약한 데이터셋을 빼자 그림 자체가 달라졌다

압력모드 결과는 원래 mms_20260805·mms_20260806 두 파일을 합쳐 학습했었는데, 그때는 held-out 구간 중 일부(6.7%·15.0%·23.3%)만 유독 산점도가 넓게 퍼져 있었습니다(오차 표준편차 1.1~1.4%p, 나머지 구간은 0.17~0.29%p). 원인을 추적해보니 퍼진 구간이 전부 mms_20260805(최대 4N, dwell 0.7~3.3초로 짧음) 소속이었고, 이는 3.2절 SNR 문제·3.3절 "짧은 dwell은 완화가 덜 끝난 채로 잘린다" 문제와 정확히 들어맞았습니다. 그래서 이 파일을 학습에서 완전히 뺐더니, strain MAE가 0.53%p→0.13%p로, force MAE가 0.34N→0.20N으로 줄면서 위 그림처럼 세 구간 모두 고르게 좁아졌습니다 — 애초에 디커플링 자체의 한계가 아니라 그 데이터셋의 짧은 dwell·좁은 힘 범위가 원인이었다는 걸 다시 한번 확인해주는 결과입니다.

근접모드도 처음엔 이상하게 나빴는데, 원인은 데이터가 아니라 "사이클을 나누는 방식"이었다

이 그림을 처음 만들었을 때 근접모드 결과가 strain R²=0.993(MAE 0.27%p), 거리 R²=0.982 (MAE 0.57mm)로 압력모드보다 눈에 띄게 나빴습니다. mms_20260805는 이미 빠져 있었으니 "또 약한 데이터가 섞였나" 의심할 만했는데, 실제 원인은 이 스크립트가 쓰던 held-out 분할 방식의 버그였습니다 — 근접 구간을 "z_mm 부호가 바뀔 때만 새 구간"으로 나눴는데, 실제로는 strain이 다음 단계로 넘어가는 전환 램프가 z≥0(근접) 상태에서 일어나서, 한 "구간" 안에 서로 다른 두 strain 값이 섞여 들어갔습니다. 게다가 기록 맨 끝에는 스테이지가 strain을 30%→0%로 되돌리는 원점복귀(homing) 동작이 약 7초간 z=25mm(근접) 상태로 그대로 로깅돼 있었는데, 이 구간(722행, 0~30% 전체를 훑고 지나감)도 "구간 하나"로 묶여 held-out 평가에 섞여 있었습니다. 이 스크립트를 4.3절 후보들과 동일한 common.py의 cycle_id(strain 값이 바뀔 때마다 새 사이클, 최소 길이 500행) 방식으로 바꾸자 이런 짧은 전환·원점복귀 구간이 자동으로 걸러졌고, 위 그림처럼 strain R²=0.993→0.9999, 거리 R²=0.982→0.9989로 바로잡혔습니다 — 이 값은 같은 held-out 사이클을 쓰는 후보 2/6의 근접모드 결과(distance RMSE 0.318mm)와도 정확히 같은 수준입니다.

## 4모델 설계

3장의 발견들을 종합하면 요구사항이 분명해집니다: ① 접촉 여부(모드)를 먼저 구분해야 하고, ② 압력 모드에서는 반드시 "최근 이력" 정보가 있어야 하며, ③ 그러면서도 STM32에 올라갈 만큼 작아야 합니다. 이 요구사항을 만족하는 후보 구조 5가지를 test0807_MoEDecoupling/ 폴더에서 직접 구현하고 비교했습니다.

### 4.1 이력(시간상수) 피처 — EMA

3.3절에서 구한 시간상수 τ≈1.01초를 그대로 쓸 순 없고, 모델이 이해할 수 있는 "숫자 피처"로 바꿔야 합니다. 여기서 쓴 방법이 지수이동평균(EMA, Exponential Moving Average)입니다 — 최근 값일수록 가중치를 높게, 오래된 값일수록 가중치를 낮게 줘서 평균을 내는 방식으로, "얼마나 최근에 얼마나 오래 눌려있었는지"를 숫자 하나로 압축해서 표현합니다. 이 EMA 값 자체가 흡사 아주 작은 회로(RC 저역통과 필터)처럼 동작해서, 실시간 임베디드에서도 계산 비용이 거의 0에 가깝습니다(직전 값과 지금 값만 있으면 계산 가능).

중요한 건 dL_ema, dR_ema 모두 z_mm이나 Force_N 같은 정답값이 아니라, 실시간으로 들어오는 dL_pct·dR_pct 값 자체로만 계산된다는 점입니다. 그래서 학습 때 쓴 피처를 실제 배포된 보드에서도 똑같이 계산할 수 있습니다.

#### EMA를 수식으로 보면

"최근일수록 가중치를 높게 준다"는 말을 정확한 식으로 쓰면 이렇습니다. 지금(Δt=0초 전)으로부터 Δt초 전의 샘플이 지금 EMA 값에 남기는 가중치는 다음과 같이 지수적으로 줄어듭니다.

weight(Δt) = exp( −Δt / τ ) Δt = 지금으로부터 몇 초 전인가 (초) · τ = 시간상수 (초, 3.3절에서 실측 피팅한 값)

그리고 EMA 값 자체는 과거의 모든 샘플을 이 가중치로 가중평균한 것입니다 — 가중치의 합으로 나눠서 전체 평균이 1배 스케일을 유지하도록 정규화합니다.

EMA(t) = Σ [ x(t−Δt) × weight(Δt) ] / Σ [ weight(Δt) ] x(t−Δt) = Δt초 전의 원본 dL_pct 또는 dR_pct 값

EMA 가중치가 시간에 따라 지수적으로 감소하는 그래프, τ=1.01초와 half-life=0.702초 지점 표시

그림 6b. τ=1.01초일 때 가중치가 시간에 따라 줄어드는 모습. half-life(반감기, 가중치가 정확히 절반이 되는 시점)는 0.702초 — 이 값이 실제 코드의 EMA_HALFLIFE_S다.

#### τ(시간상수)와 half-life(반감기)는 같은 걸 두 방식으로 말한 것

코드에서는 halflife 파라미터를 쓰고, 3.3절 실험에서는 τ를 구했습니다. 둘은 다음 관계로 정확히 변환됩니다 — exp(−Δt/τ)가 정확히 0.5가 되는 Δt를 구하면 나옵니다.

half-life = τ × ln(2) ≈ τ × 0.6931 이 프로젝트 값: τ = 1.0125초 → half-life = 1.0125 × 0.6931 ≈ 0.702초 (EMA_HALFLIFE_S)

실제로 숫자를 넣어보면 "이력을 얼마나 기억하는지" 감이 옵니다.

몇 초 전 샘플인가 (Δt) | 가중치 = exp(−Δt/1.01) | 의미
0.1초 전 | 0.906 | 거의 그대로 반영
0.702초 전 (half-life) | 0.500 | 정확히 절반만 반영
1.01초 전 (=τ) | 0.368 | 약 37%만 반영
2.0초 전 | 0.139 | 13.9%만 반영
4.0초 전 | 0.019 | 사실상 잊혀짐

#### 임베디드에서 실제로 계산하는 방법 — 재귀식

위 식대로 "과거 전체를 매번 다시 더하는" 방식은 계산량이 계속 늘어나서 실시간 처리에 못 씁니다. 다행히 지수 가중평균은 수학적으로 완전히 동일한 재귀식(recursive formula) 한 줄로 바꿔 쓸 수 있습니다 — 직전 EMA 값 하나만 기억하면 매 샘플마다 계산 1번으로 끝납니다.

yn = yn−1 + α × ( xn − yn−1 )

yₙ = 이번 샘플의 EMA 값 · xₙ = 이번 샘플의 원본 측정값 · α = 1 − exp(−Δtsample/τ) (샘플 간격이 짧을수록 α도 작아짐)

이게 바로 3.1절에서 말한 "아주 작은 RC 저역통과 필터"와 정확히 같은 식입니다 — 곱셈 1번, 뺄셈 2번, 저장 변수 1개(직전 y값)만 있으면 되니 STM32 같은 마이크로컨트롤러에서 실시간으로 돌리기에 더할 나위 없이 가볍습니다.

#### 정확히 어떻게 모델에 넣히는가 — 전체 파이프라인

EMA 값 자체는 수식일 뿐이고, 이게 실제로 학습·추론에 쓰이려면 원본 신호와 합쳐져서 모델 입력으로 들어가야 합니다. 아래는 그 전체 흐름입니다 — common.py의 add_ema_features()가 피처를 만들고, candidate1_baseline_gate.py의 build_gate()/build_expert()가 이걸 받아 학습합니다.

그림 6c. 이력 피처 적용 파이프라인. 원본 신호(dL_pct, dR_pct)가 그대로 한 경로로 흘러가는 동시에(위), 파란색으로 강조된 EMA 재귀식을 거쳐 dL_ema/dR_ema로도 계산되고(아래), 두 경로가 4개짜리 벡터로 합쳐진 뒤 정규화를 거쳐 MLP에 들어간다.

- ①원본 그대로 — dL_pct, dR_pct는 손대지 않고 그대로 입력에 포함시킵니다(EMA로 대체하는 게 아니라 추가하는 것).
- ②EMA 계산 — 같은 원본 신호를 재귀식에 통과시켜 dL_ema, dR_ema를 만듭니다. 압력 구간(segment_id)이 바뀔 때, 즉 접촉이 새로 시작될 때마다 0에서 다시 시작합니다 — 직전 비접촉 구간의 값이 새 압력 이벤트로 새어 들어가지 않게 막는 장치입니다.
- ③4개 벡터로 결합 — X = [dL_pct, dR_pct, dL_ema, dR_ema]. 대체가 아니라 추가라서, 모델은 "지금 순간값"과 "최근 이력"을 동시에 보고 스스로 얼마나 섞어 쓸지 학습합니다.
- ④정규화 — StandardScaler가 학습 데이터 기준으로 4개 값을 각각 평균0·표준편차1로 맞춥니다(fit은 학습 시 한 번만, 추론 시엔 그 값을 그대로 재사용).
- ⑤MLP — 정규화된 4개 숫자를 게이트(4→8→4→1) 또는 전문가(4→24→16→8→2)에 그대로 통과시킵니다. 신경망은 이 4개 중 어느 게 "EMA"인지 전혀 모릅니다 — 그냥 학습 과정에서 4번째 숫자가 클 때 정답이 어떻게 달라지는지를 가중치로 스스로 알아낼 뿐입니다.

#### StandardScaler란 — 왜 굳이 이 과정이 필요한가

MLP는 내부적으로 "입력 × 가중치를 더한다"를 반복하는 함수입니다. 그런데 입력 4개 (dL_pct, dR_pct, dL_ema, dR_ema)의 실제 값 범위가 서로 다릅니다 — 이 프로젝트 데이터에서 dL_pct는 −43~+20%까지 넓게 흔들리는(표준편차 약 20.4) 반면, dR_pct는 0~46%로 상대적으로 좁습니다(표준편차 약 7.9) — 거의 2.6배 차이입니다. 스케일을 안 맞추고 그대로 넣으면, 가중치가 비슷한 크기에서 무작위로 초기화되기 때문에 값이 더 큰 dL 쪽이 "물리적으로 더 중요해서"가 아니라 "숫자가 커서" 더 큰 영향력을 갖는 것처럼 취급되고, 경사하강법(gradient descent)의 업데이트 폭도 피처마다 들쭉날쭉해져서 학습이 느려지거나 불안정해집니다.

StandardScaler는 각 입력 열(column)을 독립적으로 "평균 0, 표준편차 1"이 되도록 다시 스케일링해서 이 문제를 없앱니다.

z = ( x − μ ) / σ μ = 그 열의 평균 · σ = 그 열의 표준편차 (둘 다 학습 데이터에서만 계산)

변환 후에는 dL_pct든 dR_pct든 EMA든 전부 대략 −2~+2 사이의 비슷한 규모로 들어오기 때문에, 신경망 입장에서는 "어느 채널이 원래 더 크게 흔들리는가"가 아니라 "정답을 맞히는 데 실제로 얼마나 쓸모 있는가"만으로 각 입력의 중요도를 가중치로 스스로 배우게 됩니다.

μ, σ는 반드시 학습 데이터에서만 계산합니다(fit은 딱 한 번). held-out 테스트나 실제 배포 시 들어오는 새 샘플에도 학습 때 구한 그 μ, σ를 그대로 재사용해서 변환합니다 — 테스트 데이터로 μ, σ를 다시 구하면 "정답을 미리 살짝 봤다"는 데이터 누수(data leakage)가 됩니다. 임베디드 배포 관점에서는 이 μ, σ 값들도 모델 가중치와 마찬가지로 펌웨어에 상수로 박아 넣어야 하는 값입니다 — 채널당 2개(μ, σ)씩, 입력 4개면 상수 8개뿐이라 모델 파라미터 수(수백~수천 개)에 비하면 무시할 만한 크기입니다.

중요한 포인트 — 이건 "시퀀스 모델"이 아닙니다. 이력 계산(②)은 학습 전에 데이터를 준비하는 단계에서 한 번 끝나고, 그 다음부터 MLP(⑤)는 한 행(row)씩 완전히 독립적으로 봅니다 — 보통의 표(table) 회귀 문제와 다를 게 없습니다. "시간이 흐른다"는 사실 자체는 ②의 피처 계산이 전담하고, MLP는 그 결과물만 받아쓰는 구조입니다. 이 점이 바로 아래 4.5절에서 GRU와 비교할 때 가장 중요한 차이입니다.

이 수식이 우연이 아닌 이유

위 재귀식은 사실 3.3절에서 dwell(누르고 있는 동안) 완화 곡선에 피팅했던 바로 그 물리 방정식의 이산시간(discrete-time) 버전입니다. 3.3절의 연속시간 완화 방정식은

dy/dt = ( x − y ) / τ

이고, x가 일정할 때 이 방정식의 해가 정확히 y(t) = x + (y₀−x)·exp(−t/τ) — 즉 3.3절에서 실측 데이터에 피팅했던 그 지수함수입니다. 그래서 EMA 피처를 넣는 건 임의로 고른 트릭이 아니라, 센서가 실제로 보이는 점탄성 완화 현상을 같은 수학으로 모델에 그대로 알려주는 것입니다.

### 4.2 게이트+전문가(Mixture of Experts) 구조

근접(비접촉)과 압력(접촉)은 물리 메커니즘 자체가 완전히 다릅니다 — 근접은 와전류 결합, 압력은 기계적 압축입니다. 그래서 하나의 모델에 억지로 다 학습시키기보다, 작은 분류기(게이트)가 먼저 "지금 접촉 중인가?"를 판단하고, 그 결과에 따라 두 개의 전문 모델(전문가) 중 하나로 갈라 보내는 구조를 기본 뼈대로 삼았습니다. 이런 "분류 후 전문가에게 위임" 구조를 머신러닝에서는 MoE(Mixture of Experts, 전문가 혼합)라 부릅니다. 임베디드 관점에서 if/else 분기는 비용이 거의 0이라, 작은 모델 여러 개를 두는 것 자체는 부담이 되지 않습니다.

그림 7. 게이트+전문가(MoE) 구조의 기본 뼈대. dL, dR(과 이력 피처)이 게이트로 들어가 접촉 여부를 판단하고, 그 결과에 따라 두 전문가 중 하나로 라우팅된다. 두 전문가 모두 항상 strain을 같이 출력하고, 나머지 출력만 모드에 따라 다르다. 박스 아래 N → 8 → 4 → 1 같은 표기가 레이어 구조(입력 → 은닉층 → 출력)이며, 입력 개수 N은 후보마다 다르다 — 정확한 값은 4.4절 표 참고.

### 4.3 5개 후보 구조

위 뼈대를 기준으로, "게이트가 꼭 필요한가", "이력 피처를 어떻게 주는 게 최선인가", "물리식을 직접 넣으면 도움이 되는가"라는 세 가지 질문에 답하기 위해 구조를 하나씩 바꿔가며 5개 버전을 만들었습니다.

#### 후보 1 — 기준선 (이력 피처 없음)

baseline

그림 7의 구조를 그대로 쓰되, 입력은 dL_pct, dR_pct 두 개뿐입니다. 이력 정보가 없을 때 히스테리시스 문제가 얼마나 심한지 보여주는 기준점 역할입니다.

게이트 정확도 98.2% 압력모드 strain R² 0.998 force R² 0.981 파라미터 1,317

게이트 레이어 2→8→4→1 전문가 레이어(A·B 동일) 2→24→16→8→2

#### 후보 2 — 게이트 + EMA 이력 피처

추천

후보 1과 구조는 동일하지만, 입력에 dL_ema, dR_ema(τ=1.01초에서 계산한 halflife 0.702초 EMA)를 추가했습니다. 히스테리시스를 해결하는 가장 직접적인 시도입니다.

게이트 정확도 100.0% 압력모드 strain R² 0.999 force R² 0.995 파라미터 1,429

게이트 레이어 4→8→4→1 전문가 레이어(A·B 동일) 4→24→16→8→2

#### 후보 3 — 게이트 없는 통합 MLP

단순화

분기 로직 자체를 없애고, 근접(양수 mm)과 압력(음수 mm)을 하나의 연속 변수인 z_mm (position)으로 통일해서 strain과 position을 동시에 출력하는 단일 모델로 근접·압력 전 구간을 커버할 수 있는지 검증했습니다.

게이트 불필요 압력모드 strain R² 0.993 position R² 0.963 파라미터 1,506

통합모델 레이어 4→32→24→16→8→2

#### 후보 4 — 물리모델 + 잔차 하이브리드

탐색적

3.4절에서 찾은 ε×F 교차항(R_theory = γ₁ε + γ₂ε² + γ₃εF)을 최소자승으로 직접 피팅하고, 이 식을 역으로 풀어(F에 대해 선형이라 닫힌해가 존재) 물리공식만으로 힘을 복원해봤습니다. 그 위에 작은 잔차 보정 MLP를 얹은 하이브리드 버전도 같이 시험했습니다.

중요한 반례

mms_20260805를 섞어 학습했을 때는 물리공식만으로 역산한 결과가 R²=−75라는 완전히 망가진 값이었습니다. strain이 0에 가까울 때 공식이 0으로 나누는 것과 같아져서 값이 폭발하는데, 그 파일의 짧은 dwell·좁은 힘 범위 데이터가 이 발산을 더 심하게 증폭시켰기 때문입니다. mms_20260806 단일 데이터셋으로 다시 해보니 R²=0.26으로 발산은 사라졌지만, 그래도 MLP(R²≥0.99)에는 한참 못 미칩니다 — CLAUDE.md에 이미 기록되어 있던 "해석적 역산의 야코비안 특이점 문제"가 데이터 품질과 무관하게 근본적으로 남아있음을 보여줍니다. 순수 물리식 역산은 이 문제에 안정적으로 쓸 수 없다는 결론은 그대로 유지됩니다. 물리식을 잔차 MLP의 보조 피처로만 쓴 하이브리드 버전은 정상적으로 동작했지만, 후보 2와 비교해 뚜렷한 이득은 없었습니다.

물리역산 단독 R² 0.26 (MLP 대비 여전히 부족) 하이브리드 strain R² 0.999 force R² 0.993 파라미터 704*

물리식(순방향) 최소자승 계수 3+3개 (신경망 아님) 잔차보정 MLP 레이어 5→24→16→8→2

*압력 모드 잔차 모델만 구현 — 근접 모드는 별도 구현하지 않아 전체 시스템 파라미터 수는 아님. 입력 5개 = dL,dR,dL_ema,dR_ema +물리식으로 역산한 힘 추정치 1개.

#### 후보 5 — 다중 시간상수 EMA 뱅크

최고 수치

τ 하나 대신 0.1 / 0.3 / 1.0 / 3.0초 네 가지 시간상수의 EMA를 동시에 넣어서, 더 풍부한 이력 표현이 도움이 되는지 봤습니다. 원래는 작은 순환신경망(RNN)으로 시도하려 했으나, 이 문서를 처음 작성할 당시엔 이 환경에서 PyTorch가 DLL 로드 오류로 동작하지 않아 다중 시간상수 조합으로 근사했습니다 — 선형 RNN의 내부 상태가 표현할 수 있는 것과 비슷한 형태입니다. (이후 PyTorch 문제를 해결해서 실제 RNN도 학습해봤습니다 — 바로 아래 후보 5b 참고.)

게이트 정확도 99.9% 압력모드 strain R² 0.997 force R² 0.996 근접 거리 R² 0.9993 파라미터 1,765

게이트 레이어 10→8→4→1 전문가 레이어(A·B 동일) 10→24→16→8→2

#### 후보 5b — 진짜 RNN(GRU) 검증

최소 파라미터

PyTorch가 DLL 로드 오류를 내는 원인을 다시 조사해보니, 이 컴퓨터의 사용자 계정 경로 (...\AppData\Local\Packages\...\site-packages\torch\lib\)가 너무 길어서 Windows의 경로 길이 제한(260자)에 걸려 PyTorch의 일부 DLL 파일이 아예 설치되지 못하는 문제였습니다. C:\ml_env처럼 짧은 경로에 새 가상환경을 만들어 설치하니 정상 동작했습니다. 이렇게 확보한 환경으로, 손으로 고른 다중 시간상수 EMA 대신 작은 GRU(순환신경망) 하나가 이력을 스스로 학습하도록 압력 모드 전문가를 다시 만들어 학습시켰습니다.

구조: (dL_pct, dR_pct) 시퀀스를 GRU(hidden=8)에 통과시켜 매 스텝마다 (strain, force)를 동시 출력. 압력 사이클 하나 전체(약 600 스텝)를 시퀀스 하나로 취급해 16개 학습/3개 held-out 테스트로 나눴습니다 — 사이클 분할 방식은 다른 후보들과 동일. 게이트와 근접 모드는 별도로 새로 만들지 않고 기존 후보 2의 것을 그대로 쓸 수 있다고 가정합니다.

압력모드 strain R² 0.999 force R² 0.995 파라미터 306

레이어 GRU(입력2, hidden8, 1층) + Linear(8→2)

#### GRU 내부 구조 — 게이트 3개가 하는 일

"GRU(hidden=8)" 한 줄 표기 안에는 매 타임스텝마다 실행되는 작은 계산 블록이 들어있습니다. 입력 벡터 x_t = (dL_pct, dR_pct)와 직전 은닉상태 h_(t-1)(숫자 8개)를 받아서, 아래 세 게이트를 계산한 뒤 은닉상태를 갱신합니다 — PyTorch nn.GRU가 내부에서 그대로 쓰는 표준 식입니다.

r_t = σ( W_ir·x_t + b_ir + W_hr·h_(t-1) + b_hr ) reset gate — 과거 은닉상태를 이번 계산에서 얼마나 무시할지

z_t = σ( W_iz·x_t + b_iz + W_hz·h_(t-1) + b_hz ) update gate — 과거를 얼마나 그대로 유지할지 (4.1절 EMA의 α에 대응)

n_t = tanh( W_in·x_t + b_in + r_t ⊙ (W_hn·h_(t-1) + b_hn) ) candidate state — 지금 입력이 제안하는 "새 상태" 후보

h_t = (1 − z_t) ⊙ n_t + z_t ⊙ h_(t-1) 최종 은닉상태 — 새 제안(n_t)과 과거(h_(t-1))를 z_t 비율로 섞음

4.1절 EMA의 재귀식 y_n = y_(n-1) + α(x_n − y_(n-1))과 나란히 놓으면 구조가 거의 같습니다 — 둘 다 "이번 값"과 "직전 값"을 어떤 비율로 섞을지 정하는 식입니다. 차이는 이렇습니다.

- EMA는 혼합 비율 α를 τ 하나로 사람이 미리 고정합니다 — 세게 누르든 약하게 누르든, 로딩 중이든 언로딩 중이든 똑같은 α를 씁니다.
- GRU의 z_t(α에 대응)는 매 스텝 지금 입력 x_t와 직전 상태 h_(t-1)을 보고 작은 신경망(σ 게이트)이 그때그때 다시 계산합니다 — "지금은 빠르게 잊어도 되는 순간"과 "지금은 오래 기억해야 하는 순간"을 데이터에서 스스로 구분할 여지가 있습니다.
- 은닉상태도 숫자 1개(EMA)가 아니라 8개라서, 서로 다른 시간규모·다른 패턴을 동시에 담을 수 있습니다 — 후보 5의 "시간상수 4개짜리 EMA 뱅크"를 신경망이 스스로 8차원으로 확장한 셈입니다.

구성 요소 | 크기 | 파라미터 수
입력 가중치 W_ir, W_iz, W_in (input→3게이트) | 3×8×2 | 48
은닉 가중치 W_hr, W_hz, W_hn (hidden→3게이트) | 3×8×8 | 192
편향 b_ir/iz/in + b_hr/hz/hn | 3×8 + 3×8 | 48
출력층 Linear(8→2) | 8×2 + 2 | 18
합계 | | 306

"many-to-many" 시퀀스 처리. 압력 사이클 하나(깊이가 25mm→0→−1.2mm→0→25mm로 움직이는 동안 약 600 타임스텝)를 통째로 시퀀스 하나로 취급합니다. t=0의 은닉상태는 0벡터로 시작해서 매 스텝 입력을 하나씩 순서대로 흘려보내며 갱신하고, 매 스텝마다 그 시점 은닉상태로 (strain, force) 예측을 내놓습니다 — 마지막 스텝 하나만 쓰는 게 아니라 시퀀스 전체에 대해 손실을 계산합니다(many-to-many). 시퀀스를 하나씩 도는 batch_size=1 방식으로 16개 학습 시퀀스·400 epoch·Adam(lr=5e-3)으로 학습했고, held-out 3개 사이클(≈1,800 스텝)로 평가했습니다.

Model A(기준선) vs Model B(+EMA MLP) vs GRU 예측 힘 비교, held-out 테스트 사이클

그림 7b. held-out 테스트 사이클(strain 15.0%)에서 실제 힘(검정) vs Model A(파랑 점선, 이력 없음, RMSE 0.52N) vs Model B(빨강 1점쇄선, +EMA MLP, RMSE 0.25N) vs GRU(보라, RMSE 0.28N)를 한 그래프에 겹쳐 그렸습니다. Model A만 위상이 뒤처지며 눈에 띄게 벗어나고, Model B와 GRU는 로딩·언로딩 양쪽 경로 모두 실제 값을 거의 겹치게 따라갑니다 — 이 사이클 하나만 보면 Model B가 GRU보다 근소하게 더 정확하지만(6장 RMSE 표 기준 전체 평균은 GRU 0.263N, Model B와 동급 후보 2가 0.253N으로 둘 다 비슷한 구간), 파라미터는 GRU가 306개로 Model B(674개)의 절반 이하입니다.

정확도는 EMA 계열과 동률권, 크기는 압도적으로 작다

mms_20260806 단일 데이터셋 기준으로 다시 재보니, 압력모드 strain R²는 후보 2(0.999)·후보 5(0.997)와 사실상 동률(0.999)이고 force R²(0.995)도 후보 2(0.993)·후보 5(0.996)와 같은 구간입니다 — 약한 데이터셋을 뺐더니 "GRU가 EMA보다 확실히 더 정확하다"던 이전 결론은 근거가 약해졌습니다. 다만 파라미터는 여전히 306개로 후보 2(전문가 하나 674개)의 절반 이하, 후보 5(818개)의 3분의 1 수준입니다. 즉 이번 재검증의 핵심은 "GRU가 더 정확하다"가 아니라, 같은 정확도를 훨씬 적은 파라미터로 낸다는 쪽으로 무게중심이 옮겨갔습니다.

#### 그래도 임베딩엔 MLP에 없던 숙제가 세 가지 남는다

파라미터가 작다고 임베딩이 "더 쉬운" 건 아닙니다. GRU는 계산량 자체는 오히려 MLP 전문가(약 670개 곱셈-덧셈)보다도 적은 약 240회 수준이라 STM32G4(170MHz)에서 1ms 주기 안에 끝내는 데는 문제가 없지만, 다음 세 가지는 MLP에는 없던 새로운 확인 사항입니다.

- 상태(state)를 들고 다녀야 함 — MLP는 매 호출이 서로 독립적(stateless)이라 "지금 입력 → 지금 출력"으로 끝나지만, GRU는 직전 은닉상태(숫자 8개)를 다음 호출에 계속 넘겨야 합니다. 그리고 이 상태를 언제 0으로 리셋할지를 펌웨어가 알아야 합니다 — 이번 학습은 압력 사이클(접촉 시작)마다 은닉상태를 0에서 새로 시작했으므로, 실전에서도 게이트가 "접촉 시작"을 감지하는 순간 리셋을 걸어줘야 학습 때와 같은 조건이 됩니다. TDM 루프에 새로 추가해야 하는 로직입니다.
- X-CUBE-AI의 순환 레이어 지원 성숙도 — PyTorch→ONNX→X-CUBE-AI 경로 자체는 GRU/LSTM을 지원하지만, Dense/Conv 레이어보다 상대적으로 지원이 늦게 추가된 영역이라 시퀀스 길이 고정 요구나 활성함수 조합 제약 같은 세부 제한이 있을 수 있습니다 — 이 STM32G473 타깃에서 실제로 한 번 import해보기 전까지는 확정할 수 없습니다.
- INT8 양자화가 더 까다로움 — MLP는 호출마다 독립적이라 양자화 반올림 오차가 누적되지 않지만, GRU는 같은 은닉상태를 수백 스텝 동안 계속 재사용하므로 오차가 시간에 따라 조금씩 쌓일 수 있습니다. 툴체인에 따라 순환 부분만 FLOAT16으로 남기는 경우도 흔한데, 그래도 306개면 1.2KB 수준이라 메모리 여유는 충분합니다.

그래서 실전 순서는: 위 세 가지를 이 타깃 보드에서 직접 검증하기 전까지는, 이미 검증된 (완전히 stateless한) 후보 2가 여전히 "리스크 없이 바로 갈 수 있는" 선택지입니다. 후보 5b는 정확도·크기 면에서 방향성은 명확히 보여줬으니, ONNX export + X-CUBE-AI import 최소 예제부터 먼저 이 보드에서 돌려보는 걸 다음 단계로 권합니다.

다섯 구조의 차이를 한 그림으로 정리하면 아래와 같습니다 — 후보 1을 기준으로 각 후보가 정확히 무엇을 바꿨는지 보여줍니다. (후보 5b는 게이트·근접모드를 별도 구현하지 않아 이 비교도에는 포함하지 않았습니다.)

그림 8. 후보 1(기준) 대비 각 후보의 구조적 차이. 파란 강조 부분이 후보 1과 다른 지점이다.

### 4.4 레이어 구조 상세

앞의 카드들에 나온 4→24→16→8→2 같은 표기를 풀어 읽으면 "입력 뉴런 4개 → 은닉층 24개 → 은닉층 16개 → 은닉층 8개 → 출력 뉴런 2개"라는 뜻입니다. 뉴런 하나하나는 이전 층의 모든 뉴런 값을 가중합(weighted sum)한 뒤 활성함수(activation function, 여기서는 tanh)를 씌운 숫자 하나일 뿐입니다 — 층이 깊고 넓을수록 더 복잡한 함수를 표현할 수 있지만, 그만큼 파라미터(=가중치 개수)도 늘어납니다. 아래는 이번에 만든 모든 신경망의 레이어 구조를 하나도 빠짐없이 정리한 표입니다.

후보 | 모델 | 입력 피처 수 | 레이어 구조 | 활성함수 | 출력 | 파라미터
C1 | 게이트 | 2 | 2→8→4→1 | tanh, tanh, sigmoid | 접촉확률(0~1) | 65
| 전문가 A(근접) | 2 | 2→24→16→8→2 | tanh×3, linear | strain(%), 거리(mm) | 626
| 전문가 B(압력) | 2 | 2→24→16→8→2 | tanh×3, linear | strain(%), 힘(N) | 626
C2 | 게이트 | 4 | 4→8→4→1 | tanh, tanh, sigmoid | 접촉확률(0~1) | 81
| 전문가 A(근접) | 4 | 4→24→16→8→2 | tanh×3, linear | strain(%), 거리(mm) | 674
| 전문가 B(압력) | 4 | 4→24→16→8→2 | tanh×3, linear | strain(%), 힘(N) | 674
C3 | 통합모델 (게이트 없음) | 4 | 4→32→24→16→8→2 | tanh×4, linear | strain(%), position(mm) | 1,506
C4 | 물리식(순방향, 신경망 아님) | 2† | 최소자승 선형계수 3개×2식 | — | dR·dL 예측치 | 6
| 잔차보정 MLP | 5‡ | 5→24→16→8→2 | tanh×3, linear | strain(%), 힘(N) | 698
C5 | 게이트 | 10 | 10→8→4→1 | tanh, tanh, sigmoid | 접촉확률(0~1) | 129
| 전문가 A(근접) | 10 | 10→24→16→8→2 | tanh×3, linear | strain(%), 거리(mm) | 818
| 전문가 B(압력) | 10 | 10→24→16→8→2 | tanh×3, linear | strain(%), 힘(N) | 818
C5b | 전문가 B(압력) — GRU | 2 | GRU(2→8, 1층) + Linear(8→2) | GRU 내부 게이트(σ,tanh), 출력 linear | strain(%), 힘(N) — 매 스텝 | 306

† 물리식은 신경망이 아니라 strain, force → dR(또는 dL)을 직접 잇는 2차항 포함 선형회귀 계수라, "레이어"가 아니라 계수 개수로 표시했습니다. ‡ 잔차보정 MLP의 입력 5개 = dL_pct, dR_pct, dL_ema, dR_ema + 물리식으로 역산한 힘 추정치 1개.

MLP와 GRU 레이어 읽는 법 차이. MLP의 tanh 뉴런은 "지금 입력"만 보고 바로 출력을 계산하지만, GRU(Gated Recurrent Unit) 뉴런은 내부에 "직전까지의 기억"을 저장해뒀다가 그걸 지금 입력과 함께 봅니다 — 매 스텝 (1) 이번 입력을 얼마나 반영할지, (2) 기존 기억을 얼마나 유지할지를 각각 작은 시그모이드(σ) 게이트로 정하고, 그 결과로 기억을 갱신합니다. 4.1절의 EMA 재귀식(yₙ = yₙ₋₁ + α(xₙ−yₙ₋₁))과 원리가 같은데, 그 식의 "α"를 사람이 τ로 미리 정해주는 대신 GRU는 α에 해당하는 값을 매 순간 데이터를 보고 스스로 계산합니다 — 그래서 시간상수를 하나 골라줄 필요가 없습니다. 게이트 3개(reset·update·candidate)의 정확한 수식과 306개 파라미터가 어디서 나오는지는 후보 5b 카드의 "GRU 내부 구조" 항목을 참고하세요.

공통 사항. 모든 회귀(regression) 출력층은 활성함수 없이 그대로 값을 내보내는 linear(항등) 방식이고, 게이트(분류) 출력층만 0~1 확률을 만드는 sigmoid를 씁니다. 은닉층은 예외 없이 tanh를 썼습니다 — 모두 model.py의 기존 SinglePINNMLP(2→24→16→8→2, 626개 파라미터) 설계를 그대로 따르되, 입력 개수와 게이트 유무만 후보마다 바꾼 것입니다.

### 4.5 MLP+EMA vs GRU — 임베디드 AI 관점 비교

지금까지 나온 두 가지 "이력을 다루는 방식"을 정리하면 — MLP+EMA는 이력을 사람이 미리 계산해서 피처로 넣어주는 방식(4.1절), GRU는 이력 관리 자체를 신경망이 학습으로 떠맡는 방식(4.3절 후보 5b)입니다. 약한 데이터셋을 뺀 뒤로는 정확도 자체는 두 방식이 거의 동률이고(4.3절 표 참고), 대신 파라미터 수 차이가 훨씬 크게 갈립니다. 임베디드에 실제로 올릴 때는 고려할 축이 더 많으니, 그 축들을 전부 펼쳐서 비교합니다.

비교 축 | MLP + EMA (후보 2·5) | GRU (후보 5b)
이력을 표현하는 방법 | 사람이 τ를 골라 미리 계산한 피처 (dL_ema, dR_ema) | 신경망 내부 은닉상태(숫자 8개)가 학습으로 스스로 결정
모델이 시간을 다루는 방식 | 모델 자체는 시간 개념 없음 — 매 행이 독립적인 표 회귀 | 시퀀스를 순서대로 처리, 매 스텝 상태를 계속 갱신
추론 시 "상태" 관리 | EMA 누산값 1~2개(모델 밖의 단순 변수) — 펌웨어에서 재귀식 한 줄로 갱신 | 은닉상태 8개(모델 그래프의 일부) — 프레임워크가 호출 간 유지해줘야 함
리셋 로직 | 필요함 — 접촉 시작 시 EMA를 원본값으로 리셋 | 필요함 — 접촉 시작 시 은닉상태를 0벡터로 리셋 (동일한 요구사항)
파라미터 수(압력 전문가 기준) | 674개(단일 τ) / 818개(다중 τ) | 306개
추론당 연산량 | 약 670회 곱셈-덧셈 | 약 240회 곱셈-덧셈
압력모드 strain R² | 0.999(단일 τ) / 0.997(다중 τ) | 0.999
압력모드 force R² | 0.995 / 0.996 | 0.995
X-CUBE-AI 지원 성숙도 | Dense 레이어 — 가장 성숙, 기본 지원 | GRU/LSTM 지원되지만 상대적으로 최근 추가, 세부 제약 가능성 있어 보드에서 검증 필요
INT8 양자화 안정성 | 호출마다 독립적이라 오차 누적 없음 | 같은 은닉상태를 수백 스텝 재사용 — 오차가 시간에 따라 누적될 수 있음
해석 가능성 / 디버깅 | τ가 3.3절 SLS 물리모델과 직접 연결 — 왜 이 값인지 설명 가능 | 내부 게이트가 무엇을 학습했는지 블랙박스에 가까움
튜닝해야 할 하이퍼파라미터 | τ(또는 다중 τ 조합)를 사람이 탐색 — 후보 2/5가 그 탐색 과정 | τ에 해당하는 값을 데이터가 스스로 찾음, 사람이 고를 게 없음
학습 파이프라인 복잡도 | 일반 표 회귀 — scikit-learn 수준으로 충분 | 시퀀스 배치·가변 길이 처리 필요 (지금 구현은 batch_size=1 루프)

그래서 임베디드 관점에서는 어느 쪽인가

정확도는 거의 동률이니, 승부는 크기와 리스크에서 갈립니다 — 그리고 "지금 당장 리스크 없이 배포"라는 기준으로는 MLP+EMA가 여전히 안전한 선택입니다. GRU가 확실히 이기는 항목은 파라미터 수·연산량뿐이고, 이마저도 "이 보드에서 실제로 돌려보면 확인될" 항목입니다. 반면 MLP+EMA가 이기는 항목(X-CUBE-AI 성숙도, 양자화 안정성, 해석 가능성)은 전부 "이미 알고 있고 리스크가 없는" 항목입니다. 즉 GRU는 크기 면에서 상한(upside)이 크지만 검증 전이고, MLP+EMA는 크기는 더 크지만 이미 검증됐습니다. 7장 결론에서 "지금 배포 가능한 것은 MLP+EMA, 다음 우선순위는 GRU 검증"으로 정리한 이유가 이 표에 그대로 담겨 있습니다.

## 5학습 방법

### 5.1 데이터 분할 — 사이클 단위 held-out

mms_20260806 한 파일에서 총 19개의 완전한 사이클(근접+압력 왕복 1회, strain 한 단계, 0~30%를 1.67%p씩 훑음)을 얻었습니다. 이 중 5개마다 1개꼴(총 3개, strain 6.7%/15.0%/23.3% — 낮은/중간/높은 구간이 섞이도록)을 통째로 학습에서 빼서 테스트용으로 남겼습니다. 시간적으로 이웃한 샘플끼리 너무 비슷해서 생기는 "몰래 정답을 봤다"는 착시(data leakage)를 막기 위해, 샘플 단위가 아니라 반드시 사이클 단위로 나눴습니다.

### 5.2 모델 학습 조건

모든 후보는 StandardScaler(입력을 평균 0, 표준편차 1로 정규화 — 입력 스케일이 제각각이면 학습이 잘 안 되기 때문)로 전처리한 뒤, MLPRegressor/MLPClassifier (hidden layer 크기는 기존 model.py의 SinglePINNMLP와 동일한 24→16→8, 활성함수 tanh)로 학습했습니다. 학습 중 검증 손실이 더 이상 개선되지 않으면 자동으로 멈추는 early stopping을 적용해 과적합을 방지했습니다.

환경 참고. 원래 이 프로젝트의 모델은 PyTorch(model.py)로 짜여 있지만, 처음 작업하던 환경에서는 PyTorch가 DLL 로드 오류로 동작하지 않아 후보 1~5는 동일한 네트워크 크기·구조를 scikit-learn의 MLPRegressor/MLPClassifier로 재현해서 학습했습니다. 원인은 사용자 계정 경로가 길어서 Windows 경로 길이 제한(260자)에 PyTorch의 일부 DLL이 걸린 것으로 확인됐고, C:\ml_env 같은 짧은 경로에 새 가상환경을 만들어 설치하니 정상 동작했습니다 — 후보 5b(4.3절)는 이렇게 확보한 환경에서 실제 PyTorch로 학습했습니다. 앞으로는 이 짧은-경로 가상환경을 그대로 X-CUBE-AI 변환 파이프라인에도 재사용할 수 있습니다.

### 5.3 평가 지표

각 후보를 다음 기준으로 비교했습니다.

- 게이트 정확도(accuracy) / F1 — 접촉 여부를 얼마나 정확히 맞히는가.
- 모드별 회귀 R² / RMSE — 각 모드(근접/압력) 안에서 strain, distance/force를 얼마나 정확히 복원하는가. "정답 모드로 보내줬을 때(oracle routing)"와 "게이트가 직접 라우팅했을 때 (end-to-end)"를 나눠서 봐서, 게이트 오류가 최종 성능에 얼마나 영향을 주는지도 같이 확인했습니다.
- 파라미터 수 — 임베딩 비용의 대략적인 지표(INT8 양자화 시 1 파라미터 ≈ 1바이트).

## 6결과 비교

후보 | 게이트 정확도 | 전체 strain R² | 압력모드 strain R² | 압력모드 force/pos R² | 근접 거리 R² | 파라미터
C1 기준선 | 0.982 | 0.999 | 0.998 | 0.981 | 0.998 | 1,317
C2 게이트+EMA | 1.0000 | 0.9997 | 0.999 | 0.995 | 0.999 | 1,429
C3 통합 MLP | — | 0.998 | 0.993 | 0.963† | 0.999 | 1,506
C4 물리+잔차 | — | 0.999 | 0.999 | 0.993 | — | 704‡
C5 다중시간상수 | 0.999 | 0.999 | 0.997 | 0.996 | 0.999 | 1,765
C5b 진짜 RNN(GRU) | — | 0.999 | 0.999 | 0.995 | — | 306‡
C6 하이브리드(EMA게이트+GRU) | 1.0000 | 0.9997 | 0.999 | 0.995 | 0.999 | 1,061§

† C3의 압력모드 값은 force(N)가 아니라 통합 position(mm) 기준. ‡ C4·C5b는 압력모드 모델만 구현되어 전체 시스템 파라미터 수가 아님 (C5b는 게이트·근접모드를 별도로 만들지 않고 후보 2 것을 재사용한다고 가정). § C6은 C5b와 달리 실제로 조립해서 평가한 완전한 파이프라인입니다 — 게이트·Expert A(근접)는 후보 2의 EMA 4-input을 그대로 재사용하고, Expert B(압력)만 GRU로 교체한 뒤, 게이트가 실제로 예측한 라벨로 라우팅해서 held-out 전체를 통과시켰습니다(오라클 라우팅 아님). 게이트가 100% 정확해서(오분류 0/1,783) 결과가 오라클 라우팅 때(C5b·C2)와 거의 동일하게 나왔습니다. 위 표에서 "1.000"으로 반올림된 값은 게이트 정확도(정말로 정확히 1.0000, held-out 7,651개 샘플 전부 정답)뿐이고, 나머지 R²는 소수점 3자리에서 반올림된 근사치입니다 — 정확한 값은 아래 RMSE 표를 참고하세요.

6개 후보의 압력모드 성능 및 파라미터 수 비교 막대그래프

그림 9. 왼쪽: 히스테리시스 영향이 가장 큰 압력모드에서 6개 후보의 strain/force R² 비교. mms_20260806 단일 데이터셋 기준으로는 C1(이력 없음)조차 0.98 이상까지 올라와 여섯 후보 모두 비슷한 구간에 몰린다 — force R²만 C1이 나머지보다 살짝 처진다. 오른쪽: 후보별 파라미터 수 — C5b(진짜 GRU)가 나머지와 비슷한 정확도를 내면서 파라미터는 가장 작다.

### RMSE로 다시 보기 — 오차가 실제로 의미하는 것

위 R² 표는 후보 간 차이를 잘 안 보여줍니다. R² = 1 − RMSE²/Var(정답) 식에서, strain은 범위가 0~30%p, force는 0~10N으로 분모(정답의 분산)가 원래 크기 때문에, RMSE가 몇 배씩 벌어져도 R²는 0.98~0.99대에 다 같이 몰려 보입니다. 그래서 실제 오차 크기(RMSE, 원래 단위)로 후보를 다시 줄 세워봤습니다.

후보 | 근접 거리 RMSE | 압력모드 strain RMSE | 압력모드 force/pos RMSE | 전체 strain RMSE
C1 기준선 | 0.410 mm | 0.336 %p (0.40mm) | 0.521 N | 0.194 %p
C2 게이트+EMA | 0.318 mm | 0.172 %p (0.21mm) | 0.253 N | 0.108 %p
C3 통합 MLP | 0.322 mm | 0.570 %p (0.68mm) | 0.079 mm† | 0.288 %p
C4 물리+잔차 | — | 0.254 %p (0.30mm) | 0.314 N | —
C5 다중시간상수 | 0.259 mm | 0.386 %p (0.46mm) | 0.240 N | 0.215 %p
C5b 진짜 RNN(GRU) | — | 0.212 %p (0.25mm) | 0.263 N | —
C6 하이브리드(EMA게이트+GRU) | 0.318 mm | 0.212 %p (0.25mm) | 0.263 N | 0.123 %p (0.15mm)

† C3의 압력모드 값은 force(N)가 아니라 통합 position(mm) 기준이라 다른 후보의 force RMSE(N)와 직접 비교할 수 없음. strain %p는 센서 초기 길이(120mm) 기준으로 물리적 신장량(mm)으로 환산해 괄호에 같이 표기. C6의 "전체 strain RMSE"는 근접(0.078%p)·압력(0.212%p) 두 모드를 실제 게이트 라우팅으로 섞은 held-out 전체 기준입니다.

이 숫자들이 실제로 뜻하는 것

strain 오차는 이미 전부 서브밀리미터급입니다. %p를 실제 신장량으로 환산하면(120mm × 1%p = 1.2mm) 가장 나쁜 C3도 0.68mm, 가장 좋은 C2는 0.21mm — 최대 36mm까지 늘어나는 센서에서 이 정도 오차는 R²가 알려주는 것보다 훨씬 인상적인 정밀도입니다.

force 오차는 정답(F/T 센서) 자체의 잡음 바닥에 거의 다다랐습니다. 3.2절에서 확인했듯 F/T 로드셀 자체도 같은 조건에서 ±0.19N씩 흔들립니다. 가장 좋은 후보들(C5 0.240N, C2 0.253N, C5b 0.263N)은 이 잡음 바닥의 1.3~1.4배 수준까지 내려와 있어서, "정답"이라고 쓰는 라벨 자체의 측정 한계에 근접했다고 봐야 합니다 — 이보다 더 낮추려면 모델보다 먼저 더 정밀한 F/T 센서가 필요할 가능성이 큽니다. 반면 C1(0.521N, 잡음 바닥의 약 2.7배)과 C4(0.314N, 약 1.7배)는 아직 실질적인 개선 여지가 남아 있는 쪽입니다.

그래서 "이력 피처의 효과"를 정직하게 말하면 — R²로는 0.981→0.996(체감상 작은 차이)이지만, RMSE로는 force 오차가 0.521N→0.240N, 절반 이하로 준다(3.2절 F/T 잡음 바닥의 2.7배 → 1.3배)는 뜻입니다. 이게 원인이 되는 앞선 6장 "핵심 관찰 1"의 실제 크기입니다.

### 핵심 관찰 4가지

1. 이력 피처는 여전히 도움이 되지만, 그 크기는 데이터 품질에 좌우됐다

mms_20260805를 섞어 학습했을 때는 이력 피처가 없는 C1의 압력모드 strain R²가 0.78까지 떨어졌지만, 그 약한 데이터셋을 빼고 mms_20260806 만으로 다시 재보니 C1조차 0.998까지 올라왔다 — 이력 피처(EMA/GRU) 유무에 따른 차이가 훨씬 좁아진 것이다. 즉 이전 버전의 "이력 피처가 성능을 좌우한다"는 결론은 절반만 사실이었다. C1의 force R²(0.981)는 이력 피처가 있는 후보들(0.993~0.996)보다는 여전히 뒤처지므로, 이력 피처는 strain보다는 force 예측, 그리고 짧은 dwell·좁은 힘 범위처럼 데이터가 어려울 때 더 뚜렷하게 이득을 준다는 쪽으로 결론을 조정한다.

2. 게이트(모드분리)는 어려운 문제가 아니었다

이력 피처가 없어도(C1) 게이트 정확도가 이미 98.2%였고, 이력 피처를 넣으면 99.9~100.0%까지 올라간다. 접촉 시작 순간 dL/dR이 크게 꺾이는 특징이 뚜렷해서, 분류기 입장에서는 애초에 쉬운 축에 속했다.

3. 순수 물리식 역산은 이 문제에 안 맞는다

C4에서 ε×F 교차항을 넣은 물리식은, 짧은 dwell·좁은 힘 범위 데이터가 섞였을 때 strain이 0 근처에서 극심하게 발산했다(R²=−75). 품질 좋은 데이터만으로 다시 봐도 발산은 없어지지만 R²=0.26에 그쳐, MLP 계열(R²≥0.99)에는 한참 못 미친다. 물리식은 학습을 보조하는 피처/손실항 정도로는 쓸 수 있어도, 그 자체로 안정적인 역산 수단은 아니라는 게 데이터 품질과 무관하게 재확인됐다.

4. GRU는 "더 정확해서"가 아니라 "훨씬 작아서" 유리하다

약한 데이터셋을 뺀 뒤로는 C5b(GRU)의 압력모드 strain R²(0.999)·force R²(0.995)가 EMA 기반 후보들(C2: 0.999/0.995, C5: 0.997/0.996)과 사실상 동률이다 — "GRU가 EMA보다 정확하다"던 이전 결론은 데이터 품질 차이에서 온 착시에 가까웠다. 다만 파라미터는 여전히 306개로 최소이고 (C2의 절반 이하, C5의 3분의 1), 이건 데이터가 바뀌어도 변하지 않는 GRU 구조 자체의 이점이다. 4.1·3.3절의 EMA/SLS 수식이 "정답에 가까운 근사"였다는 뜻이자, 사람이 τ를 골라주지 않아도 신경망이 같은 정보를 스스로 더 작은 표현으로 압축해낼 수 있다는 뜻이기도 하다. C6에서 오라클이 아니라 실제 게이트로 라우팅한 완전한 파이프라인으로 다시 확인했을 때도 수치가 그대로 유지됐다 — 이 결론이 "정답을 미리 알려준" 평가 방식의 착시가 아니라는 뜻이다.

## 7결론 및 다음 단계

결론이 두 단계로 나뉩니다 — 지금 당장 완성된 형태로 쓸 수 있는 것과 다음에 투자할 가치가 가장 큰 방향입니다.

지금 배포 가능한 완결 파이프라인으로는 후보 2(게이트 + 데이터 기반 EMA)를 추천합니다 — 그리고 실제로 STM32에 임베딩해서 실기로 검증까지 마쳤습니다(8장). 게이트·근접모드·압력모드가 다 구현돼 있고, 시간상수 τ=1.01초도 실측 dwell 완화곡선에서 직접 피팅한 값이라 근거가 명확합니다. 다만 게이트는 원래 4-input(EMA 포함, held-out 정확도 100.0%)으로 배포했다가 실기 테스트에서 문제가 발견돼 2-input(원본만, 98.2%)으로 바꿨습니다 — 자세한 경위는 8장 참고.

후보 5b(진짜 GRU)는 "더 정확해서"가 아니라 "훨씬 작아서" 다음 투자 우선순위로 꼽습니다. mms_20260806 단일 데이터셋으로 다시 재보니 압력모드 strain·force R²가 EMA 기반 최고 성능(C2/C5, 0.995~0.999)과 GRU(0.999/0.995) 사이에 뚜렷한 우열은 없었습니다 — 약한 데이터셋이 섞여 있었을 때 GRU가 "더 정확해 보였던" 부분은 상당 부분 그 데이터셋 때문이었던 셈입니다. 다만 정확도가 동률인 채로 파라미터는 여전히 6분의 1 이하(1,765→306)이고, 이건 데이터 품질과 무관한 GRU 구조 자체의 이점입니다. C5b는 압력모드 전문가 하나만 구현한 부분 검증이라, 게이트와 근접모드까지 GRU(혹은 작은 순환 구조)로 통일한 완전한 파이프라인을 만들어 C2와 정면으로 비교해보는 게 다음 우선순위로 보입니다.

- 완료됨 — C2를 STM32G473에 실제로 임베딩하고 실시간 모니터 UI로 실기 검증까지 마쳤습니다(8장). 계획했던 "PyTorch로 옮겨서"는 결국 안 거쳤습니다 — sklearn 모델을 바로 ONNX로 export해도 충분해서 그 경로를 그대로 썼습니다.
- 다음 우선순위 — GRU 전체 파이프라인화 — 후보 5b를 게이트·근접모드까지 확장해서 "GRU 기반 완전한 MoE"를 만들고 C2와 정확도·파라미터 수를 나란히 비교. 다만 상태 리셋 로직· X-CUBE-AI 순환 레이어 지원·INT8 양자화 안정성 세 가지를 이 보드에서 먼저 검증해야 합니다 (4.3절 후보 5b 카드의 "임베딩엔 MLP에 없던 숙제" 참고).
- C4의 후속 활용 — ε×F 교차항은 역산용이 아니라, 원래 프로젝트의 PINN 손실함수 (PhysicsLoss) 제약항으로 추가하는 방향이 더 맞습니다. "예측값이 물리식과 얼마나 어긋나는지"를 학습 중 페널티로만 쓰면, 역산 시의 발산 문제 없이 물리적 타당성을 확보할 수 있습니다.
- 남은 리스크 — mms_20260805를 빼고 나니 τ 추정치가 0.5초→1.01초로 두 배 넘게 뛰었을 만큼, τ는 dwell 길이에 민감했습니다. 지금 쓰는 mms_20260806의 dwell도 평균 3.3초(≈3.3τ, 완화 약 96% 시점)로 아직 완전히 수렴하기 직전에 끊깁니다. dwell을 의도적으로 더 길게(예: 10초 이상) 유지하는 전용 실험을 한 번 더 돌리면 τ 추정 정확도를 더 높일 수 있고, GRU가 그보다 더 긴 시간규모의 크립도 스스로 잡아내는지도 확인할 거리입니다.
- 돌기 구조 재설계 — 3.1절 Q-factor 가설이 맞다면, 압력 집중점을 여러 개로 분산하거나 코일 트레이스를 최대변형점 밖으로 우회시키는 기구적 개선이 근본적인 노이즈 저감에 도움이 될 수 있습니다.

## 8STM32 실기 임베딩 및 실시간 검증

후보 2(게이트+EMA MLP)를 실제로 STM32G473CBT6 보드에 올리고, 실시간 모니터 UI로 관찰하면서 검증했습니다. 이 과정에서 오프라인 평가만으로는 안 보이던 문제가 하나 발견됐고, 그걸 고친 경위까지 이번 장에 정리합니다 — 이 프로젝트 전체를 관통하는 "실측으로 재확인하기 전까지는 결론을 확정하지 않는다"는 태도가 모델 학습 단계뿐 아니라 임베디드 단계에서도 그대로 적용된 사례입니다.

### 8.1 배포 파이프라인 — sklearn → ONNX → stedgeai → STM32

기존에 이 저장소에 있던 2단계(R→strain, L+strain→distance) 정적 디커플러 배포 코드 (stm32_deploy_md_xcubeai/, TDMFirmware/Core/Src/nn_inference.c)의 패턴을 그대로 재사용했습니다 — sklearn 모델을 skl2onnx로 ONNX 변환 → ST의 stedgeai.exe generate로 STM32용 C 코드 생성 → TDMFirmware/X-CUBE-AI/App/에 배치. 다만 이번 모델은 게이트+전문가(MoE) 구조라 네트워크가 1개(2단계 구조)가 아니라 3개(게이트·전문가A·전문가B)이고, 게이트는 분류기라는 점이 달랐습니다.

PyTorch로 옮기지 않았습니다. 7장 계획에는 "C2를 PyTorch(model.py 스타일)로 옮겨서"라고 적었는데, 실제로는 그럴 필요가 없었습니다 — 후보 2는 애초에 scikit-learn MLPClassifier/MLPRegressor로 학습돼 있었고, skl2onnx가 이걸 바로 ONNX로 변환해주기 때문에 PyTorch 변환 단계 자체를 건너뛸 수 있었습니다.

StandardScaler는 ONNX 그래프에 넣지 않고 mean_/scale_ 값만 뽑아서 C 헤더 상수(moe_params.h)로 박아넣었습니다 — 정규화 자체는 펌웨어에서 (x - mean) / scale 한 줄로 직접 계산합니다. 게이트·전문가A·전문가B는 각각 독립적으로 fit된 StandardScaler를 씁니다(4.3절 후보 2 학습 코드와 동일한 규칙) — 즉 C 헤더에는 스케일러 상수 세트가 3벌 들어갑니다.

배포 대상 | 구조 | 파라미터 | ONNX 검증(sklearn 대비 오차)
게이트 | 2→8→4→1 (tanh,tanh,sigmoid) | 65 | < 1e-6
전문가 A(근접) | 4→24→16→8→2 (tanh×3,linear) | 674 | < 1e-5
전문가 B(압력) | 4→24→16→8→2 (tanh×3,linear) | 674 | < 1e-5
합계 | | 1,413

Core/Src/moe_inference.c가 이 세 네트워크를 엮는 실제 추론 코드입니다 — 기존 nn_inference.c와 동일하게 X-CUBE-AI의 ai_<name>_create_and_init/_inputs_get/_outputs_get/_run API 패턴을 그대로 씁니다. main.c는 TDM 1ms 사이클마다 moe_inference_run(dL_pct, dR_pct)를 한 번 호출하고, 결과를 UART로 스트리밍합니다.

실제로 컴파일·링크까지 확인함

STM32CubeIDE에 포함된 arm-gcc 툴체인과 기존 Makefile 빌드 시스템으로 실제 make all을 돌려서 TDMFirmware.elf가 정상 생성되는 것까지 확인했습니다(시뮬레이션이 아니라 진짜 컴파일+링크). Flash 83.5KB, RAM(data+bss) 15.5KB — STM32G473CB(128KB flash)에서 여유가 충분합니다.

### 8.2 실시간 모니터 UI

nn_decoupling/moe_realtime_monitor.py(PyQt5 + pyqtgraph)로 UART 출력을 실시간 관찰합니다. 이 프로젝트에 이미 있던 STM32 시리얼 모니터들(realtime_monitor_test.py 등)의 STM32Reader(QThread)/카드/그래프 패턴을 재사용하되, PC 쪽에서 추가로 모델을 돌리지 않는다는 게 핵심 차이입니다 — 추론이 이미 보드 위에서 끝난 값을 받아서 그리기만 하는 순수 시각화·기록 툴입니다. ΔL·ΔR·strain·(근접거리/압력힘)·게이트 확률을 CLAUDE.md 색상 컨벤션대로 그리고, 접촉 여부에 따라 출력값 그래프의 선 색이 실시간으로 바뀝니다.

100Hz 실시간 렌더링 튜닝. 처음에는 화면이 눈에 띄게 끊겼는데, 원인을 하나씩 좁혀갔습니다 — (1) pyqtgraph가 매 프레임 auto-range를 재계산하는 것 → X/Y 축 범위를 전부 고정값으로 박고 auto-range 를 껐습니다. (2) Windows의 기본 타이머 해상도(~15.6ms) 때문에 time.sleep(0.001)이 실제로는 훨씬 길게 잠들어서 데이터가 뭉텅이로 들어왔던 것 → 시리얼 읽기를 폴링 방식에서 pyserial의 블로킹 readline()으로, UI 타이머는 Qt.PreciseTimer로 바꿨습니다. (3) 샘플마다 스레드 간 Qt 시그널을 emit하던 방식 → 리더 스레드는 잠금 없는 큐에 쌓기만 하고 UI 타이머가 한 번에 걷어가는(batch drain) 방식으로 바꿨습니다.

### 8.3 실기에서 드러난 문제 — "뗀 뒤에도 계속 접촉으로 유지됨"

보드를 실제로 눌렀다 떼면서 관찰하니, 뗀 이후에도 게이트가 한동안 계속 "접촉(압력 모드)"으로 판단하는 문제가 나타났습니다. 오프라인 평가에서는 게이트 정확도가 100.0%였는데(6장), 왜 실기에서는 이런 일이 생겼을까요?

원인 — EMA 리셋이 게이트 자신의 판단에 의존하는 자기강화 루프

게이트는 4-input(dL_pct, dR_pct, dL_ema, dR_ema)이었습니다. 학습 데이터에서 EMA는 진짜 접촉 여부 라벨(z_mm 기준)이 바뀌는 정확한 순간에 즉시 리셋되도록 만들어졌습니다(4.1절) — 하지만 실제 보드에는 z_mm이라는 정답이 없으니, "게이트 자신의 직전 판단이 바뀌면 리셋"이라는 방식으로 근사할 수밖에 없었습니다. 문제는 이 둘이 서로 물려있다는 점입니다.

뗀다 → 원본 dL/dR은 즉시 바뀜, dL_ema/dR_ema는 τ≈1초라 아직 "눌림" 값에 머묾 → 게이트가 (원본+EMA)를 같이 보고 "아직 접촉"이라고 판단 → 판단이 안 바뀌었으니 리셋 조건 자체가 안 걸림 → EMA는 리셋 없이 그냥 서서히(τ 단위로) 풀릴 때까지 기다려야 함

즉 게이트의 판단이 stale EMA에 좌우되는데, 그 판단이 리셋 여부를 결정하니 — 한번 어긋나면 스스로 못 빠져나오는 루프였습니다. 실제로 확인해보니 학습 데이터의 평균 압력 dwell 시간이 약 0.6초로, EMA 시간상수(1.01초)보다도 짧습니다 — 이 EMA는 애초에 사람이 손으로 빠르게 탭/릴리스하는 속도에는 안 맞는 시간축으로 설계돼 있었던 셈입니다.

수정: 게이트를 EMA 없는 2-input(dL_pct, dR_pct)으로 교체했습니다. 이건 4.3절 "후보 1"의 게이트와 정확히 같은 구조·학습 방식입니다(65 파라미터, held-out 정확도 98.2%, 4-input 게이트의 100.0%보다는 낮음). 접촉 여부는 원래 즉각적인 물리적 전환이라 EMA로 스무딩할 이유가 없었고, 이러면 위의 자기강화 루프 자체가 성립하지 않습니다. 펌웨어 로직도 "게이트 먼저 실행(원본만 사용) → 그 결과로 이번 사이클에 바로 EMA 리셋 여부 결정 → 전문가 실행" 순서로 바꿔서, 기존에 있던 "다음 호출에서 리셋"이라는 1사이클 지연도 함께 없앴습니다. 전문가 A/B는 이력이 실제로 회귀 정확도에 도움이 되는 자리라 4-input(EMA 포함)을 그대로 유지했습니다.

6장·8.3절을 종합하면

6장의 "핵심 관찰 2"에서는 이력 피처가 게이트 정확도를 98.2%→100.0%로 올린다고 정리했었는데, 그 100.0%는 학습 때만 가능한 조건(정답 라벨로 EMA를 정확한 순간에 리셋)에서 잰 값이었다는 게 이번에 드러났습니다. 실기에서 재현 가능한 리셋 규칙(자기 판단 기반)으로 바꾸면 그 이점이 사라질 뿐 아니라 오히려 새로운 실패 모드(자기강화 루프)를 만듭니다. "이력 피처가 회귀 정확도에는 도움이 되지만, 그 이력 피처 자체를 게이트 입력으로 쓰는 건 실기 배포 관점에서는 손해"라는 게 이 절의 결론입니다 — 오프라인 지표만으로는 절대 안 보였을 문제였습니다.

## 9용어집

TDM (Time Division Measurement)

하나의 센서를 짧은 시간 단위로 쪼개서 여러 물리량을 순서대로 측정하는 방식. 이 프로젝트에서는 1ms마다 L→R→(TENG) 순으로 측정.

인덕턴스(L) / 저항(R)

코일의 전기적 특성 두 가지. L은 공진 주파수로 역산, R은 전압분배로 직접 측정. 둘 다 변형/근접/압력에 따라 달라진다.

strain (변형률/인장)

센서가 원래 길이 대비 얼마나 늘어났는지 (%). 이 실험에서는 0~30%.

MLP (다층 퍼셉트론)

입력층→은닉층 여러 개→출력층으로 이어지는 가장 기본적인 신경망 구조. 각 층 사이의 연결 가중치가 학습되는 "파라미터"다.

파라미터(parameter)

모델이 학습을 통해 값을 정하는 내부 숫자들의 총 개수. 많을수록 표현력은 커지지만 저장공간·연산량도 커진다.

R² (결정계수)

0~1 사이 값으로, 1이면 예측이 정답과 완벽히 일치. "그냥 평균값을 답으로 냈을 때보다 얼마나 나아졌는가"를 나타낸다.

RMSE / MAE

예측 오차를 원래 단위로 나타낸 지표. RMSE(평균제곱근오차)는 큰 오차에 더 큰 벌점을, MAE(평균절대오차)는 오차 크기를 그대로 반영한다.

held-out / train-test split

모델 성능을 정직하게 재기 위해, 학습에 전혀 안 쓴 데이터를 따로 떼어 시험 보는 방법.

게이트 / 전문가(Mixture of Experts)

먼저 작은 분류기(게이트)로 상황을 구분하고, 상황별로 준비된 전문 모델(전문가)에게 나머지 일을 맡기는 구조.

EMA (지수이동평균)

최근 값에 더 큰 가중치를 주는 이동평균. 시간이 지날수록 과거 영향력이 지수적으로 줄어든다.

시간상수(τ) / 반감기(half-life)

어떤 변화가 얼마나 빨리 "잊혀지는지"를 나타내는 시간 값. EMA의 half-life = τ × ln(2).

히스테리시스

같은 조건(같은 힘, 같은 깊이)이라도 누르는 중이었는지 떼는 중이었는지에 따라 다른 값이 나오는 현상. 이력(과거)에 의존한다는 뜻.

크립(creep)

물체에 일정한 힘을 계속 가했을 때, 시간이 지나며 변형이 서서히 더 커지는 현상. 여기서는 "가역적(힘을 빼면 되돌아옴)"으로 확인됐다.

Q-factor

공진(진동)이 얼마나 "날카로운지"를 나타내는 지표. 낮으면 공진 주파수를 정확히 읽기 어려워 측정 노이즈가 커진다.

SNR (신호대잡음비)

진짜 신호 크기 대비 잡음 크기의 비율. 측정 범위가 좁을수록(예: 좁은 힘 범위) 상대적으로 SNR이 나빠지기 쉽다.

조건수(condition number)

역산 문제가 노이즈에 얼마나 민감한지 나타내는 수치. 1에 가까울수록 안정적, 클수록 작은 입력 오차가 크게 증폭된다.

PINN (Physics-Informed Neural Network)

신경망의 학습 손실함수에 알려진 물리 방정식을 제약조건으로 함께 넣어, 데이터가 적어도 물리적으로 타당한 답을 찾도록 유도하는 방법.

양자화(quantization) / INT8

모델 내부 숫자를 32비트 실수 대신 8비트 정수로 근사해서, 저장공간과 연산량을 크게 줄이는 임베디드 배포 기법.

StandardScaler / 정규화

입력 각 열을 (x−μ)/σ로 변환해 평균 0·표준편차 1로 맞추는 전처리. 입력끼리 값 범위가 다르면 학습이 불안정해지는 문제를 막는다. μ, σ는 반드시 학습 데이터에서만 구해서 테스트/추론에도 그대로 재사용한다.

실험 데이터: nn_decoupling/pressure_0805test/test0805_dataset/ · 분석/모델링 코드: nn_decoupling/pressure_0805test/, nn_decoupling/test0807_MoEDecoupling/ · 임베디드 배포: nn_decoupling/export_moe_onnx.py, TDMFirmware/Core/Src/moe_inference.c, nn_decoupling/moe_realtime_monitor.py · 이 보고서는 2026-08-05~14 대화 세션에서 진행한 분석을 정리한 기록입니다.
