HeejunMoon53/MultimodalSensor/nn_decoupling/test0816_RealtimeDecoupling/moe_v2_compare.html

MoE Decoupler · Retrain Comparison

# 0817 재학습 비교 — 구모델 vs 신모델

학습 데이터 moe_monitor_20260817_002534.csv (59,442행, realtime_train_seq2.txt로 수집) 배포 TDMFirmware/X-CUBE-AI/App/ 에 반영 완료, 빌드 통과 구모델 백업 test0816_RealtimeDecoupling/firmware_backup_v1_pre0817/

## 무엇이 바뀌었나

- 저항 IIR 필터 제거 + 500Hz 출력으로 수집된 데이터로 학습 — 실시간 배포 조건과 더 가까움
- 접촉 판정 기준을 Z_mm<0에서 Z_mm≤-24.5로 정정 (이번 세션은 ZERO를 far 지점에서 잡아서, 실측 힘이 그 지점을 넘어야 커지는 것으로 확인)
- 근접거리 라벨을 dist_mm = Z_mm+25(0=접촉, 25=원거리)로 재정의
- dR_pct raw 극단 이상치(49826% 튐 1건) 제거 후 재학습 — StandardScaler 왜곡 해소
- 스케일러 상수·출력 클램프(moe_params.h)를 신모델 기준으로 갱신 — 힘 부호를 반전(누르면 양수)시켜 기존 규약으로 통일하고 FORCE_MIN/MAX_N을 (-2.0, 14.0)으로 재설정. 게이지 확률(gate_proba∉[0,1])을 이용한 UART 손상행 필터도 추가해 재학습·재배포함

주의 — 이 비교는 서로 다른 기준입니다

구모델 수치는 실제 실시간 배포 결과(0816 실험 보고서 기준)이고, 신모델 수치는 오프라인 held-out 결과입니다(아직 실기 검증 전). 직접 비교라기보다 "지금까지 확인된 것" 정도로 보는 게 맞습니다 — 신모델도 실시간에서 돌리면 오프라인보다 낮게 나올 가능성이 있습니다(구모델도 오프라인 R²는 0.999대였지만 실시간에선 0.4~0.86이었습니다).

comparison bar chart

그림 1. Gate 정확도, Strain/Proximity/Pressure R² — 구모델(실시간) vs 신모델(오프라인)

## 신모델 세부 지표 (오프라인 held-out, 시간윈도우 10초 단위 5개 중 1개)

모델 | 지표 | n (train/test) | 값
Gate | accuracy / f1 | 46,985 / 12,457 | 0.941 / 0.874
Expert A (근접) | strain R² (RMSE) | 34,990 / 9,505 | 0.993 (0.88%p)
Expert A (근접) | dist R² (RMSE) | 34,990 / 9,505 | 0.917 (2.35mm)
Expert B (압력) | strain R² (RMSE) | 11,995 / 2,952 | 0.998 (0.31%p)
Expert B (압력) | force R² (RMSE) — 부호수정+필터강화 | contact 14,945 / 59,426행 | 0.849 (1.77N)
End-to-end | strain R² (게이트 라우팅 포함) | — / 12,457 | 0.991

접촉 비율은 전체의 25.1%(14,945/59,426행) — 이전에 잘못된 기준(90.9%)으로 돌렸을 때보다 훨씬 상식적인 분포이고, 근접(Expert A) 데이터도 충분히 확보돼서 이전 시도(strain R²=0.59, dist NaN)보다 크게 좋아졌습니다. Force 부호를 반전(누르면 양수)하고 gate_proba∉[0,1] 등 UART 손상 필터를 강화한 뒤 force R²도 0.800 → 0.849로 개선됐습니다.

## 다음 단계

- 실기 검증이 아직 안 됐습니다 — realtime_test_seq2.txt 계열로 실시간 테스트하고 이번 오프라인 수치와 비교해봐야 진짜 배포 성능을 알 수 있습니다.
- ~~힘 부호 반전(-12.4N까지) 원인을 확인하세요~~ — 확인·조치 완료. RFT 원시값이 이번 세션엔 누를수록 음수로 나오는 것으로 확인, 학습·펌웨어 양쪽에서 부호를 반전시켜 "누르면 양수" 규약으로 통일하고 재배포했습니다.
- 혹시 신모델이 실기에서 기대에 못 미치면 test0816_RealtimeDecoupling/firmware_backup_v1_pre0817/의 파일들을 TDMFirmware/X-CUBE-AI/App/에 다시 복사하면 바로 이전 상태로 복구됩니다.

## 부록 — 배경 참고 그림 (근접압력_통합센서_디커플링_실험보고서에서)

이번 재학습이 기반하고 있는 게이트+전문가(MoE) 구조, 히스테리시스/SLS 모델링, 후보 비교 실험의 원본 그림들 — nn_decoupling/test0807_MoEDecoupling/근접압력_통합센서_디커플링_실험보고서.html 에서 그대로 가져왔다.

그림 1. 1ms TDM 측정 사이클 개요. 같은 코일 하나를 아날로그 스위치로 세 가지 모드에 순차 연결해서 L·R·(TENG) 세 신호를 번갈아 읽는다. 이번 실험에서 실제로 쓰인 입력은 L, R 두 채널뿐이다.

test0805 시계열: strain 계단, position 왕복, force, dL, dR 5개 패널

그림 2. test0805 데이터셋 시계열 (전체 457초, 19 사이클). 위에서부터 Strain(계단형 증가), Position(25↔−1.2mm 왕복), Force, ΔL/L₀, ΔR/R₀. 압력 구간마다 Force가 뾰족하게 솟을 때 ΔL은 급격히 오목하게 꺾이고 ΔR은 뾰족하게 튀는 것이 보인다.

test0806 시계열: 더 강한 힘(최대 10.1N)까지 압축한 두 번째 데이터셋

그림 2b. test0806 데이터셋 시계열 (569초, 19 사이클, 최대 압축힘 10.1N). ΔR(맨 아래)의 피크가 사이클이 진행될수록(=strain이 커질수록) 눈에 띄게 높아지는 것이 보인다 — 3.4절에서 다룰 인장×압력 교차 민감도의 첫 단서다.

strain 0%, 한 사이클의 ΔL,ΔR vs Fz 산점도

그림 3a. strain 0% 사이클(최대 10.1N) — ΔL 반전이 약하게만 보인다.

strain 30%, 한 사이클의 ΔL,ΔR vs Fz 산점도

그림 3b. strain 30% 사이클(최대 9.2N) — ΔL이 뚜렷하게 반전(−30%→−21%)한다. 위아래 두 갈래로 갈라진 모양이 로딩/언로딩 히스테리시스(3.3절).

Force-Strain-L 3D 그래프, 오버샘플링 적용

그림 3c. Force(오버샘플링)-Strain-ΔL. 힘 측정치 노이즈를 줄이자 사이클마다 로딩/언로딩 경로가 뚜렷이 구분된다.

Force-Strain-R 3D 그래프, 오버샘플링 적용

그림 3d. Force(오버샘플링)-Strain-ΔR. strain이 커질수록 같은 힘 범위(0~10N)에서 반응 폭 자체가 커지는 것이 보인다.

그림 3e. 표준선형고체(SLS) 모델의 블록도. 같은 압축 변형이 동시에 두 경로로 들어가서, 즉시 반응하는 탄성 성분(위)과 시간이 걸려 완화되는 점탄성 성분(아래, 파란색)이 더해진 것이 실제 측정값이다. dwell 중 드리프트의 정체는 바로 이 파란 경로다.

시간상수 피처 유무에 따른 힘 예측 비교, 최대 10N까지

그림 4. 왼쪽: 시간(0~6.5초) 동안의 실제 힘(검정, 최대 약 10N) vs 기본 모델(파랑 점선, 위상 지연 발생) vs 시간상수 피처를 더한 모델(빨강, RMSE 0.51N→0.24N, 54% 개선). 오른쪽: 깊이-힘 히스테리시스 루프 — 실제(검정)는 로딩·언로딩 경로가 뚜렷이 벌어진다. 기본 모델(파랑)도 루프를 어느 정도 재현하는데, 이는 입력으로 쓰는 원본 dL·dR 자체가 이미 로딩/언로딩에 따라 조금씩 다른 값을 갖기 때문이다 — 즉 이력 피처 없이도 "그 순간 값에 우연히 남아있는 힌트"만으로 일부는 재현된다. 다만 그 힌트만으로는 다 못 풀리는 애매함이 남아 있고(이게 그림 왼쪽의 RMSE 차이 0.28N의 정체), 시간상수 모델(빨강)이 그 나머지를 마저 풀어서 루프 모양을 10N 근처 강한 압축에서도 훨씬 정확하게 재현한다.

strain에 따른 압력 반응폭과 히스테리시스 루프 면적 성장

그림 5. strain이 커질수록 압력에 대한 반응 폭(왼쪽)과 실측 히스테리시스 루프 면적(오른쪽)이 모두 커진다 — R(초록)이 L(주황)보다 훨씬 급격하게 커진다. R의 경우 면적/반응폭 비율은 strain과 거의 무관하게 일정했지만(=신호가 커진 만큼 루프도 비례해서 커진 것뿐), L은 상대적으로도 나빠지는 추세가 있었다.

(dL,dR,이력)에서 근접모드는 strain·거리, 압력모드는 strain·force를 동시에 복원한 결과 산점도

그림 6. (dL, dR, 이력 피처) → (strain, force/거리) 동시 회귀, 둘 다 held-out 사이클 3개(strain 6.7%/15.0%/23.3%, 4.3절 후보들과 동일한 cycle_id 분할) 기준. 위 두 칸: 근접모드 — strain R²=0.9999(MAE 0.06%p), 거리 R²=0.9989(MAE 0.20mm). 아래 두 칸: 압력모드 — strain R²=0.999(MAE 0.13%p), force R²=0.995(MAE 0.20N). 두 모드 모두 대각선을 빈틈없이 따라가는데, 압력모드 쪽이 그래도 오차가 조금 더 큰 건 4.1절 EMA 이력 피처의 효과가 애초에 히스테리시스가 있는 압력모드에 더 집중돼 있기 때문입니다.

EMA 가중치가 시간에 따라 지수적으로 감소하는 그래프, τ=1.01초와 half-life=0.702초 지점 표시

그림 6b. τ=1.01초일 때 가중치가 시간에 따라 줄어드는 모습. half-life(반감기, 가중치가 정확히 절반이 되는 시점)는 0.702초 — 이 값이 실제 코드의 EMA_HALFLIFE_S다.

그림 6c. 이력 피처 적용 파이프라인. 원본 신호(dL_pct, dR_pct)가 그대로 한 경로로 흘러가는 동시에(위), 파란색으로 강조된 EMA 재귀식을 거쳐 dL_ema/dR_ema로도 계산되고(아래), 두 경로가 4개짜리 벡터로 합쳐진 뒤 정규화를 거쳐 MLP에 들어간다.

그림 7. 게이트+전문가(MoE) 구조의 기본 뼈대. dL, dR(과 이력 피처)이 게이트로 들어가 접촉 여부를 판단하고, 그 결과에 따라 두 전문가 중 하나로 라우팅된다. 두 전문가 모두 항상 strain을 같이 출력하고, 나머지 출력만 모드에 따라 다르다. 박스 아래 N → 8 → 4 → 1 같은 표기가 레이어 구조(입력 → 은닉층 → 출력)이며, 입력 개수 N은 후보마다 다르다 — 정확한 값은 4.4절 표 참고.

Model A(기준선) vs Model B(+EMA MLP) vs GRU 예측 힘 비교, held-out 테스트 사이클

그림 7b. held-out 테스트 사이클(strain 15.0%)에서 실제 힘(검정) vs Model A(파랑 점선, 이력 없음, RMSE 0.52N) vs Model B(빨강 1점쇄선, +EMA MLP, RMSE 0.25N) vs GRU(보라, RMSE 0.28N)를 한 그래프에 겹쳐 그렸습니다. Model A만 위상이 뒤처지며 눈에 띄게 벗어나고, Model B와 GRU는 로딩·언로딩 양쪽 경로 모두 실제 값을 거의 겹치게 따라갑니다 — 이 사이클 하나만 보면 Model B가 GRU보다 근소하게 더 정확하지만(6장 RMSE 표 기준 전체 평균은 GRU 0.263N, Model B와 동급 후보 2가 0.253N으로 둘 다 비슷한 구간), 파라미터는 GRU가 306개로 Model B(674개)의 절반 이하입니다.

그림 8. 후보 1(기준) 대비 각 후보의 구조적 차이. 파란 강조 부분이 후보 1과 다른 지점이다.

6개 후보의 압력모드 성능 및 파라미터 수 비교 막대그래프

그림 9. 왼쪽: 히스테리시스 영향이 가장 큰 압력모드에서 6개 후보의 strain/force R² 비교. mms_20260806 단일 데이터셋 기준으로는 C1(이력 없음)조차 0.98 이상까지 올라와 여섯 후보 모두 비슷한 구간에 몰린다 — force R²만 C1이 나머지보다 살짝 처진다. 오른쪽: 후보별 파라미터 수 — C5b(진짜 GRU)가 나머지와 비슷한 정확도를 내면서 파라미터는 가장 작다.

학습 스크립트: nn_decoupling/test0816_RealtimeDecoupling/retrain_moe_v2.py · 결과물: test0816_RealtimeDecoupling/stm32_deploy_moe_v2/
