HeejunMoon53/MultimodalSensor/nn_decoupling/test0909_realtime/moe_monitor_20260909_142710.csv

t_s | dL_pct | dR_pct | dV_pct | IDRIVE | STATUS | strain_pct | value | mode | gate_proba | latency_us | XA_mm | YA_mm | Z_mm | Fz_act_N | strain_act_pct | value_act
480.0992 | -0.026 | -0.2038 | 5.7518 | 31 | 72 | -0.271 | 23.122 | 0 | 0.006 | 258.15 | 0.0 | 0.0 | 0.0 | -0.3236 | 0.0 | 0.0
480.1087 | -0.018 | 0.1497 | -4.9904 | 31 | 72 | -0.111 | 23.115 | 0 | 0.006 | 258.08 | 0.0 | 0.0 | 0.0 | -0.3236 | 0.0 | 0.0
480.1989 | -0.006 | -0.5453 | -5.6677 | 31 | 72 | -0.231 | 23.517 | 0 | 0.006 | 257.73 | 0.0 | 0.0 | 0.0 | -0.1236 | 0.0 | 0.0
480.281 | 0.016 | 0.1078 | -4.9939 | 31 | 72 | -0.075 | 23.478 | 0 | 0.006 | 257.69 | 0.0 | 0.0 | 0.0 | 0.0564 | 0.0 | 0.0
480.3492 | 0.026 | -0.012 | 6.6994 | 31 | 72 | -0.114 | 23.603 | 0 | 0.006 | 257.94 | 0.0 | 0.0 | 0.0 | -0.1836 | 0.0 | 0.0
480.4099 | 0.004 | 0.3415 | -8.7665 | 31 | 72 | 0.073 | 23.347 | 0 | 0.006 | 257.72 | 0.0 | 0.0 | 0.0 | -0.0636 | 0.0 | 0.0
480.4842 | 0.02 | 0.1198 | 3.1233 | 31 | 72 | -0.056 | 23.512 | 0 | 0.006 | 257.53 | 0.0 | 0.0 | 0.0 | 0.1364 | 0.0 | 0.0
480.5797 | -0.01 | -0.1199 | -3.2427 | 31 | 72 | -0.213 | 23.253 | 0 | 0.006 | 257.76 | 0.0 | 0.0 | 0.0 | 0.1964 | 0.0 | 0.0
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
