HeejunMoon53/MultimodalSensor/nn_decoupling/test0909_realtime/moe_monitor_20260909_143454.csv

t_s | dL_pct | dR_pct | dV_pct | IDRIVE | STATUS | strain_pct | value | mode | gate_proba | latency_us | XA_mm | YA_mm | Z_mm | Fz_act_N | strain_act_pct | value_act
900.1346 | -0.2819 | -0.4973 | 14.6201 | 31 | 72 | -0.958 | 20.815 | 0 | 0.006 | 257.74 | 0.0 | 0.0 | 0.0 | 0.3895 | 0.0 | 0.0
900.1778 | -0.3118 | -0.3715 | 6.1695 | 31 | 72 | -0.877 | 20.233 | 0 | 0.006 | 258.15 | 0.0 | 0.0 | 0.0 | 0.1164 | 0.0 | 0.0
900.2078 | -0.2978 | 0.0599 | 0.7755 | 31 | 72 | -0.722 | 20.627 | 0 | 0.006 | 258.61 | 0.0 | 0.0 | 0.0 | 0.2964 | 0.0 | 0.0
900.2573 | -0.2779 | -0.731 | -2.6953 | 31 | 72 | -0.99 | 21.031 | 0 | 0.006 | 258.41 | 0.0 | 0.0 | 0.0 | -0.0223 | 0.0 | 0.0
900.2983 | -0.2799 | -0.3296 | -1.2669 | 31 | 72 | -0.92 | 20.807 | 0 | 0.006 | 257.85 | 0.0 | 0.0 | 0.0 | -0.2636 | 0.0 | 0.0
900.3264 | -0.2739 | -0.048 | 15.7255 | 31 | 72 | -0.811 | 20.949 | 0 | 0.006 | 257.46 | 0.0 | 0.0 | 0.0 | 0.3164 | 0.0 | 0.0
900.3784 | -0.2898 | -0.2337 | 10.0333 | 31 | 72 | -0.873 | 20.635 | 0 | 0.006 | 258.28 | 0.0 | 0.0 | 0.0 | -0.1036 | 0.0 | 0.0
900.4323 | -0.2599 | -0.1079 | 2.0915 | 31 | 72 | -0.852 | 21.146 | 0 | 0.006 | 258.51 | 0.0 | 0.0 | 0.0 | 0.052 | 0.0 | 0.0
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
