HeejunMoon53/MultimodalSensor/nn_decoupling/test0909_realtime/moe_monitor_20260909_193809.csv

t_s | dL_pct | dR_pct | dV_pct | IDRIVE | STATUS | strain_pct | value | mode | gate_proba | latency_us | XA_mm | YA_mm | Z_mm | Fz_act_N | strain_act_pct | value_act
18561.7278 | -0.096 | 0.6921 | -2.6724 | 31 | 72 | 2.322 | 17.856 | 0 | 0.006 | 258.35 | 0.0 | 0.0 | 0.0 | 0.5564 | 0.0 | 0.0
18561.7842 | -0.088 | 0.8065 | 0.5358 | 31 | 72 | 2.381 | 18.189 | 0 | 0.006 | 258.38 | 0.0 | 0.0 | 0.0 | -0.0381 | 0.0 | 0.0
18561.8211 | -0.074 | 0.3851 | -3.9181 | 31 | 72 | 2.247 | 17.579 | 0 | 0.006 | 258.54 | 0.0 | 0.0 | 0.0 | 0.1764 | 0.0 | 0.0
18561.8768 | -0.062 | -0.0061 | 1.9078 | 31 | 72 | 2.308 | 17.366 | 0 | 0.006 | 258.31 | 0.0 | 0.0 | 0.0 | -0.0036 | 0.0 | 0.0
18561.9299 | -0.056 | 0.5236 | -10.8533 | 31 | 72 | 2.263 | 18.038 | 0 | 0.006 | 257.73 | 0.0 | 0.0 | 0.0 | 0.1406 | 0.0 | 0.0
18561.9857 | -0.056 | 0.331 | 2.3003 | 31 | 72 | 2.238 | 17.752 | 0 | 0.006 | 258.24 | 0.0 | 0.0 | 0.0 | 0.0564 | 0.0 | 0.0
18562.0409 | -0.06 | 0.4032 | -2.553 | 31 | 72 | 2.245 | 17.792 | 0 | 0.006 | 258.36 | 0.0 | 0.0 | 0.0 | -0.0436 | 0.0 | 0.0
18562.0864 | -0.042 | 0.1865 | 2.5392 | 31 | 72 | 2.255 | 17.771 | 0 | 0.006 | 258.26 | 0.0 | 0.0 | 0.0 | 0.7564 | 0.0 | 0.0
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
