HeejunMoon53/MultimodalSensor/nn_decoupling/test0909_realtime/new/moe_monitor_20260909_214746.csv

t_s | dL_pct | dR_pct | dV_pct | IDRIVE | STATUS | strain_pct | value | mode | gate_proba | latency_us | XA_mm | YA_mm | Z_mm | Fz_act_N | strain_act_pct | value_act
1259.4397 | -0.2159 | -0.0417 | -5.1277 | 31 | 72 | -1.305 | 22.606 | 0 | 0.006 | 258.22 | 0.0 | 0.0 | 0.0 | 0.217 | 0.0 | 0.0
1259.4749 | -0.2159 | -0.6076 | -6.6311 | 31 | 72 | -1.575 | 22.79 | 0 | 0.006 | 257.25 | 0.0 | 0.0 | 0.0 | -0.2524 | 0.0 | 0.0
1259.4925 | -0.2199 | 0.125 | -4.444 | 31 | 72 | -1.174 | 22.576 | 0 | 0.006 | 257.87 | 0.0 | 0.0 | 0.0 | 0.0476 | 0.0 | 0.0
1259.5126 | -0.2059 | 0.1012 | -5.1575 | 31 | 72 | -1.186 | 22.72 | 0 | 0.006 | 257.76 | 0.0 | 0.0 | 0.0 | 0.1953 | 0.0 | 0.0
1259.5677 | -0.19 | -0.1906 | -3.1131 | 31 | 72 | -1.391 | 22.908 | 0 | 0.006 | 257.82 | 0.0 | 0.0 | 0.0 | -0.2159 | 0.0 | 0.0
1259.6029 | -0.2199 | -0.7088 | -0.9924 | 31 | 72 | -1.598 | 22.802 | 0 | 0.006 | 257.58 | 0.0 | 0.0 | 0.0 | -0.5124 | 0.0 | 0.0
1259.6411 | -0.2339 | 0.0595 | -5.2173 | 31 | 72 | -1.239 | 22.417 | 0 | 0.006 | 257.83 | 0.0 | 0.0 | 0.0 | -0.0924 | 0.0 | 0.0
1259.6678 | -0.2119 | 0.405 | -7.9122 | 31 | 72 | -0.882 | 22.745 | 0 | 0.006 | 258.15 | 0.0 | 0.0 | 0.0 | -0.3661 | 0.0 | 0.0
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
