HeejunMoon53/MultimodalSensor/nn_decoupling/test0909_realtime/new/moe_monitor_20260909_220210.csv

t_s | dL_pct | dR_pct | dV_pct | IDRIVE | STATUS | strain_pct | value | mode | gate_proba | latency_us | XA_mm | YA_mm | Z_mm | Fz_act_N | strain_act_pct | value_act
1819.4759 | -0.3258 | -1.084 | -1.9316 | 31 | 72 | -2.0 | 22.368 | 0 | 0.006 | 257.71 | 0.0 | 0.0 | 0.0 | 0.5571 | 0.0 | 0.0
1819.4809 | -0.3657 | -0.1311 | 3.8963 | 31 | 72 | -1.641 | 21.431 | 0 | 0.006 | 257.31 | 0.0 | 0.0 | 0.0 | 0.0536 | 0.0 | 0.0
1819.5126 | -0.3537 | -0.3634 | 5.0014 | 31 | 72 | -1.793 | 21.601 | 0 | 0.006 | 258.35 | 0.0 | 0.0 | 0.0 | -0.2371 | 0.0 | 0.0
1819.5281 | -0.3178 | 0.1012 | 5.3831 | 31 | 72 | -1.498 | 22.112 | 0 | 0.006 | 257.76 | 0.0 | 0.0 | 0.0 | 0.1476 | 0.0 | 0.0
1819.5696 | -0.3218 | -0.3872 | 4.5667 | 31 | 72 | -1.841 | 22.056 | 0 | 0.006 | 257.96 | 0.0 | 0.0 | 0.0 | 0.0549 | 0.0 | 0.0
1819.5752 | -0.3458 | -0.6076 | 5.944 | 31 | 72 | -1.913 | 21.804 | 0 | 0.006 | 257.52 | 0.0 | 0.0 | 0.0 | -0.2124 | 0.0 | 0.0
1819.6124 | -0.3897 | -0.4408 | 1.0885 | 31 | 72 | -1.775 | 21.061 | 0 | 0.006 | 257.97 | 0.0 | 0.0 | 0.0 | 0.043 | 0.0 | 0.0
1819.6174 | -0.3398 | 0.0297 | 4.5634 | 31 | 72 | -1.55 | 21.825 | 0 | 0.006 | 257.76 | 0.0 | 0.0 | 0.0 | 0.0075 | 0.0 | 0.0
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
