HeejunMoon53/MultimodalSensor/nn_decoupling/test0909_realtime/new/moe_monitor_20260909_222022.csv

t_s | dL_pct | dR_pct | dV_pct | IDRIVE | STATUS | strain_pct | value | mode | gate_proba | latency_us | XA_mm | YA_mm | Z_mm | Fz_act_N | strain_act_pct | value_act
3171.9305 | -0.004 | -0.1906 | 6.9264 | 31 | 72 | 0.02 | 23.019 | 0 | 0.006 | 257.93 | 0.0 | 0.0 | 0.0 | 0.6901 | 0.0 | 0.0
3171.9369 | -0.016 | -0.5659 | -6.9198 | 31 | 72 | 0.036 | 23.092 | 0 | 0.006 | 257.05 | 0.0 | 0.0 | 0.0 | 0.7198 | 0.0 | 0.0
3171.9554 | -0.008 | -0.1073 | -9.6911 | 31 | 72 | 0.03 | 22.933 | 0 | 0.006 | 257.94 | 0.0 | 0.0 | 0.0 | 0.022 | 0.0 | 0.0
3171.9913 | -0.04 | 0.0119 | -5.3102 | 31 | 72 | 0.042 | 22.454 | 0 | 0.006 | 257.99 | 0.0 | 0.0 | 0.0 | -0.1524 | 0.0 | 0.0
3172.0096 | -0.032 | 0.1369 | 0.5409 | 31 | 72 | 0.105 | 22.558 | 0 | 0.006 | 257.86 | 0.0 | 0.0 | 0.0 | 0.6289 | 0.0 | 0.0
3172.0441 | -0.054 | 0.0357 | 0.916 | 31 | 72 | 0.042 | 22.249 | 0 | 0.006 | 258.3 | 0.0 | 0.0 | 0.0 | 0.1876 | 0.0 | 0.0
3172.0839 | -0.016 | 0.0774 | -2.0776 | 31 | 72 | 0.086 | 22.781 | 0 | 0.006 | 258.12 | 0.0 | 0.0 | 0.0 | 0.5476 | 0.0 | 0.0
3172.1006 | -0.076 | -0.0358 | -10.3349 | 31 | 72 | 0.017 | 21.907 | 0 | 0.006 | 257.84 | 0.0 | 0.0 | 0.0 | 0.4476 | 0.0 | 0.0
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
