HeejunMoon53/MultimodalSensor/nn_decoupling/data_acquisition/dataset/test.csv

eps_act_pct | d_act_mm | dL_pct | dR_pct
3.625 | 2.59 | -14.146241663024695 | 1.700001974450609
15.0 | 17.87 | 8.717849526281519 | 8.917022694312704
8.7083 | 34.48 | 5.3243926041874 | 5.178983947716548
15.625 | 22.33 | 9.032765270278231 | 9.076549450115506
8.75 | 30.39 | 5.343999047089976 | 5.0954415396072585
19.0367 | 28.41 | 12.128670633751227 | 11.868422611408375
3.38 | 31.44 | 1.7190788229390686 | 1.5617904318123483
8.9267 | 11.7 | 3.572812404724912 | 5.589669674413095
30.0 | 22.33 | 19.58687996997739 | 18.490729954390194
25.0 | 17.16 | 15.783536354823768 | 15.517579273311647
2.3233 | 1.07 | -23.682723998488175 | 1.0760755819693169
8.75 | 10.47 | 2.852582107531121 | 5.0954415396072585
8.75 | 7.87 | 1.2198040598544457 | 5.271822208285972
26.2233 | 34.48 | 17.173419188672547 | 16.121389223448578
3.87 | 16.26 | 1.0308131761983752 | 1.9369360475447708
20.0 | 9.9 | 10.145190529207525 | 12.55438403950927
7.5 | 19.95 | 4.012813489029354 | 3.8372594363657746
19.8483 | 31.44 | 12.652001274226388 | 11.951349536991332
4.625 | 2.59 | -13.14043265765732 | 2.3239283669319013
3.75 | 9.43 | -1.0676989911247659 | 2.4262140869360715
25.6617 | 19.29 | 16.37843569977211 | 15.93973976740972
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
