HeejunMoon53/MultimodalSensor/nn_decoupling/test0816_RealtimeDecoupling/moe_monitor_20260816_183046.csv

t_s | dL_pct | dR_pct | dV_pct | IDRIVE | STATUS | strain_pct | value | mode | gate_proba | latency_us | YA_mm | YB_mm | Z_mm | Fz_act_N | strain_act_pct | value_act
450.2675 | -0.028 | -0.0654 | 9.6857 | 31 | 72 | 0.036 | 25.457 | 0 | 0.0 | 261.38 | 0.0 | 0.0 | 25.0 | 0.1 | 0.0 | 25.0
450.2675 | -0.034 | -0.0654 | 12.3181 | 31 | 72 | 0.024 | 25.433 | 0 | 0.0 | 261.32 | 0.0 | 0.0 | 25.0 | 0.1 | 0.0 | 25.0
450.2685 | -0.028 | -0.0713 | 12.4977 | 31 | 72 | 0.041 | 25.474 | 0 | 0.0 | 261.52 | 0.0 | 0.0 | 25.0 | 0.1 | 0.0 | 25.0
450.2696 | -0.012 | -0.0713 | 12.6054 | 31 | 72 | 0.076 | 25.536 | 0 | 0.0 | 261.32 | 0.0 | 0.0 | 25.0 | 0.1 | 0.0 | 25.0
450.2707 | -0.026 | -0.0535 | 12.8568 | 31 | 72 | 0.032 | 25.432 | 0 | 0.0 | 261.38 | 0.0 | 0.0 | 25.0 | 0.1 | 0.0 | 25.0
450.273 | -0.02 | -0.0416 | 12.2858 | 31 | 72 | 0.037 | 25.422 | 0 | 0.0 | 261.32 | 0.0 | 0.0 | 25.0 | -0.18 | 0.0 | 25.0
450.2741 | -0.018 | -0.0416 | 12.5695 | 31 | 72 | 0.041 | 25.43 | 0 | 0.0 | 260.85 | 0.0 | 0.0 | 25.0 | -0.18 | 0.0 | 25.0
450.2753 | -0.052 | -0.0416 | 13.8337 | 31 | 72 | -0.027 | 25.286 | 0 | 0.0 | 261.34 | 0.0 | 0.0 | 25.0 | -0.18 | 0.0 | 25.0
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
