HeejunMoon53/MultimodalSensor/nn_decoupling/test0816_RealtimeDecoupling/moe_monitor_20260818_162945.csv

t_s | dL_pct | dR_pct | dV_pct | IDRIVE | STATUS | strain_pct | value | mode | gate_proba | latency_us | YA_mm | YB_mm | Z_mm | Fz_act_N | strain_act_pct | value_act
79.5553 | -2.0593 | -0.0597 | -5.9081 | 31 | 72 | -0.416 | 1.529 | 0 | 0.02 | 259.03 | 0.0 | 0.0 | 10.0 | 0.08 | 0.0 | 10.0
79.5568 | -2.0475 | -0.1493 | -5.4339 | 31 | 72 | -0.324 | 1.623 | 0 | 0.02 | 260.37 | 0.0 | 0.0 | 10.0 | 0.08 | 0.0 | 10.0
79.559 | -2.093 | -0.0717 | -6.5627 | 31 | 72 | -0.408 | 1.538 | 0 | 0.02 | 259.53 | 0.0 | 0.0 | 10.0 | 0.08 | 0.0 | 10.0
79.5623 | -2.0554 | 0.0716 | -10.7375 | 31 | 72 | -0.591 | 1.412 | 0 | 0.02 | 259.32 | 0.0 | 0.0 | 10.0 | 0.46 | 0.0 | 10.0
79.601 | -2.0574 | -0.1612 | -5.8313 | 31 | 72 | -0.313 | 1.627 | 0 | 0.02 | 259.39 | 0.0 | 0.0 | 10.0 | 0.46 | 0.0 | 10.0
79.6135 | -2.089 | 0.0835 | -3.4534 | 31 | 72 | -0.617 | 1.406 | 0 | 0.02 | 259.44 | 0.0 | 0.0 | 10.0 | 0.14 | 0.0 | 10.0
79.6499 | -2.087 | -0.1015 | -5.0799 | 31 | 72 | -0.369 | 1.553 | 0 | 0.02 | 259.36 | 0.0 | 0.0 | 10.0 | 0.02 | 0.0 | 10.0
79.6885 | -2.0752 | -0.1075 | -3.9076 | 31 | 72 | -0.36 | 1.556 | 0 | 0.02 | 259.4 | 0.0 | 0.0 | 10.0 | 0.02 | 0.0 | 10.0
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
