HeejunMoon53/MultimodalSensor/nn_decoupling/test0816_RealtimeDecoupling/moe_monitor_20260818_162945_syncfixed.csv

t_s | dL_pct | dR_pct | dV_pct | IDRIVE | STATUS | strain_pct | value | mode | gate_proba | latency_us | YA_mm | YB_mm | Z_mm | Fz_act_N | strain_act_pct | value_act
82.1556 | -3.3849 | -0.0597 | 1.73 | 31 | 72 | -0.571 | 1.217 | 0 | 0.023 | 259.98 | 0.0 | 0.0 | 10.0 | 0.46 | 0.0 | 10.0
82.1854 | -3.3711 | -0.0836 | 4.1012 | 31 | 72 | -0.566 | 1.26 | 0 | 0.023 | 259.24 | 0.0 | 0.0 | 10.0 | 0.10076923076923336 | 0.0 | 10.0
82.2037 | -3.3711 | 0.0358 | 2.792 | 31 | 72 | -0.619 | 1.141 | 0 | 0.023 | 259.92 | 0.0 | 0.0 | 10.0 | 0.040439560439575514 | 0.0 | 10.0
82.2157 | -3.3987 | -0.1373 | 3.4299 | 31 | 72 | -0.541 | 1.299 | 0 | 0.023 | 259.85 | 0.0 | 0.0 | 10.0 | 0.02 | 0.0 | 10.0
82.2472 | -3.3711 | -0.2627 | 0.865 | 31 | 72 | -0.518 | 1.611 | 0 | 0.023 | 259.54 | 0.0 | 0.0 | 10.0 | 0.02 | 0.0 | 10.0
82.2492 | -3.3731 | -0.012 | 0.5711 | 31 | 72 | -0.597 | 1.184 | 0 | 0.023 | 259.82 | 0.0 | 0.0 | 10.0 | 0.02 | 0.0 | 10.0
82.2932 | -3.3633 | -0.006 | -1.7301 | 31 | 72 | -0.603 | 1.188 | 0 | 0.023 | 259.92 | 0.0 | 0.0 | 10.0 | -0.04288209606982041 | 0.0 | 10.0
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
