HeejunMoon53/MultimodalSensor/nn_decoupling/0332_DecouplingTest_TXTFiles/Figure_2.png

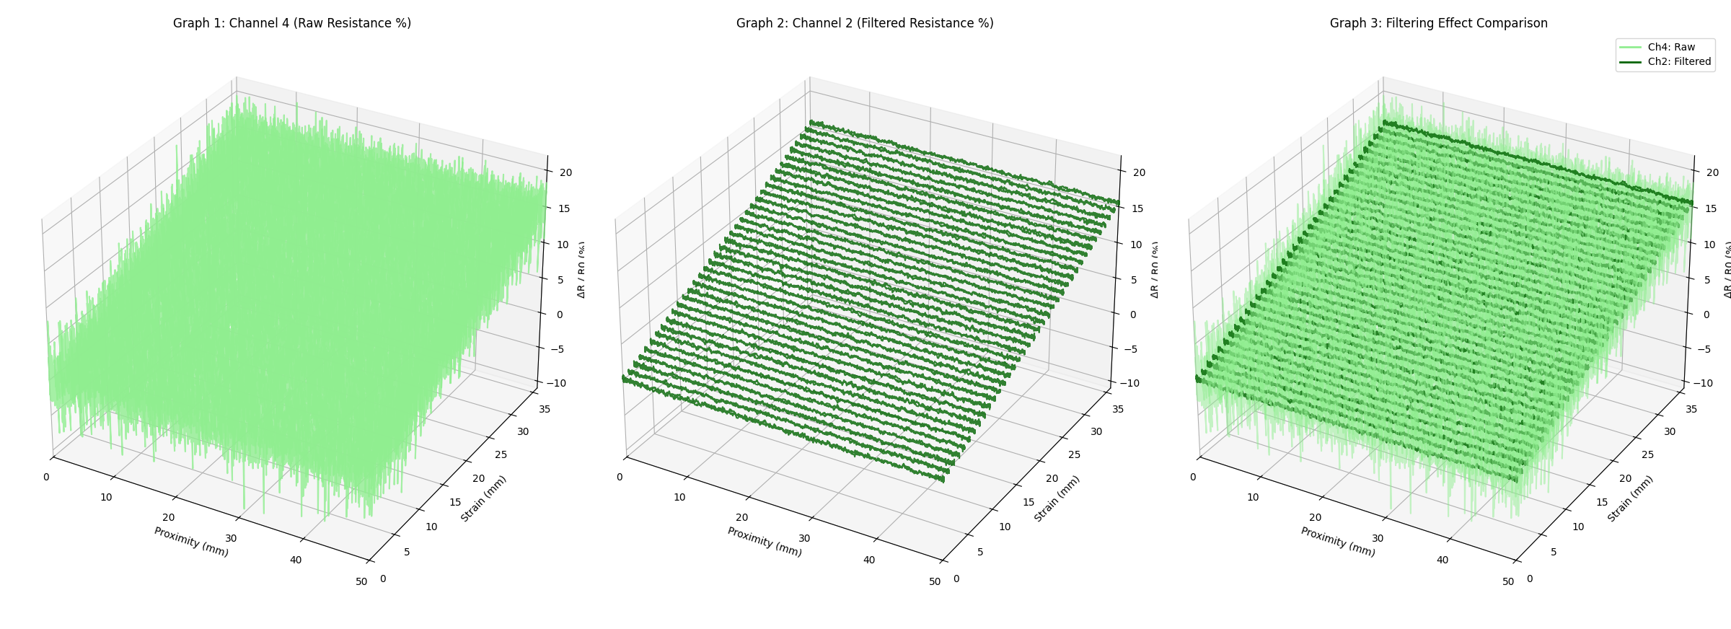
nn_decoupling/0332_DecouplingTest_TXTFiles/Figure_2.png
