HeejunMoon53/MultimodalSensor/nn_decoupling/pressure_0805test/output/3d_force_strain_L.png

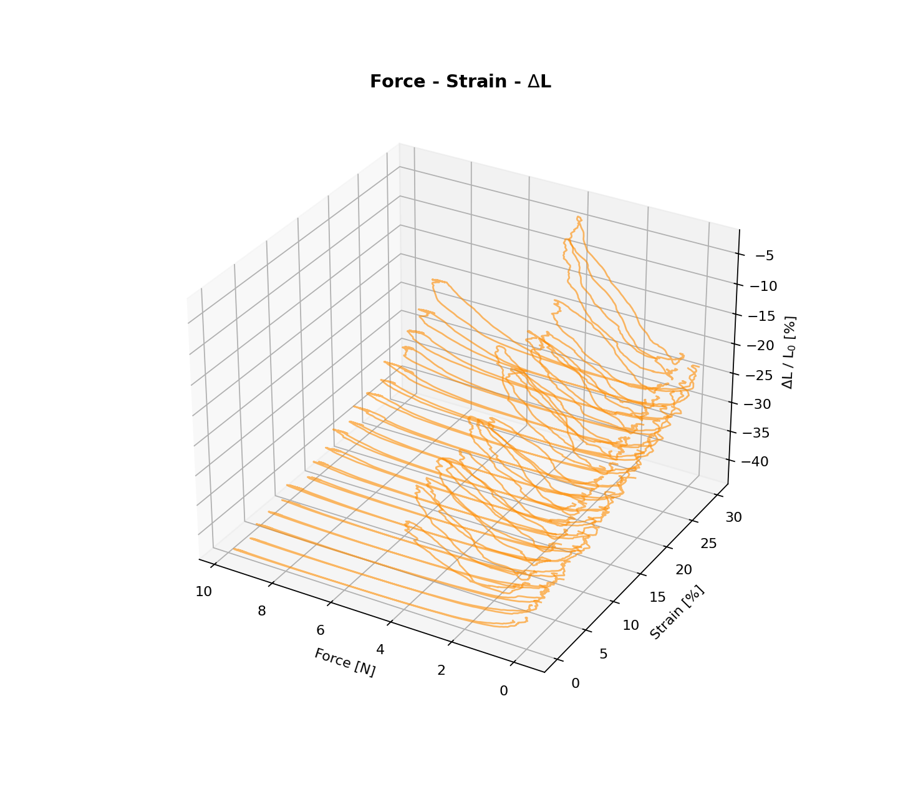
nn_decoupling/pressure_0805test/output/3d_force_strain_L.png
