HeejunMoon53/MultimodalSensor/nn_decoupling/pressure_0805test/output/3d_position_strain_L.png

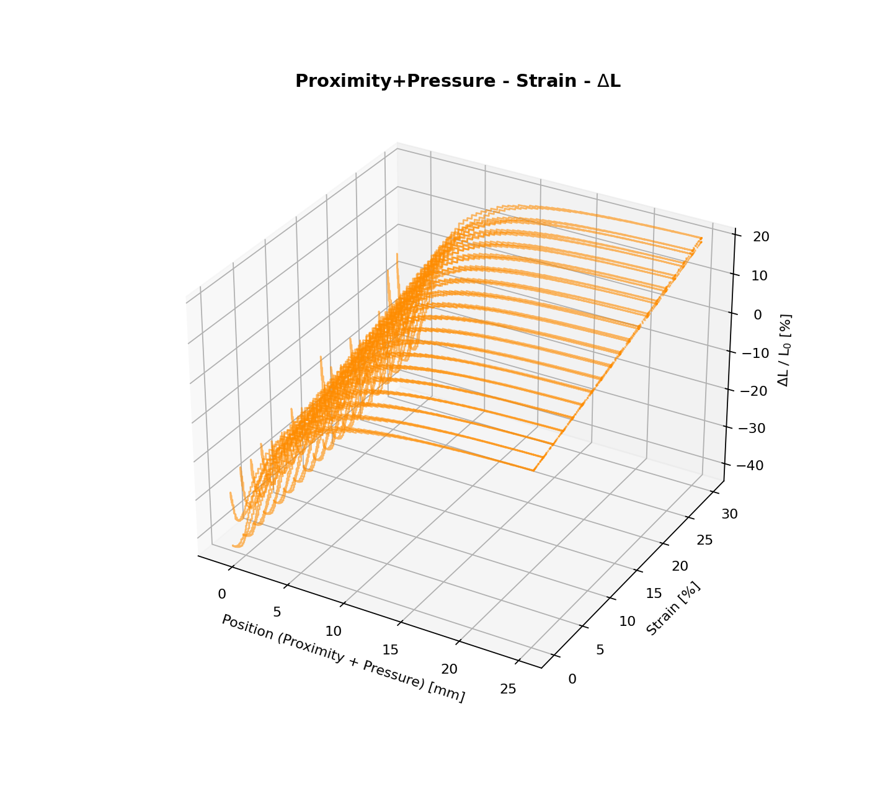
nn_decoupling/pressure_0805test/output/3d_position_strain_L.png
