HeejunMoon53/MultimodalSensor/nn_decoupling/pressure_0805test/output/3d_proximity_strain_L.png

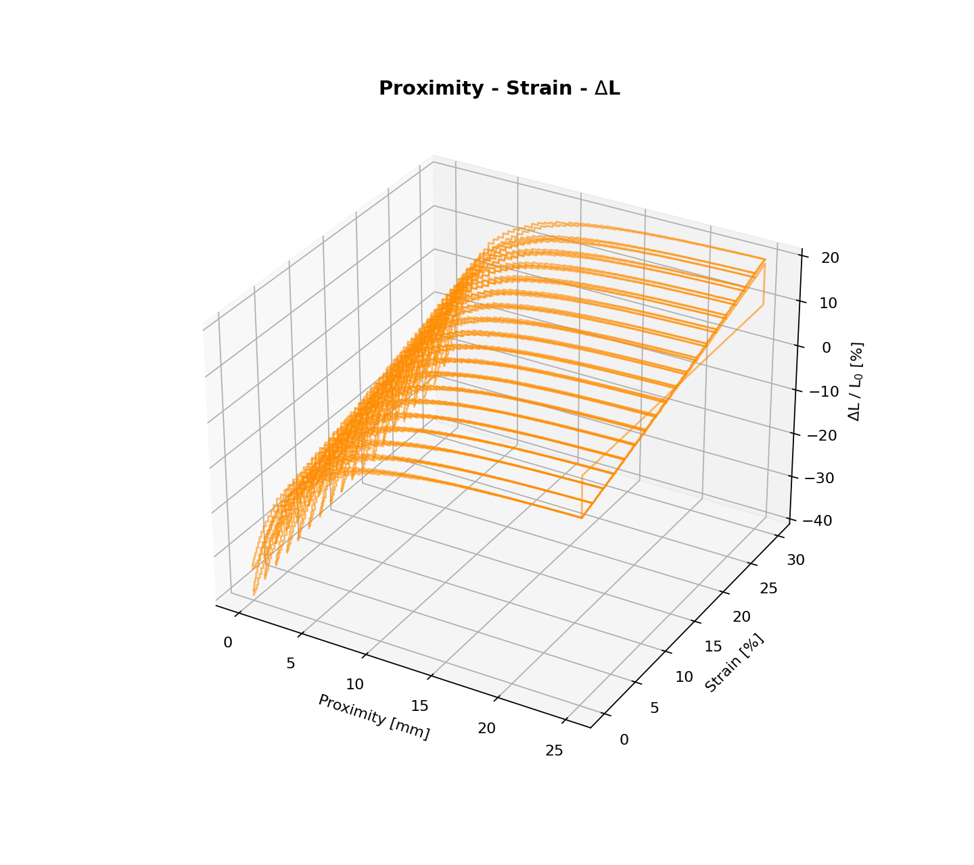
nn_decoupling/pressure_0805test/output/3d_proximity_strain_L.png
