HeejunMoon53/MultimodalSensor/nn_decoupling/pressure_0805test/output/mms_20260805_172956/3d_force_strain_L_oversampled.png

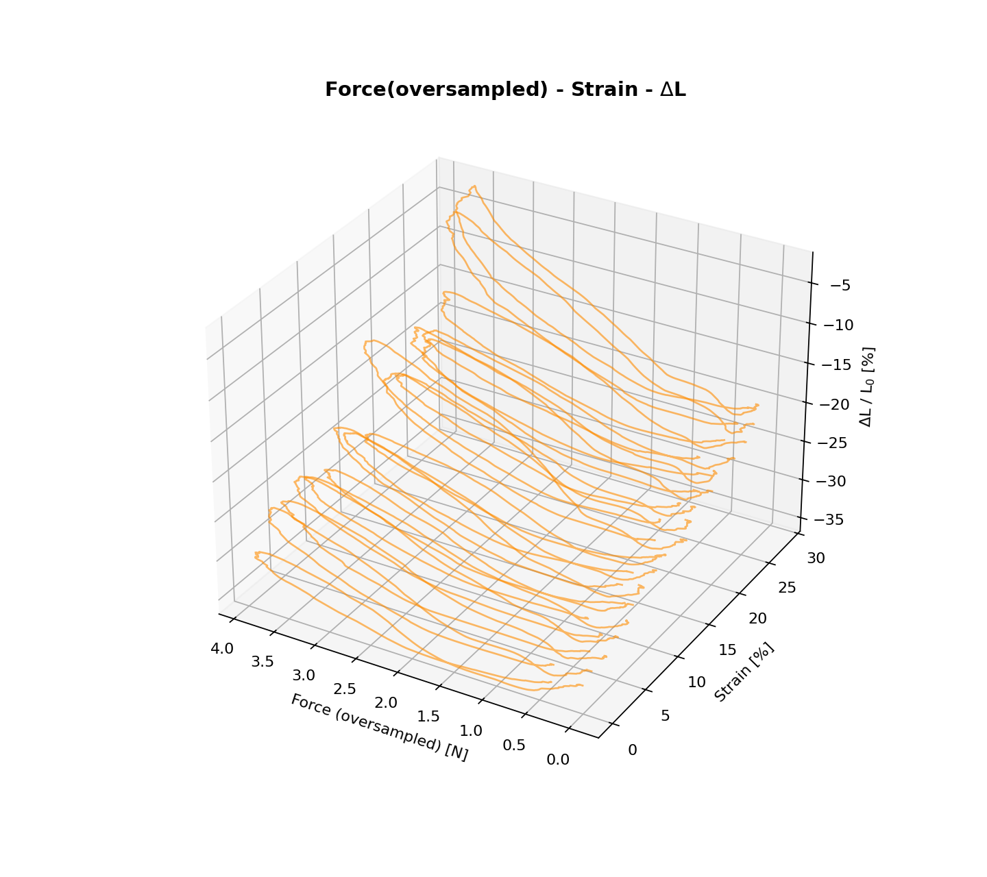
nn_decoupling/pressure_0805test/output/mms_20260805_172956/3d_force_strain_L_oversampled.png
