HeejunMoon53/MultimodalSensor/nn_decoupling/pressure_0805test/output/mms_20260805_172956/timeseries_test0805.png

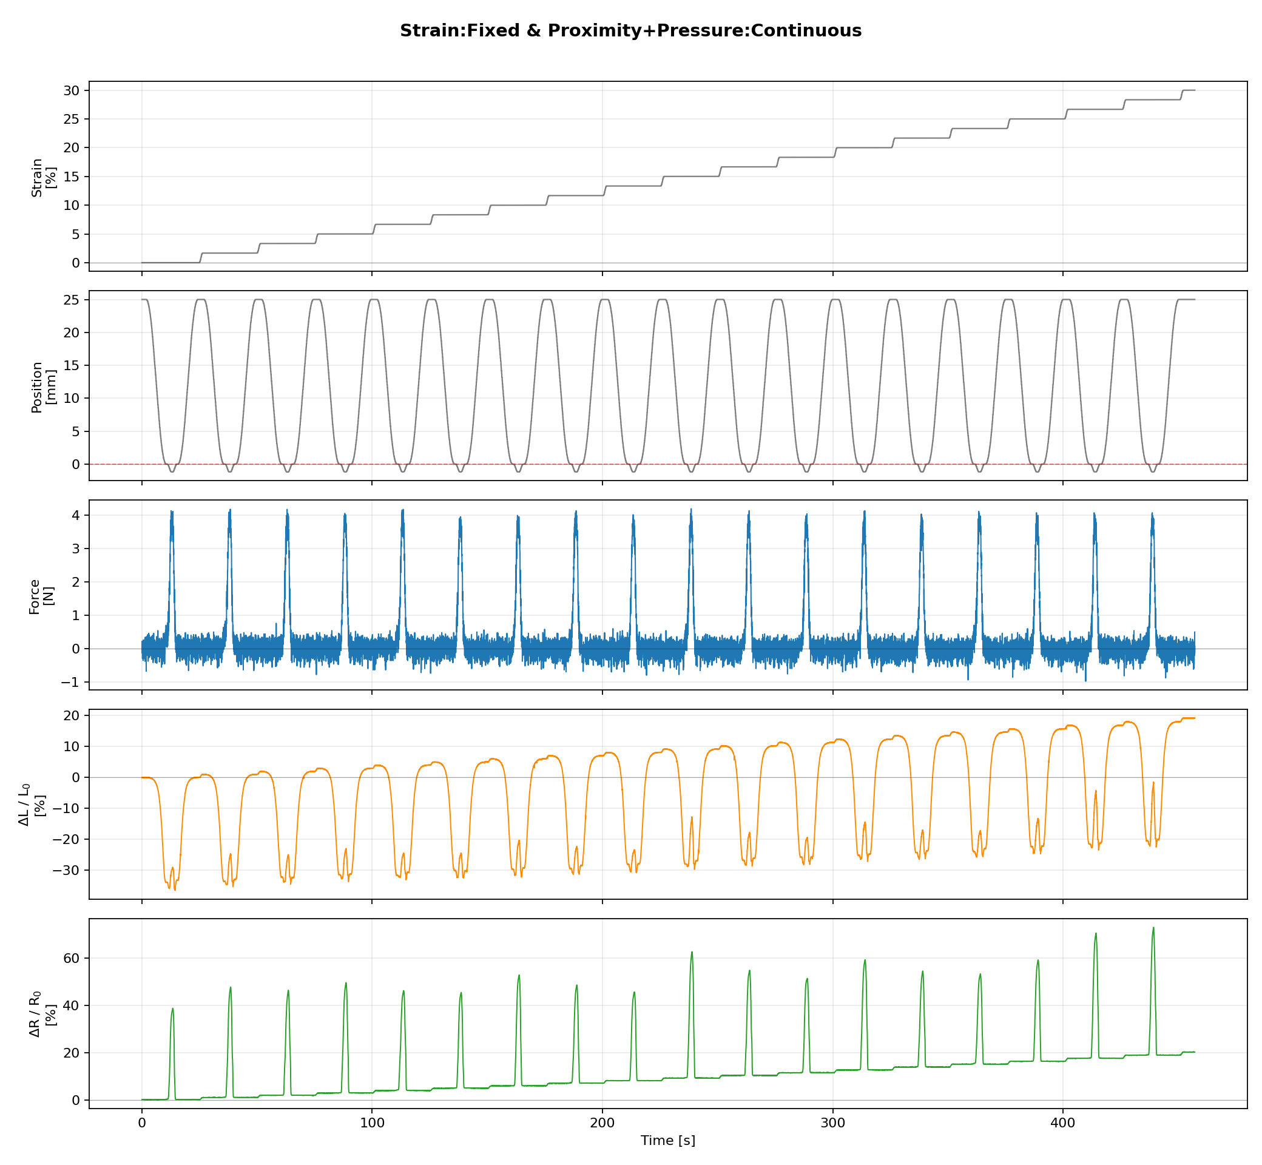
nn_decoupling/pressure_0805test/output/mms_20260805_172956/timeseries_test0805.png
