HeejunMoon53/MultimodalSensor/nn_decoupling/pressure_0805test/output/mms_20260806_200653/3d_position_strain_R.png

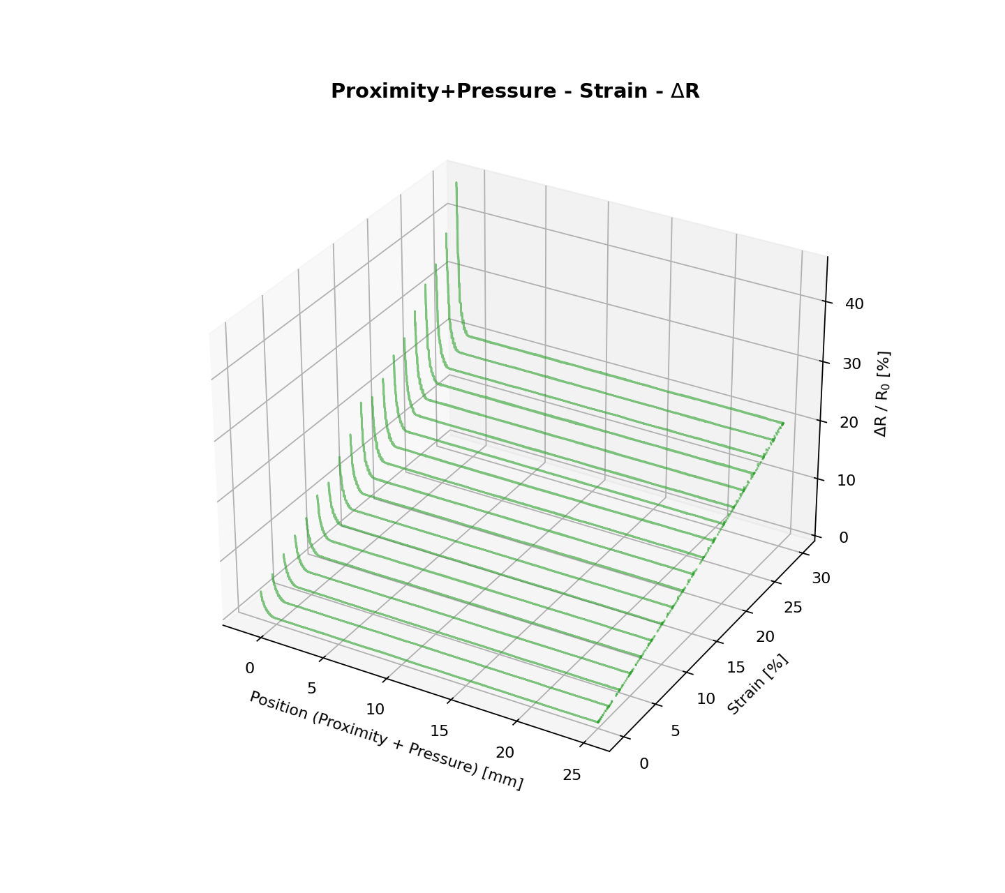
nn_decoupling/pressure_0805test/output/mms_20260806_200653/3d_position_strain_R.png
