HeejunMoon53/MultimodalSensor/nn_decoupling/pressure_0805test/output/strain_sensitivity_growth.png

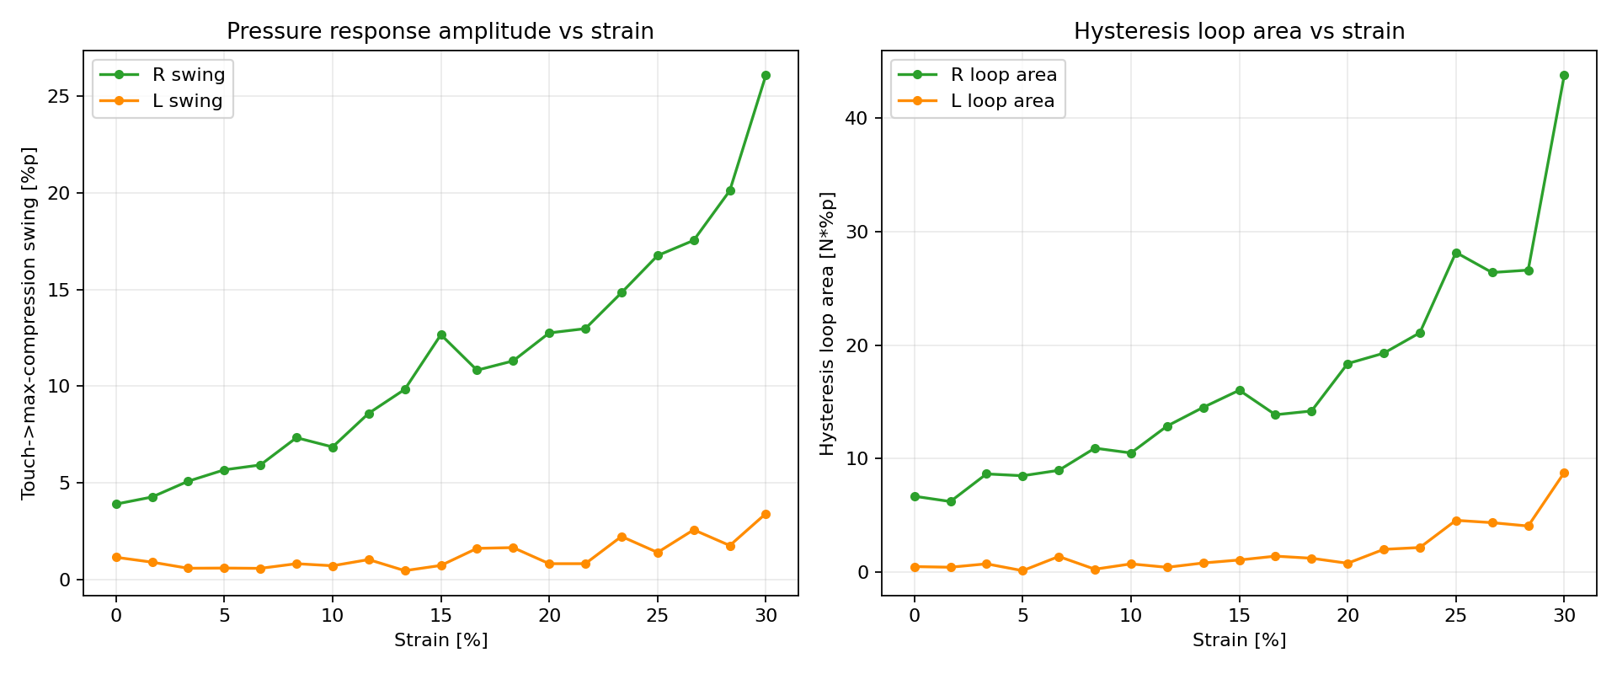
nn_decoupling/pressure_0805test/output/strain_sensitivity_growth.png
