HeejunMoon53/MultimodalSensor/nn_decoupling/pressure_0805test/output/test_joint_decouple.png

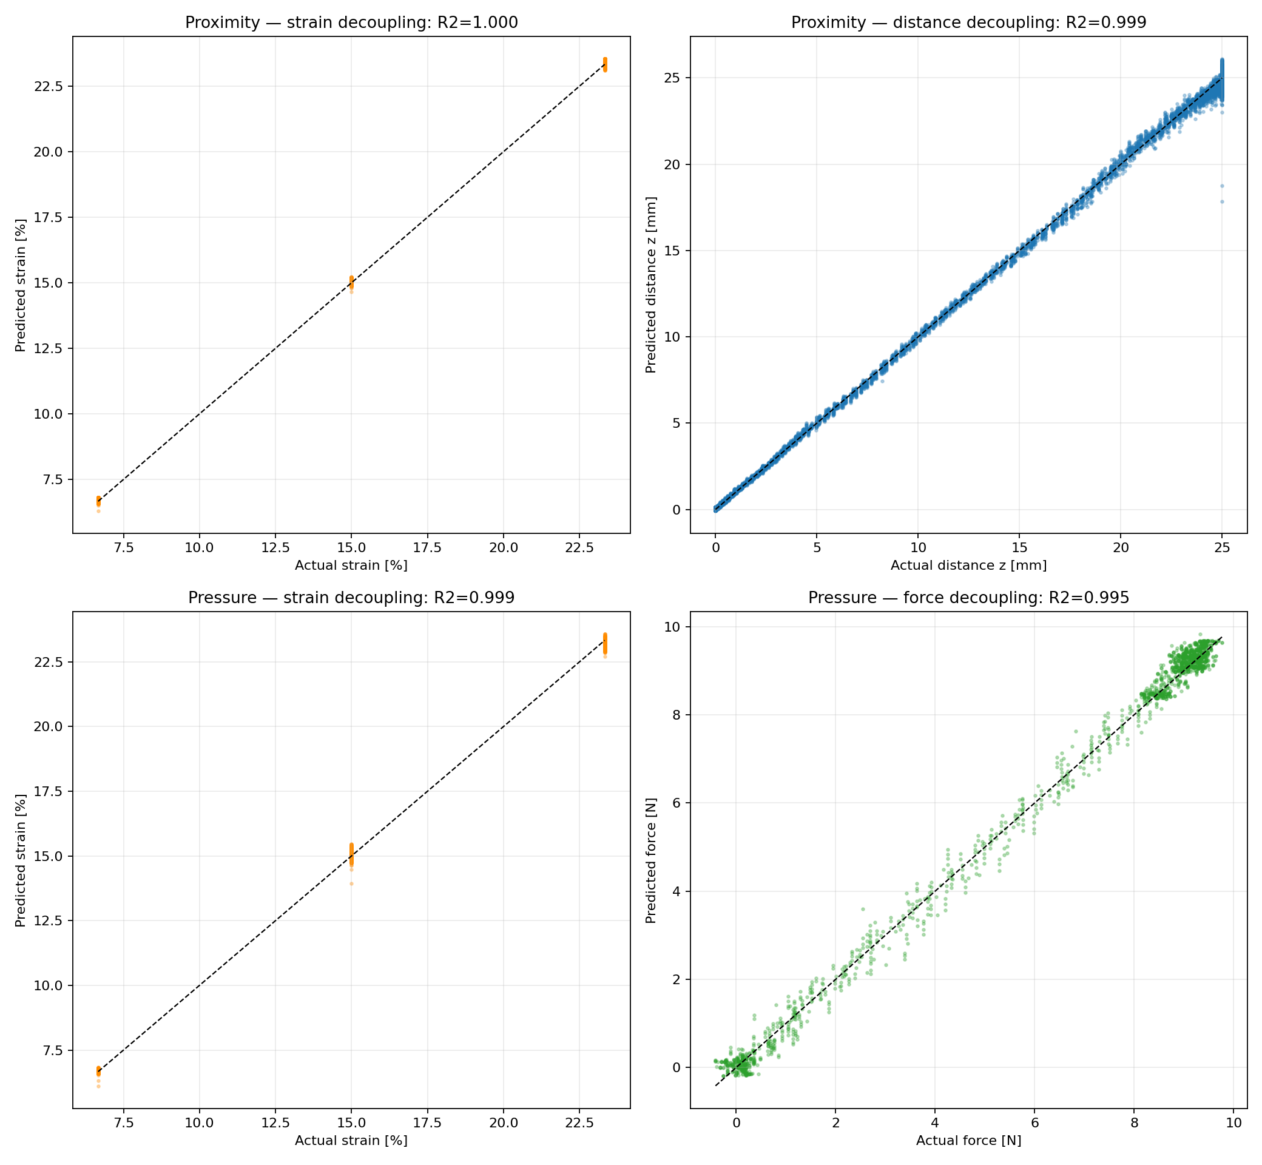
nn_decoupling/pressure_0805test/output/test_joint_decouple.png
