HeejunMoon53/MultimodalSensor/nn_decoupling/pressure_0805test/output/test_time_constant_mlp_comparison.png

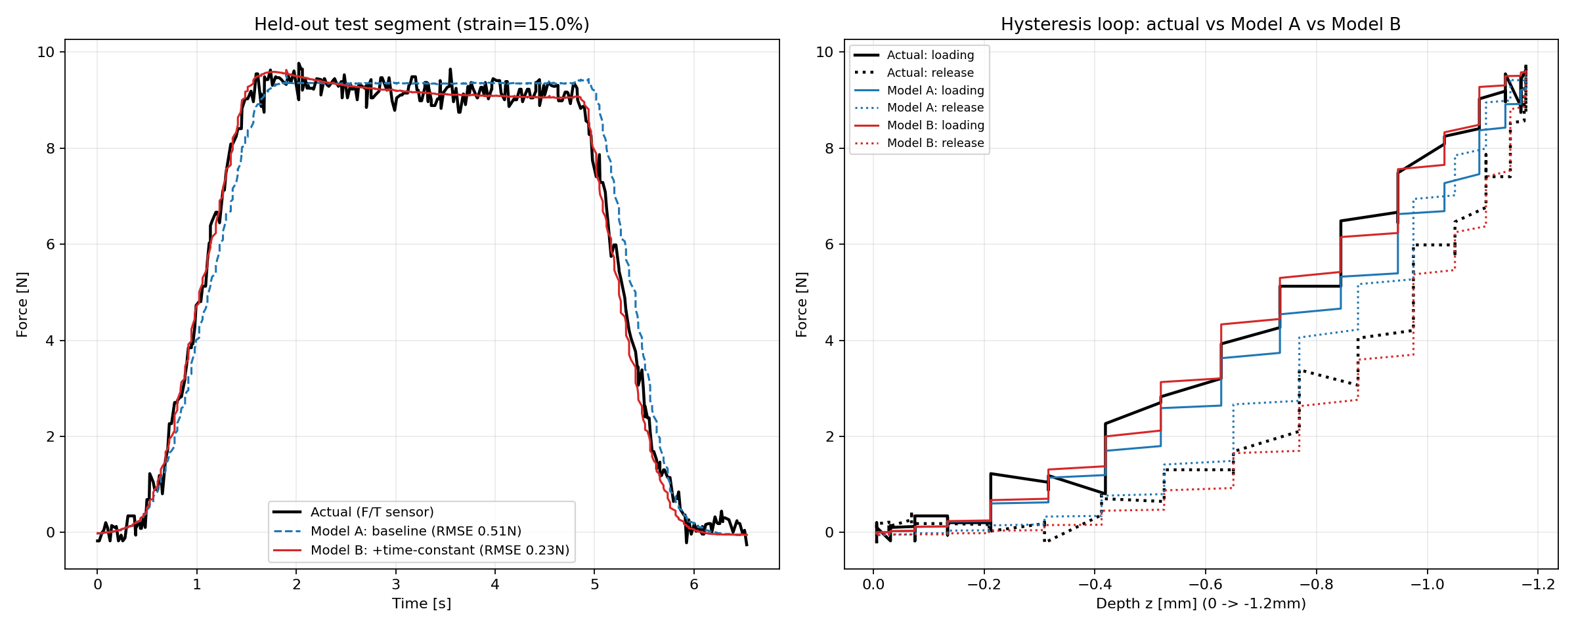
nn_decoupling/pressure_0805test/output/test_time_constant_mlp_comparison.png
