HeejunMoon53/MultimodalSensor/nn_decoupling/pressure_0805test/output/timeseries_test0805.png

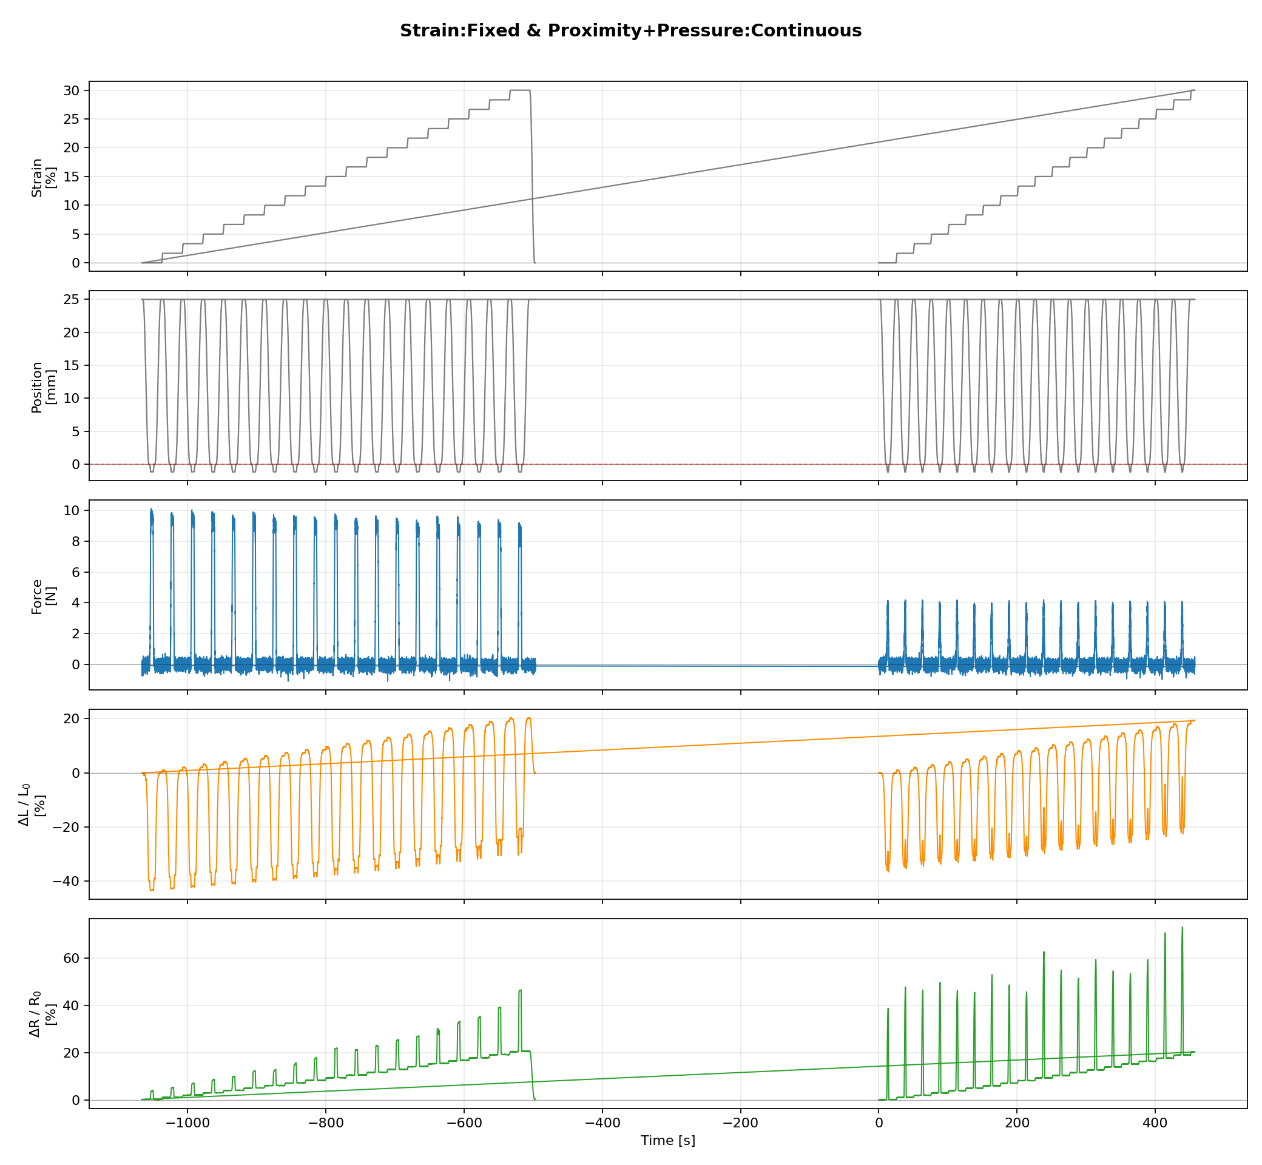
nn_decoupling/pressure_0805test/output/timeseries_test0805.png
