HeejunMoon53/MultimodalSensor/nn_decoupling/pressure_0805test/그림2.png

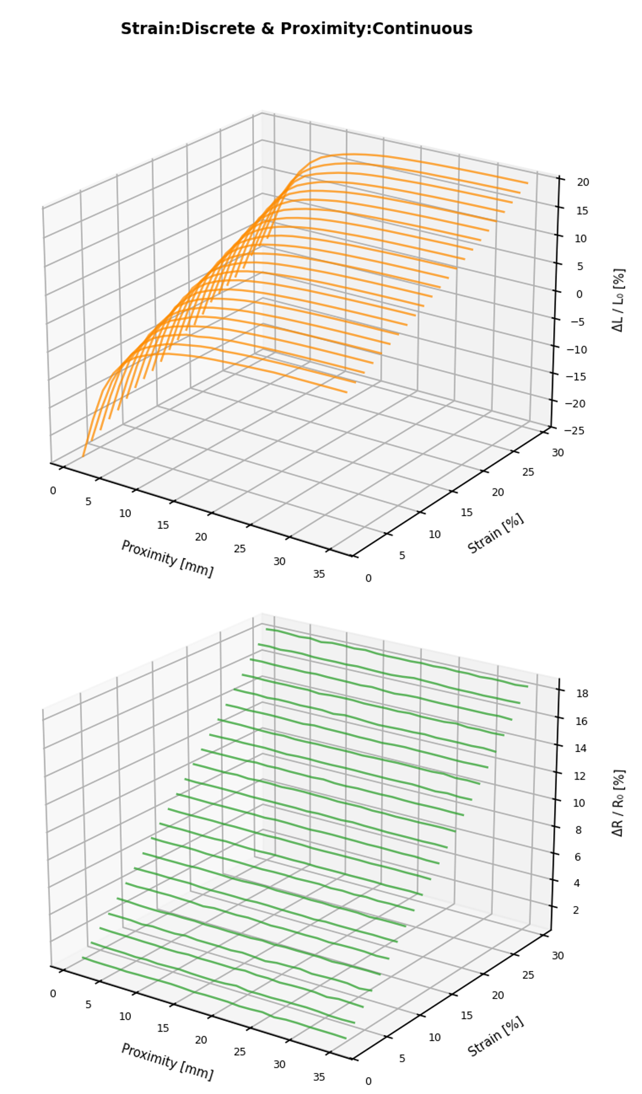
nn_decoupling/pressure_0805test/그림2.png
