HeejunMoon53/MultimodalSensor/nn_decoupling/test0807_MoEDecoupling/output/candidate5b_true_rnn.png

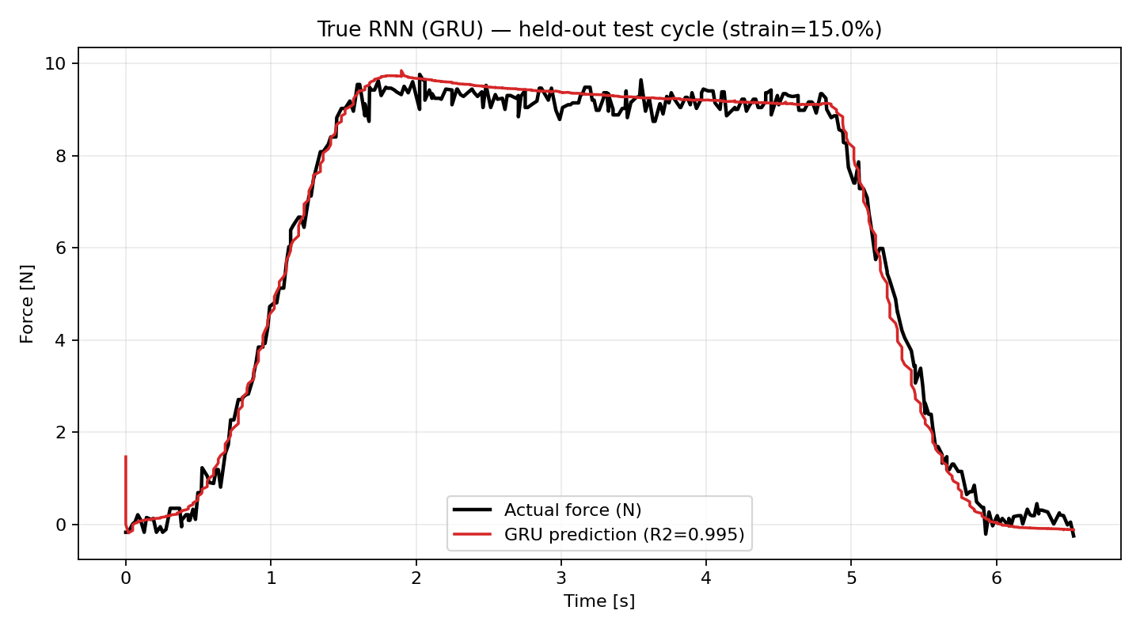
nn_decoupling/test0807_MoEDecoupling/output/candidate5b_true_rnn.png
