HeejunMoon53/MultimodalSensor/nn_decoupling/test0807_MoEDecoupling/output/candidates_comparison.png

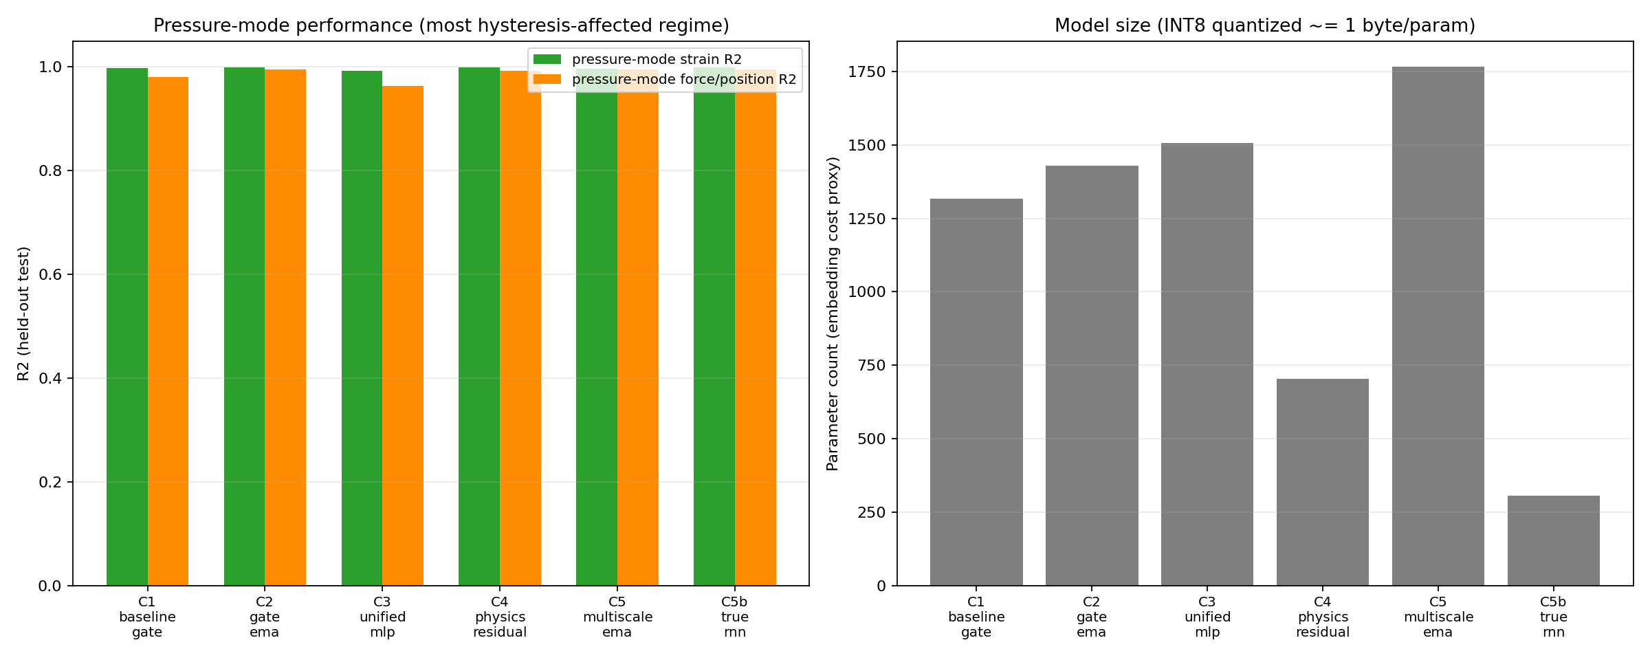
nn_decoupling/test0807_MoEDecoupling/output/candidates_comparison.png
