HeejunMoon53/MultimodalSensor/nn_decoupling/test0807_MoEDecoupling/output/single_cycle_fz_scatter.png

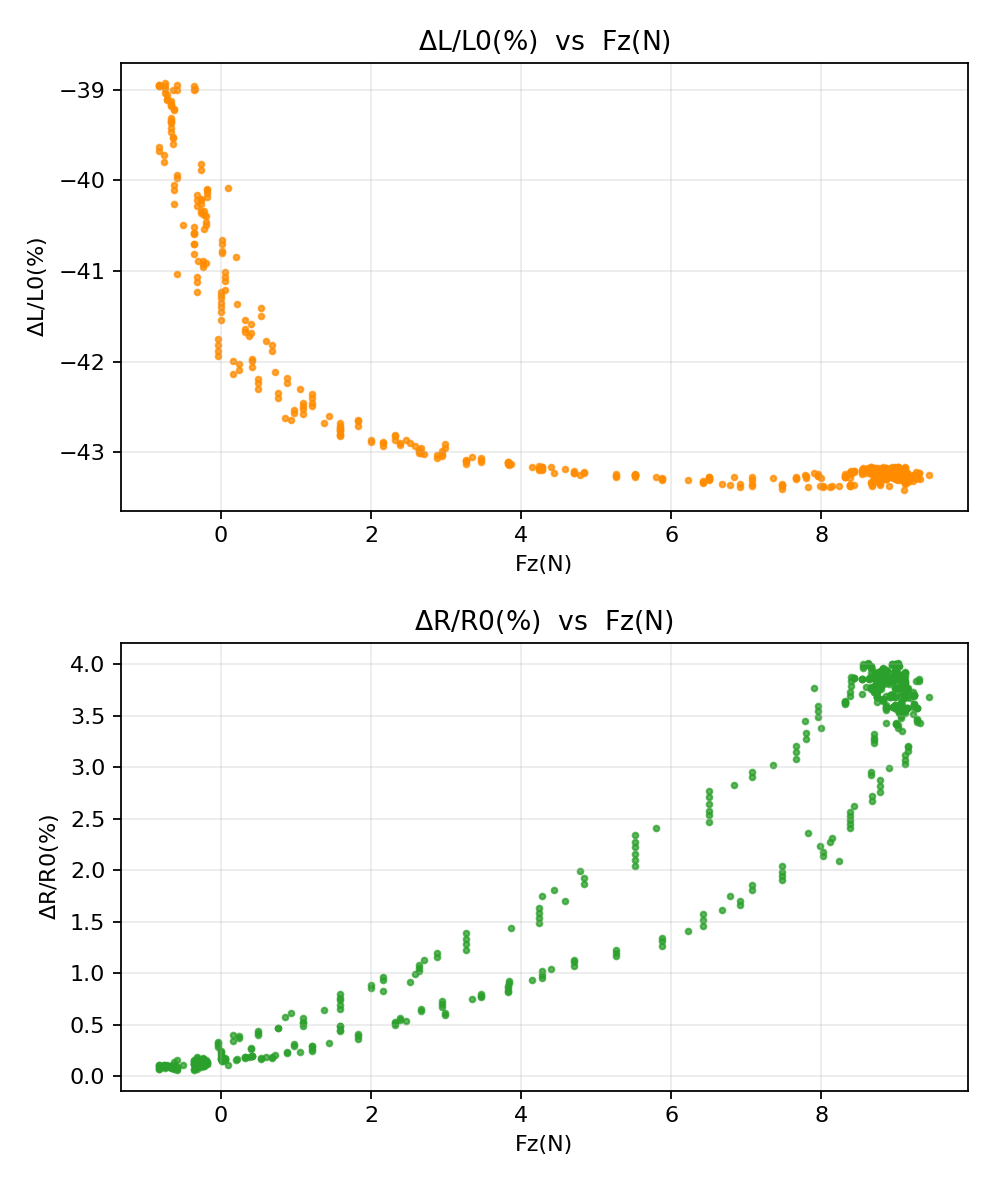
nn_decoupling/test0807_MoEDecoupling/output/single_cycle_fz_scatter.png
