HeejunMoon53/MultimodalSensor/nn_decoupling/test0807_MoEDecoupling/output/single_cycle_fz_scatter_strain0.png

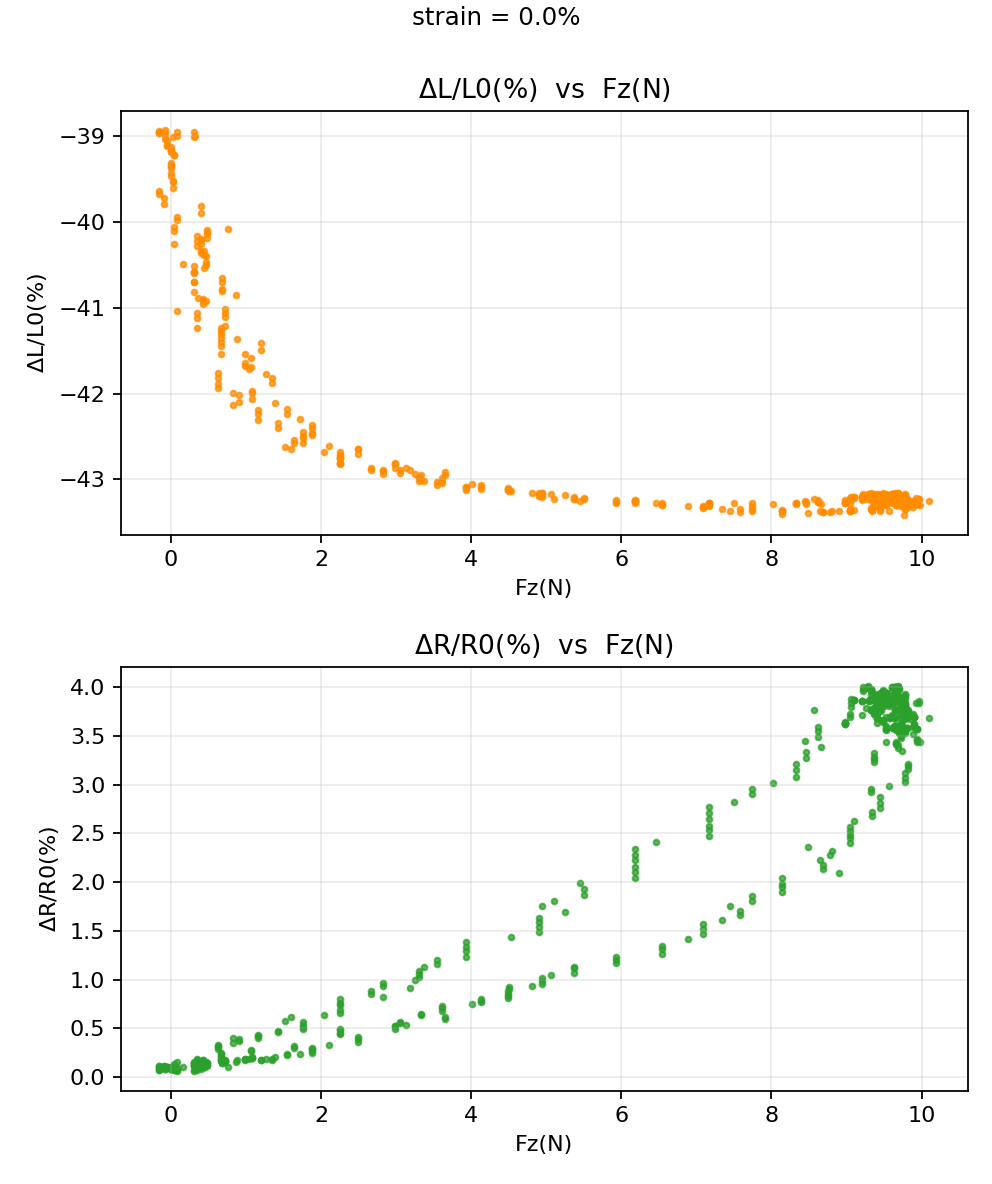
nn_decoupling/test0807_MoEDecoupling/output/single_cycle_fz_scatter_strain0.png
