HeejunMoon53/MultimodalSensor/nn_decoupling/test0807_MoEDecoupling/output/three_way_compare.png

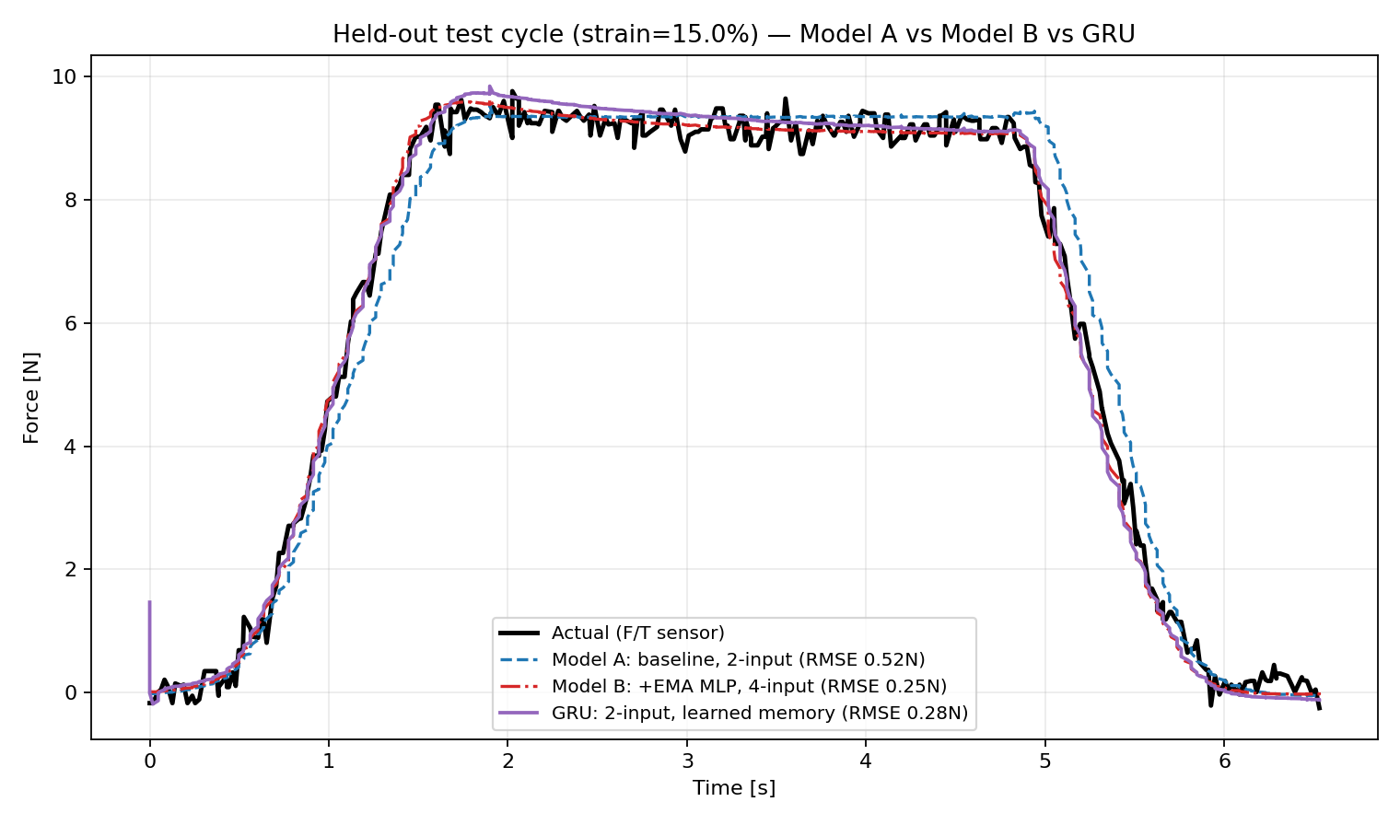
nn_decoupling/test0807_MoEDecoupling/output/three_way_compare.png
