HeejunMoon53/MultimodalSensor/nn_decoupling/test0909_realtime/new/output/surfaces_proximity_strain.png

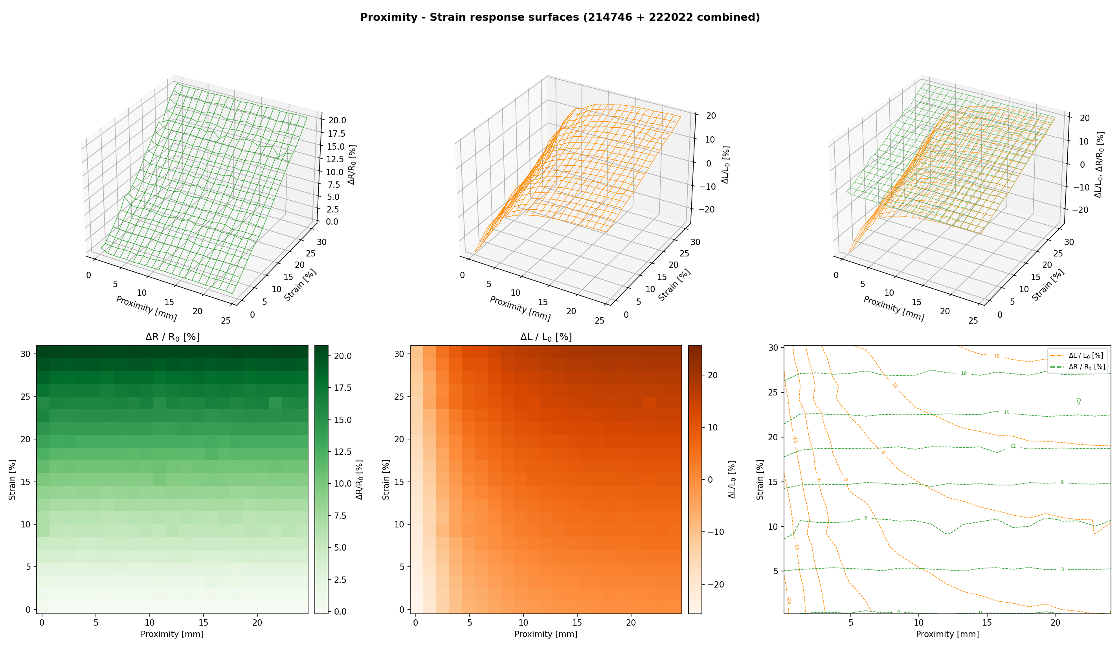
nn_decoupling/test0909_realtime/new/output/surfaces_proximity_strain.png
