HeejunMoon53/MultimodalSensor/nn_decoupling/test0909_realtime/new/output/timeseries_pressure_full.png

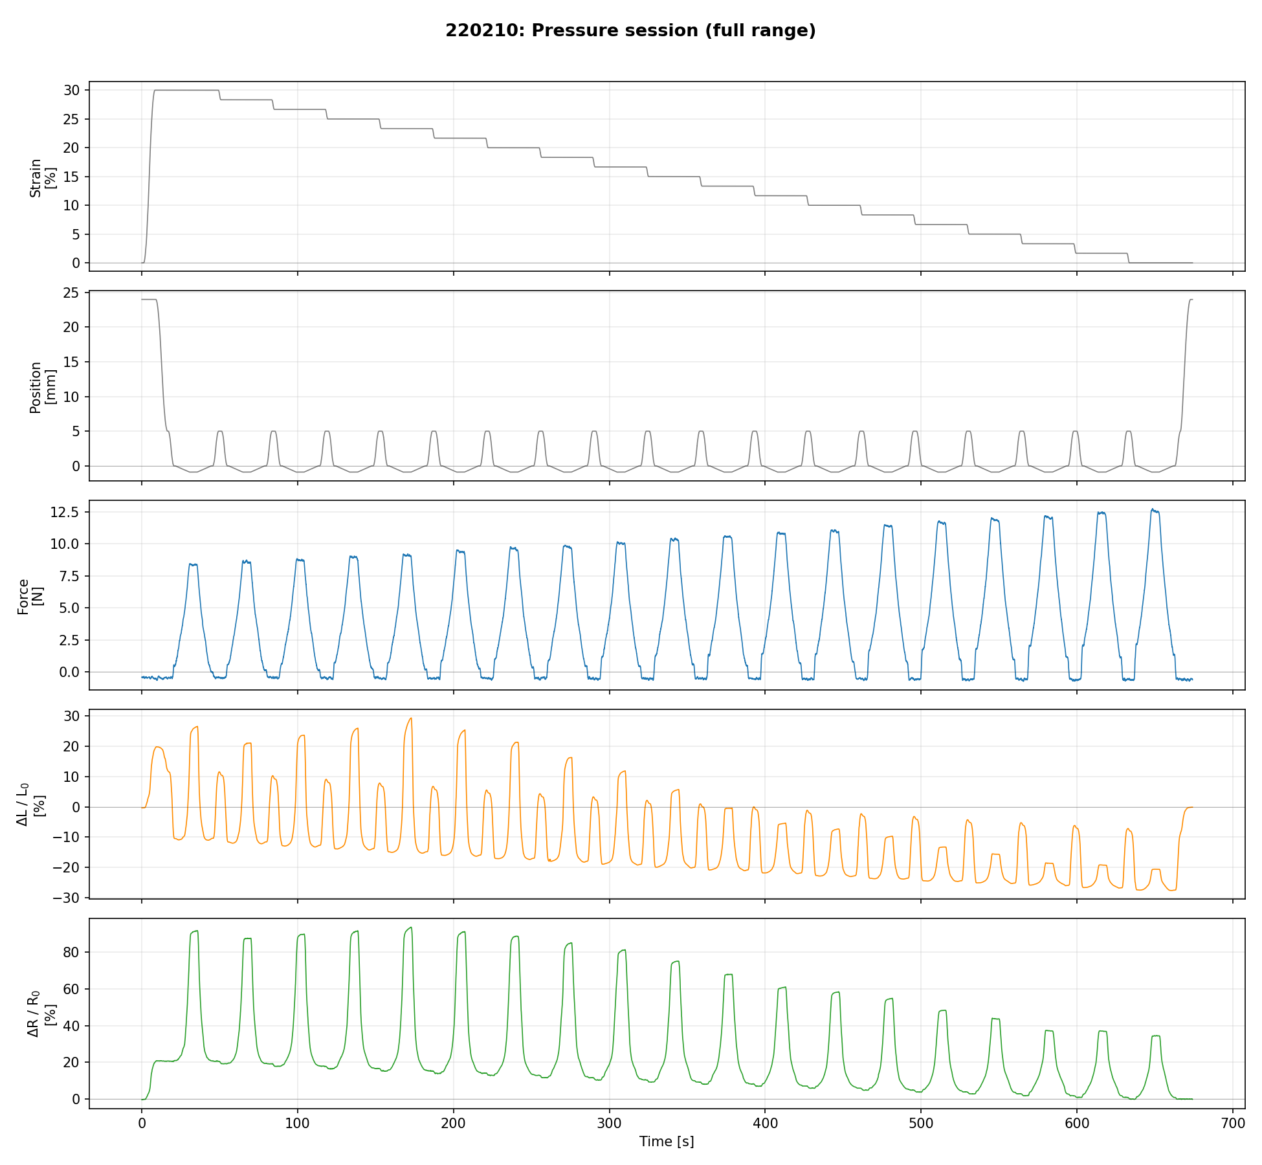
nn_decoupling/test0909_realtime/new/output/timeseries_pressure_full.png
