HeejunMoon53/MultimodalSensor/nn_decoupling/test0909_realtime/new/output/timeseries_proximity_pair.png

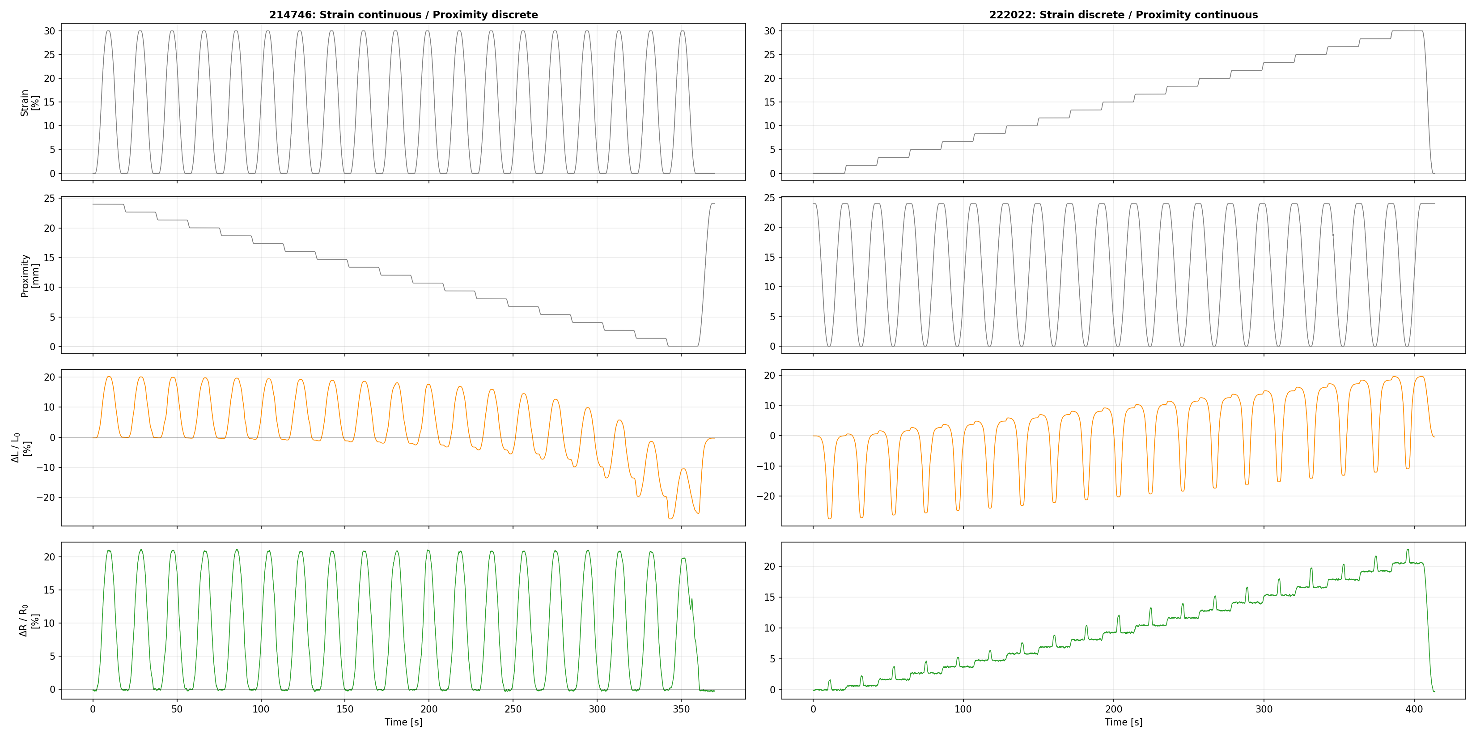
nn_decoupling/test0909_realtime/new/output/timeseries_proximity_pair.png
