HeejunMoon53/MultimodalSensor/nn_decoupling/test0909_realtime/new/그림1.png

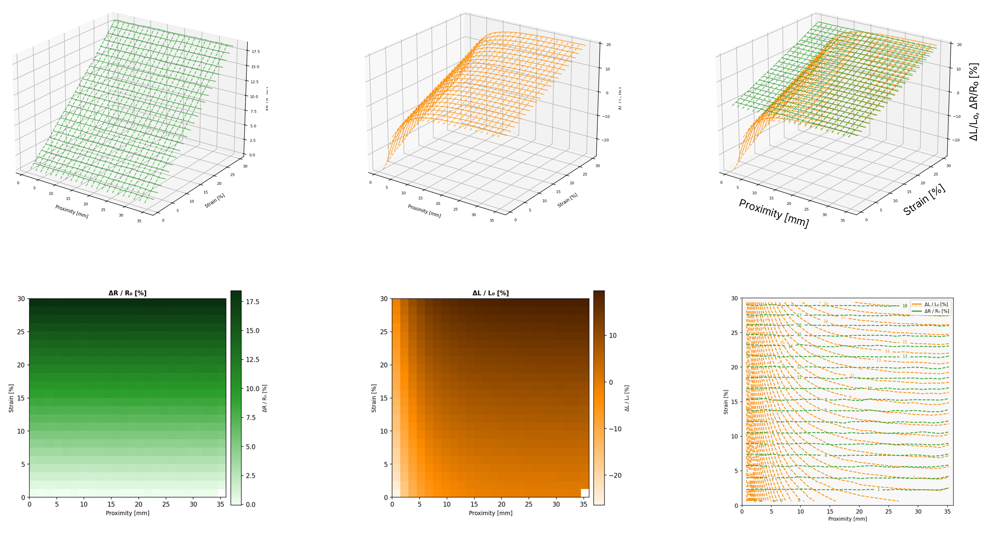
nn_decoupling/test0909_realtime/new/그림1.png
