HeejunMoon53/MultimodalSensor/nn_decoupling/test0909_realtime/output/moe_monitor_20260909_142710/parity_proximity.png

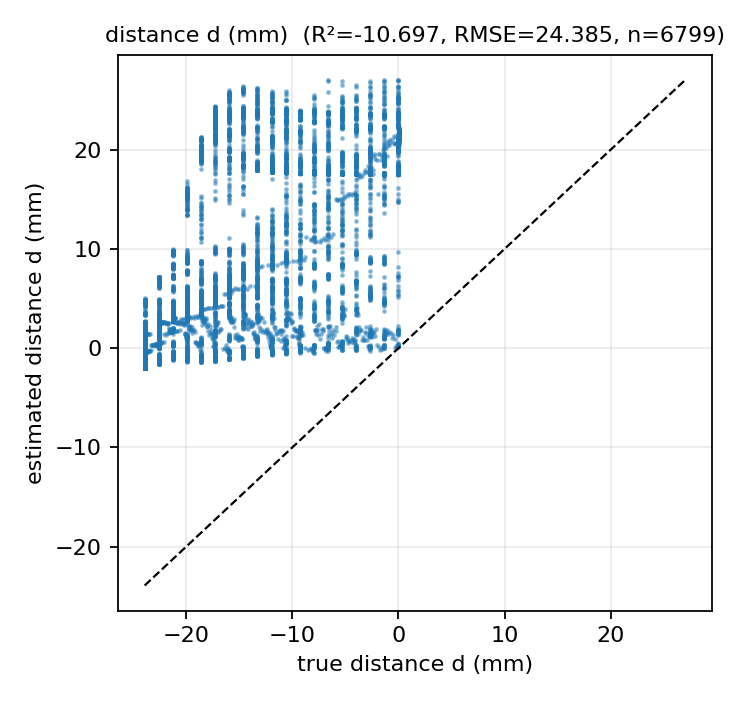
nn_decoupling/test0909_realtime/output/moe_monitor_20260909_142710/parity_proximity.png
