HeejunMoon53/MultimodalSensor/nn_decoupling/test0909_realtime/output/moe_monitor_20260909_143454/parity_strain.png

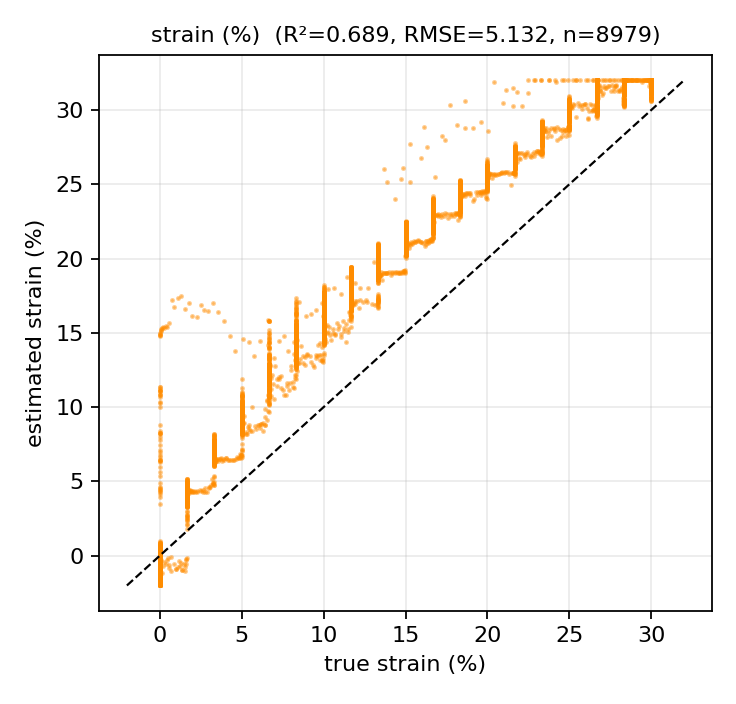
nn_decoupling/test0909_realtime/output/moe_monitor_20260909_143454/parity_strain.png
