HeejunMoon53/MultimodalSensor/nn_decoupling/test0909_realtime/output/moe_monitor_20260909_193809/3d_force_strain_L.png

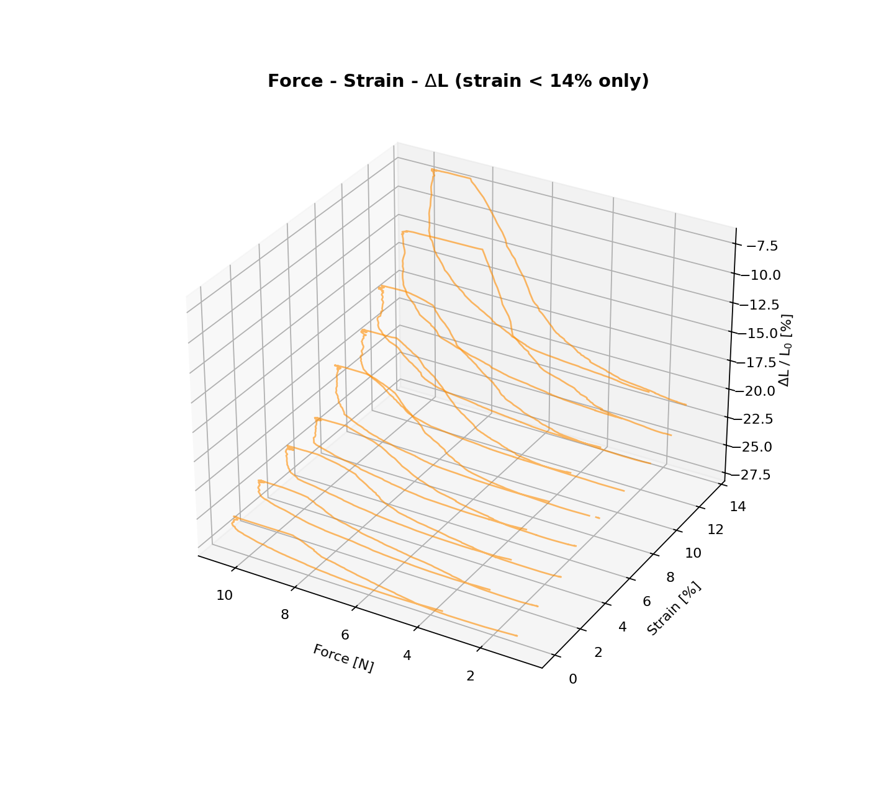
nn_decoupling/test0909_realtime/output/moe_monitor_20260909_193809/3d_force_strain_L.png
