HeejunMoon53/MultimodalSensor/nn_decoupling/test0909_realtime/output/moe_monitor_20260909_193809/parity_force_strain_lt14.png

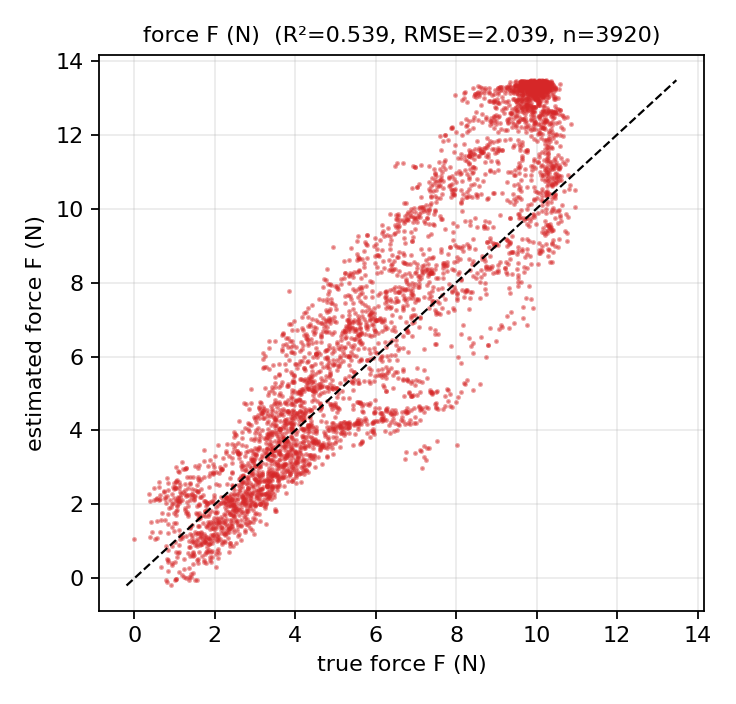
nn_decoupling/test0909_realtime/output/moe_monitor_20260909_193809/parity_force_strain_lt14.png
