HeejunMoon53/MultimodalSensor/nn_decoupling/test0909_realtime/output/moe_monitor_20260909_193809/timeseries.png

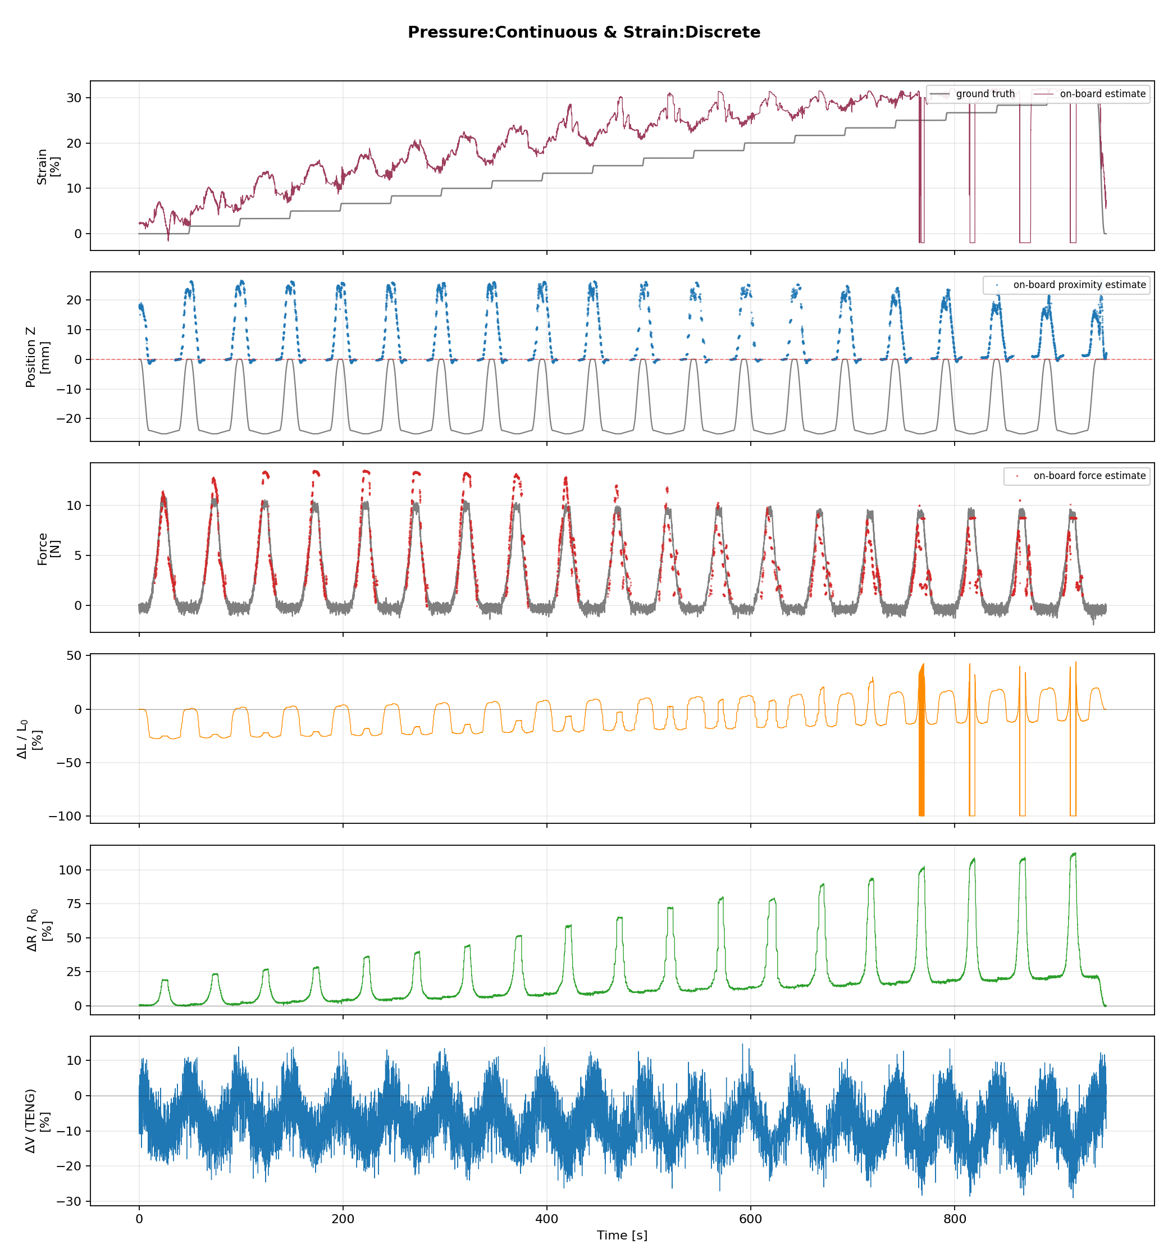
nn_decoupling/test0909_realtime/output/moe_monitor_20260909_193809/timeseries.png
