HeejunMoon53/MultimodalSensor/teng_probe_result.png

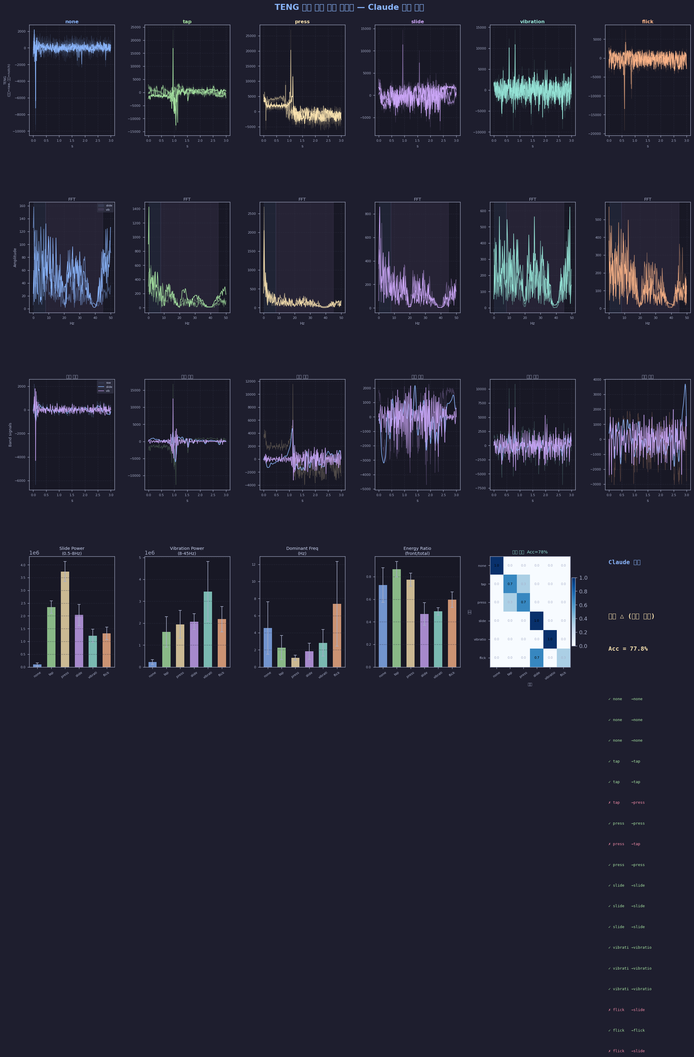
teng_probe_result.png
