HeejunMoon53/MultimodalSensor/TDMFirmware/TDMFirmware.ioc

Mcu.UserName=STM32G473CBTx
PA0.Signal=GPIO_Output
PA1.Signal=GPIO_Output
PA10.Signal=GPIO_Output
PA11.Signal=GPXTI11
PA13.Signal=SYS_JTMS-SWDIO
PA14.Signal=SYS_JTCK-SWCLK
PA15.Signal=USART2_RX
PA2.Signal=GPIO_Output
PA3.Signal=GPIO_Output
PA4.Signal=SPI1_NSS
PA5.Signal=SPI1_SCK
PA6.Signal=SPI1_MISO
PA7.Signal=OPAMP1_VINP
PA8.Signal=I2C2_SDA
PA9.Signal=I2C2_SCL
PB0.Signal=OPAMP2_VINP
PB1.Signal=S_TIM3_CH4
PB10.Signal=GPIO_Output
PB11.Signal=GPIO_Output
PB12.Signal=ADC4_IN3
PB13.Signal=OPAMP3_VINP
PB14.Signal=OPAMP5_VINP
PB15.Signal=GPIO_Output
PB2.Signal=GPIO_Output
PB3.Signal=USART2_TX
PB5.Signal=SPI1_MOSI
PB6.Signal=USART1_TX
PB7.Signal=USART1_RX
PF0-OSC_IN.Signal=RCC_OSC_IN
PF1-OSC_OUT.Signal=RCC_OSC_OUT
