HeejunMoon53/MultimodalSensor/FTSensorCAN/Core/Src/main.c

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
/* Includes ------------------------------------------------------------------*/
#include "main.h"

/* USER CODE BEGIN Includes */
#include "rft_sensor.h"
#include "commid_tool.h"
#include <stdio.h>
/* USER CODE END Includes */

CAN_HandleTypeDef hcan;

UART_HandleTypeDef huart2;

/* USER CODE BEGIN PV */
RFT_Data_t ft;
/* USER CODE END PV */

void SystemClock_Config(void);
static void MX_GPIO_Init(void);
static void MX_CAN_Init(void);
static void MX_USART2_UART_Init(void);
/**
  * @brief  The application entry point.
  * @retval int
  */
int main(void)
{

  /* MCU Configuration--------------------------------------------------------*/

  /* Reset of all peripherals, Initializes the Flash interface and the Systick. */
  HAL_Init();

  /* Configure the system clock */
  SystemClock_Config();

  /* Initialize all configured peripherals */
  MX_GPIO_Init();
  MX_CAN_Init();
  MX_USART2_UART_Init();
  /* USER CODE BEGIN 2 */


  RFT_Init(&hcan);
  HAL_Delay(2000);

#if COMM_ID_CONFIG_MODE
  CommID_RunRecovery(&huart2);
  while (1);
#endif

  RFT_StartStream();
  HAL_Delay(200);     /* 스트리밍 안정화 대기 */
  RFT_SetBias(1);     /* 자동 영점 설정 */

  /* USER CODE END 2 */

  /* Infinite loop */
  /* USER CODE BEGIN WHILE */
  while (1)
  {
    /* USER CODE END WHILE */

    /* USER CODE BEGIN 3 */

    /* Bus-Off 자동 복구 */
    if (hcan.Instance->ESR & CAN_ESR_BOFF) {
        HAL_CAN_Stop(&hcan);
        HAL_Delay(10);
        HAL_CAN_Start(&hcan);
        RFT_StartStream();
    }

    ft = RFT_GetData();
    if (ft.updated) {
        /* %f 대신 정수 변환 사용 (newlib-nano %f 미지원 대비) */
        char buf[96];
        int pos = 0;
        const float vals[6]  = {ft.Fx, ft.Fy, ft.Fz, ft.Tx, ft.Ty, ft.Tz};
        const int   decs[6]  = {3, 3, 3, 5, 5, 5};
        const uint32_t muls[6] = {1000, 1000, 1000, 100000, 100000, 100000};
        for (int i = 0; i < 6; i++) {
            float v = vals[i];
            int neg = (v < 0.0f);
            if (neg) v = -v;
            uint32_t iv = (uint32_t)(v * (float)muls[i] + 0.5f);
            pos += snprintf(buf + pos, sizeof(buf) - (uint32_t)pos,
                            "%s%lu.%0*lu%c",
                            neg ? "-" : "",
                            (unsigned long)(iv / muls[i]),
                            decs[i],
                            (unsigned long)(iv % muls[i]),
                            (i < 5) ? ',' : '\r');
        }
        buf[pos++] = '\n';
        HAL_UART_Transmit(&huart2, (uint8_t *)buf, (uint16_t)pos, 20);
    }
  }
  /* USER CODE END 3 */
}

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
