HeejunMoon53/MultimodalSensor/(commit log)

2026-04-27 test: verify Notion sync after BOM fix
2026-04-27 설정: 커밋 메시지 한글 작성으로 변경
2026-04-27 문서: CLAUDE.md 프로젝트 개요 전면 업데이트 (연구 배경, 목표, 진행 상황, 결과 추가)
2026-04-27 정리: 테스트용 파일 삭제 (generate_report.py, PDF, PPT)
2026-04-28 동기화 데이터 취득 UI 추가 및 CLAUDE.md 프로젝트 개요 업데이트
    - SyncAcquisition_UI.py 신규 추가: STM32(UART) + Arduino(인장 머신) 동기화 취득
    - 수동 조그, 시퀀스 프로그램, 비상정지, 설정 등 기존 UI 기능 전체 포함
    - STM32 5채널 실시간 그래프 (LDC, R_DC, TENG, R_raw, TENG_raw)
    - RECORD 버튼으로 Excel/CSV 동기화 저장
    - PC 타임스탬프 기반 동기화 (STM32 1kHz + Arduino 위치 100ms 폴링)
    - CLAUDE.md 프로젝트 개요 전면 업데이트 (연구 배경, 핵심 아이디어, 진행 단계 등)
2026-04-28 시퀀스 프로그램 모드 개편: 개별 속도 + 동기 이동 신규 추가
    - 개별 속도 모드: 축마다 거리와 속도를 독립적으로 설정
    - 동기 이동 모드(신규): 총 시간(s) 또는 최대 속도(mm/s) 기준으로
    나머지 축 속도 자동 비례 계산 → 모든 축 동시 완료
    - 시퀀스 데이터 구조 통일: cmds = [(ax, dist, spd), ...]
    - 더블클릭 편집 복원 로직 hint 기반으로 개선
2026-04-29 CLAUDE.md에 PCB 설계 섹션 추가
    Multisignal Switching Board의 기본 사양, 레이어 스택, 드릴 구성, 주요 부품 목록 및 회로 구성 요약을 정리하여 문서화.
2026-04-30 CLAUDE.md 전면 개편: 연구 내용 재구조화
    - 물리 모델 섹션 추가: R_DC(ε), L(ε,d), R_s(ε,d) 이론식 및 경험적 피팅 모델
    - 2D-Strain 측정 원리 추가: 직사각형 스파이럴 eigen-direction 비대칭성
    - PINN 디커플링 모델 상세화: 2단계 구조(ΔR→ε̂, ΔL+ε̂→d̂) 및 Loss 함수
    - 데이터셋 섹션 추가: 실험 조건, 파일 위치, 출력 포맷
    - 미래 방향 6가지 정리: 다중 주파수 임피던스 측정 검토, 무선전력, 2D/3D 변형, 크롤링 로봇 등
2026-04-30 CLAUDE.md: 현재 논의 중인 결정 사항 로드맵 추가 (5단계)
2026-04-30 ROADMAP.md 추가: 연구 단계별 할 일 및 공부 목록 정리
2026-04-30 프로젝트 폴더 구조 정리
    - Analysis/: fringing_3d.py, 출력 PNG 이동 (ClaudeProject 루트에서)
    - Docs/: 세미나 PDF 이동
    - PCB/: Gerber ZIP + gerber_extracted 이동
    - 0332_DecouplingTest_TXTFiles/: graphcode2 확장자 추가(.py), 전체 데이터 추적 시작
    - CLAUDE.md: 파일 경로 업데이트
    [Drill_NPTH_Through.DRL, Drill_PTH_Through.DRL, Drill_PTH_Through_Via.DRL, Gerber_BoardOutlineLayer.GKO, Gerber_BottomLayer.GBL, Gerber_BottomSilkscreenLayer.GBO, Gerber_BottomSolderMaskLayer.GBS, Gerber_TopLayer.GTL]
2026-05-04 SyncAcquisition_UI.py 버그 수정 7종
    1. _parse_pos: 리밋 스위치 인덱스 off-by-one 수정 (vals[6+i] → vals[5+i])
    2. done_received 시그널: _run_sequence마다 중복 연결 방지 → _connect_signals()로 이동
    3. _done_flag: threading.Event으로 교체 (스레드 안전성 확보)
    4. _on_limits: 정상 폴링 중 리밋 감지 시 비상정지 오발 제거 (_on_alarm만 처리)
    5. _run_sequence: 모터 비활성화 상태 확인 및 경고 QMessageBox 추가
    6. 스레드 종료: quit() 후 wait(1000) 추가 (STM32/Arduino 양쪽)
    7. _stop_sequence: _done_event.set()으로 대기 스레드 즉시 해제
    - 세미나 PDF 루트 위치 삭제 (Docs/로 이미 이동됨)
    Co-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
2026-05-04 펌웨어: TDM 출력 주기 정밀화 (100Hz 고정)
    - TDM_PRINT_EVERY_N = 10 추가 (TDM.h): N × 1ms = 출력 주기 설정값
    - tdm_print_cnt 카운터를 ISR 내부에서 증가 → 정확히 10ms(100Hz)마다 update_flag 세팅
    - main.c의 HAL_Delay(10) 제거: 루프 딜레이 없이 즉시 폴링
    - 기존: ~77Hz + 지터 / 변경 후: 정확히 100Hz (ISR 타이밍 기준, μs급 정밀도)
    - 출력 주파수 변경 시 TDM_PRINT_EVERY_N만 수정 (5→200Hz, 2→500Hz)
    [TDM.c, TDM.h, main.c]
2026-05-04 펌웨어: Switching_testing_26.01.01 → TDMFirmware 로 폴더 통합 및 버전 관리 체계 전환
    - 날짜 기반 폴더 복사 방식 폐기, Git 태그(v1.0.0~) 기반 버전 관리로 전환
    - .project / .ioc 내 프로젝트명을 TDMFirmware 로 변경
2026-05-04 문서: CLAUDE.md 펌웨어 폴더명 및 버전 관리 방식 업데이트
2026-05-04 VS Code: STM32 디버그 환경 설정 추가 (Cortex-Debug + OpenOCD)
    - launch.json: TDMFirmware.elf OpenOCD 디버그 구성 (빌드 포함 / 미포함 2가지)
    - tasks.json: STM32CubeIDE 헤드리스 빌드 / 클린 태스크
    - c_cpp_properties.json: arm-none-eabi-gcc 기반 IntelliSense 설정
    - CubeIDE 내장 툴체인 경로 사용 (별도 설치 불필요)
2026-05-21 그래프 색상 컨벤션 추가 및 타임시리즈 플롯 스크립트 작성
    - CLAUDE.md: L=주황(#FF8C00), R=초록(#2CA02C), V-TENG=파랑(#1F77B4) 색상 규칙 추가
    - nn_decoupling/data_acquisition/plot_timeseries.py: collect_*.csv → 4패널 PNG 생성 (인장 변형률[%], 근접거리[mm], ΔL/L₀, ΔR/R₀)
    [collect_20260519_140039.csv, collect_20260519_143611.csv, hand_p1_strain000mm_r01.csv, hand_p1_strain002mm_r01.csv, hand_p1_strain004mm_r01.csv, hand_p1_strain006mm_r01.csv, hand_p1_strain008mm_r01.csv, hand_p1_strain010mm_r01.csv]
2026-06-10 보고서: master_report.html Section 8에 학습 상세 및 공정 E2E 비교 추가
    - Loss curve (epoch 단위 설명: batch=200, 118 updates/epoch) S1/S2 별도 플롯
    - Test 정량 지표: ε MAE=0.343%, R²=0.9974 / d MAE=1.783mm, R²=0.9298
    - Pred vs True scatter (초록=변형률, 주황=근접도)
    - E2E 공정 비교: E2E-large(180-180-90, ~50K) 추가 → 동일 예산에서 Two-stage(1.783mm) < E2E-large(1.827mm) 입증
    - 기존 E2E(2→2) 행에 "불공정" 태그 및 결론 문구 수정
    [generate_s8_content.py]
2026-06-10 보고서: Section 8 그래프 흰색 배경 + E2E 연산량/추론속도 비교 추가
    - 모든 플롯 배경 흰색으로 전환 (plt.rcParamsDefault 기반)
    - MACs 계산 추가: Two-stage 49,664 / E2E-small 24,960 / E2E-large 49,140
    - PC Python 추론 속도 벤치마크 (5000회 평균, 단일 샘플)
    - STM32 INT8 추론 시간 추정 (실측 1068µs 기준 MACs 비례)
    - 비교표에 MACs·PC속도·STM32추정 컬럼 추가
2026-06-11 보고서: 6c 아키텍처 탐색 Pareto 플롯 개선 + edge_ai -> master 병합
    - Section 6c: x=INT8 Flash(KB, log), y 이중축(MAE d 주황/MAE eps 초록)
    Pareto 최적점 별(★) 표시, sklearn 배포 모델 위치 함께 표시
    - edge_ai_report Section 6c 교체 (새 플롯 반영)
    - master_report Section 6에 6c 아키텍처 탐색 결과 통합
    - master_report Section 9에 edge_ai의 지연/메모리/전력/MACs/종합비교 병합
    - TOC에 6c 서브링크 추가
2026-06-22 FTSensorCAN: CommID 프로토콜 파싱 버그 수정 (데이터시트 3.6.5/3.6.6 준거)
    - ISR CommID 파싱: 2바이트 빅엔디안 → 1바이트 단일값으로 수정
    (rxdata[1]=currRX, rxdata[2]=currTX1, rxdata[3]=currTX2)
    - RFT_ResetCommID(): Set CommID 바이트 포맷 수정
    이전: [0x04, 0x00,0x01, 0x00,0x02, 0x00,0x64, 0x01] (2바이트/ID, RX=0x00 범위 초과)
    수정: [0x04, 0x64, 0x01, 0x02, 0x00,0x00,0x00,0x00] (D2=RX, D3=TX1, D4=TX2, 1바이트)
    - main.c 출력 포맷: %03X → %02X (1바이트 ID에 맞게) + 레이블 명확화
    [FTSensorCAN.ioc, main.c, rft_sensor.c, rft_sensor.h]
2026-06-22 FTSensorCAN: 디버그 출력 제거 + CommID 복구 모드 분리
    - main.c: 디버그 블록(DBG/isr카운터/LEC/TEC/REC) 전부 제거, 센서 CSV 출력만 유지
    Bus-Off 자동 복구 로직은 유지 (출력 없음)
    - CommID 복구 로직 → commid_tool.h / commid_tool.c 로 분리
    main.c 에서는 #if COMM_ID_CONFIG_MODE 한 줄 호출만 남음
    - rft_sensor.c: LOOPBACK_TEST / FILTER_ALL 분기 제거, RFT_Init 단순화
    debug 카운터(g_rft_frame1/2, g_rft_parse_cnt) 제거 (g_rft_isr_cnt 유지)
2026-06-22 FTSensorCAN: float 출력 수정 + 100Hz 설정 + Bias/Rate 명령어 수정
    - main.c: %f 제거 → 정수 변환 방식으로 교체 (newlib-nano %f 미지원 완전 우회)
    buf 96B, UART 타임아웃 20ms, RFT_SetOutputRate(RFT_RATE_100HZ) 호출
    - rft_sensor.c/h: RFT_SetOutputRate() 추가 (cmd 0x0F, 내부 Stop→Set→Start)
    - Bias 명령어 버그 수정: 0x12는 Overload Count Read — Bias OFF가 아님
    Set Bias는 0x11 단일 커맨드, param 0x01=set / 0x00=clear (Manual §3.6.17)
    - Rate 상수 추가: RFT_RATE_10/20/50/100/200/333/500/1000HZ
    [main.c, rft_sensor.c, rft_sensor.h]
2026-06-22 FTSensorCAN: 진단용 전역 변수 추가 (Live expression 디버깅)
    - g_rft_rx_cnt: FIFO에서 꺼낸 프레임 수 (0이면 CAN 수신 자체 안 됨)
    - g_rft_last_id: 마지막 수신 CAN ID (0x001/0x002인지 확인)
    - g_rft_parse_cnt: parse_frame() 호출 횟수 (파싱 성공 여부)
2026-06-22 FTSensorCAN: UART RX 기반 캘리브레이션(영점) 명령 추가
    - 'c' 수신 → Set Bias(영점 설정), '#CAL_SET' 출력
    - 'r' 수신 → Clear Bias(영점 해제), '#CAL_CLR' 출력
    - USART2 NVIC 활성화 + HAL_UART_Receive_IT로 비차단 수신
    - stm32f1xx_it.c에 USART2_IRQHandler 추가
2026-06-22 FTSensorCAN: 영점 설정을 init 과정에서 자동 수행으로 변경
    스트리밍 시작 후 200ms 안정화 대기 후 RFT_SetBias(1) 자동 실행.
    UART RX 기반 수동 캘리브레이션 명령 제거.
2026-09-05 MoE 디커플링 파이프라인 및 STM32 실기 검증 결과 반영
    - TDMFirmware: X-CUBE-AI 런타임 + moe_inference/nn_inference 통합 (온보드 추론)
    - nn_decoupling: 아키텍처 탐색, PINN 학습, MoE 후보 6종 비교, ONNX/stedgeai 배포 스크립트
    - 데이터셋 재배치: 0332 원본을 nn_decoupling/ 하위로 이동, P1/P2·압력·실시간 세션 추가
    - .gitignore: 대용량 촬영 영상(*.MOV 등) 제외
    [mms_20260805_172956.csv, mms_20260806_200653.csv, moe_monitor_20260816_183046.csv, moe_monitor_20260817_002534.csv, moe_monitor_20260817_011424.csv, moe_monitor_20260818_162945.csv, moe_monitor_20260818_162945_syncfixed.csv, moe_monitor_20260818_185527.csv]
2026-09-05 논문 원고 추가: 국문·영문 2종 + 실측 데이터 기반 그림 생성 스크립트
    - Paper/make_figures.py: 저장소 원본 데이터에서 논문용 그림 7점 생성
    - Paper/content.py, supplementary.py, build_paper.py: 국문/영문 본문 동시 정의 후 docx 생성
    - 본문 10장 + Supplementary S1~S7, 표 8개
    - TDM 아키텍처, (ε,d) 응답 곡면, 점탄성 SLS 분석, MoE 구조, 실기 실시간 검증 결과 수록
2026-09-05 논문 Introduction 재구성 및 발표자료(국문·영문) 추가
    - Introduction 개편: 각 모달리티(근접·접촉력·인장)의 필요성을 선행 연구 근거와 함께 서술,
    소프트 단일 전극·임베디드 AI의 당위성 절 신설, 기존 연구 한계 표(표 1) 추가,
    디커플링 전략 분류 절 삭제
    - 참고문헌 30편으로 확장 (모달리티별 근거 문헌 10편 추가), 인용 무결성 검증 완료
    - 26.03.27 세미나·26.08.20 그룹미팅 자료 반영:
    브리징 공정, 돌기 구조(210N→20N), Q-factor 겉보기 효과, A/B/C/D 절제 실험,
    학습/PC/임베디드 3원 비교, LDC1614·ADG734 상세 사양
    - 오류 수정: R_DC = R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
    [build_slides.py, content.py, fig_sensor.py, intro.py, refs.py, supplementary.py]
2026-09-09 논문/PPT 구조 개편, TENG·한계점 인용 보강, 0909 재취득 데이터로 MoE 재학습 및 STM32 반영
    - 논문 Introduction에 어레이/적층/단일 디커플링 3대 한계 및 근접 pre-shaping 인용 추가 ([33]-[37])
    - 발표자료를 26.09.18 세미나 아웃라인 구조·스타일로 전면 재구성 (7장 체계, 장 구분 슬라이드, 로고)
    - 0909 저녁 재취득 데이터(근접/압력) 시각화 스크립트 및 그래프 추가
    - retrain_moe_v4로 Gate+Expert A/B MoE 재학습(오프라인 R² 0.98~0.99) 후 STM32 배포 코드 생성
    - TDMFirmware에 새 모델(gate/expert_a/expert_b, moe_params.h) 반영, 기존 버전은 백업 보관
2026-10-23 소프트 그리퍼 제어 시뮬레이션 설계 스펙 추가
