HeejunMoon53/MultimodalSensor/(notices)

Notices in the files:
FTSensorCAN/Core/Src/main.c:
Copyright (c) 2026 STMicroelectronics.
All rights reserved.
This software is licensed under terms that can be found in the LICENSE file
TDMFirmware/Core/Src/usart.c:
Copyright (c) 2025 STMicroelectronics.
